doggylover314/monsoonready-drone/runs/detect/runs/spotcheck/water.v2i.yolov8_image117_jpg.rf.64779a35312663e71e96f10df5c92397.jpg

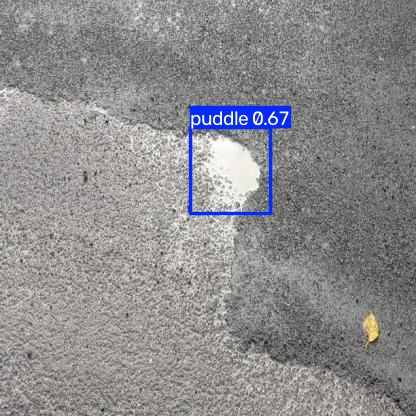
runs/detect/runs/spotcheck/water.v2i.yolov8_image117_jpg.rf.64779a35312663e71e96f10df5c92397.jpg
