doggylover314/monsoonready-drone/runs/detect/runs/spotcheck/puddle detection.v32-640pure.yolov8_image1419_jpeg.rf.d2c9cac2d5b5cb9a628b9e14989213a8.jpg

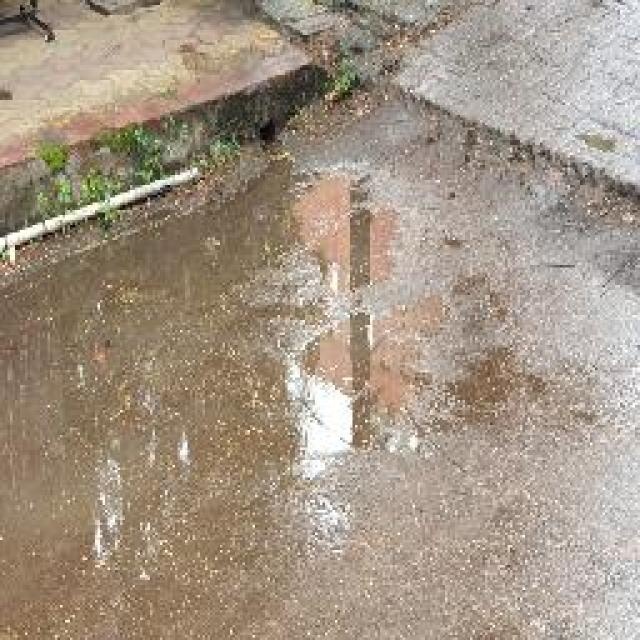
runs/detect/runs/spotcheck/puddle detection.v32-640pure.yolov8_image1419_jpeg.rf.d2c9cac2d5b5cb9a628b9e14989213a8.jpg
