doggylover314/monsoonready-drone/PROJECT_STATE.md

# DEADLINE CORRECTED 2026-08-14 (user): SATURDAY 2026-08-15 IS THE SHOOT DAY, NOT THE UPLOAD DAY. It is the ONLY day with farm access, so all footage must exist by Saturday night; the actual submission upload is ~ONE WEEK LATER (exact date UNVERIFIED - ask user; do not invent). Video constraints unchanged: 5-10 min ONE continuous unedited take, opens with a Google date search on screen, publicly viewable. GOAL for the shoot (user, 2026-08-11) IS THE FULL AUTONOMOUS FLIGHT: survey -> detect -> drop. ATTEMPTS: 2-3 across the day, ONE pack only (user, 2026-08-14), each failure costs a recharge at the farm's marketing-office mains. FALLBACK: piloted flight + ground AI demo, stated honestly on camera. VIDEO_SCRIPT.md (2026-08-14) holds the full shooting script with lines for both variants.

## CONCEPT + FRAMING
Hexacopter surveys; UNO Q onboard ML detects standing water in downward stills; descend over (or beside, see TF-Luna risk) puddle; drop granular Bti (demo=inert salt); on landing UNO Q=base station (heatmap/report). Judged loop detect->descend->treat runs onboard.
Framing: model detects "standing-water candidates", stagnation confirmed by persistence across passes/operator; document honestly. AI-authorship: disclose "AI-assisted; architecture/testing/debug mine"; keep dataset+bench evidence; be able to explain every design decision in Q&A.
REGULATORY: Digital Sky parked (portal blocks self-reg); >2kg AUW=Small category; compliance gap acknowledged deliberately; salt avoids pesticide law; narrative to write (user).

## AIRCRAFT (fixed facts)
F550 hexa X (FRAME_CLASS 2 TYPE 1; SENSOR_ANGLE_OFFSET_DEG 0, corrected 2026-08-06: ring sits BETWEEN the arms, sensor 0 out the nose, NOT arm-mounted). S550 predecessor was 1.85kg, hovered 30% throttle (user: settled, do not re-litigate); F550 lighter. Payload budget ~650g; AI payload ~230-340g.
Pixhawk 2.4.8 = Pixhawk1-bdshot 4.7.0 stable (flashed 2026-07-25). Motors 6x DJI A2212 920KV, DJI-style 1045 props, handed M6 nutcaps (black CW silver CCW). 6x 45A BLHeli_32 (RPM notch impossible on this board: AUX5-6 NODMA; motors stay MAIN PWM; ESCs = quality+passthrough only). 3S 8000mAh XT60. Charger HTRC B6 V2. NEO-M8N+compass mast. FS-i6X/FS-iA10B iBUS. 433MHz SiK. OLED SH1106 (NTF_DISPLAY_TYPE 2, compass I2C, 5V UBEC; splices need soldering; glanceable top-plate mount).
Switches: ch5 arm (RC5_OPTION 153), ch8 kill (RC8_OPTION 31), ch7 3pos Stab/AltHold/Loiter (FLTMODE_CH 7), spare 2pos=RTL (CHANNEL UNCONFIRMED: ask user, then uncomment RC6_OPTION,4 in setup file + push). Simple Mode per-mode checkbox (not restored post-reset; reconfigure if wanted).
Parts: ALL arrived. Frame assembly in progress.

## POWER MAP
RESOLVED 2026-08-02 (user checked the bench): TWO buck modules exist, identical fixed-5V units differing only in output port (one USB-C, one USB-A); NEITHER is adjustable, so every "XY-3606 set to 5.00V" instruction in this file is VOID (that adjustable module does not exist; the name lives on below only as why-history). Rail assignment now: USB-C module -> ETZIN splitter charging port -> UNO Q (this is the unit that metered 5.20V loaded, acceptance PASSED); USB-A module -> MG90 servo + ESP32 (tap via cut USB-A cable or solder pads). Two-rail rationale unchanged (servo stall must not brown out the companion). VERIFY before first connect: USB-A module's LOADED output voltage by meter, and its CURRENT RATING from listing/markings (servo stall + ESP32 + mux + 7x VL53L0X share it; rating currently UNKNOWN). PIXHAWK WIRE CHECKLIST given to user 2026-08-02 (per SERIAL MAP + standard Pixhawk-1-class ports, silkscreen-VERIFY flagged): POWER=power module; TELEM1=SiK; TELEM2=ESP32 (TX2->GPIO16, RX2<-GPIO17, GND; no 5V); GPS=puck; I2C=compass + OLED -> I2C SPLITTER NEEDED if both (new part, was not in any plan; VERIFY OLED bus compat); SERIAL4/5 split cable per SERIAL MAP (pins 4/5 provisional on TODO 7); RCIN=receiver; MAIN1-6=ESCs; AUX1=MG90 signal+GND w/ red from USB-A buck; BUZZER + SWITCH (VERIFY switch not integrated in puck); CAN/SPI/ADC/SB unused.
Power module (new) -> Pixhawk (calibrate V/I vs multimeter on install; UBEC bench V readings w/o sense pins = floating artifacts). UNO Q FLIGHT FEED SUPERSEDED 2026-07-29 (splitter gate pass, see AWAITING USER (b)): UBEC 5V -> ETZIN EPL-1207CC charging port -> UNO Q USB-C as sink (supported path, camera on splitter A-port); 5V-pin and VIN feeds BOTH DROPPED from flight design. Old plan kept below for the why-history only: UBEC 5V/5A -> UNO Q 5V pin (NOT VIN, verified 2026-07-27: VIN 7-24V exists BUT board disables USB VBUS out when VIN-powered (protective Schottky design, Arduino staff: unsupported scenario) = B525 on USB-C gets no power; 5V-pin feed keeps USB host power alive; also isolates from motor-bus sag/noise. GPIO 3.3V; USB-C free for camera) + OLED. XY-3606 (set 5.00V with meter BEFORE connecting) -> MG90 servo + ESP32 (ESP32 3V3 reg feeds mux + 7x VL53L0X). SERVO = MG90 metal-gear (user 2026-08-01, replaces SG90: metal gears + better repeatability on a gate that must not strip; VERIFY on arrival = exact variant (MG90S is the common metal-gear part, MG90D exists), MASS (metal-gear ~13g vs SG90 ~9g, both approximate, WEIGH it, payload budget ~650g) and STALL CURRENT vs the XY-3606 rating (metal-gear draws more than SG90; no verified datasheet figure, MEASURE on the bench flow test TODO 3)). SERVO SIGNAL = PIXHAWK AUX OUTPUT PIN (default ch9/AUX1, CHANNEL UNCONFIRMED), **NOT** UNO Q GPIO. RE-EXAMINED 2026-08-01 (user asked for the signal to come from the Arduino instead; ANSWER = the "valid reason" clause in his own instruction applies, four load-bearing reasons, all still true): (1) Linux userspace soft-PWM is jittery (not an RTOS) so the Linux side is out on its own; (2) that leaves the UNO Q STM32, but the stock Arduino Servo lib has NO Zephyr support (verified 2026-07-31) so it needs a board-specific PWM impl written from scratch; (3) reaching that impl needs the Linux->STM32 Bridge = TODO 12 = BLOCKED and not resolvable without bench time; (4) the Pixhawk already has hardware PWM idle on AUX, powered, wired, talking MAVLink to us, motors on MAIN1-6 so AUX free, and AUX5-6 NODMA blocks only bidir-DShot not plain PWM. Net: Arduino route = 2 unwritten firmwares + 1 open hw question, Pixhawk route = 0 new code, 14 days to deadline. ALSO signal level: **"Pixhawk servo rail is 5V logic" is RETRACTED as UNVERIFIED (2026-08-06, user asked directly whether MAIN/AUX signal pins are 3.3V or 5V and I could not confirm it; it was an assistant memory claim, exactly what truth rule 9 forbids as a wiring basis).** What is actually true: the PWM outputs originate at 3.3V MCU pins (MAIN from the IO co-processor, AUX from the FMU), and whether they reach the connector at 3.3V or 5V depends on whether this board buffers/level-shifts them and what supplies those buffers, which has NOT been checked against the schematic or a scope for THIS board. CONSEQUENCE WORTH TESTING EARLY: if the outputs are buffered from VDD_SERVO and this build never powers the Pixhawk's servo rail (servo power comes from the USB-A buck, by design), the AUX signal could be weak or absent entirely; the cheap empirical test is the existing `wiring_check.py --wiggle` with the servo connected and grounds common, watching whether the gate moves. If it does not move, escalate to a scope on the pin before adding a level shifter or powering the rail. NOTE ON THE DECISION THIS CLAIM SUPPORTED: even if AUX turns out to be 3.3V, the servo-source verdict does NOT flip, because the load-bearing reasons were the two missing firmwares (Zephyr PWM impl + the blocked Bridge), not the logic level. UNO Q GPIO is 3.3V and NO consulted datasheet states an MG90 input-high threshold (user's "3.3V should not be an issue" reasoning was about POWER, which was never the objection; the objection is LOGIC LEVEL + firmware). If ever revisited: VERIFY the threshold on a scope, do not assume. Servo POWER = XY-3606 always, on both routes (a stalled servo still cannot brown out the companion). Old UNO Q GPIO note (marginal 3.3V logic, salvage cap if it misbehaved) is DEAD, do not reinstate. Common grounds. XT60 ~60A continuous (full-punch bursts may touch it; known).
VERIFY-BEFORE-WIRING (2026-07-27 sweep under CLAUDE.md truth rules 8+9; each = memory-based claim, damage-if-wrong; check datasheet/meter BEFORE connecting): (1) UBEC output: many hobby UBECs are 5V/6V jumper-selectable; 6V into UNO Q 5V pin may kill the board. Confirm jumper position + meter the output UNDER LOAD before first connect. UPDATE 2026-07-27: user metered 5.3V (no trim pot; presumed UNLOADED = floating-artifact suspect). Spec VERIFIED same docs page: 5V-pin window 4.5-5.5V max-not-exceeded -> 5.3V in-spec for the BOARD but only 0.2V ripple headroom, and same 5V_SYS bus back-drives camera VBUS (USB nominal max 5.25V, camera margin flagged not cleared). RULING: re-meter AT THE 5V PIN under real load (UNO Q + camera); <=~5.2V loaded = wire as planned; if it holds 5.3V, optional margin fix = 2nd adjustable buck (XY-3606-class) set to 5.00V by meter replacing the fixed UBEC feed. WIRING RULE (2026-07-27): UNO Q 5V feed must NOT be a dupont jumper (~1A class, I2R drop at 3A peaks -> droop -> reset; docs warn droop=resets and docs' >=3A = peak budget incl camera VBUS, not continuous draw). UBEC has NO output leads (user 2026-07-27; earlier "keep its own lead gauge" advice was an assistant form-factor assumption, retracted): user supplies ~18-20 AWG stranded, short run, soldered both ends (NOT servo-lead offcuts, 22AWG or thinner), MULTIPLE GND returns (per docs), and bench-measure actual loaded current (continuous draw unverified, expected well under 3A). Acceptance test stays: loaded voltage AT the 5V pin. UBEC output = SCREW TERMINALS (user 2026-07-27). Header-end ruling: NO bare stranded wire into female headers (poor contact geometry, stray-strand shorts to adjacent pins, vibration walk-out on THE critical rail). Preferred = Uno-R3 screw-terminal shield (UNO Q is R3 form factor; Robu.in/Amazon.in std part; VERIFY listing breaks out 5V/GND) -> both ends screwed. Fallback = wire soldered/crimped to male pin strip (2-3 pins grip better), hot-glue + zip-tie strain relief, 2x GND pins. Underside header-tail soldering only if board actually exposes tails (LOOK first, not asserted). (2) XY-3606: 5.00V setting (already ruled) AND output polarity metered before servo/ESP32 connect. (3) OLED SH1106 module: confirm the specific module's VCC range accepts 5V and its I2C lines are compatible with the Pixhawk 3.3V bus (module-dependent; check markings/listing). (4) TF-Luna: pinout per batch (already ruled), confirm 5V supply + 3.3V UART logic from the Benewake manual of THIS unit; pin5 float=UART. (5) ESP32 dev board 3V3 regulator: confirm headroom for TCA9548A + 7x VL53L0X before trusting the ring (measure current or check reg rating). (6) Power module: meter its 5V-ish FC output before first Pixhawk connect. (7) UNO Q 5V-pin feed: VERIFIED 2026-07-27 (docs: cover 5V load with 3A margin, short leads; VIN rejected because VIN power disables USB VBUS out = dead camera).

## PLATE LAYOUT (PROPOSED 2026-07-27, not yet built; VERIFY items = measure on frame, do not trust memory specs)
BELOW bottom plate (needs downward view / drop path): B525 nadir (offset so drop stream never crosses lens FOV); TF-Luna beside it clear nadir; hopper+MG90 at CG (payload mass stays centered as salt empties), outlet clear of camera. VERIFY leg ground clearance vs tallest underslung item incl squashed-landing margin.
BOTTOM plate / between plates (protected bay, monsoon): ESCs soldered to PDB pads + zip-tied arms (settled); UNO Q central (wiring hub: USB camera via hub, D0/D1 split cable, UBEC 5V; servo signal NO LONGER from UNO Q, see POWER MAP); ESP32+TCA9548A; 6x VL53L0X ring at plate edge 60deg (VERIFY 25deg FOV clears legs/props powered-on; decides ring height); UBEC+XY-3606 away from baro/FC; RX+SiK antennas clear of carbon/power; power module inline at battery lead.
TOP plate: Pixhawk on foam at center/CG arrow fwd baro covered (settled); GPS+compass mast far end from power wiring/ESCs; OLED glanceable (settled); buzzer outward; 7th VL53L0X up-facing at a corner (or bay edge w/ sky view, VERIFY).
BATTERY = open CG decision, decide by TAPE MEASURE (heaviest item): (a) central cavity between plates if 8000mAh pack fits = best CG/protected (then UNO Q/ESP32 move outward), else (b) strapped centered on top plate, Pixhawk shifts slightly (stays foam, near center). Plate gap NOT known from memory; measure.

## SERIAL MAP (final; 4/5 SWAPPED at build 2026-07-27: user wired Luna to the #4 lines, params updated to match instead of re-soldering; upside = SERIAL5 boot noise now hits junk-tolerant pymavlink not the Luna)
REVISED 2026-08-02 (user wired TELEM1<->TELEM2 opposite to plan; params follow the wires, same rule as the 4/5 swap): SERIAL1(TELEM1)=ESP32 MAVLink2 115200. SERIAL2(TELEM2)=SiK 57600. SERIAL3=GPS. SERIAL4=TF-Luna serial rangefinder 115200. SERIAL5=UNO Q MAVLink2 115200 (pending TODO 7). pixhawk_full_setup.param updated 2026-08-02 (SERIAL1/2 swap + SERVO14_FUNCTION=0/MIN 800/MAX 2200 for the dropper on AUX6=ch14, user-assigned provisional, servo not yet arrived); esp32 config.h comments fixed to TELEM1 (pins unchanged GPIO16/17). NOTHING PUSHED YET: push_params.py when Pixhawk next on USB, then tools/wiring_check.py (NEW 2026-08-02: USB bench listen, PASS/FAIL per subsystem FC/GPS/compass/Luna/ESP32/RC + optional --wiggle 14 servo cycle; SiK/buzzer/switch/motors explicitly not USB-checkable, see its docstring). I2C: user spliced compass + OLED dupont leads manually, NO splitter part needed (his prior build note, reconfirmed 2026-08-02). PARAMS PUSHED + VERIFIED 2026-08-02 (user-run push_params.py): 60 ok / 0 refused / 0 no-echo, incl the SERIAL1/2 swap and SERVO14_FUNCTION/MIN/MAX. WIRING CHECK 2026-08-02 (user-run tools/wiring_check.py, Pixhawk USB + battery): FC PASS 25hb; GPS PASS 100 msgs (fix 1, 0 sats = indoors, wiring is what was proven); COMPASS PASS enabled+healthy (so the manual I2C splice CONDUCTS, SDA/SCL both good); TF-LUNA PASS 100 msgs reading 0.14m on the bench (consistent w/ RNGFND1_GNDCLR 0.13); ESP32 PASS 24-25 comp195 heartbeats + ~228 OBSTACLE_DISTANCE in REAL mode = ring sensors alive and transmitting; RC FAILED on run 1 then PASSED on run 2 (transmitter was off first time = the check working as intended, not a fault). NEW FINDING (open): upward DISTANCE_SENSOR count = 0 across both runs while the ring streams fine -> the 7th up-facing VL53L0X (mux ch6, orientation 24) is NOT transmitting; either not yet wired/mounted (assembly is mid-build) or its init failed while the ring's succeeded. Re-check after the ring is finished; if still 0 with the sensor physically present, debug ch6 on the mux (ESP32 serial monitor prints per-sensor init).
OLED DARK 2026-08-02, NARROWED (Pixhawk on USB + battery, ESP32 REAL mode): NTF_DISPLAY_TYPE read back from the board = 2.0 (confirmed present, cause 2 ELIMINATED) and COMPASS PASS on the same spliced bus (cause 5 ELIMINATED, the bus and splice work). Remaining, ranked: (1) OLED has no VCC/GND (splice was "compass wires + 2 dupont female wires" = SDA/SCL only; an SH1106 has no backlight so unpowered looks identical to misconfigured; METER its VCC pin); (2) NOT REBOOTED since the push (ArduPilot initialises the display driver at BOOT only, so a freshly-set NTF_DISPLAY_TYPE does nothing until a power cycle) - free to rule out, do it first; (3) controller mismatch SH1106(2) vs SSD1306(1), externally identical modules -> try 1, reboot, look; (4) module address 0x3C vs 0x3D (whether ArduPilot probes both is UNVERIFIED, do not assert; some modules have a solder-jumper to change it); (5) dead module. DEFINITIVE TEST if 1-4 fail: I2C scanner sketch on a spare MCU to see whether the module answers at all and at which address. UPDATE same day, causes 1-3 ALSO ELIMINATED: user metered the module VCC at 5.25V (powered), rebooted (driver init happens at boot, so that path is exercised), and tried NTF_DISPLAY_TYPE=1 with another reboot (both controller types now ruled out). User states the screen WORKED EARLIER with this exact hardware, so this is a REGRESSION, and the question becomes what changed since. Candidates, none verified: (a) FIRMWARE 4.6.3 -> 4.7.0 upgrade on 2026-07-25 plus the factory reset - if the 4.7 build for this board is feature-trimmed (1MB-class boards get --enable-minimize-features) the display driver may simply not be compiled in while NTF_DISPLAY_TYPE remains settable; I CANNOT VERIFY from memory whether 4.7's Pixhawk1 build includes it, check the boot banner/ArduPilot source before believing it; (b) the module's GND leg: a metered 5.25V on VCC proves supply presence, NOT a return path, and a broken GND on the OLED stub leaves the compass (its own GND intact) working - continuity-test OLED GND to Pixhawk GND; (c) the OLED stub's SDA/SCL solder joints specifically (compass PASS only proves the bus reaches the COMPASS, both hang off the same splice); (d) module died. **SOLVED 2026-08-02: cause (b), a LOOSE GND WIRE on the OLED stub.** User replaced the wire and set NTF_DISPLAY_TYPE back to 2 (SH1106 confirmed correct, so the temporary 1 was a red herring): screen works perfectly. Firmware feature-trim theory (a) was WRONG and is now dead, do not repeat it. LESSON worth keeping: a metered VCC proves supply only; on a shared-splice bus a device-specific GND break is invisible to every software check and to the other devices on the same bus (the compass stayed healthy throughout). Continuity-test BOTH legs per device next time a spliced I2C device is silent. NOTE: the board's NTF_DISPLAY_TYPE is back to 2 and matches pixhawk_full_setup.param, no re-push needed.
BATTERY MONITOR CALIBRATION GUIDANCE (2026-08-02, asked by user; NOTHING MEASURED YET): BATT_VOLT_MULT is trivial (meter the pack at rest, type the reading into QGC's Power setup, it computes the multiplier). BATT_AMP_PERVLT needs a KNOWN current, and the load choice is the whole question. Rules recorded: (a) METER TYPE - a handheld multimeter's 10A range is FUSED and flight currents are 20-60A, so inline is out; the safe instrument is a DC-capable CLAMP meter (Hall effect) around the battery positive lead. An AC-only clamp reads nothing on DC. (b) LOAD - do NOT use props for this; options are a resistive dummy load (car headlight bulbs, ~4.5A each at 12V 55W, parallel to reach a flight-like 15-20A) or motors WITHOUT props (only a few amps, and a calibration taken at 2A extrapolates badly to 20A, offset error dominates). Calibrate near HOVER current, not at idle. (c) Two points (low + high) beat one, because they separate slope from BATT_AMP_OFFSET. (d) GOLD STANDARD CROSS-CHECK, needs no ammeter at all: fly/hover a pack down, compare ArduPilot's logged consumed mAh against what the charger puts back in, scale BATT_AMP_PERVLT by that ratio. (e) F550 hover current is UNMEASURED in this project, so "15-20A" above is an expectation, not a fact. TODO for the user: RECORD THE POWER MODULE'S MODEL/RATING (nowhere in this file); its datasheet A/V figure is the correct starting value before any of the above refines it. (f) USER ASKED FOR "2 PINS" TO CLIP AN AMMETER TO: NO SUCH PIN PAIR EXISTS and none can be added - an ammeter must CARRY the current, i.e. sit in series in the main pack lead. The Pixhawk's 6-pin power connector carries only the FC's own ~0.5A, so measuring there answers a different question. Valid options: DC CLAMP around the pack positive (no disconnection, no extra parts, the only route that fits "use what I have"), or a two-lead meter inserted in pack positive between battery and power module - which with XT60s needs a temporary pigtail because unmating the connector breaks BOTH conductors. Hard safety notes: never put a meter in current mode across the pack (zero-ohm short on a LiPo), and check the meter's fuse rating first (a hexa passes tens of amps at modest throttle; F550 hover current still UNMEASURED here).
BENCH ACCEPTANCE TEST PLAN (2026-08-02, user-run; tools/wiring_check.py extended for it): the script now reports UP-SENSOR as its own PASS/FAIL line (was folded into the ESP32 line), --wiggle takes a bare flag defaulting to ch9, and NEW --motor-test spins each of the 6 motors in ArduPilot test order at 8% for 2s with a typed "spin" confirmation (PROPS OFF; proves ESC signal wiring + motor order + direction, all three verified BY EYE, software only commands the spin; motor 1 = front-right then clockwise, wrong order = swapped signal lead, wrong direction = swap two PHASE wires never the signal leads). Coverage note kept honest in the docstring: SiK, buzzer, safety switch, OLED and the UNO Q link are NOT provable over USB and each has its own separate check.
TWO REAL BUGS IN wiring_check.py FOUND + FIXED 2026-08-02 (both caused the "no ack" storm the user hit; source-verified in the venv's pymavlink, not guessed): (A) TARGETING. mavutil.wait_heartbeat() returns the FIRST heartbeat of any kind, and this bus has two senders (FC sys1 comp1, ESP32 sys1 comp195). pymavlink only locks its sysid onto a heartbeat that passes probably_vehicle_heartbeat(), which REJECTS the ESP32 twice over (MAV_TYPE_ONBOARD_CONTROLLER is in its excluded-type list AND MAV_AUTOPILOT_INVALID is in its excluded-autopilot list, mavutil.py:359-370). So when the ESP32's heartbeat arrived first, wait_heartbeat returned it while target_system stayed 0 = BROADCAST (target_component defaults to 0 too, mavutil.py:182/223) -> commands went to nobody in particular and acks did not come back. THE BANNER PRINTED THE EVIDENCE ALL ALONG: runs saying "heartbeat from system 0" are the broken ones, "system 1" the good ones. Fix = wait_autopilot(), which keeps reading until autopilot!=INVALID and component==AUTOPILOT1, then pins target explicitly (the filter mavlink_io.py already had). (B) ACK MATCHING: acks were matched by type only, with no drain of the 4Hz stream backlog, so an ack could be missed behind stale telemetry or confused with the ack of this script's own stream requests. Fix = send_and_ack() drains first, matches on ack.command, 5s timeout.
MOTOR TEST NEEDS LIVE RC (empirical, 2026-08-02): identical commands at the same 8% throttle did NOTHING with the transmitter off and SPUN THE MOTORS with it on, reproduced across three runs. The user's hypothesis that 8% was too low is DISPROVEN BY HIS OWN DATA (the run that spun used the same 8%). The exact firmware gate has not been read in ArduPilot source, so this is recorded as observed behaviour, not as a quoted rule. wiring_check.py now refuses to run the motor test without live RC, so a TX-off run can never masquerade as dead ESCs.
RUNNING THE TOOLS OVER THE SiK RADIO (user asked 2026-08-06; aircraft on battery, ground radio on the PC): SUPPORTED, use --conn /dev/ttyUSB0 --baud 57600 (that is the radio's PC-side rate and has NOTHING to do with the aircraft's SERIAL2_BAUD; ls /dev/ttyUSB* to confirm the device). Changes made for it: push_params.py gained an optional 2nd positional arg for baud (was hard-coded 115200, so it could never have worked over the radio); wiring_check.py halves its stream request to 2Hz on any link <=57600 (4Hz of MAV_DATA_STREAM_ALL does not fit through a SiK air link and the dropped msgs would print as spurious FAILs), and now counts RADIO_STATUS/RADIO for rssi figures. SiK DETECTION BUG FIXED SAME DAY (user: "why does SiK say untested? This was over the radio"): keying the verdict on RADIO_STATUS was WRONG, because a SiK only injects those when its MAVLink framing mode is on, so absence proves nothing. Now the verdict keys on the LINK: autopilot telemetry cannot arrive on a non-ttyACM serial port unless it crossed the radio (the Pixhawk's own USB is a ttyACM; the ESP32's USB port carries no autopilot traffic), so a non-ACM --conn that produced heartbeats IS the proof, with rssi added only when RADIO_STATUS happens to be present. Radio link CONFIRMED WORKING 2026-08-06 by that run. Bandwidth note from the same run: the ESP32's 1Hz heartbeat came through only once in 12s while the FC's came 12/12, so the air link is dropping the low-rate traffic under the ring's 10Hz load; not a fault, but a reason to keep the stream request low over radio. So the radio route is the ONLY way to test the SiK link, and USB remains the right route for param pushes (many small round trips, retries cost air time). SPEED (user 2026-08-06, the 25s wait was too slow): --seconds is now a MAXIMUM (default 12) and the listen loop BREAKS as soon as every check is satisfied, so a healthy aircraft finishes in ~2-3s and the full window is only ever spent waiting for something that never arrives. Satisfaction requires >=2 heartbeats from BOTH the FC and the ESP32 (one proves the sender exists, two prove it is still sending) plus GPS msgs, downward+upward rangefinder, ring, SYS_STATUS and live RC. Deliberately does NOT wait for a GPS FIX, which indoors never comes. Consequence today: with UP-SENSOR still silent, runs will use the whole 12s until ch6 is fixed.
UP-SENSOR (ch6) STATUS = UNTESTED SINCE IT WAS CONNECTED (corrected 2026-08-06 after the user challenged me, twice, correctly). What is actually known: every wiring_check run that reported 0 upward DISTANCE_SENSOR msgs was on 2026-08-02, and the user connected the 7th sensor "sometime between the last few tests", so those zeros may simply predate the sensor existing. NO run has been done since. TWO ASSISTANT ERRORS IN A ROW HERE, both from filling a gap instead of asking: (1) claimed the sensor must have been hot-plugged after boot, wrong because the aircraft is unplugged many times a day across a multi-day build; (2) then claimed ch6 "has failed init on every cold boot", which no measurement supports at all. The theory that begin() only probes at boot is still TRUE as code (source-read below) but it explains nothing until there is a fresh measurement. Code facts, source-read not guessed (proximity_sensors.cpp): begin() probes each mux channel ONCE at boot, prints "[sensors] chN: VL53L0X OK" or "chN: VL53L0X init FAILED (check wiring/mux)" per channel, sets _ok[ch]=false on failure, and readAll() then returns SENSOR_MM_ERROR for that channel forever; there is NO retry path. config.h UP_SENSOR_CHANNEL=6, NUM_SENSORS=7. Since ArduPilot demonstrably forwards the ESP32's broadcast OBSTACLE_DISTANCE through to USB/radio, a working ch6 would show up the same way, so 0 upward msgs = no data at the source. FRESH RUN DONE 2026-08-06 over the SiK radio, WITH the sensor connected: UP-SENSOR still 0 (everything else PASS). So the fault is now MEASURED, not inferred. User asked whether "nothing above it" explains 0: NO, and this is source-verified, not reasoned: sendDistanceSensorUp() only returns without transmitting when classifyCm() gives SECTOR_NO_DATA, which happens for exactly two inputs, SENSOR_MM_ERROR (0xFFFF = init failed or read timeout) and a literal 0 mm (VL53L0X signal-fail). An empty ceiling gives mm >= VL53L0X_MAX_VALID_MM -> SECTOR_NO_OBSTACLE -> the message IS sent as max+1 cm. Therefore 0 messages = the READ is failing at the sensor, and the ESP32 boot print ("[sensors] ch6: VL53L0X OK" vs "init FAILED") splits init-failure from persistent-0mm.
ROOT CAUSE MEASURED 2026-08-06 (ESP32 boot log, user-run): **TWO channels fail, not one** -- "[sensors] ch1: VL53L0X init FAILED" and "ch6: VL53L0X init FAILED", each preceded by `Wire.cpp requestFrom(): i2cRead returned Error 263`. 263 = 0x107 = ESP_ERR_TIMEOUT in arduino-esp32, i.e. nothing answered on that mux channel. Every live cycle then prints `s1[90]:ERR` and `UP:ERR` while ch0/2/3/4/5 report sane distances, so the ring has been flying on FIVE sensors with a hole at 90deg (starboard). ASSISTANT BLIND SPOT THIS EXPOSED, now fixed: wiring_check.py called ESP32 PASS purely because OBSTACLE_DISTANCE was arriving, but a dead ring sensor still occupies its slot filled with SECTOR_NO_DATA (65535), so the message streams happily with a hole in it. The check now scores each of the 6 sectors and prints a separate RING line naming any dead sector by bearing; had it done so on 2026-08-02 the dead ch1 would have been caught then. NEXT (user, bench): the two failures are independent channels sharing only the mux, so the top suspect is a loose leg per sensor (exactly the OLED's fault mode), then a dead sensor, then damaged mux pairs, then the POWER MAP's open VERIFY (5) 3V3 headroom for mux + 7 sensors (least likely, since five work). CLEANEST ISOLATION = swap test: move the ch6 sensor's 4-wire bundle onto a known-good channel's pads (e.g. ch2 with its sensor unplugged) and reboot; init OK there = sensor+wires fine, mux channel at fault; still FAILED = that sensor or its wires. Repeat for ch1.
ch6 CAUSE FOUND 2026-08-06 (user): the upward sensor's VIN was never connected to 3V3 (friend's wiring). Same fault family as the OLED's loose GND: a missing power leg, invisible to every software check, on a device whose neighbours all work. THIRD one this week, so the standing bench rule is now: when one device on a shared bus is silent, meter ITS OWN VIN and GND to the source before anything else. ch1 STATUS AFTER THAT FIX = UNKNOWN, not fixed and not broken: the user reports checking VIN/GND on the other sensors, which is not the same as a fresh boot log showing "ch1: VL53L0X OK". Do not record ch1 as healthy until a boot log or a RING 6/6 line says so.
"CAN I POWER THE UP SENSOR FROM THE PIXHAWK INSTEAD OF OPENING THE DRONE?" (user 2026-08-06). ANSWER = NOT VERIFIED SAFE, do not do it without checking two things first, and the default remains the ESP32 3V3/GND hub. (a) NO 3.3V SUPPLY PORT IS CONFIRMED on this Pixhawk: its external connectors (I2C, TELEM1/2, GPS, SERIAL4/5) carry 5V, and the "ADC 3.3" connector is an ANALOG INPUT, not a rail; its exact pinout is NOT verified here, so it must not be used as a supply on my say-so (truth rule 9). Check the board's official pinout before believing any 3.3V exists. (b) 5V FROM THE I2C PORT IS ONLY AN OPTION IF THE MODULE REGULATES: common VL53L0X carriers (Pololu, Adafruit, GY-530-style) accept ~2.6-5.5V VIN because they carry an onboard regulator, but bare 3.3V-only modules exist and 5V destroys them; identify THIS module before connecting. (c) EVEN IF IT REGULATES, there is a second hazard: a module fed 5V typically references its I2C pull-ups/level-shifters to its own VIN, which would put 5V on that TCA9548A channel while the other six sit at 3.3V. Whether that is safe depends on the mux's own VCC and its per-channel translation limits, which are NOT verified here. (d) GND, CORRECTED 2026-08-06 after the user pushed back and was RIGHT: I wrote that the sensor "cannot talk until its ground is bonded to the mux's", implying a floating-reference problem. There is none. Every buck here is non-isolated, so all GND traces back to battery negative and it is ONE NET; ground for this sensor may be taken wherever is convenient. What actually survives is a RETURN-PATH argument, which is weaker but real: with GND landing at the Pixhawk and SDA/SCL returning to the mux, the 400kHz I2C return current detours sensor -> Pixhawk -> power module -> battery negative -> buck -> mux, sharing conductors with ESC currents, so ground bounce under motor load is the risk (this is why the plan puts a GND rail next to the mux). The sensor does still need SOME ground wire; it currently has none, which alone explains its I2C timeout. RECOMMENDATION: run the two wires to the same 3V3/GND distribution hub the other six use (TODO 13 already specifies that perfboard hub). If the drone must be opened anyway to reach any of this, opening it once and doing it properly beats a mixed-rail workaround that risks the mux.
RING ORIENTATION CORRECTED 2026-08-06 (user, measured on the airframe): the ring is mounted BETWEEN the arms, sensor 0 pointing straight out the NOSE, so bearings are 0/60/120/180/240/300. config.h SENSOR_ANGLE_OFFSET_DEG 30.0f -> 0.0f, plus the ASCII wiring map, the module README (3 places) and this file. NOT COSMETIC: angle_offset is what tells ArduPilot where an obstacle lies, so the old 30 would have reported every obstacle 30deg clockwise of its true bearing and avoidance would have slid the aircraft along the wrong vector. The 30 was written when the mounting was still assumed to be arm-mounted (hexa X arms sit at 30/90/...), which is the mistake to notice: a plausible default outlived the assumption that produced it. REQUIRES A RE-FLASH of the ESP32 to take effect (nothing on the Pixhawk side changes; PRX1_YAW_CORR stays 0 because the message carries the offset). tools/wiring_check.py's SECTOR_BEARING table updated to match, so its "DEAD s1(60deg)" naming stays truthful.
ch6 STILL FAILS AFTER POWERING IT (2026-08-06, two consecutive boot logs): ch1 AND ch6 both "init FAILED" with `Wire.cpp requestFrom(): i2cRead returned Error 263` (0x107 = ESP_ERR_TIMEOUT), ch0/2/3/4/5 OK. So connecting 3V3 was necessary but not sufficient, and the two failures are still unexplained. NEW SUSPECT RAISED BY THE CODE ITSELF: config.h ships I2C_CLOCK_HZ 400000 with the comment "drop to 100000 if bus is flaky" and TCA_SETTLE_US 0 with "raise to ~50 only if you see bus errors" -- we ARE seeing bus errors, and long hand-made 4-wire ring bundles are exactly what makes 400kHz marginal. That is now a first-class hypothesis alongside broken wiring, and it is cheap to test.
DEBUG TOOL WRITTEN 2026-08-06 (user asked for ESP-side debug code): esp32_obstacle_avoidance/i2c_diag.{h,cpp} + `#define RUN_I2C_DIAG` in config.h (0 = fly, 1 = bench report). When 1, setup() runs the report and returns BEFORE the Pixhawk link is opened, so a diagnostic build physically cannot transmit; loop() idles so the output stays readable. What it prints per bus config: mux ACK + control-register READBACK (proves the mux actually switches, else every "sensor fault" is one mux fault), a full 0x08-0x77 device scan per channel (a VL53L0X answers at 0x29), an idle SDA/SCL level check on any channel that scans empty (LOW = short or a device clamping the bus, which the mux confines to that channel and which no retry can fix), then a real driver init plus one range reading. It sweeps four configs, 400kHz/0us (today's settings), 400kHz/50us, 100kHz/50us, 50kHz/200us, and ends in a channel-by-config matrix. Reading rule recorded in the tool's own output: fail everywhere with nothing at 0x29 = power/wire/dead sensor; fail everywhere with a LOW line = short; OK only at slower speeds = signal integrity, so change I2C_CLOCK_HZ/TCA_SETTLE_US and shorten leads; 0x29 present but init fails = marginal comms or XSHUT held low; ALL channels fail = the mux or its supply. DIAG RUN 2026-08-06 (user, two boots) SPLITS THE FAULT IN TWO, and neither is what the sweep was designed to catch: (1) **ch6 = absent from the bus**, "nothing answers" at 0x29 in all four configs of both boots, with idle SDA/SCL HIGH (so no short) and the mux select+readback correct. That is not timing and not the mux: the sensor is not electrically present. Causes left: 3V3/GND not actually reaching THAT sensor's pins (the wire was connected at the hub end, which is not the same test), a broken SDA/SCL leg, XSHUT held low (a VL53L0X in hardware standby does not ACK at all, and would look exactly like this while metering fine for power), or a dead module. (2) **ch1 and ch3 = INTERMITTENT, not speed-dependent**: across the two boots ch1 read OK/OK/OK/fail then OK/fail/OK/OK, and ch3 OK/fail/fail/fail then fail/fail/fail/fail, i.e. the same channel passes and fails at the SAME bus speed on different runs, and slowing the bus does not help. That kills the signal-integrity hypothesis (which would fail fast and pass slow, monotonically) and points at a loose contact or a sagging supply. Supporting evidence: the user reports ch3 "randomly started failing" and confirmed it in normal (RUN_I2C_DIAG 0) operation too, and the count of bad channels has grown over the build (ch1 -> ch1+ch6 -> ch1+ch3+ch6) as more sensors were added to the same 3V3 rail. THE POWER MAP'S OPEN VERIFY (5) IS NOW THE PRIME SUSPECT: nobody has ever measured whether the ESP32 dev board's 3V3 regulator carries the mux + 7 VL53L0X, nor what the hand-made hub wiring drops under load. MEASURE 3V3 AT A FAILING SENSOR'S OWN PINS WHILE IT RUNS, not at the hub. Sensor readings themselves are healthy where they work (8190/8191 = "no target", ch5 gave 457mm), so the working channels are genuinely fine. DIAG EXTENDED same day: a REPEAT TEST now runs 20 tries per channel at the configured settings and prints answers/init/read counts, because a single sample per config cannot describe an intermittent fault; 0/20 answers = not on the bus, 20/20 answers with init below 20/20 = intermittent contact or supply. DIAGNOSIS CHANGED 2026-08-06 (third diag run + repeat test): the fault is SYSTEMIC BUS INSTABILITY, not per-sensor wiring. Evidence: (a) WHICH channels fail now MOVES between runs and even between passes of the SAME boot -- ch6 (the one we spent a day on) initialised fine and returned 8191mm this run, while ch1/ch2/ch3 failed in varying combinations; earlier boots had ch1+ch6 failing consistently; (b) the repeat test's signatures are diagnostic in themselves: ch3 answered 20/20 but initialised 0/20, i.e. the ONE-BYTE address probe succeeds every single time while the LONG multi-register init sequence fails every single time, which is what marginal signal integrity looks like and NOT what a loose wire looks like (a loose wire would drop the probe too); ch1 answered only 8/20; ch2 failed 1/20; (c) slowing to 50kHz with a 200us settle does not reliably fix any of it, so it is not simple clock speed. USER'S METER READING DOES NOT CLEAR THE SUPPLY: "every sensor's VIN and GND read a stable 3.3V" was taken with a DMM, which averages and cannot see a 1ms sag or a noise burst; only a scope can, so the rail is still a live suspect (POWER MAP VERIFY (5) remains open). LIKELY CAUSES, in order: aggregate bus loading and crosstalk on seven long hand-made dupont runs (rise-time degradation, SDA/SCL coupling with no adjacent ground return), missing decoupling (the POWER MAP's "optional 10-100uF across rails" is no longer optional, and each sensor wants a 100nF close to its own VIN/GND), then transient supply sag, then a genuinely marginal individual module. DECISIVE NEXT TEST (cheap, do this before buying or resoldering anything): BISECT BY LOAD. Disconnect all but two sensors, run the diag, and add one back at a time. If two are rock solid and reliability degrades as sensors are added, it is aggregate loading/supply and the fix is decoupling plus shorter/paired wiring; if a specific channel misbehaves regardless of how few are connected, that one module or its leads are at fault. RING REDUCED TO 3 SENSORS 2026-08-06 (user removed the three REAR-facing ones, ch2/ch3/ch4 = bearings 120/180/240; fitted now = ch0 at 0deg, ch1 at 60deg, ch5 at 300deg, plus ch6 up). This doubles as the bisect-by-load test. Firmware updated: config.h gains RING_SENSOR_FITTED[] + UP_SENSOR_FITTED, proximity_sensors.begin() skips unfitted channels entirely (each absent channel otherwise burns ~1.2s of boot on an I2C timeout AND logs a "FAILED" that camouflages the real failures), the banner lists the fitted bearings and says the rest are unknown, and the live line prints "----" for unfitted vs "ERR" for broken. WIRE BEHAVIOUR DELIBERATELY UNCHANGED and this is the safety-critical part: an unfitted channel yields SENSOR_MM_ERROR -> classifyCm -> SECTOR_NO_DATA -> transmitted as 65535 = UNKNOWN. ArduPilot treats unknown as NO INFORMATION, never as clear, so avoidance simply has no opinion about the rear. NEVER "fix" the gap by sending max range: that would assert the rear is proven clear and is exactly how an avoidance system flies backwards into something. Consequence to remember at flight time: with the rear unmonitored, rearward motion has no sensor protection at all and the pilot is the only backstop. **RING PARKED 2026-08-06 (user's call, correct one).** Final state of the evidence: with only 3 ring sensors + up fitted, ch1 and ch6 still failed init, and the two that DID init report CLEAR even with a finger directly in front of them, with occasional random values. A finger at <5cm must clamp to RANGE_MIN_CM and print 5cm; printing CLEAR means the sensor is returning >=VL53L0X_MAX_VALID_MM, i.e. it is not really ranging even though init succeeded. So reducing the load did NOT stabilise anything, which kills the aggregate-loading hypothesis too, and the failure has now progressed from "some channels" to "the surviving channels do not measure". Something systemic degraded across this build (candidates never separated: the mux itself, the shared 3V3 rail under transient load, cumulative handling damage to modules, or a marginal ESP32 supply). NOT SOLVED, and deliberately abandoned rather than solved: the ring is DESCOPE-LADDER rung (c), the drop mission does not depend on it, and it has consumed several days against the 2026-08-15 deadline. ESP32 to be unplugged; the Pixhawk keeps PRX1_TYPE=2 which makes the ESP32 an ARMING DEPENDENCY, so **PRX1_TYPE must be set to 0 (+reboot) before arming without the ESP32** (this gotcha is already recorded under PIXHAWK CONFIG and is now live).
CHANNEL MAP NEVER VERIFIED (assistant admission, user asked directly 2026-08-06): the assumed map is ch0=0deg nose, ch1=60, ch2=120, ch3=180, ch4=240, ch5=300, ch6=up, which comes from config.h's SECTOR_FOR_CHANNEL identity map and NOT from any measurement. Nobody has ever waved a hand in front of one physical sensor and checked which sX moved. If the ring is ever revived, that 2-minute test comes FIRST, because every bearing in the OBSTACLE_DISTANCE message depends on it and a scrambled map would make avoidance push the aircraft the wrong way.
PROJECT-LEVEL NOTE: the obstacle ring is a PoC and sits at rung (c) of the DESCOPE LADDER. It has now consumed several days. If the bisect does not resolve it quickly, descoping the ring is the correct call against the 2026-08-15 deadline; the drop mission does not depend on it. **THE CODE IS UNCOMPILED** (no Arduino toolchain on the laptop's PATH; PlatformIO lives in the user's VSCode extension), so the first PlatformIO build is also its first syntax check.
OLD CANDIDATE LIST (kept, still the search space): sensor physically on a mux channel other than 6; a bad leg in its 4-wire bundle (VIN/GND/SDA/SCL); XSHUT held low; dead sensor; damaged ch6 pair on the TCA9548A; or the POWER MAP's open VERIFY (5), the ESP32 3V3 regulator not having headroom for mux + 7 sensors (ring works, so this is the least likely).
BATTERY MONITOR CALIBRATION (started 2026-08-02, user in QGC Power setup): the REPLACEMENT power module's MODEL IS UNRECORDED anywhere in the repo (Build Log only says the original failed in the crash and was replaced), so no preset can be recommended on evidence -> guidance given = choose "Other" unless the module's own label matches a listed preset ("Power Module 90A" is the standard Pixhawk-kit part and a reasonable STARTING point if it is that module), then calibrate voltage from a multimeter reading typed into QGC (it computes BATT_VOLT_MULT). WHY THIS MATTERS: BATT_LOW_VOLT 10.8 / BATT_CRT_VOLT 10.2 are already on the board and drive RTL/Land, so a wrong multiplier makes the failsafe fire early or never. Current (BATT_AMP_PERVLT) needs a known load or clamp meter and is deferred: our failsafes are voltage-based, so uncalibrated current costs mAh-consumed accuracy only. ANALOG PIN PRESET (2026-08-02): QGC's second dropdown sets BATT_VOLT_PIN/BATT_CURR_PIN from a board list; correct entry for this 2.4.8 (Pixhawk1-class, module on the main POWER port) = "Pixhawk/Pixracer/Navio2/Pixhawk2_PM1", which QGC already had selected. NOT Pixhawk2_PM2/CubeOrange/Durandal (different boards) and NOT PX4-v1 (older PX4FMU v1). Acceptance: a charged 3S should read ~11-12.6V; 0V or nonsense means the preset did not take. TODO-small: record the module's model + calibrated VOLT_MULT here once known.
SERIAL4/5 split cable (one 6pin DF13): pin1 5V->TF-Luna only (UNO Q powered by UBEC, never this pin); pin2 TX4->TFLuna RXD; pin3 RX4<-TFLuna TXD; pin4 TX5->UNOQ D0(RX); pin5 RX5<-UNOQ D1(TX); pin6 GND->both. TF-Luna pin5 float=UART (verify pinout per batch); its UART is 3.3V logic.
UNO Q D0/D1 = STM32 USART1 (PB7/PB6, 3.3V). Linux<->STM32 via Bridge RPC; plan = STM32 byte-shovel sketch, pymavlink unchanged on Linux; measure latency in SITL.

## PIXHAWK CONFIG (done state)
All 55 chosen params PUSHED+VERIFIED on board (tools/push_params.py, pymavlink per-write ack). Board exposes 1054 params; full backup pixhawk_every_param.param (regen: tools/pull_params.py, QGC closed). ALL param files live in param_dumps/ (user-created 2026-07-25); tools updated to that path; gitignore: param_dumps/* except pixhawk_full_setup.param (tracked = hand-maintained config; dumps regenerable).
TOOLING RULES: NEVER trust QGC bulk load (silently drops writes; also only reads its own tab format). Writes = push_params.py. Dumps = pull_params.py or QGC save. make_complete_params.py builds QGC-format complete file from a QGC dump (float32-aware).
4.7 renames encountered: ARMING_CHECK->ARMING_SKIPCHK (0=all checks); RTL_ALT->RTL_ALT_M (m); RTL_ALT_FINAL->RTL_ALT_FINAL_M; RNGFND1_GNDCLEAR->RNGFND1_GNDCLR (m, set 0.13 placeholder, MEASURE on airframe).
Notch: first hovers throttle mode (loaded: INS_HNTCH_REF from learned MOT_THST_HOVER, FREQ/BW from log FFT, INS_LOG_BAT_MASK=1 active); then adopt FFT mode (FFT_ENABLE 1, FFT_MINHZ/MAXHZ ~50/200, INS_HNTCH_MODE 4, REF 1; commented block in setup file; HAL_GYROFFT_ENABLED confirmed in build). "Chan 13 to 14 PWM failed no DMA" boot msg = expected, harmless.
Failsafes on board: FS_THR_ENABLE 1 (RTL), BATT low RTL / crit Land, ARMING_SKIPCHK 0. FENCE: deferred by user (commented block ready).
PRX gotcha: PRX1_TYPE=2 makes ESP32 an ARMING DEPENDENCY. Field recovery: PRX1_TYPE=0 + reboot.

## ESP32 OBSTACLE MODULE (esp32_obstacle_avoidance/)
7x VL53L0X via TCA9548A 0x70: ch0-5 ring 60deg (OBSTACLE_DISTANCE angle_offset 0 as of 2026-08-06, was 30), ch6 up (DISTANCE_SENSOR orient 24). 10Hz + heartbeat, sysid1 compid195. GPIO21/22 I2C; GPIO17->PixRX, GPIO16<-PixTX. Compiles clean both modes (MAVLink@2.0.31 okalachev, VL53L0X@1.3.1 pololu; pin versions). NEVER FLASHED yet.
Fake-mode flight guard: USE_FAKE_SENSORS=1 transmits only with GPIO4 jumpered to GND; else TX 0 B + warning. Preflight: banner must say REAL.
Array = reinstated PoC (never call rejected; don't dwell sunlight). Mount check: 25deg FOV must not see legs/props.

## DROPPER: VARIABLE DOSE + REVERSED TRAVEL (2026-08-10, user-directed)
GATE TRAVEL REVERSED AND SHORTENED. Bench observation 2026-08-10: 1000us -> 1900us (900us) swung the horn 90 deg CLOCKWISE, implying ~10us per degree ON THIS SERVO (a calibration ratio, NOT a datasheet figure; MG90 travel per us varies by unit). User wants 60 deg COUNTER-CLOCKWISE instead, so open must sit BELOW closed in pulse width: defaults are now closed_us=1600, open_us=1000 (600us = ~60 deg CCW), both inside the 800-2200 guard. US_PER_DEG=10.0 is exposed as a class constant so the throw is re-derived rather than re-guessed. VERIFY BY EYE on the bench: if the throw is not 60 deg adjust US_PER_DEG; if it turns the wrong way swap the two values. The old 1000/1900 defaults are gone, so anything that relied on them must be re-pushed/re-read.
VARIABLE DOSE IMPLEMENTED. The gate is a FIXED APERTURE, so the only quantity available to vary is TIME OPEN. dropper.trigger(dwell_s=None) now takes a per-drop override on all three dropper classes; mission.dose_for(area) maps estimated puddle area to seconds via MissionConfig dose_s_per_m2=0.4 clamped to [0.3, 3.0], with dose_s_default=1.0 when the area is UNKNOWN (deliberately the default and not the maximum: over-dosing an unmeasurable puddle empties the hopper on one site and strands later ones). Verified at the edges: None->1.00s, 0.1m2->0.30s clamped, 2.5m2->1.00s, 12m2->3.00s clamped.
AREA ESTIMATE ADDED (camera_geom.ground_area_m2), which closes one of the six area-dosing conflicts and leaves the rest open. It projects the box's two CORNERS to the ground and multiplies the sides, rather than scaling pixel area by one factor, because ground_offset is linear in TANGENT space and a box off-centre covers more ground per pixel. THREE ERRORS IT CARRIES, all documented in the docstring and repeated wherever it is shown: a bounding box overestimates non-rectangular water without bound (honest area needs segmentation, a different training run); FOV error enters SQUARED (10% FOV = ~20% area); and height must be true AGL, which above the Luna's range is the EKF above-home figure. **DOSE IS PROPORTIONAL, NOT CALIBRATED IN GRAMS: the granule flow rate (TODO 3 bench test) has still never been measured, so seconds cannot yet be converted to a dose.** Detection gained area_m2 (None when geometry or height is missing), missionlog.drop gained dwell_s and area_m2 (absent in pre-2026-08-10 logs, which the dashboard treats as "not recorded" rather than zero).
DASHBOARD shows it: drop marker RADIUS encodes dose (8px at the 0.3s minimum to 14px at the 3s maximum, old dwell-less drops keep the fixed 8px so they are not rendered as minimum-dose), the table detail line carries dose and area, and the tooltip states the dose plus the bounding-box caveat so nobody reads the area as measured.
**.venv-tools IS COMMITTED TO GIT (1215 files, 74 MB) and needs a decision, NOT a unilateral fix.** It arrived in Raghav's 069634e alongside his four corrections, so it is on both machines via git. A virtualenv must never be tracked: it bloats the repo (.git is already 28 MB), it is machine-specific, and a sed over the repo edits 30 of its files by accident, which is exactly what happened here and was reverted. REMOVED FROM GIT 2026-08-10 on the user's instruction: untracked with `git rm -r --cached` and added to .gitignore. **RAGHAV MUST BE TOLD**: his next pull DELETES .venv-tools from his Mac, so he recreates it as .venv (`python3 -m venv .venv && ./pip install pymavlink pyserial`). When it goes: untrack, add to .gitignore, and he recreates a local .venv (the same one-liner the Mac setup already needs). History will still carry the 74 MB, and that is acceptable because rewriting pushed history is forbidden by this project's own rules.
SINGLE VENV AT .venv (2026-08-10, user: "all python venv stuff in .venv only"). training/.venv was MOVED to .venv (5.5G, same filesystem so instant); the Mac renames .venv-tools to .venv. Every repo path reference updated to ./python and ./pip.
  TWO THINGS THE MOVE BROKE, both fixed, both worth knowing before anyone moves a venv again: (1) **a repo-root SYMLINK cannot activate a venv.** CPython looks for pyvenv.cfg beside the executable AS INVOKED, and there is none beside <repo>/python, so it silently fell back to sys.prefix=/usr and imported nothing from the venv (`import torch` simply said "no module"). ./python and ./pip are therefore one-line WRAPPER scripts that exec the real interpreter, not symlinks. My first "verification" only printed sys.executable and never imported a venv-only package, which is why the breakage shipped. (2) moving a venv leaves EVERY console script's shebang pointing at the OLD absolute path: 52 scripts in .venv/bin (pip, yolo, ultralytics, torchrun, all the mav* tools) were dead until rewritten. `python3 -m venv .venv` over the existing directory refreshes pyvenv.cfg and the activate scripts but does NOT rewrite those shebangs.
  VERIFIED AFTER THE MOVE: torch 2.13.0+cu130 with cuda:True on the RTX 3050, ultralytics 8.4.107, pymavlink 2.4.49, pyserial 3.5, cv2 5.0.0, `pip check` clean, the yolo entry point runs, and all training/tools/uno_q modules compile.

## FIRST FLIGHTS ANALYSED 2026-08-08 (logs 34-38 from the SD card; assistant-run analysis, pymavlink)
**THE LOITER CLIMB WAS NOT AN EKF PHANTOM CLIMB. It was RTL, triggered by BATTERY FAILSAFE.** Log 37 at t=1508.5s: MSG "Battery Failsafe", MODE -> RTL with Rsn=4, then a climb 4.3m -> 12m in 6s. Evidence it was commanded, not corrupted: CTUN.CRt tracked CTUN.DCRt within 0.1 m/s the whole way (+2.2 vs +2.2), DAlt rose with Alt, and EKF Alt vs baro BAlt agreed within 0.5m throughout. A vibration-driven phantom climb looks the opposite: EKF alt diverging from baro with climb rate NOT matching demand. Pilot took Stabilize at 1514.5s and landed. RTL_ALT_M is 15, which is where it was heading. So "it goes up like it usually does" = the aircraft doing exactly what it was configured to do on a low battery.
**VIBRATION PASSES ON THIS FLIGHT**: log 37 IMU0 VibeZ median 7.5, max 37.2, clip delta +16 over the flight. Gate is <15, so THE historic blocker is clear on this airframe/flight. Only IMU0 logs VIBE on this board (no IMU1/2 instances present), so the audit's IMU-pooling bug does not bite here, though the Clip0/1/2 bug did hide the +16 clipping.
**THE REAL PROBLEM IS POWER.** Hover current ~105 A sustained, pack sagging 11.66V -> 10.72V under load, RemPct 35% -> 12% in about 70 seconds. BATT_LOW_VOLT is 10.8, so the failsafe fired on sag. UNRESOLVED AND LOAD-BEARING: is that 105 A real? Learned hover throttle is only ThH 0.383, which does NOT look like an aircraft straining, so a mis-scaled BATT_AMP_PERVLT is a strong suspect (user calibrated the battery monitor on 2026-08-08 but it is not recorded whether the CURRENT half was done against a meter). If the current IS real the aircraft is drawing ~1.1 kW in hover and endurance is a couple of minutes; if it is not, the failsafe threshold is being hit on genuine voltage sag anyway. Either way mission flights are blocked until this is understood. Cross-check: 0.9V sag over ~70A implies ~13 milliohm pack resistance, which is plausible for 3S 8000, so the sag itself looks real.
**2026-08-10 THEORETICAL CURRENT, AND WHY 105 A CANNOT BE TRUE.** User supplied the missing models: power module = APM/3DR-style "Power Module 90A, 3A BEC, XT60, 28V" (robu.in); ESCs = 6x EMAX Formula 45A BLHeli_32; props 1045; motors DJI A2212 per Build Log (KV NOT stated anywhere, still unknown); AUW estimated 2.5 kg (all-up weight = total flying weight, unmeasured, TODO weigh it). Momentum theory, 6x10in props = 0.304 m2 disc, T=24.5 N, ideal induced power 141 W; divided by figure of merit 0.5-0.7 and motor+ESC efficiency 0.75-0.85 gives **22-34 A at 10.9 V, i.e. 4-6 A per motor**. Those two efficiency constants are TYPICAL VALUES, NOT MEASURED for this build, so treat the range as an order-of-magnitude check, not a precise prediction. Inverting the logged figure: 105 A = 1144 W electrical, which on this disc area would hover ~6.2 kg. **THE DECISIVE ARGUMENT NEEDS NO WEIGHT AT ALL**: ArduPilot computes amps as (pin_volts - BATT_AMP_OFFSET) * BATT_AMP_PERVLT, the Pixhawk analog input saturates at 3.3 V, and the board has BATT_AMP_PERVLT=17 / BATT_AMP_OFFSET=0, so the LARGEST current it can report is 3.3*17 = 56 A. The log holds 105 A sustained and a 167 A peak. Both are ARITHMETICALLY UNREACHABLE at that setting, so either PERVLT differed during log 37 or the sensing path is not what is assumed; either way the amps in log 37 are not physical and consumed mAh / burn rate / the 1990 mAh-min endurance figure are ALL UNUSABLE. check_log.py now captures BATT_AMP_PERVLT/OFFSET/VOLT_MULT/CURR_PIN/CAPACITY/MONITOR from the log's own PARM records (board state is not evidence about an old flight) and prints this saturation ceiling, flagging any peak above it as IMPOSSIBLE. RESOLVED SAME DAY by that very check: **log 37 flew with BATT_AMP_PERVLT=90.6866** (not the 17 now on the board), which allows up to 299 A before saturation, so 105/167 A were readable after all and the "arithmetically impossible" claim above was wrong - it was computed from the BOARD's present setting instead of the log's, exactly the mistake the new PARM capture exists to prevent. 90.6866 is almost certainly the module's "90 A" RATING typed into QGC's amps-per-volt field, a classic and easy slip. IF the true constant is the documented 17.0 for this APM/3DR-style module (NOT VERIFIED for a Robu clone), everything rescales by 5.33x: hover 20 A, peak 31 A, consumed 1317 mAh, burn 373 mAh/min, **~21 min hover on a full 8000 mAh pack, ~17 min to a 20% reserve**. That 20 A sits inside the 22-34 A the momentum-theory estimate predicted independently, which is real corroboration, not circular. SAFE TO FLY WITHOUT FIXING IT: BATT_LOW_MAH and BATT_CRT_MAH are both 0 and BATT_FS_VOLTSRC=0, so both failsafes are VOLTAGE-driven and PERVLT cannot affect them; it only scales reported mAh. Deliberately NOT changing PERVLT before the 2026-08-10 evening flight - the charger cross-check recovers the true constant by ratio whatever it is set to, and a param push 10 minutes before takeoff is pure added risk. BATT_VOLT_MULT=10.8025 as flown; voltage is the half that drives the failsafes, so it is the half worth metering.
**2026-08-10 EVENING FLIGHT GOES WITH NO COMPUTER AT ALL** (user: neither the gaming laptop nor Raghav's macbook is coming). Consequences, all load-bearing: (a) wiring_check.py and bench.py CANNOT RUN, so RC/GPS/compass/TF-Luna go unverified at the field - acceptable only because all of them PASSED on the bench earlier today; (b) no ground station means NO audible/visible low-battery callout; (c) **THE OLED WILL NOT COVER FOR THIS.** Build Log lists it under Parts Chosen as a Pixhawk status display, but NOTHING IN THIS REPO DRIVES IT - grep for OLED/SSD1306/SH1106 across all firmware and python hits only a comment in wiring_check.py saying "look at it", and the ESP32 that would have driven it is unplugged and parked. Treat the OLED as an unbuilt feature, not a fallback. So the ONLY field readiness indicators are the Pixhawk's own LED and buzzer: do not arm until the LED is flashing GREEN (flashing blue = no GPS lock). LED meanings are ArduPilot standard but UNVERIFIED against the docs this session - confirm before relying on them. (d) **NEW ENDURANCE MEASUREMENT DEFINITION**: BATT_FS_LOW_ACT=2, so at BATT_LOW_VOLT 10.8 the aircraft SWITCHES ITSELF TO RTL and climbs to RTL_ALT_M 15. With no telemetry that autonomous mode change is the only low-battery signal there is, which makes it the clean stopwatch endpoint: time from takeoff to the aircraft going to RTL on its own. Pilot then takes STABILIZE and lands. This is a better-defined measurement than "when the warning sounds" and needs no instrument.
**2026-08-10 PROP DECISION (user asked carbon-nylon vs ABS):** recommended CARBON/GLASS-REINFORCED NYLON 1045 over ABS, primary reason CONSISTENCY not performance - ABS warps in heat and sun (August, India) and loses balance with age, and an endurance figure plus a vibration baseline are only comparable between flights if the props do not change shape. Secondary: stiffer blades flex less under load and hold balance longer, on an airframe whose historic blocker was vibration (VibeZ 46 -> 20.6 -> 7.5, clipping still +16). HONEST COUNTERPOINT recorded so it is not lost: cheap ABS props sacrifice themselves in a crash and protect the motor shaft/bell, which matters on an airframe with 3 crashes; reinforced props transmit that shock instead and are far more dangerous to people. Buy a MATCHED set of 6 plus spares so any field replacement is identical in weight. **DO NOT FIT THEM BEFORE THE ENDURANCE FLIGHT** - new props change the number being measured and need balancing first. No measured data for this airframe backs the efficiency claim; it is general propeller reasoning, not a test result. RETRACTED same day, said one message earlier and wrong: "105 A would destroy any normal 30 A ESC" - these are 45 A ESCs, 6x45=270 A, so 17.5 A per motor is comfortably inside rating and proves nothing. ALSO SOFTENED: the ~13 milliohm figure above divides a sag that includes genuine DEPLETION over 212 s by a current that is itself suspect, so it is not independent evidence. The charger cross-check (fly one pack from full, compare mAh returned) remains the only decisive test and needs no instrument.
USER CORRECTION 2026-08-08: only log 37 is a PROPER FLIGHT. Everything before it ran with a DAMAGED PROP that went unnoticed for a while, and logs 35/36/38 never left the ground (0 throttled samples). That diagnoses log 34 rather than leaving it a mystery: a bad prop is exactly what produces VibeZ 46 with 5927 clip events, and ArduPilot's own "Potential Thrust Loss (3)" NAMES MOTOR 3, which is worth cross-checking against whichever prop was actually replaced. It also explains the crash-check disarms. Judge log 37 only; treat pre-37 numbers as the bad-prop era, not as airframe characteristics.
**LOG 34 IS THE BAD ONE, KEEP IT** (it is also the docs/07 "failing vibration_log" deliverable): IMU0 VibeZ median 46.0, max 74.4, clip delta +5927, plus MSG "Potential Thrust Loss (3)", "PreArm: AHRS: DCM Roll/Pitch inconsistent 38 deg", "Compasses inconsistent", "EKF3 IMU0 forced reset". Something was badly wrong on that flight; it predates the current build state and has NOT been diagnosed.
**CRASH-CHECK DISARMS in log 37** at t=635, 1282.9, 1522.6s: "Crash: Disarming: AngErr=35..62>30, Accel=0.0<3.0". Near-zero acceleration with large attitude error is the signature of the airframe being handled/tipped while armed on the ground rather than an in-air crash, but it is UNCONFIRMED and worth asking the pilot what was happening at those moments.
ALSO SEEN: repeated "Arm: Throttle too high", "PreArm: Motors Emergency Stopped" (the ch8 kill switch was latched), and "Arm/PreArm: Battery failsafe" blocking re-arm after the pack drained.

## CRASH LESSONS (permanent)
C1 prop nut backed off -> vibration -> alt corrupt -> prop departed (fix: handedness+Loctite). C2 AltHold wind drift into tree. C3 armed seconds post-power-on HDOP 65-99, vibration broke EKF, phantom-fall climb to 47m, pilot disarmed DELIBERATELY (drift to unrecoverable area); procedural, GPS healthy.
Rules: abort=flip Stabilize NOT disarm (disarm only imminent person-strike/unreachable flyaway). GPS modes: 10+ sats, HDOP<1.5, no EKF complaints, wait 2-5min. VibeZ median<15 hover gate before AltHold/Loiter. Insulate bare connectors; smoke stopper on repaired wiring first power-up.
VIBRATION = THE unsolved blocker (was median 20.6, peaks 60+; gate <15). Rebuild countermeasures: good props only, rigid motors, service loops, FC foam near CG, baro covered, GPS cable tied, notch, compass recal.

## ML / TRAINING
Pipeline (training/): merge_datasets.py (single class "puddle"; single-class sets kept whole; multi-class filtered to puddle/water-named; dropped boxes -> negatives; run with .venv python) -> train.py (yolo26n 640 batch8, ckpt/epoch, Ctrl+C pause, auto-resume last.pt; run1 v8n weights kept at runs/puddle_v1/weights/best.pt as fallback) -> export.py (ONNX for UNO Q onnxruntime).
Dataset v1 = 11725 train / 3069 val from: mosquito v1 (5069, puddle class only, CC BY 4.0, CITE BibTeX from its Universe page), puddle_Detect 4.93k, hanyang puddle-detection 1.5k + puddle 1.5k, water 1k, yinjia-part2. mosquito v4 EXCLUDED (no puddle class = poison; in training/excluded/). DATASET V2 QUEUE (researched 2026-07-25, all CC BY 4.0): PRIMARY = user nadir phone photos + drone stills + close-range frame-filling water (targets known failures); PLUS (user downloading 2026-07-25 night) thesis mosquito-breeding-grounds-2 ONLY (universe.roboflow.com/thesis-kjmym/mosquito-breeding-grounds-2, 3.47k, 7 classes incl Temporary Water Sites; CORRECTION: v3/v4/v5 spin-offs are container-only, NO water class = poison, do NOT use; never multiple versions of one pool = train/val leakage) + fumigation habitats (1.06k) + habitats2 (1.29k) (puddle + probable-stagnant-water-waist classes, ground-robot view). SKIP (researched): 82myj (112 tiny), Eds breeding-detection (556 container-heavy), Fumigation vol3/4/5 (no puddle class), all insect close-up sets, aedes/MBG unresearched-but-superseded. Verdict: NO retrain until v2 assembled (retrain ~7h GPU; these sets do not fix sheet-water/glare failures). merge KEEP_NAMES already extended for v2 class names; "pond" deliberately NOT kept (permanent water, not a drop target).
RUN1 (2026-07-25, ~e160/200): P 0.79 R 0.72 mAP50 0.789 mAP50-95 0.474, plateaued (v1 val set, NOT comparable to run2 numbers).
RUN2 COMPLETE 2026-07-28 20:00 (yolo26n, dataset v2 21717/4452, batch16, epochs cap 600): EarlyStopping @e322 (50-epoch plateau), BEST @e272: P 0.801 R 0.705 mAP50 0.766 mAP50-95 0.467 (v2 val). best.pt/last.pt in training/runs/puddle/weights/. VAL_COMPARE 2026-07-28 (user-run, both on v2 val): run1_v8n P .744 R .687 mAP50 .725 mAP50-95 .431 vs run2_26n P .795 R .708 mAP50 .766 mAP50-95 .467 -> RUN2 WINS ALL METRICS w/ fewer params (2.4M vs 3.0M) + 5.2 vs 8.1 GFLOPs; run1's higher v1-era numbers confirmed easier-benchmark artifact (v8n dropped .789->.725 mAP50 on v2 val). run2 best.pt = flight model. NOTE for docs/03: v2 has detect-segment mixed labels (3001 segments vs 3881 boxes on val; ultralytics uses boxes, drops polygons; harmless, disclose in dataset docs). NEXT (user-run): export.py -> scp ONNX to UNO Q -> fps benchmark + spot-check (TODO 1). V2-RETRAIN PLAN: yolo26n (adopted 2026-07-25, supersedes yolo11n pick; v12+ attention models too slow on A53 CPU), batch 16-24 (run1 used only ~1GB of 4GB VRAM), consider 416px export for ~2x UNO Q speedup; n-vs-s decided by ONNX benchmark on board (s runs but est <1fps; mission is stills-while-hovering so ~1s/frame acceptable).
Camera: B525 720p UVC; strip housing, weigh; lock focus v4l2-ctl; route USB away from GPS mast; test sat count cam-on vs off.
TF-Luna-over-water risk: 850nm IR vs still water = dropout/specular; dropout policy = abort UPWARD, never continue. Fallback (user-approved): hover+descend NEXT TO puddle.

## TODO (live; ordered by dependency; REWRITTEN 2026-08-02 at user request: finished items moved to DONE ARCHIVE below with whys intact. Old->new numbers where referenced elsewhere: old 12 -> 7, old 15-19 -> 13-17.)
BENCH (no flight):
1. FOV MEASUREMENT (calibration saga history in archive 9b): coin method at FLIGHT CONFIG (720p MJPG, focus locked 0 = sharpest per 2026-08-02 sweep), coins slid until half-cut by each frame edge, tape read on the floor, bright light. AWAITING user's D + W -> calibrate_fov(D, W) -> record HFOV here + docs/01, pass --hfov-deg on every run_mission invocation. Camera index MOVES between boots (video1 then video2); check v4l2-ctl --list-devices each session; TODO-small: switch detector/worker to the stable /dev/v4l/by-id path.
2. WORKER-SPLIT VERIFICATION (detect_worker.py + FileDetector written 2026-08-01, UNRUN): laptop py_compile uno_q/*.py; re-scp uno_q/ to board (also unblocks archive 10-VERIFY v and dashboard v2/v3 deploy); board smoke test = detect_worker.py --camera <current index> and watch /tmp/monsoonready_det.json seq advance. NO board dry-run possible yet (no Pixhawk tty, see 7; the earlier tcp:127.0.0.1:5760 board suggestion was wrong, nothing listens there).
3. Hopper build + salt flow test; watch bridging/clumping (Bti granules differ; monsoon humidity). Same bench: WEIGH the MG90 (metal gear heavier than SG90, ~650g payload budget), MEASURE its stall current vs the XY-3606/UBEC rating, and granule flow rate g/s (feeds area-dosing option c, variable dwell).
4. ESP32 flash ORDER REVISED 2026-08-02 (user challenged fake-first since the full ring is already wired; fake-first was variable isolation, not a hard requirement): flash REAL mode directly (USE_FAKE_SENSORS 0, no GPIO4 jumper) -> QGC inspector OBSTACLE_DISTANCE + upward DISTANCE_SENSOR + hand-wave each direction. FALLBACK if anything is wrong: fake mode + GPIO4 jumper bisects link-vs-ring (FAKE_VARY_CHANNEL sweep maps ring positions to angles without walking the frame). STATUS 2026-08-02: user flashed FAKE (the fallback) before seeing this revision; offered both paths (reflash REAL preferred, or GPIO4 jumper to bring the link up on fake first, then reflash REAL). Either way: params push (item 5) precedes any QGC visibility. CORRECTION 2026-08-03 (user, primary source): "I never flashed this ESP before" -> the earlier "user flashed FAKE" status line was WRONG (origin unknown, possibly a misrecorded session); NO flash has happened yet, the real-mode-first plan applies cleanly. FLASH ATTEMPT 1 (2026-08-03): PlatformIO detects nothing BUT laptop diagnostics all PASS (/dev/ttyUSB0 present root:dialout, cp210x bound, no brltty, user in dialout) -> suspect = VSCode workspace root: PlatformIO only activates when the folder containing platformio.ini IS the workspace root; user told to open esp32_obstacle_avoidance/ itself, not the repo. platformio.ini now pins upload_port/monitor_port /dev/ttyUSB0 (drop if the node moves). BOOT-button hold if "Connecting..." stalls. Flash with Pixhawk TELEM wires disconnected. FIRST FLASH SUCCEEDED 2026-08-03 (workspace-root fix worked; opening the repo root instead of esp32_obstacle_avoidance/ was the whole problem): ESP32-D0WD-V3 rev3.1, MAC 28:05:a5:27:0a:b0, 4MB flash, RAM 6.9% / flash 20.9%, hash verified, ~27s. PlatformIO mirror errors (sin1.contabostorage.com connection refused) at package-install = TRANSIENT CDN, auto-fell-back to another mirror, ignore. BUT that build was FAKE mode (config.h still had USE_FAKE_SENSORS 1) = will not transmit without the GPIO4 jumper; config.h set to 0 on 2026-08-03, RE-UPLOAD NEEDED for the real-mode-first plan. Next after that: params push (item 5) before QGC can show anything.
5. Boot-noise test on SERIAL4 (Luna's port after the 2026-07-27 swap): ESP32 EN->GND as USB-serial; Pixhawk TX4->ESP32 TX0; watch 57600+115200 across power cycles. If noisy -> TF-Luna to I2C fallback (addr 0x10, pin5 low, Benewake I2C type, verify wiki). ALSO push swapped SERIAL4/5_PROTOCOL params (setup file already edited) when Pixhawk next on USB.
6. TF-Luna bench over water basin, indoor+outdoor, nadir+angle -> decides descend-over vs descend-beside -> if beside, set the lateral_offset_n/e_m knobs (exist in MissionConfig, default 0).
7. PIXHAWK-UNO Q LINK (was 12; BLOCKED Raghav 2026-07-31, plan may need rework): UNO Q docs CONFLICT on whether D0/D1 (=STM32 USART1 = `Serial1`) is usable for the Pixhawk link. User manual says D0/D1 = Serial1 on the JDIGITAL header AND ALSO says the router claims Serial1, do not open it in your own code; Arduino_RouterBridge README says the Bridge uses a core-routed UART "falling back to Serial1 if the core does not provide it". NOT RESOLVABLE FROM DOCS -> must be tested on the board. If Serial1 is claimed, the SERIAL5-to-D0/D1 wiring plan is DEAD and the fallback is a USB-serial adapter on the splitter/hub (already present for the camera). Byte-shovel sketch NOT written pending this. Until resolved there is NO Linux tty for the Pixhawk (run_mission --conn has no default for exactly this reason). Downstream once resolved: byte-shovel sketch OR dongle, serial soak vs SITL tcp, board dry-run.
8. ESP32->TELEM2 wire-up: OBSTACLE_DISTANCE+DISTANCE_SENSOR ~10Hz from comp195 in QGC MAVLink Inspector; then real sensors (USE_FAKE_SENSORS 0), hand-wave each direction.
9. USER INPUTS OWED: (a) D + W for item 1; (b) DONE 2026-08-02 FINAL: servo is wired to AUX OUT 1 = output channel 9 (supersedes the provisional AUX6/ch14; setup file now has SERVO9_FUNCTION/MIN/MAX, run_mission --servo-channel default back to 9, wiring_check --wiggle defaults to 9). NEEDS A RE-PUSH of push_params.py to land SERVO9_*. The already-pushed SERVO14_* stay on the board, harmless (FUNCTION 0 = output driven by nothing); (c) spare RTL switch channel -> RC6_OPTION,4 push; (d) VectoBac G sourcing (photo suffices for docs); (e) Simple Mode reconfig or not; (f) AREA-DOSING RESOLUTION (3 options in decision log 2026-08-01) - blocks the model/input-size adoption AND any dosing claim in docs or to a judge.
10. Dataset v2 capture: phone nadir photos from height + negatives (shadows/tarps/wet ground/rooftops/plastic) -> retrain -> export -> spotcheck -> THEN model/input-size decision by the recorded rule (misses on small/far puddles -> resolution n@736/960; sloppy boxes on well-seen puddles -> capacity s@640). Measured TOTAL menu (board): n@640 511ms / n@736 716 / n@960 1208 / n@1088 1529 (= s@640 1518) / n@1280 2126; m OUT. n@640 stays flight model until decided.
11. SITL DROPOUT DRILL (the one unfinished 10-VERIFY gate): expect ABORT_CLIMB, 0 drops, survey completes. Also SITL-check the worker-split runner path once a fake det file feeder exists or via --inline-detector.
12. Base station board deploy: cloudflared reinstall (/etc/cloudflared token wiped by reflash) -> verify drone.reysen.net; bg-run cmd = setsid nohup ~/venv/bin/python ~/uno_q/basestation/app.py > ~/basestation.log 2>&1 &
12b. BENCH TEST RUNNING ORDER (written 2026-08-06 at user request, after parking the ring; conditions are part of each test, not optional):
  PRE-1 PRX1_TYPE=0 + reboot before ANY arming attempt without the ESP32, else pre-arm blocks (PRX gotcha). Conditions: Pixhawk on USB, QGC closed.
  A. USB-ONLY, no battery, props off, TX ON: (1) push_params.py, expect 60+ ok/0 refused; (2) wiring_check.py, expect FC/GPS/COMPASS/TF-LUNA/RC PASS (GPS sats 0 indoors is fine, msgs>0 is the test); (3) accel+level calibration in QGC on a genuinely level surface; (4) radio calibration, all sticks+switches full travel; (5) flight-mode switch check, ch7 through all 3 positions reading Stabilize/AltHold/Loiter.
  B. BATTERY ON, PROPS OFF, TX ON, safety switch pressed, aircraft restrained: (6) battery monitor calibration in QGC Power vs multimeter at the battery (BATT_VOLT_MULT then BATT_AMP_PERVLT); (7) ESC calibration per ArduPilot all-at-once procedure; (8) motor test wiring_check.py --motor-test, verify BY EYE motor 1 = front-right then clockwise, directions alternating; (9) RC failsafe: armed on the bench is NOT required, switch the TX off and confirm the FC reports failsafe/RTL intent in QGC messages; (10) servo/dropper wiggle --wiggle once the MG90 arrives, watch the gate physically move; (11) OLED shows status; buzzer audible at arm/disarm.
  C. RADIO LINK, battery, USB unplugged: (12) wiring_check.py --conn /dev/ttyUSB0 --baud 57600, confirms SiK end to end and gives rssi.
  D. OUTDOORS, battery, props off: (13) GPS lock test, wait for 10+ sats and HDOP<1.5 per CRASH LESSONS, note time-to-lock; (14) compass calibration, away from metal/rebar, all axes.
  E. SENSOR/PAYLOAD BENCHES (any time): (15) TF-Luna over a water basin, indoor+outdoor, nadir and angled, decides descend-over vs descend-beside (TODO 6); (16) hopper + salt flow test, plus WEIGH the MG90 and measure its stall current and the granule flow rate g/s (TODO 3); (17) RNGFND1_GNDCLR measured on the real airframe, replacing the 0.13 placeholder.
  F. UNO Q (independent of the Pixhawk): (18) camera FOV coin measurement -> --hfov-deg (TODO 1); (19) re-scp uno_q/ then detect_worker.py smoke test watching /tmp/monsoonready_det.json (TODO 2).
  THEN and only then the FLIGHT GATES below, whose first gate is the unloaded hover VibeZ<15.
ASSEMBLY (in progress) then CALIBRATIONS:
13. Finish frame: ESCs soldered to PCB plate + zip-tied, motors rigid, FC foam, GPS mast, service loops, power module install + V/I calibration vs multimeter, XY-3606 to 5.00V, SERIAL4/5 split cable build, OLED splices soldered, buzzer, TF-Luna + camera mounts (weigh stripped B525), ESP32+mux+7 sensors (FOV check) incl 3V3/GND perfboard distribution hub next to mux (1 feed pair from ESP32 3V3 pin -> two bus rails -> 8 tap pairs; NEVER 8 wires on one pin; per-sensor 4-wire bundles VIN/GND/SDn/SCn, soldered+heatshrink, service loops; optional 10-100uF across rails; feed wire = bench current measure point), hopper mount.
14. Calibrations: accel+level, compass, radio, ESC cal, motor order/direction test, RC failsafe bench test (TX off, props off), battery calibration. Re-dump params after (pull_params.py).
15. Conformal coat LAST (mask baro/USB/connectors).
BATTERY PERCENTAGE IS NOT A STATE-OF-CHARGE READING (user 2026-08-08: "says 100% even though it is measuring 11.89V"). NOT A FAULT, this is how ArduPilot works: remaining % = (BATT_CAPACITY - consumed mAh)/BATT_CAPACITY, and consumed mAh RESETS TO ZERO EVERY BOOT, so it reads 100% at power-on regardless of the pack's actual charge. It is a fuel gauge that assumes a full tank at startup, and it is only meaningful if you genuinely take off on a fully charged pack. THE PACK IS NOT FULL: 11.89V on the 3S (Build Log: 3S 8000mAh) is ~3.96 V/cell, roughly 60-70% resting state of charge (APPROXIMATE, the LiPo voltage/SoC curve is non-linear and load- and rest-dependent), versus 12.6V full. Charge before flying. What actually protects the pack is voltage-based and unaffected by the percentage: BATT_LOW_VOLT 10.8 -> RTL, BATT_CRT_VOLT 10.2 -> Land. CAVEAT ON BOTH NUMBERS: BATT_VOLT_MULT has NOT been calibrated yet (bench test B6), so the FC's 11.89V is itself unverified; check it against the multimeter before trusting either the voltage or the failsafe thresholds derived from it. PARAM GAP FIXED SAME DAY: BATT_CAPACITY was never in pixhawk_full_setup.param, only typed into QGC by hand, so a push_params run would have silently left it unset and nothing tracked it; now added as 8000. OPTIONAL, NOT SET: BATT_LOW_MAH / BATT_CRT_MAH give an mAh-based failsafe, but they are only as good as the current-sensor calibration, so do not enable them until B6 is done.
**BLOCKER FOUND 2026-08-08 IN QGC MOTOR TEST: ALL SIX MOTORS SPIN ANTI-CLOCKWISE.** Adjacent motors must alternate CW/CCW; all-same is the signature of all six ESCs soldered with the same phase order. NOT FLYABLE (uncontrolled yaw, no authority to correct). FIX IS HARDWARE: swap any TWO of the three motor PHASE wires on each motor that is wrong, never reorder the ESC signal leads (that scrambles the motor map instead). NOT fixable in params on this build: direction reversal needs DShot/BLHeli and this board runs plain PWM on MAIN (Pixhawk1-bdshot was already a recorded dead end); the only software exception would be BLHeli-programmable ESCs via their own config tool, unverified here. Which three to reverse must come from ArduPilot's Motor Order Diagram for Hexa X, NOT from assistant memory. AND match the props afterwards: a reversed motor with its old prop produces DOWNWARD thrust.
SESSION PLAN 2026-08-08 (user has ONE pack and a short window; answers to a question round): FITTED NOW = TF-Luna, UNO Q + B525, MG90 dropper, ballast, hopper (salt available, NEVER bench tested). Dropper has NEVER been actuated -> first movement on the bench, props off, hopper empty. UNO Q hotspot/SSH NOT set up, so in-flight detection recording depends on setting that up before leaving. PRIORITY IF ONLY TWO HOPS: the ENDURANCE NUMBER, so fly ONE continuous hover rather than several hops (interrupted flights make mAh/min meaningless). Full checklist in FIELD_CHECKLIST.md.
ENDURANCE MEASURED FROM LOG 37: burn rate 1990 mAh/min -> ~4.0 min on a full 8000 mAh pack, ~3.2 min to a 20% reserve. CAVEAT the user is right about: CurrTot accumulates over the WHOLE log (log 37 = 27 min, many arm/disarm cycles, 212s of actual motor time), and that pack was already part-drained, so this figure needs one clean full-pack flight plus a charger cross-check to confirm. check_log.py now prints motor-running time and the burn rate so that number falls out of the next flight automatically.
TWO MORE TOOL BUGS FIXED 2026-08-08: wiring_check FAILed the TF-Luna for reading BELOW RNGFND1_MIN, which is exactly what a HEALTHY rangefinder does with the aircraft sitting on its legs (0.12m vs 0.20m min) -- a false FAIL that would have wasted field time; now only 0.00/above-max fails, and below-min is reported as expected. check_log gained motor-running time and mAh/min.
WEEKEND VIDEO (requirements from the user): 5-10 min, ONE CONTINUOUS UNEDITED TAKE, publicly viewable (Drive must be "anyone with the link"), must open with a Google search for the date shown on camera, must cover functionality + assembly + components. Two people one camera; AI demo on a laptop screen on the ground. GOAL is the full autonomous detect-and-drop, FALLBACK is piloted flight + ground AI demo. The goal depends on TODO 7 (UNO Q<->Pixhawk link) which is still blocked; user chose to test D0/D1 on the board first. HARD CUTOFF RECORDED: if the link is not proven by Friday night, shoot the piloted version, because a failed autonomous attempt mid-take is an unusable recording and there are no cuts allowed. Running order drafted in FIELD_CHECKLIST.md.
FIELD TEST PLAN (written 2026-08-08 at user request; this is a MAIDEN FLIGHT for this rebuild, treat it as one).
  TOOL ADDED: tools/check_log.py (NEW 2026-08-08, UNRUN) parses a .bin and prints the numbers that decide whether to continue: VibeX/Y/Z median+95th+max, accel CLIPPING counters, worst sats/HDOP, learned MOT_THST_HOVER, ERR events and EKF/failsafe messages, with an explicit PASS/FAIL against the VibeZ<15 gate. It counts vibration ONLY while throttle-out exceeds --min-throttle (default 0.2), because ground samples are near zero and including them drags the median down and can turn a failing airframe into a passing number; it prints the included-sample count so an empty set is obvious.
  **PROCEDURE BUG FOUND THE HARD WAY 2026-08-08 (assistant's error): push_params.py PUT PRX1_TYPE BACK TO 2.** The sequence I gave was "set PRX1_TYPE=0, then push params", and the param file still contained PRX1_TYPE,2, so the push silently re-armed the dependency the first step existed to remove. A param FILE that contradicts the aircraft's actual fit always wins over a one-off command, so the fix belongs in the file: PRX1_TYPE is now COMMENTED OUT in pixhawk_full_setup.param with the reason and an "uncomment when the ESP32 is refitted" note. FIRST FIX WAS HALF-RIGHT AND FAILED TOO (same day): commenting the line out stopped the file re-writing 2, but could not CLEAR the 2 already on the board, so the next push+readback still showed PRX1_TYPE=2.0. **A param file only asserts what it CONTAINS**; anything that must be OFF has to state its off value explicitly or the file cannot bring a board to a known state. Now fixed properly: the file carries `PRX1_TYPE,0` with both mistakes recorded inline, and push_params enforces it. Set it back to 2 only when the ESP32 is refitted and transmitting. GENERAL LESSON for this param workflow: deleting a line from pixhawk_full_setup.param does NOT revert that setting on the aircraft, it only stops managing it.
  wiring_check ESP32/RING/UP-SENSOR checks are now OPT-IN via --expect-esp32, defaulting OFF because the ring is parked: with the ESP32 unplugged those three lines were FAILing every run and would have trained the operator to ignore red text on the one tool whose whole job is to be believed. Absence is now reported as informational; refit the ring and pass the flag to make silence fail again.
  PORT RESOLUTION (2026-08-08, after both tools threw ENOENT tracebacks): ports move constantly here (Pixhawk USB = ttyACM, SiK radio and ESP32 both land on ttyUSB, lowest free number wins), so wiring_check.resolve_link() now auto-picks when exactly one serial device is present and derives baud from the port type (ttyACM 115200, ttyUSB 57600), refuses to guess when several are present, and prints an actionable message listing what IS present instead of a traceback. bench.py shares it. MEASURED THIS SESSION: the SiK ground radio came up as **/dev/ttyUSB1**, not ttyUSB0, and the auto-pick connected and got the autopilot heartbeat over the radio first try.
  **tools/ AUDIT 2026-08-08: STOPPED EARLY, SALVAGED, NOTHING FIXED YET -> see tools/AUDIT_2026-08-08.md.** A multi-agent audit was launched after the RC false-pass and killed partway to save usage. 4 of 7 reviewers finished (66 raw findings, deduped to ~35 distinct defects) and only 8 of ~66 adversarial verdicts completed, so EVERY item in that file is UNVERIFIED BY A SECOND OPINION AND UNFIXED. Highest-consequence claims, all with source citations from the finders but none confirmed against hardware: check_log.py's clipping detection is DEAD CODE (AP 4.7 logs `Clip` per IMU, not Clip0/1/2, so it always reports zero); check_log.py pools all IMU instances into one VibeZ median so one bad IMU is diluted into a PASS; check_log.py reads hover throttle from PARM which never carries the LEARNED value (that is CTUN.ThH); check_log.py always exits 0 even on GATE FAIL; wiring_check --wiggle can leave the DROPPER GATE OPEN (no confirmation, no try/finally, close ack unchecked); wiring_check's motor-test and wiggle results never reach `ok` so "ALL WIRED CHECKS PASS" prints after motor failures; bench.py get/setparam accept ANY PARAM_VALUE as the answer; push_params.py still uses the naive wait_heartbeat this repo documented as broken. Two systemic patterns name the whole set: testing that a MESSAGE EXISTS rather than that the thing is TRUE, and a printed verdict that never reaches the EXIT CODE. RE-RUN IS CHEAP NOW: the workflow script was rewritten to Sonnet finders + Haiku verifiers, 2 verifiers not 3, 5 lenses not 7, capped findings, and no giant context repeated into every verifier prompt.
  **FALSE-PASS BUGS IN wiring_check.py, FOUND BY THE USER 2026-08-08 ("RC passes with the transmitter off"), ALL FIXED.** The class of bug is the same each time: testing that a MESSAGE EXISTS instead of testing the thing the message is supposed to prove. (1) RC was the dangerous one: it passed if any channel value sat between 800 and 2200, but a receiver in failsafe keeps emitting perfectly in-range values (held last-known or programmed failsafe positions), so a dead TX link read as PASS. Now keyed on the autopilot's own MAV_SYS_STATUS_SENSOR_RC_RECEIVER HEALTH bit, which ArduPilot clears on link loss or failsafe; channel movement is reported as extra colour, never as the verdict. (2) GPS passed on GPS_RAW_INT message count, but ArduPilot publishes that message with fix 0 / 0 sats whether or not a receiver is attached, so an unplugged GPS read as PASS; now requires the GPS-driver-present bit as well, with sats still reported and NOT required (0 indoors is normal). (3) TF-LUNA passed on message count for the same reason; now requires a reading INSIDE the sensor's own advertised min/max, since a disconnected serial rangefinder still gets a dutifully-published 0/out-of-range value. Early-exit and the motor-test RC guard were updated to the new signals too. LESSON WORTH KEEPING: for every check in this tool, ask what it would report if the thing under test were UNPLUGGED; if the answer is PASS, the check is decorative.
  ALL FIELD TESTING RUNS OVER THE SiK RADIO (user 2026-08-08): tools/bench.py NEW (mode/battery/failsafe/gps/rng/getparam/setparam subcommands, defaults --conn /dev/ttyUSB0 --baud 57600, imports wait_autopilot from wiring_check so the ESP32-steals-the-heartbeat fix lives in ONE place); wiring_check.py ack timeout now 12s on a <=57600 link because radio latency/loss made a working command print a false "NO ACK", and the fix is patience not teaching the operator to ignore the ack line. **LOG DOWNLOAD OVER THE RADIO IS NOT VIABLE**: a flight .bin is megabytes and a SiK link is a few kB/s, so the vibration-gate step would take hours and eat the battery. Pull logs by USB cable or by taking the SD card out. That is a change to the field sequence, not an optimisation.
  TAKE: aircraft, 2+ charged packs, charger, TX (charged), laptop + USB cable + SiK ground radio, multimeter, hex drivers + spare prop nuts + LOCTITE (C1 was a prop nut backing off), spare props, zip ties, tape, the phone/camera for footage, sunshade for the laptop, and a printed or offline copy of this gate list.
  SITE: open, no trees downwind (C2 was AltHold wind drift into a tree), no people within the fall radius, no metal fence for the compass, low wind. FENCE is still DISABLED in params (commented out), so the only flyaway backstops are the pilot's mode switch and the battery failsafe.
  SEQUENCE, each step gated on the previous one: (1) power on, DO NOT ARM for 2-5 min, wait for 10+ sats and HDOP<1.5 (C3 was armed seconds after power-on at HDOP 65-99); (2) Stabilize, props on, spin up to just under lift-off and check for unusual noise/wobble, disarm, re-check every prop nut by hand; (3) FIRST HOVER in Stabilize only, ~1-2m, 60-90s, unloaded, land, disarm; (4) PULL THE LOG AND RUN check_log.py BEFORE FLYING AGAIN, this is the vibration gate and the whole point of the trip; (5) only on PASS: notch tuning from the log FFT (INS_LOG_BAT_MASK is already 1), then AltHold hover, then Loiter; (6) only after Loiter is stable: loaded hover with ballast to payload weight, relearn MOT_THST_HOVER (MOT_HOVER_LEARN=2 already set), recheck VibeZ WITH the payload, since payload changes the resonance; (7) only then payload integration and mission flights.
  ABORT RULE (CRASH LESSONS, do not improvise): abort = flip to STABILIZE, never disarm. Disarm in the air ONLY for an imminent person-strike or an unrecoverable flyaway.
  STOP CONDITIONS: any clipping, VibeZ median >=15, any EKF variance message, any unexpected yaw/toilet-bowl in Loiter, or a learned hover throttle above ~0.5 at payload -> land, log, fix, do not proceed down the sequence.
  UNO Q IN THE FIELD (2026-08-08): the board is NOT connected to the Pixhawk (TODO 7 blocked), so it cannot fly a mission; what it CAN do, and what the docs/07 "unoq_detection" evidence needs, is run detect_worker.py while the aircraft flies over water and record what it saw. detect_worker.py gained --save-dir: it writes an annotated JPEG per frame that has a detection, un-letterboxing the boxes through camera_geom.letterbox_to_frame (the SAME conversion the flight code uses to locate a puddle, reused deliberately so the picture cannot disagree with the mission's maths). OnnxDetector.infer_rows() now also returns the BGR frame so the annotation uses the exact image that was inferred, not a second grab. Off by default because it writes to disk on every hit.
  NETWORKING THE BOARD IN THE FIELD: there is no wifi at a test site, so the UNO Q must join an Android hotspot, and **the credentials have to be stored and TESTED at home first** because nothing on the board will join an unknown SSID by itself. Whether NetworkManager/nmcli is present on this image is UNVERIFIED, check before relying on it. Find the board's hotspot IP from the phone's connected-devices list. Tailscale over the hotspot also works but adds a dependency on phone internet at the moment you need it.
  MACBOOK AS THE FIELD MACHINE (user 2026-08-08, taking Raghav's Mac): CODE BUG FOUND AND FIXED BY THE QUESTION ITSELF -- the port auto-detection globbed only /dev/ttyACM* and /dev/ttyUSB*, which are LINUX names, so on macOS every tool would have reported "nothing plugged in" while the hardware sat there working. serial_candidates() now also globs /dev/cu.usbmodem* (Pixhawk CDC), /dev/cu.usbserial* (FTDI SiK) and /dev/cu.SLAB_USBtoUART* (CP210x SiK), and is_usb_cdc() picks the baud. NOTE for macOS: use /dev/cu.* and never /dev/tty.*, because opening a tty.* device blocks waiting for carrier detect that a USB serial adapter never asserts, so the tool would HANG rather than fail.
  MAC SETUP STILL REQUIRED (all UNVERIFIED on that machine, and the Mac's recorded state is 2026-07-26, i.e. two weeks stale and predating the board reflash): git pull the repo; create a python venv with pymavlink AND **pyserial** for tools/ (2026-08-08: `pip install pymavlink` alone is NOT enough, pymavlink does not pull pyserial in, and if the unrelated PyPI package `serial` is present instead you get `module 'serial' has no attribute 'Serial'` from mavutil; fix = `pip uninstall -y serial; pip install -U pyserial`) (this repo's training/.venv is Linux-only and gitignored, the Mac has only the separate SITL venv); write PRIVATE.md from PRIVATE.sample.md with the board's CURRENT tailnet IP; re-run ssh-copy-id because the 2026-07-28 reflash wiped authorized_keys AND changed hostname to arduino-drone and the tailnet IP; install QGC for macOS; VERIFY whether the SiK radio needs a CP210x/FTDI driver on that macOS version (chip type not recorded here, check the radio). STANDING RULE CONFLICT TO SETTLE BEFORE THE TRIP: "Friend's machine: no training, no param pushes" (multi-machine coordination rules). If the Mac is the ONLY field machine it may need to push params, so either the user grants an explicit exception or ALL params are pushed from the Linux laptop beforehand and the Mac stays read-only. Do not let a tool decide this silently.
  PHONE-ONLY OPERATION (user asked 2026-08-08, has QGC + Termius on Android): PARTLY. QGC on Android can do the FC side (calibrations, params, motor test, flight display) IF the SiK ground radio is on a USB-OTG adapter, and Termius can SSH the UNO Q over the hotspot. What the phone CANNOT do: run this repo's python tools (push_params, wiring_check, bench, check_log) or analyse a .bin. The vibration gate therefore REQUIRES the laptop, so the laptop is not optional for the first field trip.
  FOOTAGE: capture docs/07 evidence on this same trip while the aircraft is flying (top-5 list: unoq_detection, full_loop, vibration_log INCLUDING a failing one, sitl_dropout_drill, spotcheck_grid). A failing vibration log is itself a deliverable, so keep it.
FLIGHT GATES (strict order):
16. Bench GPS check -> unloaded hover VibeZ<15 (THE gate) -> notch FFT switch + log verify -> Loiter -> loaded hover w/ ballast (relearn MOT_THST_HOVER, VibeZ recheck) -> payload integration -> mission flights -> demo footage (shot 2026-08-15).
DOCUMENTATION (judged category; DRAFTED 2026-07-26 in docs/ 01-08 + index, see decision log):
17. REMAINING = the TBD values only (docs are reference prose in the esp32_obstacle_avoidance/README.md house style: numbered sections, tables, no task-list voice; work items live HERE not in docs): (a) dataset URLs + mosquito BibTeX, CC BY 4.0 licence obligation, REYANSH has the Universe pages [docs/03]; (b) v2/yolo26n metrics + UNO Q ONNX fps once trained/benchmarked [docs/01,06]; (c) Raghav: compliance verification pass vs CURRENT DGCA text (assistant cutoff Jan 2026, rules change; low confidence on aerial-larvicide route flagged in-doc) + true test-site description + Bti registration check [docs/05]; (d) "hardest part" personal answers [docs/06]; (e) ALL evidence capture, prioritised list in docs/07 (top 5: unoq_detection, full_loop, vibration_log incl FAILING one, sitl_dropout_drill, spotcheck_grid); (f) shoot video vs docs/04 storyboard (has Plan A auto / Plan B descope columns), shot 2026-08-15.
NOTE (do not edit Build Log.txt, user-maintained): it still lists FC as "ArduCopter 4.6.3"; board is 4.7.0 since 2026-07-25. Docs use 4.7.0. ALSO (2026-08-01) two SG90 mentions remain in it (lines ~37 dispenser, ~40 parts ordered); every other SG90 in the repo is now MG90. Both are the user's to correct, flagged not edited. SUGGESTED BUILD-LOG ADDITIONS given to the user 2026-08-01 (his call, do not write them): FC firmware line 4.6.3 -> 4.7.0; SG90 -> MG90 swap + why; ETZIN EPL-1207CC OTG splitter as a REQUIRED part (the bare USB-C port cannot host a camera on any image, Type-C sink-only, case closed 2026-07-28); board reflash to the May-2026 image (wiped venv/data/cloudflared/keys); the SERIAL4/5 wiring swap. GIT NOTE 2026-08-01: user's uncommitted "Build Log.txt" edits blocked `git pull --rebase` ("cannot pull with rebase: You have unstaged changes"); it is a tracked user-maintained file so the fix is for HIM to commit it, never for the assistant to stash/discard it.
DESCOPE LADDER if time runs out: (a) Loiter + onboard detect + drop = minimum judgeable; (b) +base station report; (c) +obstacle array PoC; (d) +guided auto descent.

## DONE ARCHIVE (moved out of TODO 2026-08-02 at user request; relocation only, nothing deleted, whys intact; DECISION LOG holds more. Numbers below are the ORIGINAL TODO numbers.)
1. CLOSED 2026-07-29: run2 ONNX on board, benchmark 2.05fps A53 (489ms median), 24-img spot-check parity laptop-vs-board EXACT (0 count mismatches, conf delta .000, box delta 0.0px at recorded precision); grids both sides = docs/07 spotcheck_grid evidence (training/dataset/spotcheck_laptop/ + spotcheck_board/); onnxruntime /sys/class/drm probe warning on board = harmless, prints every run, ignore. Board also reachable on LAN 192.168.1.118 (DHCP, may change; tailnet IP in PRIVATE.md = stable address).
2. Camera on UNO Q: DONE 2026-07-29 (enumeration via ETZIN splitter on UBEC dumb 5V; 720p MJPG capture verified real JPEG; focus lock works as split transactions: focus_automatic_continuous=0 then focus_absolute=0). BOARD BENCHMARK DONE 2026-07-29 (user-run): median 489ms -> 2.05 fps on A53 CPU (2x headroom vs ~1s/frame mission bar; THE docs/01+06 number; onnxruntime /sys/class/drm GPU-probe warning = harmless, CPU EP intended). REMAINING: board/laptop parity spot-check (uno_q/spotcheck_onnx.py NEW 2026-07-29: 24-img set 14 pos/10 neg seed-42 from val -> training/dataset/spotcheck/, laptop baseline results in dataset/spotcheck_laptop/ incl grid.jpg = docs/07 spotcheck_grid material, 21 dets, frame-filling sheet-water miss visible as expected; user runs same script on board, scp results back, assistant diffs) -> full image->ONNX loop. UNO Q storage CORRECTION (user 2026-07-29): 32GB total (old "2.2G free" fact = pre-reflash image, stale). ONNX EXPORTED 2026-07-29 laptop: training/runs/puddle/weights/best.onnx 9.4MB, output (1,300,6) NMS-free end-to-end; IDENTITY VERIFIED yolo26n (metadata description + end2end shape + runs/puddle dir; user asked, confirmed NOT v8n).
9b. MODEL-SIZE MEASUREMENT (2026-08-01, user-run, replaces the assistant's guess): laptop `./python training/export_variants.py yolo26s yolo26m` -> training/variants/*.onnx -> scp to board -> `~/venv/bin/python ~/uno_q/bench_models.py --images '~/spotcheck/*' ~/uno_q/best.onnx ~/uno_q/yolo26s.onnx ~/uno_q/yolo26m.onnx`. DECIDE ON `TOTAL`, NOT FPS (single-threaded loop; TOTAL = how long poll() blocks the MAVLink pump). Reference point: yolo26n = 489ms median on this board. If a variant wins on TOTAL, it still costs ~12h GPU to train on v2 + re-export + re-spotcheck before it can fly, against the 2026-08-15 deadline. UNKNOWN: whether ultralytics publishes yolo26s/yolo26m under exactly those names (NOT asserted; the script passes the name straight through and ultralytics errors if it does not exist). Blocks the area/dosing decision above. 2026-08-01 session 2: bench_models.py letterbox re-verified byte-identical to detector.py; .gitignore now covers root *.pt (ultralytics downloads to CWD) + training/variants/ (30-100MB ONNX, repo goes public); board-side gotchas = bench_models.py must be scp'd (uno_q/ re-scp to board still pending per 10-VERIFY v) and the spotcheck image dir's exact path on the board is UNRECORDED, adjust --images if ~/spotcheck is wrong. MEASURED 2026-08-01 (user-run, board, 24 spotcheck imgs 640x640, ort 1.28 default threads): yolo26s 38.3MB TOTAL median 1921ms (min 1502 max 1999, 0.52fps, pre 19ms) = ~3.9x the n 489ms baseline; yolo26m 82.0MB TOTAL 4378ms (0.23fps) = OUT, no argument reaches 4.4s pump blocks. n baseline NOT re-run same-session: "MISSING ~/uno_q/best.onnx" = my path guess wrong (uno_q/ re-scp pending; where the 2026-07-29 benchmark's ONNX lives on the board is unrecorded, user to locate + rerun 3-way). VERDICT so far: s exceeds interval_s=1.0 (throttle no longer meaningful; pilot-override latency ~2s during SURVEY polls; coverage still fine, ~2s/frame supports ~3 m/s survey at 15m/60deg) -> s is MARGINAL, adoptable ONLY IF area-based dosing is adopted (its box-quality argument) AND ~12h v2 retrain fits before 2026-08-15 AND interval_s raised to ~2s+; else n stays. m rejected on measurement. FINAL 3-WAY (user-run 2026-08-01, same session, same 24 imgs): n=511ms TOTAL, s=1518ms (2.97x), m=4374ms (8.56x). NOTE s measured 1921ms in its first run and 1518ms in the second, ~20% run-to-run variance (thermal/load), so decide with margin, not on the best run. VERDICT REVISED after the worker split (see decision log): s's latency no longer blocks the MAVLink pump, so its remaining costs are detection cadence ~1.5-2s/frame (caps survey speed for gap-free coverage) and ~12h GPU retrain + re-export + re-spotcheck before 2026-08-15. m still out (nothing buys back 4.4s/frame cadence + 82MB). Adopt s ONLY with the area-dosing decision; n needs no change either way. BOARD ONNX PATH RECORDED: flight model = /home/arduino/best.onnx (NOT ~/uno_q/; found by user 2026-08-01). FOV CAPTURE ATTEMPT 1 FAILED (2026-08-01): /dev/video1 would not open and its focus controls are "unknown control" -> the B525 is NOT at video1 right now (unplugged or re-enumerated); camera index is UNVERIFIED until v4l2-ctl --list-devices is run. Board ~/uno_q is STALE (no run_mission.py), re-scp still pending. B525 IS AT /dev/video2 TODAY (2026-08-01, v4l2-ctl --list-devices; video3 = its metadata node, not capturable). The index MOVES between sessions (was video1 on 2026-07-29), so check --list-devices each session and pass --camera accordingly; detector.py's camera=1 default is unreliable. TODO-small: switch to the stable /dev/v4l/by-id/ path (cv2.VideoCapture accepts a device path string) so enumeration order stops mattering. FOV attempt 2 (2026-08-01): captured but UNREADABLE (handheld motion blur + dim warm light; tape ticks are only ~px-scale at 1.7m). Method switched to MARKER ALIGNMENT: camera resting stable, two bold objects nudged until they just touch the left/right image edges, then floor-measure between them = W; tape legibility in-photo no longer required. User suspects 640-fallback; capture command now prints f.shape to verify (must be (720,1280,3); if not, the geom preflight mismatch check exists for exactly this). USER ASKED 1080p + autofocus for the calibration shot: REJECTED, calibration must match the FLIGHT config (720p MJPG, focus locked infinity) because per-mode sensor crops and focus breathing can change the effective FOV (magnitudes unverified, which is exactly why the config must not differ); flying at 1080p itself rejected separately = zero model benefit (640 letterbox input) for more USB/CPU; speed cost ESTIMATED (not measured) at tens of ms/frame (decode+resize scale ~2.25x w/ pixels; inference unchanged, ~490ms n), so the argument against it is pointlessness, not speed; revisit only if tiling/cropping ever replaces downsampling. HIGH-RES MODEL QUESTION (user 2026-08-01: train n at 720/1080 input for long-range accuracy): assessment = at 15m/60deg a 1m puddle is ~37px in the 640 input, NOT tiny-object regime, and past recall failures were data-limited, so gains are likely modest, but MEASURE FIRST as usual: export_variants.py gained --imgsz (non-640 exports suffixed _<size>), bench_models.py now letterboxes to each model's OWN input size read from the ONNX. Bench n@1280 pretrained before any training decision; expected ~4x n@640 compute (ESTIMATE). Adoption consequences if it wins: detector.py hard-codes SIZE=640 (would need to read the model's input size), retrain at imgsz 1280 on 4GB VRAM = tiny batches/long run vs Aug 10, and it competes with s@640 for the same latency budget. Bench caveat: spotcheck imgs are 640x640 so the 1280 bench UPSCALES them; inference timing valid, pre timing approximate. MEASURED n@1280 (user, board, 2026-08-01): TOTAL 2111ms median (pre 80ms, 0.47fps, 10.4MB) = 4.32x n@640's same-session 488ms; the ~pixels-proportional scaling model holds, so interpolations are credible: 736=~650ms, 960=~1.1s, 1088=~1.4s (720/1080 are not valid YOLO input sizes, stride is 32, hence 736/960/1088). FULL LADDER MEASURED (user, board, 2026-08-01, warning-free after the fd fix): n@640 511ms / n@736 716ms (1.40x) / n@960 1208ms (2.36x) / n@1088 1529ms (2.99x) / n@1280 2126ms (4.16x); pixel-proportional scaling CONFIRMED (est. were 650/1100/1400/2100). KEY EQUIVALENCE: n@1088 costs the same as s@640 (1529 vs 1518ms) -> at the 1.5s budget the trade is resolution-on-n vs capacity-at-640, decidable only by training both (~12h GPU each). Cadence context: with the worker split nothing blocks; at 3 m/s survey, 2.1s/frame = ~6m spacing vs ~10m footprint depth (60deg placeholder), thin margin; 736 comfortable. DECISION RULE RECORDED: pick by v2 spotcheck failure mode (misses on small/far puddles -> resolution n@736/960; sloppy boxes on well-seen puddles -> capacity s@640); n@640 remains flight model until area-dosing is settled + v2 evidence exists. **DECIDED 2026-08-06 (user asked for a verdict): DO NOT TRAIN yolo26s NOW.** Reasons by weight: (a) days to the deadline and the aircraft had NEVER FLOWN at the time, with every calibration, the VibeZ<15 vibration gate (the historic blocker) and all flight gates outstanding, so the binding constraint is bench/flight time, not model quality; (b) the ONLY argument for s was box quality feeding area-based dosing, which still has six unresolved design conflicts, so it would be GPU spent on an unadopted feature; (c) run2 (n, 21717 imgs) ran ~4.8min/epoch to e322, so s at roughly 2x compute is ~2 days of GPU, and the expensive part is the HUMAN loop after it (re-export, re-spotcheck, board parity, re-benchmark) which competes directly with flight testing; (d) n@640 is the only model proven END TO END (laptop/board spotcheck parity EXACT, 489-511ms on the A53, flown through SITL), and swapping in a late less-verified model is how a working demo becomes a broken one. REVISIT ONLY IF all of: bench+flight gates done, dataset v2 nadir photos actually captured (retraining on the SAME data buys capacity only), and area-dosing resolved in favour of needing box quality. Cheap form then = a background run framed as a POST-FREEZE experiment, never promoted to flight model without full re-verification. ORT WARNING ROOT CAUSE FOUND (why fix #1 failed, user asked repeatedly): ort 1.28 emits the /sys/class/drm warning AT IMPORT TIME, before set_default_logger_severity can exist; fixed properly 2026-08-01 with an fd-level stderr park around the import (detector.quiet_import_onnxruntime, same inline in bench_models.py). Board copies of bench_models.py/uno_q must be re-scp'd to pick it up. FOV attempt 3 (2026-08-01): D=0.66m, 1080p, STILL unreadable -> at that range the locked-infinity flight focus is genuinely defocused; resolution cannot fix defocus. Options recorded: marker method at D~1.5-2m where infinity focus sharpens (REJECTED by user: no way to fix the camera at 2m, handheld caused the attempt-2 blur), so the route is table-edge mount at 0.6-1m + AF, valid because FOV is distance-independent and sub-cm D/W errors at 0.66m are <1%; FOV attempt 4 (2026-08-01): paired inf/AF frames came back IDENTICAL per user (no sharpness change at all) -> either the blur is gain/denoise smear from dim light (AF cannot help) or the AF control never engaged and the lens never moved; the breathing check is INCONCLUSIVE until lens movement is proven. v4l2-ctl -l readout (2026-08-01): focus_absolute range 0-255 step 5 default 60, flags=INACTIVE while focus_automatic_continuous=1 (AF owns the lens, parked position unreadable); AF WAS on during the identical-frames pair, so it engaged and settled somewhere infinity-like. Next: manual focus SWEEP 0/60/120/180/255 at 1080p with per-frame Laplacian-variance sharpness printed (fs_*.jpg); SWEEP DONE (2026-08-02): lens MOVES (255 = mush) and focus 0 = SHARPEST for the floor at rig height (Laplacian 7.8 vs 6.9-7.2; low absolute values = noise-dominated). So AF had parked ~infinity (explains identical AF pair), flight focus is already optimal, limiter = dim-light noise/denoise. Breathing check moot (measurement happens at flight focus 0). FOV endgame: coin method AT FLIGHT CONFIG (720p, focus 0), coins slid until half-cut by each frame edge, tape read on the floor, more light. AWAITING D + W. Coin-on-tape fallback given (coins as edge markers, read tape on the floor, no image readability needed). AF allowed for the reading only IF focus breathing proven negligible by a paired capture (same unmoved scene, locked vs AF; identical edge extent = AF-read W valid for flight config). CALIBRATION AT 1080p ALLOWED with crop-equivalence check: capture same scene 720p AND 1080p camera unmoved; if scene extent matches, read W off the 1080p shot and it applies to the 720p flight config (verifies the per-mode-crop concern empirically instead of trusting memory). CORRECTION: the earlier "board dry-run --conn tcp:127.0.0.1:5760" suggestion was WRONG, nothing listens there on the board and no Pixhawk tty exists (TODO 12); until a link exists the board smoke test for the detector split is detect_worker.py alone + watching /tmp/monsoonready_det.json update. USER Q&A saved (why does inference "stop everything"): it is the single-thread ARCHITECTURE (deliberate: no locks, SITL/board identical), not hardware; during poll() the same thread that pumps MAVLink also does pilot-override/arrival/freshness checks, so those go blind for TOTAL ms; the AIRCRAFT keeps flying (position targets persist in ArduPilot) and DESCEND/DROP never poll the detector, so the cost is companion reaction latency (mainly STANDDOWN response), not a mid-air stall. Frame<->fix pairing stays consistent during the block (tel freezes with the frame since no step() runs). MITIGATION IF S ADOPTED: move inference to a worker process/thread with poll() collecting results = new concurrency code + re-test of the SITL-proven loop, cost it against Aug 10 before committing.
SOFTWARE (parallel; Mac=Raghav unless noted):
10. DONE 2026-08-01 (Reyansh/laptop, commit below): ALL review fixes (a)-(h) implemented + the MG90 rename + doc corrections; CODE IS UNRUN, see TODO 10-VERIFY. What changed, by file: mavlink_io.py = Telemetry gains vn/ve/vd_mps from GLOBAL_POSITION_INT (cm/s -> m/s, vd positive DOWN), velocity_ned(force=) bypasses SETPOINT_RESEND_S for setpoint CHANGES, PWM_MIN_US/PWM_MAX_US (800/2200) exported so construction-time and send-time checks agree, set_servo docstring marks the "does ArduPilot NACK when SERVOn_FUNCTION!=0" question UNVERIFIED. mission.py = new terminal state STOPPED (runner asked to wind up; unlike STANDDOWN it still commands end_mode, and unlike DONE it never shows an interrupted flight as a completed survey), should_stop= callback checked after the pilot-override test and before the state handler, DROP SPLIT IN TWO (DESCEND forces the zero setpoint then enters DROP; DROP holds, waits for |vd|<=settle_vd_mps 0.15 or settle_max_s 3.0, THEN opens the gate, then holds drop_dwell_s AFTER the gate closes; EKF floor still guarded during settle, ~1m of margin so it cannot false-trip at normal decel), _abort() now forces the climb setpoint on the abort tick, mission_end reports dropper.succeeded not .fired, basestation launch skipped if the port already answers + Popen OSError caught. missionlog.py = drop event gains ok (absent means true, for pre-2026-08-01 logs). dropper.py = MG90 everywhere, full servo-source rationale in the module docstring, pulse widths validated at CONSTRUCTION incl closed==open, construction close now RAISES (pre-arm proof; refuse to fly a dropper that has not answered) while trigger() still never raises and returns False instead, succeeded counter, gate-stuck-open warning; ServoDropper docstring no longer claims uno_q/sketch_bridge/ exists. detector.py = conf must be in (0,1] (conf<=0 used to accept the 300-row export's empty padding rows), preflight() grabs a frame before arming and fails on a dead camera or a frame-size/geom mismatch, mid-flight size mismatch falls back to nadir once + warns, ALL rows above conf are considered best-first (not argmax only) so a treated puddle no longer suppresses its untreated neighbour, _height_agl() prefers a fresh rangefinder return over rel_alt (above HOME) since ground_offset's contract is AGL. run_mission.py = SIGINT/SIGTERM/SIGHUP set a flag -> normal wind-up -> RTL; try/except BaseException -> _emergency_rtl (3 attempts, then tells the pilot to take the mode switch) + CRASHED:<state> mission_end; finally closes the log; --conn now REQUIRED (the /dev/ttyHS0 default was invented, no confirmed Pixhawk tty exists); MissionLog built AFTER the --dry-run return (no more phantom dashboard flights); dry-run says so when no GPS fix arrived; waypoint-file OSError = clean message; docstring documents setsid nohup as the PRIMARY ssh-drop defence. predict.py = unused defaultdict gone, missing/null t no longer becomes a 20000-day span (Site.stamp ignores None), _num() rejects bool-as-number, half_life<=0 and radius<=0 rejected, failed drops counted separately so a failed gate does NOT halve a site's revisit score, RECURRING/PERSISTENT thresholds named as constants. index.html = dashboard vocabulary now matches predict.py (its >=2-flight ring says "recurring", "persistent" is predict.py's stricter >=3 flights AND >=7 days), drops with ok:false draw as a red X ring and are excluded from the Treated count. camera_geom.py = mount_yaw sign now states its viewpoint. .gitignore = .DS_Store/Thumbs.db + the 3 committed blobs untracked.
10-VERIFY (user-run 2026-08-01, 4 of 5 PASS): (i) py_compile all of uno_q/ = COMPILE OK; (ii) test_camera_geom.py = 24/24 PASS; (iii-a) SITL HAPPY PATH = PASS with the new settle code, real transcript: "DESCEND -> DROP (rng=2.98m, stopping before release)" then TRIGGER #1 then "DROP -> CLIMB (treated)", drops=1, abort=None, final DONE, disarmed, identical rng to the pre-change run (2.98m) so the settle did not move the release height; (iii-b) DROPOUT DRILL = **STILL NOT RUN**, the one remaining regression gate (expect ABORT_CLIMB, 0 drops, survey completes); (iv) predict.py = PASS, 18 sites/12 flights, verdicts unchanged. NOTE scores drifted 1.68->1.67 and 0.60->0.59 between two runs of the same data: that is CORRECT, recency is computed against time.time() and the fake flights age in real time. Not a bug, do not "fix" it. (v) re-scp uno_q/ to the board STILL PENDING.
10-OLD (superseded, kept for the why): the original review findings were (a) run_mission.py wrap Mission.run() in try/except/finally + SIGINT/SIGTERM handler -> always mission_end + set_mode(RTL) (CRITICAL: bare run(), any exception/ssh-drop kills the loop mid-descent w/ no RTL, no end record); (b) drop-while-descending: mission.py zero-velocity setpoint before dropper.trigger() is silently eaten by mavlink_io SETPOINT_RESEND_S=0.2 rate limiter, so gate opens while still descending ~0.65-1m (worst ~1.5m on ACK loss) -> force-send the zero setpoint (bypass limiter) and/or verify vz~0 before trigger; (c) PixhawkServoDropper: validate closed_us/open_us at CONSTRUCTION vs the 800-2200 guard (bad open_us today = silent mission-long no-drop, in-range closed_us masks it), and do NOT swallow the construction-time initial-close failure -> a failed pre-arm close must refuse to fly, else phantom "treated" events land in JSONL/dashboard/predict; (d) SERVO<n>_FUNCTION=0 + MIN/MAX are docstring prose only, absent from param_dumps/pixhawk_full_setup.param -> stage them once channel confirmed (TODO 8), else push_params workflow never sends them and DO_SET_SERVO is rejected silently; (e) detector geom frame-size mismatch: OnnxDetector projects ACTUAL frame pixels through a CameraGeometry built from --frame-w/h, no equality check -> if MJPG 1280x720 negotiation fails and frames arrive 640x480, every offset is metres wrong, silently; add a check/rebuild; (f) rel_alt_m (above HOME) is fed to ground_offset(height_m) whose contract is AGL -> offsets scale wrong over non-level terrain (25% at 3m datum error); document + consider rangefinder AGL when valid; (g) detector considers only the argmax row, so an untreated puddle co-visible with an already-fired site is suppressed until the fired one leaves frame -> iterate rows above conf, dedup per row; (h) minor/nit: predict.py `t` default 0.0 (missing t = 20000-day span, `t: null` crashes) + half-life<=0 ZeroDivisionError + unused defaultdict import; run_mission MissionLog built BEFORE the --dry-run return (every bench dry-run leaves a phantom "in progress" flight on the judged dashboard); --dry-run silently no-ops indoors (poll returns None w/o GPS fix); no camera preflight (dead camera = whole survey flown, 0 detections); missing waypoint file = raw traceback; basestation auto-launch collides w/ an already-running instance; camera_geom mount_yaw "clockwise" lacks a viewpoint (belly-mounted = ambiguous sign).
11. UNO Q mission code REMAINING (core DONE 2026-07-26; OnnxDetector DONE 2026-07-29 laptop-tested 6/6: fire conf .77/throttle/same-site dedup/negative/new-site/no-fix; design: interval_s=1.0 throttle b/c single-threaded pump + ~0.5s board inference, skip_radius_m=8 fired-site memory prevents re-latch after CLIMB, conf=0.5 flight default, nadir assumption, frame_source injectable for tests, focus lock = 2 separate v4l2-ctl calls at init): pixel->ground offset DONE 2026-07-31 Raghav (camera_geom.py, 24 unit checks; HFOV STILL UNMEASURED = placeholder 60deg, runner omits geom unless --hfov-deg given, offset error is PROPORTIONAL to FOV error -> run calibrate_fov with a tape measure in final housing), dropper DONE as PixhawkServoDropper (see POWER MAP + TODO 10c/d), run_mission.py onboard runner DONE incl containment (TODO 10 fixes all applied 2026-08-01, UNVERIFIED until 10-VERIFY). REMAINING: descend-beside offsets once TF-Luna bench (TODO 6) decides, serial soak on real SERIAL5 vs SITL tcp (blocked by 12), board-side OnnxDetector live-camera test (user-run), 10-VERIFY.
13. Base-station: CODE DONE 2026-07-26; LAPTOP TEST PASS 2026-07-26 evening (assistant-run, see decision log: fake missions, API 404s/traversal, per-flight filter, layer toggles, tooltips, site-image, crash-truncation tolerance, 15s poll, dark/light CSS; 0 console errors). SITL END-TO-END PASS 2026-07-26 evening (laptop, both scenarios --record; dashboard renders the recorded JSONL; see decision log incl stats-before-render bug fixed + laptop xterm-launch gotcha). BOARD DEPLOY DONE 2026-07-29 (user: dashboard works from board over LAN). DASHBOARD v2 2026-07-29 (user requests, laptop-tested on 12 random flights, 0 console errors): wheel zoom (cursor-anchored, k 1..64, snap-home at 1) + drag pan (only when zoomed) + dblclick reset, implemented as affine view folded into proj.s/ox/oy post-fit so ALL layers scale free; abort tile red (--critical) mirroring treated green; gen_fake_mission.py --flights N --seed S random mode (serpentine surveys, shared site pool -> persistence, 75/25 treat/abort, one flight/day; no-flag default = original 2 curated flights). Flask dev-server warning = informational, acceptable for read-only single-viewer dashboard behind cloudflared (waitress = optional hardening, not needed for demo). KNOWN-COSMETIC: first paint differs from later paints by <0.1% px (font rasterization settling), self-corrects on any redraw. DASHBOARD v3 2026-07-30 (user bug reports): detections-toggle "did nothing" = REAL BUG, dots fully occluded (every det co-located w/ bigger drop/abort marker drawn later); fix = det layer drawn LAST w/ surface outline, verified px-exact (det blue vs drop green at same coord). Light theme REMOVED (dark-only, user request; matchMedia listener gone). Scale bar user-reported inaccurate but MEASURED CORRECT (ground-truth pair 30.64m: 5.292 px/m measured vs 5.286 proj.s, 0.1%, zoom-consistent); awaiting user's comparison method before touching it. REMAINING: user re-scp uno_q/ to board for v2 dashboard, cloudflared reinstall (token wiped by reflash) -> verify drone.reysen.net, onboard runner sets basestation_cmd (DONE Raghav 2026-07-31 in run_mission.py); bg-run cmd for board = setsid nohup ~/venv/bin/python ~/uno_q/basestation/app.py > ~/basestation.log 2>&1 &
14. DONE 2026-07-31 (Raghav): uno_q/predict.py recurrence scoring. Threshold reconciliation + nits DONE 2026-08-01 (predict.py holds the vocabulary: RECURRING >=2 flights, PERSISTENT >=3 flights AND >=7d span; the dashboard's >=2-flight ring now says "recurring" to match, so the map and the table can no longer label the same site differently). REMAINING: nothing, pending 10-VERIFY.
END OF DONE ARCHIVE.

## SESSION CONTINUITY (update every session end; laptop side current: 2026-07-25 evening; Mac side current: 2026-07-26)
MAC (Raghav): SITL env live (launch: ../ardupilot/Tools/autotest/sim_vehicle.py -v ArduCopter -f hexa --no-mavproxy --speedup 5 --add-param-file=uno_q/sitl_rangefinder.parm; PATH-prefix repo .venv/bin; it is a SERVER, runs until killed, never "completes"; do not pipe it to tail, that swallows output). uno_q/sitl_test.py PASS both scenarios 2026-07-26. Nothing LIVE on Mac as of 2026-07-26 (docs work finished+pushed).
MAC SSH TO BOARD: user=arduino confirmed (Raghav 2026-07-26), password auth today; tailnet IP not recorded (Tailscale installed on Mac but STOPPED; start it then `tailscale status | grep -i drone`). ed25519 keypair generated on Mac 2026-07-26 (~/.ssh/id_ed25519, NOT the laptop's key); pub key NOT yet in board authorized_keys -> Raghav runs ssh-copy-id (he types the password; password deliberately not stored in PRIVATE.md).
LIVE 2026-08-06 (Raghav, PHYSICALLY AT REYANSH'S HOUSE, on Reyansh's laptop): flashing the RUN_I2C_DIAG=1 build to the ESP32 and reporting the matrix, at Reyansh's direction. Scope limits restated to him and standing: no param pushes from his own machine, coordinate before touching the UNO Q. GOTCHA FLAGGED: the SiK ground radio and the ESP32 BOTH enumerate as /dev/ttyUSB*, so unplug the radio or pin upload_port before uploading, else PlatformIO can push firmware at the radio. REMEMBER TO SET RUN_I2C_DIAG BACK TO 0 AND RE-UPLOAD: that reflash is also what puts the 30->0 ring angle_offset correction live. Separately still unclaimed: the uno_q/ re-scp to the board.
LIVE: (laptop/Reyansh, 2026-07-26) TODO 13 base-station code COMPLETE + pushed (untested; user will run tests himself, see TODO 13 REMAINING); Raghav do NOT touch basestation. User out of station: only laptop + UNO Q ssh reachable (no Pixhawk/camera/bench hardware). User runs commands/scripts himself this stint EXCEPT explicitly-delegated SITL setup (assistant-run, done). Laptop SITL BUILT 2026-07-26: /media/sleuther/Stuff/ardupilot-SITL @ tag Copter-4.7.0 (4.7 uses unified branch ArduPilot-4.7; per-vehicle 4.7.0 = tags on same commit), .venv inside (empy 3.3.4, pexpect, pymavlink), binary build/sitl/bin/arducopter; launch = Tools/autotest/sim_vehicle.py -v ArduCopter -f hexa --no-mavproxy --speedup 5 --add-param-file=<repo>/uno_q/sitl_rangefinder.parm (server, runs until killed). Cloudflared: user-installed ON BOARD (systemd-ish token /etc/cloudflared), drone.reysen.net -> localhost:8080, verified 502 (tunnel up, no server yet). run2 (yolo26n 21.7k) still NOT started.
LAPTOP SITL LAUNCH GOTCHA (2026-07-26): sim_vehicle.py on the laptop spawns arducopter inside an xterm (RiTW) which accepts TCP 5760 but never sends heartbeats (cause not diagnosed; single-threaded spin). SECOND GOTCHA (2026-08-01, assistant's error, cost the user 5 minutes): arducopter is a SERVER. "Waiting for connection ...." is its NORMAL idle state and it blocks there until a MAVLink client connects on 5760; it is NOT a hang and must NOT be Ctrl-C'd. It therefore needs its OWN TERMINAL, with sitl_test.py run from a SECOND one. Chaining them with && in a single shell can never work: the test only starts after arducopter exits, by which time port 5760 is gone (exactly the ConnectionRefused loop the user hit). Never hand out a one-terminal SITL command block again. WORKING laptop recipe: run the binary directly: cd /media/sleuther/Stuff/ardupilot-SITL && build/sitl/bin/arducopter --model hexa --speedup 5 --defaults "Tools/autotest/default_params/copter.parm,Tools/autotest/default_params/copter-hexa.parm,/media/sleuther/Stuff/Robu AI Challenge/uno_q/sitl_rangefinder.parm" -I0 (server, waits for first TCP connect, runs until killed; consecutive sitl_test.py runs work WITHOUT restart). If sim_vehicle route wanted, PATH-prefix .venv/bin or waf rebuild fails on missing empy. "Warning model expected 4 motors and got 6" at startup = harmless.
LIVE: laptop-side review of Raghav mission package PASSED 2026-07-26 (mission.py+mavlink_io.py verified vs PROJECT_STATE safety rules: latch, dual dropout-abort, EKF floor, STANDDOWN, compid 191, NED signs, orientation filter); run2 (yolo26n, 21.7k imgs) to be started by user tonight. RUN2 PREFLIGHT DONE 2026-07-26 night: dataset v2 verified merged (21717 train/4452 val, labels match), runs/puddle clear (no accidental resume; puddle_v1 = v8n fallback intact), yolo26n.pt local, GPU idle; train.py EPOCHS 200->600 (cap only; patience=50 plateau stop unchanged per user), BATCH 8->16 (per V2-RETRAIN PLAN, run1 used ~1GB/4GB; OOM fallback = back to 8). User launches detached (setsid nohup, log training/train.log). Pause/resume + pkill footgun: see run1 notes below. OOM INCIDENT 2026-07-27/28: kernel oom-killer killed run2 at e212 (22:24) and again on morning restart (09:19; journal-verified, laptop 27GB RAM but 13GB desktop use + 2GB swap 90% full; batch16 workers8 shm buffers = the overage; morning CUDA-OOM spam = dying instance still held VRAM). FIX pushed: train.py batch 8 + workers 8 (user keeps 8, will close other apps; workers ALSO passed on the resume path (ultralytics check_resume override list includes batch/workers, source-verified). Checkpoints intact, resume from e212 (metrics still climbing: e212 mAP50 .757 P .793 R .692). Overnight-run hygiene: close browsers/heavy apps (esp. the ~10GB of java seen in the OOM dump), ONE instance only (pgrep first), optional swap bump recommended. LAUNCH CMD now APPEND (user 2026-07-28): setsid nohup .venv/bin/python train.py >> train.log 2>&1 & (was >, which erased log history on every restart; train.py now prints a timestamped run header per start). 2026-07-27 morning check: e154/600, best P .763 R .686 mAP50 .741 mAP50-95 .450, fitness still improving (best=last, patience counter 0), ~4.8min/epoch, 12.4h cumulative; NOT comparable to run1 numbers (different val set: v2 4452 imgs, harder). NEW training/val_compare.py (user request): val-only pass scoring BOTH run1 v8n fallback + run2 26n on the v2 val split (same-benchmark comparison; needs GPU free). USER runs it manually after run2 finishes: ./python training/val_compare.py (GPU must be free). RULE (user 2026-07-27, standing): NEVER create background services/watchers/scripts without asking first (an auto-run watcher was armed for this and removed on user request). STALE-BELOW: YOLO run1 notes kept for history: run1 training detached on laptop (setsid nohup .venv/bin/python train.py, log training/train.log, ckpts training/runs/puddle/weights/). Pause: kill the train.py process; FOOTGUN: pkill -f train.py inside a compound shell command matches the shell itself (exit 144, rest of command dies); use plain pgrep -f then kill PID, or run pkill alone. Resume: rerun train.py (auto-resumes last.pt). When done: nothing auto-fires; next = export.py -> scp ONNX to UNO Q -> benchmark.
AWAITING USER: (a) spare RTL 2-pos switch channel number -> then uncomment RC6_OPTION,4 + push_params; (b) **TODO-2 IS CLOSED, 2026-08-11 (user): THE CAMERA WORKS AND HAS BEEN TESTED.** `v4l2-ctl --list-devices` on the board shows `B525 HD Webcam (usb-xhci-hcd.2.auto-1)` at /dev/video0 and /dev/video1. Everything below this point in this item is the HISTORY of a problem that is SOLVED; do not re-debug it, and do not quote it as a live blocker. Kept only because the schematic findings about the 5V/VBUS rail are still true and still constrain the power design. STALE-INFO WARNING: this item sat in the file as a live blocker for two weeks after it stopped being one. ORIGINAL TEXT FOLLOWS: B525 CONNECTED 2026-07-28, TODO-2 was BLOCKED because UNO Q USB-C never enumerated it. DIAGNOSED so far: typec port0 = sink-only, port_type/data_role sysfs read-only on this build; camera invisible even after community workaround (sudo echo host > /sys/kernel/debug/usb/4e00000.usb/mode, same fix as forum.arduino.cc/t/1412062; one user ran a dongle this way on VIN) + adbd stopped (it auto-restarts each boot; its dmesg spam = functionfs retry loop). SCHEMATIC-VERIFIED (ABX00162 pg20/22, PDFs in session scratchpad, redownloadable from docs.arduino.cc): JANALOG 5V pin IS net 5V_USB_VBUS = USB-C connector VBUS pins direct -> 5V-pin powering already puts bench 5V on camera VBUS (METER-CONFIRMED 2026-07-28: 5.20V at adapter A-socket VBUS, ~0.1V on GND side; ALSO = the UBEC loaded-voltage acceptance test from POWER MAP item (1): 5.20V loaded PASSES, 5.3V bench reading was the unloaded artifact, UBEC feed cleared); camera therefore POWERED, blocker narrowed to DATA path: host mode forced + xhci hubs up + powered camera = zero connect events (dwc3 debugfs toggle device->host verified working mechanically in dmesg: xhci teardown/re-register clean, gadget g1 -19 expected). Suspect = SoC USB2 PHY/typec mux not engaging host role on image BUILD_ID=20251210-442 (buildinfo checked; postdates the Nov-2025 "newer images fixed it" claim yet boots device-mode; workaround resets EVERY boot, adbd too). ISOLATION DONE 2026-07-28: keyboard+mouse also invisible (device-agnostic), /sys/kernel/debug/usb/devices = root hubs only, apt upgradable = nothing USB-relevant (alsa/atheros/qcom-soc fw only; apt-repo.arduino.cc present). WORKING THEORY (explains all evidence): powering via 5V pin = driving VBUS net = board permanently sees "charger attached" -> PMIC/typec holds PHY in device role regardless of dwc3 debugfs mode; matches staff "5V pin is output-only/unsupported input" + the one community success being VIN-powered (Sonoff+echo host). VIN TEST DONE 2026-07-28 (12V on VIN): VBUS at A-socket = 5.2V SELF-SOURCED (back-drive auto-on; "usb_vbus: disabling" @+33s does NOT kill it) -> OLD RULE "VIN disables USB VBUS out" METER-FALSIFIED. BUT keyboard+camera STILL zero enumeration on VIN + forced host -> blocker is NOT power and NOT dwc3 role: revised root cause = PMIC(PM4125)-typec HS data-path/mux never hands D+/D- to the SoC PHY while its port is sink-only (Qualcomm routes D+/D- through PMIC charger-detect); unreachable from userspace. "Newer image has the fix" claim DISCREDITED (fix repo's test = /etc/buildinfo merely EXISTS; ours exists, 20251210-442, still broken). WHY THE DOCK WORKS: PD hub speaks real PD to ANX7625 which resolves roles in hw (board = power sink + data host) = the Arduino-documented camera path. ADOPTED PLAN (2026-07-28): (1) USER buys USB-C hub w/ PD pass-through (Amazon.in; forum-proven iCAM 6-in-1 TC606 or equiv "PD pass-through" compact hub) = FLIGHT-VIABLE: UBEC 5V -> hub PD-in -> hub powers board via USB-C (supported path) + camera on hub A-port, ~20-40g stripped; bench VERIFYs on arrival: hub runs from dumb 5V on PD-in (some demand real PD negotiation; if so add PD-trigger board), forum plug order (board up first, then hub); (2) forum post w/ full diagnosis asking supported direct-host config (assistant drafts, user posts); (3) image update DEMOTED to release-notes-check-first (no blind flash). POWER MAP rewrite deferred until hub verified. sysrq HELP spam in dmesg = serial console noise, non-issue. SUPERSEDED SAME DAY: USER REFLASHED the board 2026-07-28 (his call, full wipe) to the May-2026 image: kernel 7.0.0-g122c2c22d838 (was 6.16.7), model string "Arduino UnoQ", HOSTNAME now arduino-drone, NEW TAILNET IP (PRIVATE.md updated; old IP dead). CONFIRMED on new image: dwc3 boots in HOST mode natively on VIN power (no debugfs echo, no adbd gadget spam) = the community "newer image" claim was real; usb_vbus still kernel-swept @+33s (cosmetic: unclaimed regulator auto-disable, hw gate self-enables on rails-good, meter-proven 5.2V post-disable on old image). FINAL DIAGNOSIS 2026-07-28 (case closed, new image): camera still silent; VBUS 4.7V self-sourced (buck+schottky+switch drops vs 5.2V bench-fed; above enumeration threshold); typec on new image = data_role [host], usb_role host, PD 3.0 stack, BUT power_role FIXED [sink] (no port_type knob) and NO port0-partner with camera plugged -> Rd(board-sink) vs Rd(passive adapter) = per Type-C spec NO ATTACH EVER, and without attach the PMIC never hands D+/D- to the PHY. Direct A-adapter camera on the bare port = IMPOSSIBLE on this board by design, on any image, any power source. Sonoff-on-VIN forum anecdote unexplained, abandoned. HUB = REQUIRED + CRITICAL PATH (gates all camera milestones, 2026-08-15 deadline): flight config = UBEC 5V -> hub PD-in (VERIFY dumb-5V accepted) -> hub upstream-C powers board as sink (SUPPORTED path; VIN wire and 5V-pin feed BOTH dropped from flight design) + B525 on hub USB-A. Buy: compact USB-C hub, explicit PD pass-through, >=1 USB-A, Amazon.in. INSIGHT: laptop "PD passthrough" hubs are electrically our exact case (hub sources on CC toward host when its PD-in is powered = the attach trigger; board sinks power + DR-swaps to data host) -> any well-reviewed laptop PD hub qualifies. CART DECIDED by user 2026-07-28: ONLY the ETZIN EPL-1207CC OTG splitter Rs660 (10-day returnable; that returnability is the load-bearing reason: Mport 52 REJECTED non-returnable, multi-item cart REJECTED; ~coin-flip risk accepted: 3.2/35 device-dependent reviews = passive-CC suspect, and board needs active source-advertisement on CC to attach; if it fails, next candidate must be RETURNABLE, filter hard on that). Delivery ~Jul 31. BENCH SEQUENCE on arrival (one variable at a time): (1) real PD phone charger -> splitter charging port, splitter C-plug -> board, ls /sys/class/typec: port0-partner = 2-minute pass/fail gate; (2) PASS -> camera on A socket, lsusb, full TODO-2 sequence, THEN flight-power experiments (UBEC dumb 5V on charging port; 12V-car-PD-adapter-on-3S idea parked as fallback); (3) FAIL -> same-day return + pick next candidate (returnable-only filter). SPLITTER ARRIVED EARLY + CAMERA GATE PASS 2026-07-29: lsusb on board (hostname arduino-drone) shows 046d:0836 Logitech B525 enumerated on Bus 001 -> ETZIN EPL-1207CC WORKS as attach trigger + data path, keep (returnability clause no longer needed); power source during pass = UBEC DUMB 5V (user 2026-07-29) -> FLIGHT-POWER GATE ALSO PASSED in the same test: UBEC 5V -> splitter charging port -> board powered as sink + camera enumerated = the full flight chain works, no PD-trigger board needed. CAMERA FACTS (new image, 2026-07-29): B525 = /dev/video1+video2 (video0 = Qualcomm Venus ENCODER, video3 = decoder; old video0 cmds stale); default negotiated fmt = raw YUYV 640x480 (stream-to dump = 614400B raw frame, NOT jpeg; must set MJPG 1280x720 explicitly); focus set-ctrl returns EACCES even under sudo (both ctrls in one transaction; split-and-retry + --list-ctrls diagnosis pending); scp = user runs it FROM the laptop pulling (laptop has no sshd; board-side push fails). PARALLEL while shipping: board re-setup per checklist above so ONNX benchmark runs day-of-arrival. BOARD RE-SETUP NEEDED (all wiped): ~/venv (python3 -m venv ~/venv; pip install onnxruntime opencv-python flask pymavlink), ~/monsoonready_data, cloudflared + /etc/cloudflared token (drone.reysen.net dead until then), laptop+Mac ssh keys re-authorized, v4l-utils, docker state, sudo password set by user. Raghav: board was flashed today, old IP/hostname invalid, re-run ssh-copy-id. phone-charge test INVALID for VBUS presence (C-C needs CC advertisement, sink-only port never advertises); back-drive Q2801 5V_SYS->USB_VBUS_IN gated by Q2802/LDO1_PG + SoC line VBUS_POWER_SWITCH_DISABLE_N (likely the sw usb_vbus regulator, 0 users, kernel disables @boot+33s). LEADS: (i) newer Arduino OS images enable host mode natively (forum + github Psalmustrack/arduino-uno-q-usb-fix README both say check /etc/buildinfo; that repo itself = just a systemd echo-host unit, NOT needed, and do not curl|bash it) -> USER to run: cat /etc/buildinfo; if old image, arduino-flasher-cli update = candidate clean fix BUT flash wipes board (~/venv, ~/monsoonready_data, /etc/cloudflared token, authorized_keys) AND needs Raghav coordination per multi-machine rule; (ii) mode-toggle device->host with camera attached (PHY may re-init only on transition), dmesg --follow while doing it; (iii) bench-only fallback = powered PD hub w/ plug order board-first (forum t/1430972), NOT flight-viable. NUANCE FLAG: recorded "VIN disables USB VBUS out" rule may be OS-image-dependent (newer images + Sonoff-on-VIN report contradict it for updated fw); re-verify after any image update; (c) VectoBac G sourcing; (d) Simple Mode wanted or not (was per-mode checkbox pre-reset, not restored).
PIXHAWK: on USB /dev/ttyACM0, config COMPLETE+verified, safe to disconnect. QGC may be open or closed; only matters for pymavlink tools (port exclusive).

## MICRO-FACTS (small but load-bearing)
UNO Q status LEDs (docs-verified 2026-07-28, user-manual): 4 RGB LEDs, 2 MPU-driven; status LED segments in /sys/class/leds = red:panic (the actual trouble light), green:wlan, blue:bt; solid blue=BT up, cyan-ish flashing=wlan activity on top of blue = NORMAL. Inspect: for f in /sys/class/leds/*/brightness; do echo "$f = $(cat $f)"; done. LEDs say nothing about supply quality; power acceptance = loaded meter at 5V pin.
Camera test cmds (UNO Q): lsusb | grep -i logitech; v4l2-ctl --list-devices; v4l2-ctl -d /dev/video0 --set-ctrl=focus_automatic_continuous=0 --set-ctrl=focus_absolute=0; capture: v4l2-ctl -d /dev/video0 --stream-mmap --stream-count=1 --stream-to=test.jpg.
UNO Q: Debian 13 (PEP668: pip only in ~/venv), sudo NEEDS password (never ask for it; give user the command), docker installed, /usr/lib/chromium 361M (do not remove, App Lab may need), ~ has ArduinoApps/, board hostname "drone".
Laptop training/.venv also carries: pymavlink 2.4.49, pyserial, yaml (via ultralytics), ultralytics 8.4.105, torch 2.13.0+cu130.
ESP32 build env: PlatformIO NOT globally installed on laptop; user has PlatformIO VSCode extension (their build path); Claude's route = python venv with platformio pip pkg (toolchains cached in ~/.platformio, survive). Build outside the repo or .pio is gitignored anyway.
Loaded-hover rule: if learned MOT_THST_HOVER > ~0.5 at full payload, trim payload (thrust margin thin; topic is user-settled, raise only via measured data).
Thrust math never measured on F550: treat loaded hover log as the authority.
gh CLI authed (account in PRIVATE.md). Git commits: NO Co-Authored-By trailer (user rule 2026-07-25). Commit authorship (2026-07-29): repo-local user.email = the GitHub noreply address (exact string + user's real email in PRIVATE.md ONLY; noreply chosen because repo will go PUBLIC for judges = harvest-proof, identical attribution; pre-2026-07-29 commits author sleuther@localhost, left as-is, history never rewritten). RULE: no real personal emails in any committed file.
QGC path + SSH key path: PRIVATE.md.
mosquito dataset page has BibTeX for citation; license CC BY 4.0 requires attribution in docs.
ESP32-as-USB-serial trick (for SERIAL5 sniff): ESP32 EN pin to GND holds chip in reset, its USB-UART bridge becomes passthrough; external TX -> board's TX0 pin -> PC.
3V3 sensor-rail budget VERIFIED 2026-07-27 from datasheets: TCA9548A Icc 20uA typ/35uA max (TI DS, 3.6V 400kHz); VL53L0X ~19mA typ ranging/~40mA peak/uA standby (ST DS); mux sequences so ~1 sensor ranges at a time; even impossible all-7-peak = 280mA. ESP32 dev-board 3V3 pin = onboard 5V->3.3V reg shared w/ ESP32 (WiFi unused): design fine on paper; VERIFY remaining = which regulator the actual board carries -> meter in series on 3V3 feed during 7-sensor bench test.
Old OneDrive project copy may still exist at /home/sleuther/OneDrive/Documents/Coding/ (folder was moved 2026-07-25; treat /media/sleuther/Stuff as only truth).

## DECISION LOG (append here)
2026-08-01 (Reyansh/laptop) RAGHAV'S SUMMARY TRIAGED (user forwarded it asking what still matters): every item is already recorded in state (camera_geom + site-dedup fix = TODO 11; predict.py = TODO 14; run_mission = TODO 13/10; decision 1 = TODO 12 blocked, needs the board test; decision 2 = servo on Pixhawk AUX, kept after 2026-08-01 re-litigation, waiting on the user's AUX-channel confirm + SERVO9_FUNCTION=0 staging per TODO 8/10d; decision 3 = FOV, measurement procedure handed to the user this session). One discrepancy: he wrote "SERIAL4-to-D0/D1", state says the plan was SERIAL5 then swapped, per the Build-Log-suggestions note; harmless either way since TODO 12 decides if ANY UART plan survives. His flagged easy fix (basestation summarize drops over-count) is now DONE, see next entry.
2026-08-01 (Reyansh/laptop) **DETECTOR MOVED OFF-THREAD (user-directed): detect_worker.py + FileDetector, in-loop inference kept as --inline-detector fallback.** The user's file-handoff design, implemented as specced because it is sound: uno_q/detect_worker.py owns camera+ONNX in its OWN process and atomically rewrites one JSON (tmp + os.replace; default /tmp/monsoonready_det.json, tmpfs so no SD wear) every cycle even with zero rows, so mtime doubles as the liveness heartbeat; detector.FileDetector reads it from the mission loop (stat per tick, JSON parse only on new seq). THE LOAD-BEARING SUBTLETY: a result read now is for a frame captured one inference ago (~5m of travel at 3 m/s with s), so FileDetector keeps a ~20s deque of telemetry snapshots and resolves the puddle against the snapshot nearest t_frame (wall clock, same machine), incl rangefinder freshness judged at frame time (at_t param). Refactor: shared row->Detection logic (geom-size fallback, best-first rows, site dedup, _locate/_height_agl) extracted to detector._RowResolver, used by both; OnnxDetector gains infer_rows() (grab+preprocess+run, no telemetry) which IS the worker's engine, so preprocessing cannot diverge. run_mission.py: spawns the worker (start_new_session, log ~/detect_worker.log, atexit terminate) or REUSES one whose file is fresh (<5s) = no double-spawn camera fight after a SIGKILLed runner; FileDetector.preflight waits <=30s for fresh output + frame-size check, camera_ok:false in the payload = camera dead vs file stale = worker dead. mission.py UNTOUCHED (poll interface preserved; SITL regression unaffected). Also fixed: ort.set_default_logger_severity(3) kills the /sys/class/drm warning (bench_models.py + OnnxDetector); basestation summarize() 'drops' now excludes ok:false (the flagged over-count). UNVERIFIED (no-commands rule), user must run: py_compile all of uno_q/; board dry-run of the split (worker spawn, preflight, staleness warn on kill -9 of worker, detection latch); set_default_logger_severity exists in ort 1.28 (API from model memory, VERIFY on first board run, symptom = AttributeError at startup); the 2026-07-29 laptop 6/6 OnnxDetector test predates this refactor and is STALE, re-run it plus a FileDetector variant (fake worker file) before flight. Consequence for model choice: with the pump no longer blocked, yolo26s's 1518ms stops being a safety argument and becomes only a cadence/coverage cost; interval_s stays as the worker --interval (default 1.0).
2026-08-01 (Reyansh/laptop) MODEL-SIZE VERDICT **REVERSED** by the user, and he is right. My "no" assumed the detection is only ever used as a CENTROID to fly to. User's actual plan: estimate puddle AREA from the detection box plus a height measurement, and size the Bti dose from it. Under that plan box QUALITY is load-bearing, not incidental, so mAP50/mAP50-95 buy something real and a bigger backbone can be worth its latency. New position: MEASURE FIRST, do not decide from either of our arguments. New files for that: training/export_variants.py (laptop; exports stock PRETRAINED yolo26s/m to ONNX at imgsz 640 purely for timing, COCO weights so their detections are meaningless, only the architecture/op-mix/shape transfer) + uno_q/bench_models.py (board; same byte-identical letterbox as detector.py, warmup then median/min/max, reports preprocess vs inference vs TOTAL and an x-slower ratio). The number that decides it is TOTAL, not fps, because mission.py is single-threaded and TOTAL is how long poll() blocks the MAVLink pump; compare it to detector.interval_s=1.0.
2026-08-01 (Reyansh/laptop) **AREA-BASED DOSING: DESIGN CONFLICT, NOT YET RESOLVED** (surfaced by the user's dosing plan; nothing implemented). Six problems, all load-bearing: (a) TF-Luna range is 0.2-8m but detection happens at SURVEY altitude (default 15m), where the Luna cannot read, so "area from the box + TF-Luna height" cannot work as stated at detection time; (b) mission.py DELIBERATELY does not re-detect during descent ("close-range frames unreliable, RUN1 spotcheck"), so there is no detection at any altitude the Luna can measure; (c) that leaves rel_alt (above HOME) as the only height available at detection, which is the AGL-datum error already flagged in TODO 10f; (d) a bounding BOX overestimates the water area of any non-rectangular puddle, and the error is unbounded (an L-shaped or diagonal puddle can be a fraction of its box); dataset v2 HAS polygons for ~3001 of 3881 val labels but ultralytics dropped them because we train a DETECT model, so segmentation is the honest route to area and is a different training run; (e) camera_geom.py has no area helper, only point offsets (ground_offset) and full-frame footprint; the correct area is not w_px*h_px*scale^2 because tangent-space scaling is nonlinear away from the image centre; (f) the dropper is a FIXED-dwell gate, so a variable dose means a variable dwell, which needs the granule flow rate from the TODO 3 bench test. RESOLUTION OPTIONS (pick before building anything): re-detect once at low altitude with a Luna-valid height (contradicts (b), needs a new decision + SITL work), or accept rel_alt-based area at survey altitude with the datum error documented, or descope to a fixed dose and report area as an ESTIMATE in the log/dashboard only. This must be settled before it is claimed in docs/01 or to a judge.
2026-08-01 (Reyansh/laptop) SERVO SILICON CORRECTION (user challenged with a datasheet, correctly): the STM32U585 DOES have hardware PWM timers, and nothing in this project's record ever claimed otherwise. The blocker was never the chip. It is (1) the Arduino UNO Q ships a ZEPHYR core and the stock Arduino Servo library does not build for it, so the pulse train needs an implementation written against Zephyr's PWM API + devicetree rather than Servo.h, and (2) the Linux side has to reach that sketch across the Bridge, which is TODO 12 and BLOCKED on the Serial1 contradiction. Plus the unverified 3.3V-into-MG90 logic threshold. Recorded because "the UNO Q cannot do servo PWM" would be a FALSE compressed version of this decision and would fail truth rule 8 on re-reading.
2026-08-01 (Reyansh/laptop) FULL-REPO READ (fresh session bootstrap, read-only, nothing executed beyond git per standing rule). One new MINOR finding: basestation/app.py summarize() reports drops = len(all 'drop' events) INCLUDING ok:false failed gates, inconsistent with the post-TODO-10 vocabulary where only actuated gates count as treatments (dashboard tile filters d.ok !== false; mission_end carries dropper.succeeded). Impact low: index.html never reads the summary's drops field (it counts from events), so only a direct /api/missions consumer over-counts. Fix when convenient = count ev['e']=='drop' and ev.get('ok', True) in summarize(). Everything else re-checked on this pass held up: DROP settle split ordering, _stopped() fallbacks, detector _fired-before-treatment dedup (intended: abort never retries a site, README 4.2), _at_wp alt access safe (GLOBAL_POSITION_INT sets lat+rel_alt together).
2026-08-01 (Reyansh/laptop) SERVO CHANGED SG90 -> MG90 (user: metal gears, better precision). Every SG90 mention in the repo renamed (README.md, docs/01, uno_q/dropper.py x3, PROJECT_STATE x2); Build Log.txt has 2 more but is user-maintained so it was FLAGGED not edited. Open VERIFYs recorded in POWER MAP: exact variant (MG90S vs MG90D), mass (metal gear is heavier, weigh it against the ~650g payload budget), stall current vs the XY-3606 (higher than SG90; no verified datasheet number, measure on the TODO 3 flow test).
2026-08-01 (Reyansh/laptop) SERVO SIGNAL SOURCE RE-EXAMINED at user request ("power it through the arduino directly, not the pixhawk unless there is a valid reason") and KEPT ON THE PIXHAWK, because there is one. Full four-step why is in POWER MAP and in uno_q/dropper.py's module docstring; the short version is that the Arduino route needs a Zephyr PWM implementation that does not exist plus the Bridge that TODO 12 is blocked on, while the Pixhawk route needs no new code at all, 14 days from the deadline. Separately, the user's stated premise ("the servo is powered by the external 5V module so the 3.3V GPIO should not be an issue") addresses POWER, which was never the objection: servo power has always come from the XY-3606 on BOTH routes. The objection is (a) the missing firmware and (b) LOGIC LEVEL, 3.3V GPIO into a servo whose input-high threshold no consulted datasheet states. Recorded so this is not re-litigated from a bare verdict (truth rule 8). Reversible: if the user still wants the Arduino route, the cost is the Zephyr PWM sketch + resolving TODO 12 + a scope check on the pulse.
2026-08-01 (Reyansh/laptop) ALL PEER-REVIEW FIXES IMPLEMENTED (TODO 10 (a)-(h), 1 critical + 4 major + the minors), file-by-file record in TODO 10 above. Three of them changed behaviour that SITL previously proved, so SITL is a BLOCKING regression gate before any of this flies: (1) DROP now settles before the gate opens, (2) the runner catches signals and exceptions and commands RTL, (3) a failed gate is recorded as ok:false and is no longer counted as a treatment anywhere (log, dashboard, predict score). NOTHING WAS RUN: per the standing 2026-08-01 rule the assistant executed no commands on the laptop or the board this session beyond git, so every one of these fixes is UNVERIFIED CODE. Do not treat TODO 10 as closed until 10-VERIFY passes.
2026-08-01 (Reyansh/laptop) MODEL SIZE QUESTION (user: is yolo26s/m worth it at 2 fps?): NO, and the reason is that fps is not the binding constraint, coverage is. At 15m survey alt with the 60deg placeholder FOV the along-track footprint is ~6.5m, so 2.05 fps supports up to ~13 m/s of survey speed, far above anything this aircraft will fly; the detector already throttles itself to 1 fps deliberately (interval_s=1.0) because the mission loop is single-threaded. The real limit on detection quality is recall 0.70 on frame-filling sheet water, which is a DATA failure mode (documented in the run2 spotcheck) that a bigger backbone does not fix. Cheaper wins in order: dataset v2 nadir/frame-filling images (TODO 9), then measuring HFOV, then int8 quantisation if speed ever does bind. IF the question is revisited, do NOT guess the fps cost: export a pretrained yolo26s to ONNX and benchmark it on the board first (no training needed for a speed number), then decide.
2026-08-01 (Reyansh/laptop) PEER REVIEW of da64b13 (Raghav's TODO 11/13/14 + servo decision), multi-agent: 6 subsystem readers + 6 review lenses -> 46 candidate findings -> 3-lens adversarial refutation (spend limit truncated the verify pass at 38 of ~138 votes; the rest re-derived by hand from the code). Verdict: the ARCHITECTURE is sound and mission.py/missionlog.py contracts are upheld; SITL-proven state machine untouched; predict.py + camera_geom.py maths check out (24 geometry checks are real identity tests, not tautologies; the vfov-tautology and letterbox-clamp findings were REFUTED 3/3). Confirmed defects -> TODO 10 (a-h) above: 1 CRITICAL (no exception/signal containment around Mission.run: an ssh drop or any raise kills the loop mid-descent, no mission_end, no RTL command; ArduPilot's guided setpoint timeout is the only backstop), 4 MAJOR (drop fires while still descending because the zero-velocity setpoint is eaten by the 0.2s setpoint rate limiter; servo pulse widths unvalidated at construction; construction-time initial-close failure swallowed so a dead dropper still flies and logs phantom "treated" events that also halve predict.py's revisit score; detector geometry uses configured frame size against actual frame pixels), plus doc/state contradictions (dropper.py module docstring still states the SUPERSEDED "STM32 side, settled" verdict and cites uno_q/sketch_bridge/ which does not exist; uno_q/README.md Files table still calls OnnxDetector/ServoDropper stubs, omits the 4 new files, and section 8 lists all 3 completed items as open while recommending the dead STM32 route; POWER MAP still said "Servo signal = UNO Q GPIO" -> FIXED in this commit per truth rule 8/9 since it is a wiring instruction). Also: 3 .DS_Store binaries committed and .gitignore has no rule. NOT reviewed by execution: nothing was run on the user's machine or the board this session (user restriction 2026-08-01); SITL/predict/test_camera_geom re-runs remain user-run.
2026-08-01 (Reyansh/laptop) RULE EXTENDED (user): assistant runs NO commands on the user's laptop or the UNO Q without explicit per-instance permission; git pull/push are pre-authorised. Supersedes the narrower 2026-07-29 board-only rule. Deliverable format: batch every command the user must run into one block at the end of the reply.
2026-07-27 (Reyansh/laptop) SERIAL4/5 roles swapped: user physically wired Luna to #4 lines / UNO Q to #5 lines during rebuild; decided to keep the wiring and swap SERIAL4_PROTOCOL(9)/SERIAL5_PROTOCOL(2) instead of re-soldering. Rationale: electrically identical (both 3.3V 115200), fewer joints, and SERIAL5's suspected boot noise now faces pymavlink (junk-tolerant parser) instead of the Luna. Setup file edited; push pending next USB session; TODO 5 boot-noise sniff rescoped to SERIAL4 TX.
2026-07-27 (Reyansh/laptop) VIN near-miss postmortem -> two standing rules added to CLAUDE.md truth rules: (8) decisions keep their load-bearing WHY in PROJECT_STATE, bare verdict = unverified, re-verify before acting, why is never dropped in compression; (9) hardware actions verify the governing spec from datasheet/docs/meter first, never model memory. Trigger: "5V pin NOT VIN" was recorded without rationale; VIN powering (7-24V, real spec) almost adopted; actual blocker (VIN power disables USB VBUS out -> camera dead; Arduino staff: unsupported) only caught because user challenged. POWER MAP gained a VERIFY-BEFORE-WIRING checklist (UBEC 5V/6V jumper, XY-3606 polarity, OLED VCC/I2C levels, TF-Luna batch pinout, ESP32 3V3 budget, power module output).
2026-07-26 (Reyansh/laptop) TODO 13 SITL end-to-end PASS: laptop SITL + sitl_test.py --record, happy path (1 drop rng 2.98m) + dropout drill (abort up, 0 drops) both PASS recording real-mission JSONL (32+28 lines, 0 bad); dashboard renders both flights, cross-flight persistent site = 1 (same puddle latched twice). BUG FOUND+FIXED in static/index.html: reload()/flight-change ran stats() before render(), but the persistent-sites tile needs the projection render() fits -> tile showed '-' for the first 15s after page load (masked in earlier fake-data test by the poll's second reload). Fix = reorder render() before stats(); verified <=1s now. Laptop sim_vehicle/xterm launch gotcha recorded in SESSION CONTINUITY (direct-binary recipe works).
2026-07-26 (Reyansh/laptop) TODO 13 laptop test PASS (assistant-run in in-app browser, scratch data dir, Flask from training/.venv 3.1.3): gen_fake_mission via real MissionLog incl injected-clock mission ids; /api/missions summaries exact; bad-id + %2f traversal + no-site-meta all 404; per-flight filter scopes stats/table (persistent tile '-' single-flight = by design); layer toggles verified by canvas pixel sampling; tooltips incl persistent-site ring text; site-image background (georef json + png) draws dimmed under data, checkbox auto-appears, escape attempt 404; truncated-last-line JSONL skipped, endless mission -> "in progress / interrupted"; page auto-picked-up 3rd flight via 15s poll; 0 console errors. KNOWN-NON-BUG: canvas doesn't repaint on EMULATED color-scheme flip (CDP emulation doesn't fire matchMedia change listener; listener code correct, real OS theme change fires it; CSS itself flips instantly). .gitignore += .claude/ (per-machine tool config).
2026-07-19 servo cap skipped; salvage only if servo misbehaves.
2026-07-20 handoff v3; ESP32 fw updated 6@60deg+up; sensors 7x plan.
2026-07-24 serial option B (split SERIAL4/5 cable) chosen over TF-Luna I2C; hexa X confirmed.
2026-07-25 project moved to /media/sleuther/Stuff/Robu AI Challenge; all parts arrived; frame assembly started; ESP32 powered from servo BEC (XY-3606); charger=HTRC B6 V2; fw compiles clean both modes; fake-mode GPIO4 TX guard added; pixhawk_full_setup.param created; local YOLO training adopted over Edge Impulse cloud; standing-water framing adopted; AVOID_MARGIN 1 / AVOID_DIST_MAX 1.5 sized to sensor range; failsafes confirmed; FENCE deferred.
2026-07-25 firmware upgraded to Pixhawk1-bdshot 4.7.0 stable; bdshot RPM notch found impossible for hexa (AUX5-6 NODMA); adopted in-flight FFT notch; motors stay MAIN.
2026-07-25 board factory-reset by user (no prereset backup; switches/modes reconstructed from screenshot+handoff). QGC bulk-load found to silently drop writes -> pymavlink push_params.py with per-write ack became the standard; all 55 params verified; RNGFND1_GNDCLR rename found. Full-param backup workflow live (pull_params.py).
2026-07-25 datasets: mosquito v4 excluded (no puddle class), v1 adopted (2.9k-image set, 5069 imgs incl splits, CC BY 4.0); merged 11725/3069; run1 started, restarted once to include mosquito (8min lost). Private git repo created (URL in PRIVATE.md), commit+push-every-change rule adopted; generated param files + datasets gitignored, pixhawk_full_setup.param tracked.
2026-07-25 PROJECT_STATE restructured: done-work pruned into this log, TODO section now reflects only remaining work.
2026-07-26 Mac bootstrap (Raghav): second machine online (darwin; NO training here, all training = Reyansh's RTX3050 laptop per Raghav); PRIVATE.md stub created from sample on Mac (values unfilled); stale yolo11n ref in V2-RETRAIN PLAN corrected to yolo26n.
2026-07-26 (Raghav/Mac) TODO 19 DRAFTED: docs/ set written from PROJECT_STATE + Build Log + code, 9 files: README index, 01 project writeup (problem/system/hardware/model/mission-safety/what-is-NOT-done incl vibration blocker stated openly), 02 crash postmortems (C1/C2/C3 root cause + bench PASS/FAIL table + the "2 of 3 = vibration corrupts alt estimate" through-line), 03 dataset citations (v1+v2 tables, rejected-sets table w/ reasons, leakage + no-pool-class methodology defences; URLs/BibTeX = FILL, CC BY 4.0 obligation), 04 video storyboard (12 shots w/ "what it proves" column, Plan A auto vs Plan B descope, capture checklist), 05 compliance (honest gap statement, confidence-tiered rule claims, cutoff warning, deployment roadmap; needs Raghav verification), 06 judge Q&A (~25 Qs incl the hostile ones: 3 crashes, 0.72 recall, do-you-meet-the-vibration-gate=NO, blind-descent subtlety), 07 evidence checklist (what to shoot + what each artefact proves + priority-5 if time short; says capture the FAILING vibration plot), 08 AI-authorship disclosure (incl where the assistant was WRONG: param renames, bdshot notch impossibility, the abort rule that would have aborted every descent). Rule applied throughout: FILL markers instead of invented URLs/metrics/reg claims.
2026-07-26 (Reyansh/laptop) TODO 13 base-station design settled: live web server on UNO Q (uno_q/basestation/); heatmap on blank schematic canvas (scale bar + north arrow) with OPTIONAL user-supplied georeferenced site image as background when present; data feed = mission.py appends per-mission JSONL event log (state changes, detections, drops, aborts, periodic fixes), base station reads files only; mission.py AUTO-LAUNCHES base station on DONE/STANDDOWN; ALL map layers (detections/treated/track/aborts/stats) checkbox-toggleable; accumulates site history ACROSS missions with per-flight filter (persistence framing). Open: stdlib-vs-Flask, cloudflared tunnel (explaining to user). Benchmarking run1 v8n ONNX on board REJECTED by user (pointless, yolo26n is the target).
2026-07-26 (Reyansh/laptop) TODO 13 BUILT: Flask adopted (user choice; one-time ~/venv pip install on board, offline after). Cloudflared installed by USER on the board -> https://drone.reysen.net (token /etc/cloudflared). New: uno_q/missionlog.py (JSONL schema single source; injectable clock), mission.py wired (recorder= optional param via _NoLog null-object, SITL tests untouched; events: start/fix@1Hz/state/detection/latch/drop/abort/end; cfg.basestation_cmd argv auto-launches server on DONE/STANDDOWN), uno_q/basestation/{app.py (read-only Flask: /api/missions,/api/events/<id|all>,/api/site_meta,/api/site_image), static/index.html (self-contained vanilla-JS dashboard: canvas heatmap w/ sequential blue ramp, layer checkboxes, persistent-site rings = detections <=5m across >=2 flights, per-flight filter + accumulation, stat tiles, tooltips, event table, scale bar/north arrow, light+dark, 15s poll), gen_fake_mission.py (2 fake flights via MissionLog w/ fake clock), README.md}. Site-image background = optional user-supplied north-up screenshot + corner-bounds site_image.json in data dir. Data dir ~/monsoonready_data (outside repo, nothing gitignored). Root README.md created (repo map); CLAUDE.md got basestation + laptop-SITL standing facts.
2026-07-26 (Raghav/Mac) Mac SSH: ed25519 keypair generated; UNO Q password NOT stored on disk (plaintext creds risk; project convention = user types passwords); PRIVATE.md filled except tailnet IP. ArduPilot Copter-4.7.0 SITL built on Mac (sibling shallow clone, matches board fw; RNGFND SIM type 100 verified in source). uno_q/ package created: mavlink_io.py (single-threaded pump, per-command ACK w/ retry incl FAILED-during-EKF-settle, compid 191, SET_MESSAGE_INTERVAL GLOBAL_POSITION_INT@5Hz + DISTANCE_SENSOR@10Hz), mission.py (state machine: TAKEOFF/SURVEY/APPROACH/DESCEND/DROP/CLIMB/ABORT_CLIMB/DONE/STANDDOWN; TARGET LATCHING at survey alt; dropout=abort-UP with acquired/expect-by-6m logic b/c TF-Luna blind above ~8m; EKF floor guard; pilot mode-flip => STANDDOWN never fight pilot), detector.py (FakeDetector; OnnxDetector stub), dropper.py (LogDropper; ServoDropper stub pending PWM source), sitl_test.py (scripted scenarios + param guard). SITL results: happy path PASS (1 drop @ rng 2.98m, survey resumes, RTL, disarm); dropout drill PASS (abort up, 0 drops, survey completes). sitl_rangefinder.parm mirrors TF-Luna 0.2-8m.
2026-07-26 (Raghav/Mac) docs/ REWRITTEN to house style after user rejected v1 as "instructions to me and Reyansh" not documentation. STYLE RULE now binding on all repo docs: match esp32_obstacle_avoidance/README.md = numbered sections + --- separators, tables for anything tabular, ASCII diagrams, real commands with real expected output, design-notes + troubleshooting sections, reference-prose voice. NO task-list voice, NO per-person assignments, NO status/progress columns inside docs; unknown values = bare "TBD" (was "FILL: <person> to do X"); remaining work lives in PROJECT_STATE TODO only. Same rewrite applied to uno_q/README.md (added state-machine ASCII diagram, MissionConfig table, abort-condition table, SITL transcripts, troubleshooting table). Content/facts unchanged, voice+format changed.
2026-07-26 (Raghav/Mac) NOTED laptop TODO-13 design dependency on MY file: base station wants mission.py to append per-mission JSONL events (state changes/detections/drops/aborts/periodic fixes) + auto-launch base station on DONE/STANDDOWN. NOT implemented by Mac (TODO 13 claimed by laptop, "Raghav do NOT start it"); whoever owns the hook must decide - flagging so it does not fall between machines.
2026-07-26 (Reyansh/laptop) Raghav's JSONL-hook flag RESOLVED: mission.py recorder hook + basestation_cmd auto-launch implemented laptop-side the same day (see TODO 13 BUILT entry above; rebase crossed his flag). uno_q/README.md conflict resolved keeping Raghav's house-style rewrite, missionlog/basestation rows added to its Files table; basestation README + new root README restyled to house style.
2026-07-31 (Raghav/Mac) TODO 11 pixel->ground DONE: uno_q/camera_geom.py (nadir pinhole; ground_offset scales in TANGENT space not pixels; camera_to_ned rotates by heading+mount_yaw; letterbox_to_frame undoes the detector's 640 letterbox; footprint_m for survey-leg spacing; calibrate_fov = tape-measure procedure). 24 unit checks PASS (uno_q/test_camera_geom.py). OnnxDetector now takes geom= + mount_yaw_deg=, extracts BEST ROW (was max-conf-only), locates box centre, and DEDUPS ON SITE not on drone position (same puddle from 2 positions = 1 target). Degrades to nadir if geom None or heading/rel_alt missing (never raises mid-mission). HFOV IS UNMEASURED: camera_geom.DEFAULT_HFOV_DEG=60 is a placeholder marked VERIFY; offset error is PROPORTIONAL to FOV error; runner omits geom unless --hfov-deg given.
2026-07-31 (Raghav/Mac) SERVO PWM SOURCE DECIDED = PIXHAWK, not UNO Q. Chain: Linux soft-PWM jittery -> planned STM32-via-Bridge -> RESEARCH FINDING: stock Arduino Servo lib does NOT support Zephyr cores (UNO Q is Zephyr), so STM32 route needs a board-specific PWM impl. Pixhawk already has hardware PWM outputs, already powered/wired/talking MAVLink to us; motors occupy MAIN1-6 so an AUX output is free; AUX5-6 NODMA blocks bidir-DShot ONLY, not ordinary PWM servo. => dropper.PixhawkServoDropper (MAV_CMD_DO_SET_SERVO via new MavIO.set_servo, 800-2200us guard, closes gate on construction in case a crashed run left it open, bridge/link failure logged NEVER raised into the state machine). Bridge-based ServoDropper kept as blocked alternative. WIRING CHANGE: servo SIGNAL now from a Pixhawk output pin, NOT UNO Q GPIO; servo POWER unchanged (XY-3606). PARAMS NEEDED: SERVO<n>_FUNCTION=0 (Disabled) or DO_SET_SERVO is ignored, + SERVO<n>_MIN/MAX bracketing the two pulse widths. CHANNEL NOT CHOSEN (default 9 = AUX1, user to confirm free).
2026-07-31 (Raghav/Mac) TODO 12 BLOCKED, plan may need rework: UNO Q docs CONFLICT on Serial1. User manual says D0/D1 = PB6/PB7 = USART1 = `Serial1` for the JDIGITAL header, AND ALSO says "The router claims the hardware serial port Serial1 ... Do not attempt to open Serial1 in your own code". Arduino_RouterBridge README: "Bridge object is defined over an UART port routed by the zephyr core, FALLING BACK TO Serial1 if the core does not provide it". => whether D0/D1 is usable for the Pixhawk depends on whether this core build gives the Bridge a dedicated UART (LPUART1/Serial2) or falls back to Serial1. NOT RESOLVABLE FROM DOCS, must be tested on the board. If Serial1 is claimed, the SERIAL4/5-to-D0/D1 wiring plan is dead and the fallback is a USB-serial adapter on the powered hub (hub already needed for the camera). Byte-shovel sketch NOT written pending this.
2026-07-31 (Raghav/Mac) TODO 14 DONE: uno_q/predict.py, recurrence scoring over the same JSONL the base station reads (read-only, does not touch basestation/). Deliberately NOT a rainfall model: scores score = flights_seen x recency(half-life 14d) x 0.5-if-treated, clusters detections/drops/aborts within 5m (running-mean centre), verdicts single/recurring/persistent (>=3 flights AND >=7d span). Every term defensible, nothing fitted, no train/test leak possible. Verified: 2 curated fake flights (finds the 1 persistent site, agrees with dashboard), 12 random flights seed 7 (top site 4 flights/7.8d), and a REAL SITL --record flight.
2026-07-31 (Raghav/Mac) TODO 13 Mac-side part DONE: uno_q/run_mission.py onboard runner (OnnxDetector+PixhawkServoDropper+MissionLog+basestation_cmd wired; --dry-run refuses to arm, --no-drop swaps LogDropper, waypoint file lat,lon; MavIO now takes baud= for the serial link). Did NOT touch basestation/ per laptop claim. REGRESSION: both SITL scenarios still PASS after the mavlink_io/detector/dropper edits.
2026-08-09 (Raghav, primary source) FOUR CORRECTIONS + submission context:
(1) TF-LUNA OVER WATER: **DOES NOT WORK, AND NEVER WILL** (user, settled, do not re-litigate or re-test). TODO 6 (basin bench) is therefore CLOSED-BY-VERDICT, not pending. CONSEQUENCE: descend-OVER-puddle is DEAD as a design; descend-BESIDE is the only route, using lateral_offset_n_m/_e_m in MissionConfig (already implemented, default 0, now must be set non-zero). NEW OPEN DESIGN QUESTION RAISED TO USER, NOT YET ANSWERED: descending beside the pool also puts the GATE beside the pool, so how the granules actually reach the water is undecided (candidates: short low-altitude translate over the water after arresting the descent on ground-referenced height, or a ballistic/offset release, or an outrigger on the hopper). Do NOT claim "drops into the water" in docs until this is settled.
(2) OBSTACLE RING WAS DISCONNECTED FOR THE TEST FLIGHT (user): the VL53L0X ring/ESP32 was unplugged before flying because it was not working during the previous night's bench tests. So log 37 characterises the airframe WITHOUT the ring; the ring has still never been verified in the air or against the FC, and its bench fault is undiagnosed.
(3) MOTOR DIRECTION correction to the 2026-08-08 blocker: NOT all six spinning the same way; the direction of THREE was reversed. AMBIGUITY FLAGGED TO USER (asked, unanswered at time of writing): whether that means the fix has been APPLIED (three phase-swapped, directions now alternate correctly = flyable) or three were FOUND wrong. Treat flyability as UNCONFIRMED until he answers.
(4) SUBMISSION GATE (user): a live demonstration video must be recorded BEFORE the submission is uploaded, and judges are met ONLINE and only IF stage 1 is passed, which requires a working, flying aircraft. So the open items are not documentation caveats, they are stage-1 blockers; prioritise anything that stands between the current state and a filmable flight.

PROP MATERIAL, ASKED 2026-08-10 (carbon-nylon vs ABS 1045): RECOMMENDATION = carbon-nylon, but NOT before the competition submission. Reasoning: this project's documented failure mode is VIBRATION (crash #1 a nut backing off, crash #3 vibration corrupting the altitude estimate into a 47 m climb), and a glass/carbon-filled nylon blade is stiffer, so it holds its designed pitch under load instead of flexing and flapping, which is a genuine vibration source. It is also more durable and marginally more efficient. THREE HONEST CAVEATS, none of which I can quantify from a verified source: (a) BALANCE DOMINATES MATERIAL - an unbalanced carbon-nylon prop is worse than a balanced ABS one, so buy a prop balancer with them or the upgrade can backfire; (b) stiffer blades transmit more shock to motor bearings and the frame in a strike, and cut people rather than slapping them, which matters on a machine flown near judges; (c) carbon-nylon is typically slightly heavier. THE TIMING ARGUMENT IS THE DECIDING ONE: log 37 PASSED the vibration gate on the current ABS props (VibeZ median 7.5 vs <15), so the aircraft has a flight-proven prop configuration RIGHT NOW. Swapping material changes the airframe's dynamics and invalidates that evidence, requiring a fresh hover-and-check-log cycle nobody has time for. So: fly ABS through the submission, buy carbon-nylon as the post-submission upgrade, and bring it forward ONLY if clipping or VibeZ gets worse. Availability in 1045 from the approved Indian suppliers is NOT verified - check Robu/FlyRobo before assuming.

**2026-08-10 EVENING FLIGHT: THE 4.5 MINUTE "ENDURANCE" IS AN ARTEFACT OF THE CURRENT SENSOR, NOT THE BATTERY.** Flight ended on a LOW BATTERY CAPACITY (mAh) trigger while the pack read ~11.8 V on BOTH the FC and a multimeter, i.e. ~3.93 V/cell, roughly 65-70% charged. The arithmetic is conclusive: log 37's counted burn rate is 1990 mAh/min, and 4.0 min x 1990 = 7960 mAh against BATT_CAPACITY 8000. The FC's phantom mAh counter reached the pack's rated capacity at almost exactly four minutes and terminated a flight that had most of its energy left. THIS ALSO INVALIDATES TODAY'S ENDURANCE MEASUREMENT - the stopwatch number is real but it timed an artificial cutoff, not the pack. NOTE FOR THE RECORD: earlier param dumps showed BATT_LOW_MAH=0 and BATT_CRT_MAH=0, which would mean no mAh failsafe exists; the flight proves something capacity-based DID fire, so those dumps are stale or another mechanism is in play. VERIFY the mAh-failsafe params from the new log's own PARM records before changing anything. NEW HYPOTHESIS FOR THE TRUE CONSTANT, stronger than the earlier 17.0 guess and cleanly explaining the wrong value: 90.6866 is the module's "90 A" RATING typed into QGC's AMPS-PER-VOLT field. For a 90 A full-scale sensor on the Pixhawk's 3.3 V input the correct figure is 90/3.3 = 27.3 A/V. Correction ratio would be 3.32x (true consumed today ~2700 mAh); the rival 17.0 gives 5.33x (~1680 mAh). DECIDED BY MEASUREMENT, NOT ARGUMENT: charger mAh returned divided by the FC's reported consumed for this flight gives the ratio directly. Measurements ordered before charging (per-cell balance-lead voltages expire on charge): all three cell voltages, rested pack voltage, and the log's consumed figure for this flight alone.

**2026-08-10 LOG 39 (the evening flight; log 38 is NOT it, it is a 405 KB stub. LASTLOG.TXT said 40; 39 is the 11.7 MB file timestamped 18:53).**
GOOD NEWS FIRST, AND IT IS REAL: **VERDICT PASS.** VibeZ median 7.4, max 13.1, and **clipping +0** against log 37's max 37.2 and +16. Hover ThH 0.370-0.397, GPS 10-11 sats. The airframe is healthy and the historic vibration blocker is not biting. Nothing about the airframe stopped this flight.
**MY 3.3 V SATURATION CHECK WAS WRONG AND HAS BEEN REMOVED.** It declared log 39's 143 A "IMPOSSIBLE" for PERVLT=17 while the aircraft was demonstrably flying. The 3.3 V analog-input ceiling was my assumption, never read from a datasheet, and it produced a false alarm in the one tool whose job is to be trusted about airworthiness. Replaced with a check that assumes no hardware at all: counted consumption exceeding BATT_CAPACITY (log 39: 8376 mAh counted from an 8000 mAh pack) proves the scaling is wrong and proves any battery failsafe fired on arithmetic rather than on the cells. LESSON, same class as the PRX1_TYPE and hardcoded-1900/1000 bugs: do not encode a guessed hardware constant as a hard verdict.
**THE FINDING THAT MATTERS, AND IT IS NOT A CALIBRATION PROBLEM.** Log 37 flew PERVLT=90.6866 -> 1990 mAh/min, 167 A peak. Log 39 flew PERVLT=17 -> 1764 mAh/min, 143 A peak. PERVLT changed by 5.33x; the reported current changed by 1.13x. Had the reading tracked the constant, log 39 would have shown 373 mAh/min and 31 A. **The reported current is essentially INDEPENDENT of BATT_AMP_PERVLT**, so no value of that parameter will fix it and the whole "which constant is correct, 17 or 27.3" line of reasoning is moot. Two candidate explanations, UNRESOLVED and not decidable from logs: (a) the current sense path is faulty (open, shorted or the module's current output dead) so the pin reads something fixed and large regardless; (b) one of the two PARM values was not actually in force during its flight, since check_log takes the LAST PARM record in a log and a mid-log change would mislead it. DECISIVE BENCH TEST, 30 seconds, props off, disarmed, motors stopped: read the reported current at zero load. True idle draw is under ~1 A; tens of amps at zero throttle proves the sense path, not the constant. `./python tools/bench.py battery`
USER'S CELL MEASUREMENTS, POST-FLIGHT: 3.95 / 3.94 / 3.97 V, resting pack 11.9 V. Max spread 0.03 V = a WELL-BALANCED, healthy pack, which independently clears the battery of blame. ~3.95 V/cell resting is roughly 65-75% state of charge (LiPo resting-voltage-to-SOC is nonlinear, so treat as approximate), i.e. about 2000-2800 mAh actually used against 8376 counted, an error around 3-4x. FLIGHT TIME 4.5 min was NOT endurance: it was the phantom counter reaching 8000.

**2026-08-10 CURRENT SENSOR SOLVED, AND ENDURANCE IS NOW A MEASURED NUMBER. Charger returned 2279 mAh against 8376 counted.**
RETRACTION FIRST, because a wrong claim sat in this file for one message: the entry above saying "the reported current is essentially INDEPENDENT of BATT_AMP_PERVLT" and "no value of that parameter will fix it" is **WRONG and withdrawn**. It came from a bug I introduced in check_log.py the same afternoon: the tool took the LAST PARM record in a log, and log 39's PERVLT=17 was written at t=758s, 131 s AFTER the motors stopped at t=627s. **Both flights actually flew at PERVLT=90.6866.** Verified by timestamping every PERVLT record against the throttle window in both logs. check_log.py now resolves every battery parameter to its value AT MOTOR START and separately prints anything changed afterwards, so this class of error cannot recur silently. Same lesson a third time today: state the evidence's TIME, not just its value.
THE ARITHMETIC, ALL CONSISTENT: over-count ratio 8376/2279 = **3.68x**. Correct **BATT_AMP_PERVLT is about 24** (raw ratio gives 24.7; allowing 3-5% charger inefficiency gives 23.7, so 23-25 is the honest band, and 24 is a sound value to fly). This also confirms the earlier reading of the fault: 90.6866 was the module's **90 A rating typed into QGC's amps-per-volt field**, and the theoretical figure for a 90 A full-scale sensor on a 3.3 V input is 90/3.3 = 27.3, close to the measured 24.
**REAL PERFORMANCE, measured not modelled**: 2279 mAh over 285 s of motor time = **480 mAh/min**, i.e. **28.8 A hover current** and **16.7 min endurance on a full 8000 mAh pack, 13.3 min to a 20% reserve**. The independent momentum-theory estimate made before any of this was 22-34 A for a 2.5 kg AUW. It predicted the answer. The airframe was never the problem and never drew a kilowatt.
**SAFETY, ACT BEFORE THE NEXT FLIGHT: BATT_MONITOR was set to 0 after landing** (log 39, same moment as PERVLT->17). 0 disables the battery monitor entirely, so there is currently NO voltage sensing and NO battery failsafe of any kind on the board. It must go back to 4 and the board must be REBOOTED for a BATT_MONITOR change to take effect. Unclear whether this was deliberate (silencing the phantom failsafe) - ask the user before assuming.
STILL WORTH DOING, lower priority now: the zero-load current reading (`./python tools/bench.py battery`, props off). One flight total cannot separate a scale error from an offset error, and a residual BATT_AMP_OFFSET would still distort low-current readings even with PERVLT correct.

**2026-08-10 TOOLS REFACTOR: ONE TOOL PER AREA OF EXPERTISE (user's instruction, and it is now a standing rule in CLAUDE.md).**
NEW `tools/mavlink_link.py` - a LIBRARY, no CLI, refuses to run as a script. Holds the four things every tool must get right: port/baud resolution across Linux AND macOS, autopilot targeting (the ESP32 at compid 195 is the reason), stream rates a SiK link can carry, and ack matching. WHY THIS MATTERED MOST: these lived inside wiring_check.py, so bench.py, flow_test.py and push_params.py all imported a 623-line PASS/FAIL test just to open a serial port. Importing a test to get a library is backwards and coupled the wiring check to the param push. wiring_check.py is now 490 lines and is a wiring VERDICT only.
NEW `tools/parameters.py` - get / set / push / pull / merge. REPLACES AND DELETES push_params.py, pull_params.py, make_complete_params.py, and bench.py's getparam/setparam. There were THREE separate copies of "write a value and check the echo" and only one checked for a silently CLAMPED value; now there is one, `write_param()`, and everything uses it.
`tools/bench.py` is probes only: mode / battery / failsafe / gps / rng.
TWO OPEN AUDIT ITEMS CLOSED IN PASSING, both from tools/AUDIT_2026-08-08.md:
- pull backup overwrite: raw dumps are now `board_dump_<timestamp>.param`, so a bad pull (board half awake, link dropping) can no longer overwrite the last good snapshot with a short one. param_dumps/* is gitignored so keeping every pull is free. Also warns explicitly when fewer params arrived than the board reported, instead of writing a silently incomplete "backup".
- merge truncation: `make_complete_params.py` wrote `str(int(float(new)))` for every non-float param type, so a fractional override such as 0.14 on a param QGC typed as an int was written to the loadable file as **0**. Silent, and exactly the kind of thing that gets loaded and flown. Fixed: integer-ify only values that really are integers, and print a NOTE when an override is fractional but the dump types it otherwise.
NEW in parameters.py: a NEEDS_REBOOT table. `set BATT_MONITOR 4` now says out loud that nothing changes until the board is rebooted. Explicitly documented as NOT exhaustive - ArduPilot marks many parameters this way and there is no way to ask the board which.

2026-08-10 BATT_MONITOR=4 and BATT_AMP_PERVLT=24 are WRITTEN AND ECHOED on the board; PERVLT re-read as 24 after a retry. BATT_MONITOR still needs the REBOOT to take effect. For the record because the tool's own wording confused the user and could confuse anyone: **BATT_MONITOR 4 = "Analog Voltage and Current", which is the WORKING setting and the value both flights actually ran on. 0 is the one that means no sensing**, and 0 is what the board was left at after landing on 2026-08-10. Two tool fixes from this exchange: (a) the NEEDS_REBOOT note for BATT_MONITOR read "no sensing at all until rebooted", which parses as "you just set it to no sensing" rather than "the change is inert until restart"; reworded. (b) `parameters.py get` asked ONCE, so a dropped request printed "does the parameter exist on this firmware?" and accused the user of a typo - which is exactly what happened on the first PERVLT read-back, with the second identical command succeeding. It now retries 3 times and distinguishes a lost packet from a wrong name.

**2026-08-10 BATTERY MONITOR FULLY VERIFIED ON THE BENCH, THREAD CLOSED.** After reboot with BATT_AMP_PERVLT=24 and BATT_MONITOR=4: **12.62 V and 0.14 A at idle**, pack connected, props off, disarmed, sustained over ~2 minutes. Reads: (a) 12.62 V is 4.207 V/cell on a full 3S, so BATT_VOLT_MULT=10.8025 is CORRECT and the failsafe thresholds (LOW 10.8 / CRT 10.2) mean what they say; (b) 0.14 A is the FC + GPS + SiK + receiver at rest, so **BATT_AMP_OFFSET=0 is correct and there is no offset error hiding under the scale error**; (c) it is NOT 0.00 A, which is the reading that would have meant a dead sense line, so the current path is genuinely sensing. The monitor is now trustworthy for the first time in this project. Remaining uncertainty is only in the 3.68x ratio's own precision (charger inefficiency puts the true PERVLT somewhere in 23-25); the next full-pack flight refines it for free by the same charger cross-check.
Small tool fix from this run: bench.py let Ctrl-C raise, printing a pymavlink traceback that looks exactly like a crash at the end of a run that worked perfectly. It now exits cleanly. Ctrl-C is the normal way to end these probes, since they all run until --seconds expires.

**2026-08-11 (user) SATURDAY 2026-08-15 IS THE GOAL, AND THE GOAL IS FULL AUTONOMY.** Today is Tuesday 2026-08-11, four days out. The target for Saturday is the COMPLETE AUTONOMOUS LOOP flown by the aircraft - survey, detect, drop - recorded in one continuous take and submitted the same day. This SUPERSEDES the earlier 'plan B' call (piloted flight plus a ground AI demo), which had been reached by applying a pre-committed cutoff to the unproven UNO Q link; the user has since set the goal explicitly and an explicit user instruction wins. WHY THIS IS TIGHT, recorded so nobody has to rediscover it: the video is a SUBMISSION GATE (2026-08-09 item 4 - the demo must be recorded BEFORE the submission is uploaded, and judges are only met if stage 1 passes), and the shoot day IS the deadline day. ATTEMPTS: 2-3 (user, 2026-08-11) - a failure costs a pack recharge, a few hours, and the day has room for that, so a mid-take failure is RECOVERABLE. THE ONE HARD BLOCKER IS TODO 7, the UNO Q <-> Pixhawk D0/D1 link, which has never worked. Autonomy cannot exist without it, so it is the critical path and must be proven AT HOME BEFORE SATURDAY, not debugged in the field. FALLBACK: if the link is still unproven when the camera is set up, shoot the piloted flight plus the ground AI demo and state plainly on camera which parts are autonomous. A failed take is recoverable within the 2-3 attempts; ARRIVING WITH THE LINK UNPROVEN IS NOT, because debugging it in a field burns the attempts you came to use. Judges reward a clear-eyed limitation and punish an overclaim they catch.
**THE PLAN-A/PLAN-B CUTOFF ALREADY FIRED, by this project's own pre-committed rule.** WEEKEND VIDEO recorded a HARD CUTOFF: "if the link is not proven by Friday night, shoot the piloted version, because a failed autonomous attempt mid-take is an unusable recording and there are no cuts allowed." That Friday was 2026-08-07; TODO 7 (UNO Q<->Pixhawk D0/D1) is still UNSTARTED and BLOCKED on a docs contradiction that needs board bench time. Therefore **PLAN B IS THE VERSION TO SHOOT: piloted flight + ground AI demo on a laptop screen**, per docs/04's Plan B descope column and DESCOPE LADDER rung (a). This is reversible only by an explicit user override, not by optimism about the link.
**HANDOVER.md WAS STALE AND SAID SO ITSELF WHILE BEING IT** (fixed 2026-08-11): its LIVE THREAD asked the next session to request a `tools/bench.py battery` result that had ALREADY been taken and recorded, in this very file and in commit ea16e3d (12.62 V, 0.14 A at idle, BATT_AMP_OFFSET cleared, thread closed). LESSON, and it is the same class as the PRX1_TYPE param-file bug: **a handover's LIVE THREAD must be rewritten in the SAME commit that closes the thread**, because a stale handover reads as current and the next session acts on it. Its own header says exactly this; the discipline failed at the moment of closing the thread, which is precisely when it is hardest to remember.

## VIDEO SHOOT DATE FIXED + TODAY'S PRIORITY CALL (2026-08-11 ~16:30)
**SHOOT = SATURDAY 2026-08-15, AT THE FARMLAND** (user). That is the same day as the competition deadline, so there is NO second attempt and no post-shoot work window. Four days, of which Tue evening is a field window and Wed/Thu/Fri are bench days.
**ANOTHER ENDURANCE FLIGHT IS REJECTED as today's use of the pack**, and the reason is that the question it would answer is already answered: with BATT_AMP_PERVLT corrected to 24 and verified (12.62 V / 0.14 A idle, offset clear), endurance is MEASURED at 16.7 min full pack / 13.3 min to a 20% reserve, hover 28.8 A. The video take is 5-10 min, so the margin is roughly 2x and a repeat buys one confirmation of a number that is not close to binding. Cost of the repeat is the whole evening plus a pack cycle.
**THE ARDUINO/UNO Q LINK (TODO 7) IS ALSO NOT TODAY'S WORK**, and this is not a fresh judgement: Plan B was pre-committed when the link missed its recorded Friday deadline, so the video does not depend on it. Reopening it now trades a certain deliverable for an uncertain one four days out.
**THE ACTUAL CRITICAL PATH IS THE DROPPER**, because it is the only subsystem the video must show that HAS NEVER WORKED ONCE: the gate opens the wrong way (needs the mechanical horn reseat 60 deg on the spline THEN the pulse swap in uno_q/dropper.py, in that order) and the granule flow rate has never been measured (tools/flow_test.py), so the variable-dose seconds are proportional to nothing. In a single unedited take, a gate that fails is the failure the camera is pointed at. This work needs the laptop + Pixhawk on USB + a --wiggle, i.e. roughly 30-60 min of BENCH time, and therefore CANNOT be started in a 15-minute window before leaving; a half-reseated horn is worse than an untouched one because the gate can end up resting OPEN over a loaded hopper.
**IF THE AIRCRAFT FLIES TODAY IT SHOULD FLY THE VIDEO, NOT A TEST**: a timed dress rehearsal of the docs/04 running order (takeoff, survey pattern, hover at drop height, land) proves the take fits inside the measured endurance and rehearses the two-person one-camera choreography, which is the part with no software backstop. Endurance data falls out of it for free via check_log.py.

## PLAN A RESTORED BY USER OVERRIDE (2026-08-11 ~16:45)
**THE PLAN B PROMOTION IS REVOKED.** User, explicitly: full autonomous detect-and-drop is the GOAL for the Saturday 2026-08-15 farmland shoot, and piloted flight + Arduino/ground detection is the BACKUP. This restores TODO 134's original framing, which the 2026-08-11 morning session had overwritten by treating the recorded Friday cutoff as already fired. Per CLAUDE.md an explicit user contradiction wins over any recorded decision; nothing else does. TODO 7 (UNO Q<->Pixhawk link) is therefore back ON the critical path, not out of scope.
**PORT BUDGET KILLS THE NAIVE DONGLE FALLBACK (user, correcting the assistant 2026-08-11).** The assistant proposed buying a USB-serial adapter as same-day insurance against D0/D1 being claimed by the router, WITHOUT checking where it would plug in. There is nowhere: the UNO Q has ONE USB-C port, it goes to the ETZIN EPL-1207CC splitter, the splitter's single USB-A socket is occupied by the B525 camera, and the camera cannot be given up because onboard detection IS the demo. So the dongle fallback is not one part, it is TWO (a hub downstream of the splitter's A port, plus the adapter), each unverified on this board, plus weight. That changes its cost enough that it is no longer obvious insurance.
**CONSEQUENCE: D0/D1 MUST BE TESTED ON ITS OWN MERITS, TONIGHT, AND IT NEEDS NO PARTS.** D0/D1 is the STM32 USART1 on the JDIGITAL pin header, not a USB port, so the primary plan never touched the USB budget in the first place. The correct sequence is test first, and only shop if it fails.
LESSON (assistant error, same family as the earlier ones in this file): a part recommendation is a WIRING claim and falls under truth rule 9. "Buy X" is not safe advice until it is checked against where X physically connects on THIS build. The port budget was recorded in this very file and was not consulted.
**TODO 7 PROBE SKETCH WRITTEN 2026-08-11: uno_q/sketch_serial1_probe/.** Physical loopback test, jumper D1->D0, writes 0x5A on Serial1 and checks whether it returns. Verdict is on LED_BUILTIN and NOT on a serial monitor, deliberately, because the monitor may itself be routed through the peripheral under test: SOLID = Serial1 is ours and the D0/D1 plan lives; FAST BLINK = opened but nothing returned, which is either the router holding the pins or a jumper not seated (re-seat before believing it); SLOW BLINK = setup() never completed. Probe byte is 0x5A for alternating bits, so a stuck-low or shorted line cannot fake a pass the way 0x00/0xFF could; the RX buffer is drained before the write so boot noise cannot be read as an echo. SCOPE OF A PASS, stated so it is not overclaimed: it proves the UART is reachable from sketch code and unclaimed, NOT that the Pixhawk link works, which needs the byte-shovel plus real SERIAL5 wiring. UNVERIFIED AND THE LIKELY SNAG: the exact toolchain for getting a sketch onto the UNO Q's STM32 (App Lab vs arduino-cli on the board) is NOT recorded anywhere in this repo and the assistant has not confirmed it; if upload is the thing that blocks, that is a separate problem from the Serial1 question and must not be read as a FAIL of this test.
**D0/D1 ARE ALREADY WIRED TO THE PIXHAWK (user, 2026-08-11).** The SERIAL MAP's split-cable plan (pin4 TX5 -> UNOQ D0, pin5 RX5 <- UNOQ D1) is BUILT, not pending. TODO 7's "must be tested on the board" is therefore a SOFTWARE question only; no wiring work remains before it can be answered.
**ASSISTANT ERROR, HARDWARE-DAMAGING, CAUGHT BY THE USER: the first probe sketch told him to jumper D1 to D0 for a loopback.** With the Pixhawk connected that ties the Pixhawk's TX5 output and the UNO Q's TX output onto one net, i.e. two push-pull drivers in contention whenever they disagree. This is truth rule 9 missed AGAIN in the same session as the USB-port miss: a test procedure that touches pins is a wiring instruction, and the wiring state was recorded in this file and was not consulted. The rule that would have caught both: before recommending any physical action, read what is already connected.
**PROBE REWRITTEN AS LISTEN-ONLY, WHICH IS ALSO A BETTER TEST.** ArduPilot streams heartbeats on any MAVLink-configured serial port unprompted, so the Pixhawk is already sending into D0 and the sketch needs no jumper, no parts, and never transmits (so it cannot contend with TX5). It listens 3s and reports on LED_BUILTIN: SOLID = MAVLink framing byte (0xFD v2 / 0xFE v1) seen, so Serial1 is unclaimed AND the wire is good AND the baud is right, D0/D1 plan LIVES; FAST BLINK = bytes arriving but no framing byte, so the UART and wire work and the suspect is SERIAL5_PROTOCOL/SERIAL5_BAUD (wrong baud looks exactly like this); SLOW BLINK = zero bytes, which is router-holds-Serial1 OR SERIAL5 unconfigured OR TX5 not landing on D0, three causes this test cannot separate, so check the params first because that is free. A pass proves the pins are USABLE, not that the link is flight-worthy; that still needs the byte-shovel plus a soak.

**2026-08-11 TODO 7 PROBE REDESIGNED, because the old one could not be READ.** User confirmed the UNO Q is SEALED INSIDE THE AIRFRAME and is reachable over SSH. The existing probe reported its verdict only on LED_BUILTIN, which nobody can see with the aircraft shut: a verdict you cannot read is not a verdict. It also only LISTENED, so it could never prove the direction that actually matters for autonomy (UNO Q -> Pixhawk commands).
NEW DESIGN, and it answers from the far end of the wire: the sketch TRANSMITS a real MAVLink HEARTBEAT on Serial1 as MAV_COMP_ID_ONBOARD_COMPUTER (191). If the link works the PIXHAWK sees a new MAVLink node, which is readable from the LAPTOP over USB with the airframe shut, via the new `./python tools/bench.py nodes`. A row for sys 1 comp 191 IS the pass. The ESP32 already proves the channel: it shows up the same way at compid 195.
TRANSMITTING IS SAFE AND IS **NOT** THE RETRACTED LOOPBACK IDEA. D1 is the UNO Q's TX feeding the Pixhawk's RX5, which is what the wiring is for. The retracted hazard was a JUMPER tying D1 to D0, shorting the UNO Q's TX to the Pixhawk's TX5 output (two push-pull drivers fighting). Nothing in the new sketch does that; do not fit that jumper.
THE LED IS KEPT as a second, independent channel reporting the RECEIVE direction only, because the two channels fail independently and that is what localises a fault: nodes PASS + LED solid = both directions work, TODO 7 SOLVED; nodes PASS + LED blinking = our TX arrives but TX5->D0 does not, so ONE BROKEN CONDUCTOR, not software; nodes FAIL + LED solid = we hear the Pixhawk but D1->RX5 is the suspect conductor; nodes FAIL + LED slow-blink = Serial1 is not ours or SERIAL5 is unconfigured, check params first because it costs nothing.
IF OPENING Serial1 KILLS THE LINUX BRIDGE, THAT IS THE ANSWER, NOT A CRASH: it would mean the Bridge really does fall back to Serial1, the two cannot coexist, and the byte-shovel architecture (Linux -> Bridge -> STM32 -> Serial1 -> Pixhawk) is impossible as drawn. SSH is unaffected either way; it runs over the network on the Linux side and never touches this UART.
NO INVENTED WIRE FORMAT: the heartbeat's 21 bytes were generated by pymavlink on the laptop and pasted in, and the sketch's CRC-16/MCRF4XX was verified against pymavlink's own output (reproduces 0xC6AE) with seq-bumped frames parsed back by a real MAVLink parser, 4/4, before being written into C. crc_extra=50 was READ from pymavlink's message map, not recalled. Bumping the sequence byte requires recomputing the CRC; a stale CRC is dropped silently by the receiver and would look exactly like a dead wire.
STILL UNKNOWN AND IT IS THE NEXT QUESTION: how a sketch is BUILT AND UPLOADED to the STM32 from the UNO Q's Linux side over SSH. Nothing in this repo records the toolchain. Discover it before writing any more sketch code.

**2026-08-11 BOARD FACTS, MEASURED NOT ASSUMED (user ran the discovery over SSH).** `arduino-cli` IS installed at /usr/bin/arduino-cli, and /opt holds `arduino` and `openocd`, so an STM32 build+flash path exists on the board itself; no laptop toolchain is needed. Linux-side serial ports are **/dev/ttyS0..S3 ONLY** - no ttyACM, no ttyUSB. Camera CONFIRMED WORKING: B525 HD Webcam at /dev/video0 and /dev/video1 (plus the Venus codec nodes at video2/video3, which are not cameras). Home directory holds loose copies of some project scripts and models (uno_q/, bench_models.py, spotcheck_onnx.py, best.onnx, the yolo26n_*.onnx size variants, yolo26s/m); USER SAYS THE REPO IS NOT CLONED THERE, so treat anything on the board as a possibly-stale copy and never as the source of truth.
**NEW AND POTENTIALLY ARCHITECTURE-CHANGING: the /dev/ttyS0..S3 shortcut has never been tested.** The recorded plan routes Linux -> Bridge RPC -> STM32 sketch -> Serial1 (D0/D1) -> Pixhawk, which stacks THREE unknowns (Bridge works, Serial1 unclaimed, byte-shovel correct). But if the Pixhawk's SERIAL5 TX lands on any Linux-side ttyS, all three vanish and pymavlink just opens the device. The recorded claim "UNO Q D0/D1 = STM32 USART1 (PB7/PB6)" implies it cannot, but THAT CLAIM HAS NEVER BEEN VERIFIED AGAINST THE BOARD and is exactly the kind of unchecked inherited fact this session is auditing. `uno_q/find_pixhawk_uart.py` written to settle it: strictly READ-ONLY, listens on every ttyS/ttyUSB/ttyACM at 115200 and 57600, counts MAVLink framing bytes, and names the port if one carries MAVLink. Costs one command and either deletes the entire sketch route or confirms it.

**2026-08-11 BOARD AUTO-SYNC SERVICE (user asked for it): uno_q/deploy/board_sync.sh + monsoonready-sync.service.** Polls `git fetch` every 10s and fast-forwards when main moves. WHY IT WAS NEEDED: the board carried loose scp'd copies of a few scripts, so "what is on the board" and "what is in git" were different things and nobody could say how different; every debugging session began by wondering whether the board had the current file. The board is now a mirror of main.
THREE DESIGN RULES, each tested locally against a real bare repo before shipping, not just reasoned about: (1) **FAST-FORWARD ONLY.** If the checkout has commits the remote lacks it STOPS and logs loudly rather than merging or resetting, because a `git reset --hard` puller silently destroys work that exists nowhere else. Verified: a board-local commit survived and the loop refused to pull. (2) **SELF-UPDATE.** If a pull changes board_sync.sh itself, the running copy is stale, so it exits 0 and systemd's Restart=always launches the new version; without this the board would keep running whatever shipped first forever. Verified: exit 0 with the right log line. (3) **IT NEVER RUNS WHAT IT PULLS.** Syncing code and executing code are different jobs, and a puller that restarts services turns a bad commit into a flying aircraft's problem.
OPERATIONAL NOTES: logs to journald (`journalctl -u monsoonready-sync -f`). On a PHONE HOTSPOT IN THE FIELD it polls every 10s and costs mobile data for nothing, so stop it before leaving (`sudo systemctl stop monsoonready-sync`). Repo path /home/arduino/monsoonready. The loose copies already in ~ are NOT deleted and the .onnx models are gitignored so they stay put; run scripts from ~/monsoonready/uno_q/ from now on and treat anything loose in ~ as stale. AUTH: a private repo needs credentials that survive non-interactive fetch (credential.helper store after one manual clone, or a deploy key); a public repo needs nothing.

**2026-08-12 FULL-REPO READ (fresh session bootstrap, read-only, nothing executed beyond git). FOUR CONTRADICTIONS FOUND, one of them flight-affecting.**
(1) **RUN_MISSION.PY STILL CARRIES THE OLD, NOW-INVERTED GATE PULSES, AND THIS IS THE SERIOUS ONE.** `run_mission.py` hard-codes `--servo-closed-us` default **1000** and `--servo-open-us` default **1900**, the pre-2026-08-10 values. dropper.py's reversal made 1600 = CLOSED and **1000 = OPEN**. So the flight runner, launched as documented with no servo flags, would (a) drive the gate the OLD clockwise direction the user rejected, and (b) command **1000us as its resting CLOSED position, which under the new calibration is the OPEN position** - the pre-arm "initial close" would open the gate over a loaded hopper and leave it there. This is the identical bug class already recorded for wiring_check.py ("wiring_check used to hard-code 1900/1000 of its own, so changing the dropper's travel silently did nothing"); wiring_check.py and flow_test.py were both fixed to read `_Gate.DEFAULT_CLOSED_US/_OPEN_US`, run_mission.py was missed. FIX = make its two defaults read the same class constants. UNFIXED as of this entry (nothing was changed this session beyond this record).
(2) dropper.py's module docstring still states "Pixhawk servo rails are 5 V logic" as a settled fact. That claim was **RETRACTED AS UNVERIFIED on 2026-08-06** (see POWER MAP): the outputs originate at 3.3V MCU pins and whether they are buffered to 5V on THIS board has never been checked. A live file asserting a retracted claim is exactly what truth rule 8 forbids; the docstring must be corrected to match, and the surrounding decision does NOT change (the load-bearing reasons were the two missing firmwares, not the logic level).
(3) SERIAL4/5 ARE SWAPPED IN THREE DOC LOCATIONS relative to the SERIAL MAP. Root README.md line 34-35 says the UNO Q is on SERIAL4 and the TF-Luna on SERIAL5; mavlink_io.py's docstring says "SERIAL4 via the STM32 byte-shovel"; uno_q/README.md line 4 says the loop runs over SERIAL4. The map (final, after the 2026-07-27 swap) is **SERIAL4 = TF-Luna, SERIAL5 = UNO Q**. Harmless to code (nothing reads these strings) but it is wiring prose, and TODO 7 debugging is about to be done against exactly these port numbers.
(4) CHECKED AND CLEAN, recorded so nobody re-audits them: basestation `summarize()` now filters `ok:false` out of its drop count (the 2026-08-01 flagged over-count is fixed, app.py:72); wiring_check.py and flow_test.py both source the gate pulses from dropper.py; check_log.py resolves battery params at motor-start and no longer carries the retracted 3.3V ceiling check; parameters.py `write_param` is the single write-and-echo path.

**2026-08-12 SERVO ORIENTATION CHANGED AGAIN (user), SO EVERY RECORDED GATE PULSE IS VOID. NEW TOOL: tools/servo_jog.py.**
The horn/servo mounting on the gate has been changed, so the 2026-08-10 pair (closed 1600 / open 1000) no longer describes the hardware and must not be used or quoted. Written to replace them by measurement: `./python tools/servo_jog.py`, an interactive jogger on ch9 that moves the gate by a typed amount and direction (`+15`, `-7.5`, `+30us`, `=1600`, bare `+`/`-` for one --step), marks the two positions with `c` and `o`, and prints them at exit.
WHAT IT CAN AND CANNOT KNOW, recorded because a future session will otherwise read "shows the current angle" as a measurement: an MG90 has NO position feedback and the Pixhawk cannot read a servo's angle, so NOTHING in this system can measure where the horn is. The PULSE WIDTH is the only real number. The displayed angle is arithmetic, (us - reference)/US_PER_DEG, with US_PER_DEG=10.0 from the 2026-08-10 bench observation (900us swung the horn 90 deg on this servo). That ratio survives a remount because it is a property of the SERVO; what a remount changes is where zero is, which is why the tool's reference is simply wherever it started and is re-zeroable with `z`. If a commanded 90 deg does not look like 90 deg, the ratio is wrong for this unit: pass --us-per-deg, do not invent compensating pulse numbers.
DIRECTION CONVENTION KEPT FROM THE BENCH: increasing pulse width swings the horn CLOCKWISE AT THE SPLINE. Whether clockwise now opens or closes the gate is exactly what the new mounting decides and exactly what the by-eye run establishes.
DESIGN CHOICES WORTH KEEPING: starts at 1500us (mid travel) because with an unknown mounting no position is known safe and mid travel is least likely to be hard against a stop, with --start to begin somewhere known instead; keeps the 800-2200us guard from mavlink_io.py; warns on any single move over 45 deg, since driving a metal-gear servo into a mechanical stop at full speed is how the gears this servo was chosen for get stripped; and DELIBERATELY DOES NOT CLOSE THE GATE ON EXIT, because after a remount the tool has no idea which end "closed" is - it prints the final position loudly instead and says to check by eye before loading the hopper. Requires HOPPER EMPTY (it drives to positions nobody has verified, half of which may be open) and SERVO9_FUNCTION=0, since ArduPilot acks ACCEPTED and moves nothing otherwise.
ONE-TOOL-PER-AREA JUSTIFICATION (the standing rule): this is not a second home for anything. bench.py is read-only probes and adding a servo mover would break its stated contract; wiring_check.py is a wiring VERDICT and its --wiggle is a pass/fail cycle between two KNOWN pulses, not a search for unknown ones; flow_test.py measures grams per second and needs the pulses as an input. servo_jog.py is the tool that PRODUCES those pulses, and it is the only interactive positioner.
CONSEQUENCE STILL PENDING: when the user reports the new c/o values they must land in BOTH uno_q/dropper.py (DEFAULT_CLOSED_US/DEFAULT_OPEN_US) AND uno_q/run_mission.py, whose --servo-closed-us/--servo-open-us still hard-code the pre-reversal 1000/1900 instead of reading dropper.py (the live bug recorded in the entry above). wiring_check.py and flow_test.py already read dropper.py and follow automatically.

**2026-08-12 servo_jog.py GUARD REMOVED ON USER INSTRUCTION, AND A CLAMP HAZARD FOUND WHILE DOING IT.** Raghav's first jog run (MacBook, /dev/cu.usbmodem1101, Pixhawk on USB) walked 1500 -> 2070us fine and was then REFUSED at 2370 and 2570 by the tool's own 800-2200us check. User: remove it, new limits to follow. Done: servo_jog.py now refuses NOTHING and only warns. Two things deliberately NOT changed with it: (a) mavlink_io.PWM_MIN_US/PWM_MAX_US is still 800-2200 and still enforced at dropper.py construction and in MavIO.set_servo, because servo_jog sends MAV_CMD_DO_SET_SERVO directly and does not go through either path, so widening the FLIGHT guard stays a separate deliberate decision; (b) the tool now prints, at exit, whether the marked values fall outside that guard, since dropper.py would otherwise refuse to construct with them.
**THE HAZARD, which is the reason this entry exists: DO_SET_SERVO IS SUBJECT TO SERVO<n>_MIN/_MAX, so an out-of-window command can be ACCEPTED AND THEN CLAMPED**, leaving the servo somewhere other than the pulse width printed on screen. That would silently corrupt the very calibration the tool exists to produce, and it is invisible from the ack. servo_jog now READS SERVO9_MIN/_MAX at startup (read-only, no push, so it is inside Raghav's machine scope) and warns on every command outside them. OPERATOR RULE RECORDED IN THE TOOL: when that warning appears, believe the GATE, not the number; a gate that stops moving while the printed pulse keeps climbing has hit the CLAMP, not a mechanical stop. NOT INDEPENDENTLY VERIFIED from ArduPilot source that DO_SET_SERVO clamps to SERVOn_MIN/MAX; it is treated as a live possibility and warned about rather than asserted, which costs nothing either way. Also warns outside a 500-2500us band, explicitly labelled a typo catcher and NOT an MG90 spec (no datasheet consulted), plus a stall warning: buzzing and not moving = driven into a stop, back off, and that is now the only way this tool can damage hardware.
NOTE FOR WHOEVER FIXES THE PULSES: SERVO9_FUNCTION=0 is evidently already correct on the board, since the jog commands were ACCEPTED and moved the gate. No param push is needed for this work, which keeps it inside the standing "no param pushes from Raghav's machine" rule.

**2026-08-11 BOARD SUDO PASSWORD IS LOST (user), AND IT TURNED OUT NOT TO MATTER.** PRIVATE.md's UNO_Q_SUDO line is still the template's "password required (user types it; never ask for it)", so it was deliberately never recorded and cannot be recovered from this repo. NOT WORTH REFLASHING FOR: the only thing that wanted root was installing a systemd unit, and **a user-scope service needs no privilege at all**. Added uno_q/deploy/monsoonready-sync.user.service (`systemctl --user`, installs under ~/.config/systemd/user/) plus uno_q/deploy/README.md documenting three install routes in order of privilege: user service, user crontab with @reboot + flock, and only last the system service. USER-UNIT CONSTRAINTS ARE FORCED, NOT PREFERENCES: a user unit must NOT set User= (systemd refuses to load it), has no multi-user.target so it uses default.target, and drops the sandboxing directives because those only mean something when the alternative is running as root. REBOOT PERSISTENCE is the one real gap: a user service stops when the user's last session ends unless `loginctl enable-linger arduino` is set, and that may itself demand authentication; the crontab route is the fallback that needs no privilege of any kind. GENUINE PASSWORD-RECOVERY OPTIONS IF ROOT IS EVER ACTUALLY NEEDED, none of them cheap: another account already in the sudo group; a physical console (HDMI or serial) into recovery/single-user to run passwd, which means opening the airframe; or a reflash, which on 2026-07-28 wiped authorized_keys and changed both hostname and tailnet IP. Four days from the deadline, all three are worse than simply not needing root.

**2026-08-13 (Reyansh) BOARD REFLASHED, DRONE OPEN FOR THE LAST TIME, 1 HOUR.** Two days to the deadline, not four; the 2026-08-11 entries saying "four days out" are stale by two days.
**CRITICAL BUG FOUND AND FIXED IN THAT HOUR: run_mission.py would have EMPTIED THE HOPPER ON THE GROUND.** Its `--servo-closed-us` default was 1000 and `--servo-open-us` 1900, hard-coded, while dropper.py had been reversed to 1600 closed / 1000 open. So run_mission's "closed" WAS THE OPEN POSITION: the gate would swing open the instant the servo was initialised, before takeoff, and dump the entire Bti load. Fixed by importing PixhawkServoDropper.DEFAULT_CLOSED_US/DEFAULT_OPEN_US instead of repeating the numbers. THIS IS THE THIRD TIME the same class of bug has appeared (wiring_check's hard-coded 1900/1000, then this): any file that restates a hardware constant instead of importing it WILL drift, and the drift is silent until it is expensive. Grep for repeated pulse numbers before trusting any new gate code.
**uno_q/deploy/board_setup.sh written** for the post-reflash rebuild: idempotent, root-free, creates ~/venv and installs pymavlink pyserial numpy opencv-python-headless onnxruntime, then VERIFIES each import, the camera via v4l2-ctl, the serial ports, the repo and the model. It deliberately does NOT clone the repo (operator syncs separately) and does NOT copy the ONNX models, because they are gitignored and CANNOT ARRIVE BY GIT PULL - they must be scp'd from the laptop, and a fresh flash has none. opencv-python-HEADLESS specifically: the board has no display and the GUI build pulls X libraries that are not present.

**2026-08-13 models/best.onnx IS NOW TRACKED IN GIT (Reyansh asked why it was not, and the ignore rule was simply wrong for this file).** It was swept up by the blanket "training artifacts are regenerable" rule, which is true of the VARIANTS and false of the DEPLOYED model: reproducing best.onnx needs the exact dataset plus ~12h of GPU. THE RISK THIS CLOSED WAS REAL AND ACUTE: the file existed only on the owner's laptop and the board, the board had just been REFLASHED, so it was down to a SINGLE COPY two days before the deadline, and a dead SSD would have ended the project. It was also the one file the board could never obtain by git pull, which defeated the entire point of the auto-sync service and forced a manual scp into every recovery. 9.4 MB against a 31 MB repo is not a cost worth the exposure. Variants stay ignored and correctly so: yolo26s (37 MB) and yolo26m (79 MB) were rejected on measurement and are genuinely regenerable. board_setup.sh now looks for $REPO/models/best.onnx FIRST and treats a loose ~/best.onnx as a possibly-stale leftover.

**GROUND IS COMMON. NEVER ASK ABOUT IT AGAIN (user, 2026-08-13, after the assistant raised it more than once).** EVERYTHING on this aircraft is powered from the ONE battery through the PDB, so every ground is bonded by construction and a separate signal-ground wire is neither missing nor needed, on SERIAL5 or anywhere else. Any future "check the grounds are bonded" suggestion is WRONG BY CONSTRUCTION on this airframe: do not raise it, do not add it to a checklist, do not list it as a suspect when a serial link misbehaves. Suspect instead: SERIALn_PROTOCOL, SERIALn_BAUD, TX/RX swapped, or the peripheral itself.

**2026-08-13 ALL FIVE CRITICAL PARAMS VERIFIED ON THE BOARD, over the SiK radio (ttyUSB0/57600, so the aircraft was on battery and the UNO Q was powered): SERIAL5_PROTOCOL=2, SERIAL5_BAUD=115, SERIAL4_PROTOCOL=9, PRX1_TYPE=0, SERVO9_FUNCTION=0.** All correct, nothing to push. CONSEQUENCE: the Pixhawk side of the D0/D1 link is FULLY CONFIGURED, so if the UNO Q still cannot see MAVLink the fault is the wire or the UNO Q side, never the parameters. PRX1_TYPE=0 also confirms the parked ESP32 CANNOT block arming, which was the only way the abandoned obstacle ring could still hurt the demo flight.
**BOARD REBUILD AFTER THE REFLASH IS COMPLETE**: ~/venv has pymavlink, pyserial, numpy, cv2 and onnxruntime all importing, /dev/ttyS0..S3 present, and models/best.onnx (9.4 MB) arrived BY GIT PULL rather than scp, which is the tracked-model change paying off immediately on its first real use. Repo lives at ~/monsoonready-drone (NOT ~/monsoonready); board_setup.sh now derives the repo path from its own location so the name no longer matters.
**DISCONNECTED AT TEARDOWN AND MUST GO BACK BEFORE FLIGHT (user, 2026-08-13): GPS and RC RECEIVER.** Only telem radio, power, Arduino, TF-Luna, safety switch and buzzer were attached during this session, so any wiring_check run from this session will FAIL GPS and RC and that is expected, not a fault. Neither can be omitted: no GPS means no Loiter/AUTO and therefore no autonomous mission, and no RC means no manual abort.

**2026-08-13 ttyS SHORTCUT IS DEAD, BUT NOT FOR THE REASON THE TOOL CLAIMED.** All four /dev/ttyS0..S3 failed with `Could not configure port: (5, 'Input/output error')` - they could not be OPENED at all. find_pixhawk_uart.py counted zero MAVLink bytes and printed "NO MAVLINK ... that CONFIRMS the recorded claim that D0/D1 belong to the STM32", which was **a conclusion drawn from a failure mode the script never distinguished**. An unopenable port is the ABSENCE of evidence; only a port that opens and stays silent is evidence. Tool fixed to count unopenable attempts and report INCONCLUSIVE instead. WHAT IS ACTUALLY ESTABLISHED: those ttyS nodes exist in /dev but are not usable UARTs from userspace (no hardware behind them, or not pin-muxed), so **Linux cannot reach the Pixhawk directly and the STM32 sketch route is the only one left**. The D0/D1-is-USART1 claim remains UNVERIFIED either way; it just no longer matters, because the alternative is gone.
**TF-LUNA IS HEALTHY.** Constant 0.13 m on the bench with the aircraft on its legs, flagged OUT OF RANGE only because RNGFND1_MIN is 0.20. It is reading a real surface at a plausible distance; below-min on the legs is expected and is not a fault. One 1.0s dropout at stream start, not repeated.

**2026-08-13 UNO Q SKETCH TOOLCHAIN, MEASURED: FQBN `arduino:zephyr:unoq`, core `arduino:zephyr` 0.90.0 already installed, and arduino-cli sees the board on a NETWORK port (192.168.68.109), not a local serial one** - so uploads take `-p <ip>` rather than a /dev node. Build and flash both run ON THE BOARD over SSH; no laptop toolchain and no physical access are needed, which is why the sketch work did NOT have to happen while the airframe was open.
**IT IS A ZEPHYR CORE, NOT THE CLASSIC ARDUINO STM32 CORE, and that is load-bearing for TODO 7.** The whole Serial1 contradiction (user manual says the router claims Serial1; RouterBridge README says the Bridge uses a core-routed UART "falling back to Serial1 if the core does not provide it") is a statement about THIS core. USEFUL CONSEQUENCE: `arduino-cli compile` is itself a free test. If Serial1 is not exposed by the Zephyr core the build FAILS, and that answers the two-week-old question without flashing anything or touching the aircraft. A successful compile does not prove the pins work, only that the API exists; the flash plus `tools/bench.py nodes` is what proves the wire.

**2026-08-13 THE PROBE SKETCH COMPILES, SO `Serial1` EXISTS ON THE ZEPHYR CORE.** `arduino-cli compile --fqbn arduino:zephyr:unoq` succeeded: 63860 bytes (8% flash), 22848 bytes (8% RAM). This settles HALF the two-week contradiction - the core does expose Serial1 and the API is real, so the user-manual line "do not attempt to open Serial1 in your own code" is not enforced at compile time. IT DOES NOT SETTLE THE RUNTIME HALF, and one detail in the build log sharpens the risk: **Arduino_RouterBridge's singletons.cpp is linked in AUTOMATICALLY** (the sketch never includes it; the core/variant pulls it), so the Bridge object is constructed whether or not the sketch asks for it. That is exactly the collision the RouterBridge README implied with "falling back to Serial1 if the core does not provide it". Only flashing and observing decides it.
BUILD TIMING NOTE so nobody diagnoses a non-problem again: the FIRST compile takes minutes because Zephyr builds the whole RTOS core; the SECOND takes ~10s from `~/.cache/arduino`. A fast second run is the cache working, not a skipped build. User reasonably read the speed-up as "something went wrong the first time".

**2026-08-13 *** TODO 7 IS SOLVED. THE UNO Q TALKS TO THE PIXHAWK OVER D0/D1 -> SERIAL5. *** ** `tools/bench.py nodes` heard **sys 1 comp 191 MAV_TYPE_ONBOARD_CONTROLLER, 21 heartbeats in 20 s** alongside the autopilot's own 20. That is the programmed 1 Hz with no drops, so the link is not marginal. This was the two-week blocker on autonomous flight and it is gone.
**IT ALSO SETTLES THE DOCUMENTATION CONTRADICTION EMPIRICALLY: the router does NOT claim Serial1 at runtime.** The sketch opened Serial1 and transmitted while Arduino_RouterBridge's singletons were linked into the same binary, and the transmission arrived. The user manual's "the router claims Serial1 ... do not attempt to open Serial1 in your own code" is NOT enforced on core arduino:zephyr 0.90.0, and the RouterBridge README's "falling back to Serial1" did not happen here. Recorded as MEASURED BEHAVIOUR OF THIS CORE VERSION, not as a general truth: a core update could reintroduce it, so re-run the probe after any core upgrade.
UPLOAD RECIPE THAT WORKED, for the record: `arduino-cli upload -p 192.168.68.109 --fqbn arduino:zephyr:unoq <sketchdir>`, which prompts for the board's LOGIN PASSWORD and flashes over SWD via openocd + libgpiod bitbang (no USB cable, no physical access, aircraft closed). STM32U585, TrustZone disabled, RDP level 0, 2048 KiB dual-bank.
**WHAT IS PROVEN AND WHAT IS NOT, because the difference is the remaining work:** PROVEN = STM32 -> Serial1 -> Pixhawk (the TX direction). NOT PROVEN = (a) the RX direction, Pixhawk TX5 -> D0, which the sketch reports only on LED_BUILTIN and the airframe is now shut; (b) **Linux -> STM32 via the Bridge**, which is the half the mission actually needs, because the ONNX detector runs on LINUX and its drop commands must reach the Pixhawk. The current sketch never touches the Bridge. NEXT: a byte-shovel sketch that pumps Bridge <-> Serial1 in both directions, after which pymavlink on Linux opens the Bridge and the full loop closes.

## 2026-08-14 21:34 IST (FRIDAY NIGHT, T-MINUS ONE DAY)

**ESP32 OBSTACLE RING IS ON THE BUS. comp 195 CONFIRMED.** `tools/bench.py nodes --seconds 20` heard all three talkers: sys1 comp1 (autopilot, 5 hb), sys1 comp191 (UNO Q, 7 hb), **sys1 comp195 (ESP32, 5 hb)**. ROOT CAUSE of the earlier no-show was **ESP32 TX/RX SWAPPED at TELEM1**; user reversed them and it came up immediately. The drone has since been CLOSED, so this is proven-then-sealed: do not re-open to re-check it. Params were NOT the fault and were verified correct along the way: SERIAL1_PROTOCOL = 2, SERIAL1_BAUD = 115. PRX1_TYPE = 2 was set earlier this session and needed a reboot; the reboot has happened (the nodes run above is post-reboot).
CORRECT ESP32<->TELEM1 ORIENTATION, now measured rather than inferred, superseding any earlier prose: ESP32 GPIO17 (PIXHAWK_TX_PIN, Serial2 TX) -> TELEM1 **RX**; ESP32 GPIO16 (PIXHAWK_RX_PIN, Serial2 RX) <- TELEM1 **TX**. config.h already encoded this; the physical wire did not.

**THE ONLY THING LEFT ON THE AUTONOMY CRITICAL PATH IS LINUX -> PIXHAWK.** Restating precisely so it is not re-litigated: the ONNX detector runs on the UNO Q's LINUX side; its drop/guided commands must reach the Pixhawk; Linux cannot reach the Pixhawk directly (all four /dev/ttyS* fail to configure, `find_pixhawk_uart.py` INCONCLUSIVE 2026-08-13); only the STM32 has D0/D1 -> SERIAL5, and that path is proven in the TX direction only.

**TWO ROUTES, AND THE CHEAP ONE WAS NOT CONSIDERED UNTIL NOW.**
(A) **USB CABLE, UNO Q USB HOST -> PIXHAWK USB.** Gives Linux `/dev/ttyACM0` speaking MAVLink2 on the Pixhawk's SERIAL0 with NO firmware work, NO Bridge, NO byte-shovel. `MavIO.__init__` already takes a plain pymavlink connection string, so `MavIO('/dev/ttyACM0')` is a DROP-IN and every existing tool works unchanged. EVIDENCE IT IS FEASIBLE, not assumption: the USB camera already enumerates through a hub on that port, so the UNO Q's USB host mode is a measured fact. UNVERIFIED AND MUST BE CHECKED BEFORE RELYING ON IT: (i) a free port on the hub, (ii) the Pixhawk's micro-USB physically reachable with the airframe closed, (iii) a USB-A -> micro-B cable on hand, (iv) SERIAL0_PROTOCOL = 2 (ArduPilot default, but verify). RISK: nothing in ArduPilot objects to USB and battery power at once; this is how every bench session has been run all project.
(B) **BYTE-SHOVEL over Arduino_RouterBridge.** Still the fallback if (A) is physically impossible. BLOCKED ON A FACT NOBODY HAS YET: what the LINUX side uses to call the MCU's RPC methods. If there is no Python binding for the Bridge on the Qualcomm side, route (B) IS DEAD and only (A) remains, so that discovery must happen before any firmware is written.
BRIDGE API, from `bridge.h` on the board (partial, grep only): `class BridgeClass` with `bool begin(unsigned long baud = DEFAULT_SERIAL_BAUD)` (it calls `serial_ptr->begin(baud)` and writes a banner, so THE BRIDGE OWNS A SERIAL PORT and which one is not yet known), `bool is_started()`, `bool getRouterVersion(MsgPack::str_t&)`, `bool provide(...)` (signature truncated at line 224). `class RpcCall` carries `result()`, `isError()`, `getErrorCode()` and a read/write mutex pair. So it is **MsgPack-RPC, not a raw byte pipe**: a shovel would be MCU-side `provide("mav_write", ...)` writing to Serial1 and `provide("mav_read", ...)` draining it, with Linux polling. NOTE THE HAZARD: if `serial_ptr` turns out to BE Serial1, calling `Bridge.begin()` collides with the proven comp-191 path and would break TODO 7's result.

**NO TEST FLIGHT TONIGHT.** It is 21:34 and the user's own dark cutoff is ~20:00. Tonight is desk work; the ring, the link and the drop go unflown until Saturday morning, which must therefore start with a rehearsal, not with the recorded take.

**ROUTE A IS DEAD (user, 2026-08-14 evening): the UNO Q's hub has exactly one USB-A (camera) and one USB-C (power), no free port for a Pixhawk cable. ROUTE B (Bridge byte-shovel) IS THE ONLY PATH.** Supporting facts from the board: `lsusb` shows only root hubs + the B525 webcam, no ttyACM. SERIAL0_PROTOCOL = 2 verified (moot now, recorded so nobody re-checks). Bridge library facts: `bridge.h:151` `HardwareSerial* serial_ptr = nullptr;` and `:167` `serial_ptr = &serial;` inside a method taking a serial by reference, so WHICH UART THE BRIDGE OWNS IS DECIDED AT THE CALL SITE / SINGLETON, not hardcoded; `singletons.cpp` names the instance and is the Serial1-collision check. Examples on board: client, server, monitor, hci, udp_ntp_client. STILL UNKNOWN, blocks the shovel design: (a) which serial the Bridge singleton binds, (b) whether the reflashed Linux image has the router daemon running and any Python binding for calling MCU RPC. FIELD_CHECKLIST.md REWRITTEN for Saturday (was endurance-day content): tray+water back in (detection IS the demo), ring no longer "parked", stale PERVLT=17/105A prose removed, day opens with an UNRECORDED REHEARSAL FLIGHT since nothing has flown with the live ring, PRX1_TYPE=2, or the 560/1760 gate.

**2026-08-14 ~22:00 ROUTE B ARCHITECTURE UNCOVERED.** Board facts: (1) LINUX SIDE HAS A ROUTER DAEMON: `/usr/bin/arduino-router --unix-port /var/run/arduino-router.sock --serial-port /dev/ttyHS1 --serial-baudrate 115200` running as root since boot. So Linux client <-> unix socket <-> router <-> /dev/ttyHS1 <-> STM32 Bridge, msgpack-rpc end to end. (2) MCU SINGLETON: `BridgeClass Bridge(ARDUINO_ROUTER_SERIAL)` where `#ifndef ARDUINO_ROUTER_SERIAL / #define ARDUINO_ROUTER_SERIAL Serial1` — a FALLBACK. Whether the arduino:zephyr core overrides the define decides the Serial1 collision question; the core is NOT on the laptop (~/.arduino15 has only adb tools), so the grep must run on the board (which is also where the 2026-08-13 compile must therefore have happened). If the core does NOT override it, Bridge.begin() would grab Serial1 = D0/D1 = the Pixhawk wire and Route B collides with the proven comp-191 path; the empirical 21/21 clean heartbeats on 2026-08-13 (probe sketch never called Bridge.begin()) lean toward the core routing the Bridge elsewhere, but LEANING IS NOT KNOWING. (3) MCU API confirmed from bridge.h: `provide(name, func)` binds a callable (registers with router via BIND_METHOD first), `call(method, args...)` returns RpcCall with .result(out), `notify(method, args...)` fire-and-forget, `update()` pumps one request. Monitor is `BridgeMonitor<> Monitor(Bridge)` = RPC-tunneled, not a UART, so Monitor cannot collide with Serial1. (4) `examples/server/python/` DIRECTORY EXISTS on the board = the Linux-side client example; contents not yet read; pip greps found NO arduino/bridge/msgpack packages in system python or ~/venv, so whatever the example imports may need installing.
**VENUE CORRECTION (user): SATURDAY IS AT A FARM, NOT THE FIELD — dirt surface, much bigger. BOTH laptops are going (Linux primary, MacBook backup), reversing the MacBook-only rule from endurance day.** FIELD_CHECKLIST.md updated: farm section added (landing mat vs dust into motors/lens/lidars, laptop surface, shade for on-camera screens, lens cloth, mud footwear, farm water source question).

**2026-08-14 ~22:15 DROPPER GATE: THREE REAL BUGS FOUND AND FIXED after user reported the servo resting OPEN.**
(1) **COMMITTED SYNTAX ERROR: dropper.py held literal `<closed>`/`<open>` placeholders** (commit 347d89c "gate pulses from bench measurement" wrote the template text, not the numbers). Every import of dropper died at parse time: run_mission.py, wiring_check.py AND servo_jog.py were all dead. Fixed: DEFAULT_CLOSED_US=560, DEFAULT_OPEN_US=1760 (user's by-eye servo_jog marks, 2026-08-14). Fourth instance of the restated-hardware-constant bug class, and the first that was also a syntax error; py_compile now passes on dropper/mavlink_io/run_mission/wiring_check/servo_jog.
(2) **PWM GUARD EXCLUDED THE REAL CLOSED VALUE: mavlink_io PWM_MIN_US was 800, measured closed is 560** — PixhawkServoDropper would have raised at construction and every mission would abort pre-arm. Guard now 500-1800 (brackets measured travel 560-1760 with margin).
(3) **BOARD-SIDE CLAMP RISK: SERVO9_MIN was 800.** servo_jog's own docstring records that ArduPilot MAY clamp a commanded output to SERVOn_MIN/_MAX; if it does, "closed" stopped at 800us, 240us short. Param file now SERVO9_MIN=500, SERVO9_MAX=1800 (was 2200; nothing valid above open+40us), NEW SERVO9_TRIM=560 so any trim-emitting state parks the gate SHUT (old effective trim 1500 = 80% toward open). WHY THE GATE WAS OPEN: servo_jog deliberately does not close on exit (documented behaviour) and the user's session ended at the open mark; nothing has commanded the servo since. NOT claimed as trim emission; cause recorded as observed.
ALSO: **pixhawk_full_setup.param PRX1_TYPE 0 -> 2**: the file's own stated condition ("set back to 2 when the ESP32 is refitted AND transmitting") is met as of tonight's comp-195 confirmation; without this edit the next push would have DISABLED the ring (mistake #1 in the file's own history note). Channel truth: dropper is SERVO9 (AUX1, user-wired 2026-08-02); ch14 params on the board are dead leftovers. ON/OFF AUDIT of the full file done tonight: ARMING_SKIPCHK 0, FS_THR 1, BATT failsafes set, serials 1/2/4/5 correct, RNGFND1 Luna + RNGFND2 up-MAVLink, PRX1 2, AVOID_ENABLE 7, MOT_HOVER_LEARN 2, NTF display, fence deliberately off. GAP: BATT_VOLT_MULT/BATT_AMP_PERVLT are calibrated on the board but NOT asserted in the file; user is fetching both so the file can capture them (until then a factory reset silently loses the current-sensor fix).

**2026-08-14 ~22:45 PUSH DONE, WIGGLE RUN, ROUTE B CLEARED, FARM FACTS LOGGED.**
PARAMS: push 62/62 OK over SiK, incl SERVO9 MIN 500 / MAX 1800 / TRIM 560 and PRX1_TYPE 2. Calibration CAPTURED INTO THE FILE from the board: **BATT_AMP_PERVLT = 24, BATT_VOLT_MULT = 10.802477** (was QGC-only; a factory reset would have erased the current fix silently). NEW mAh failsafes added + to push: **BATT_LOW_MAH 1600 (20% left), BATT_CRT_MAH 800 (10%)** - meaningful only from a full-pack takeoff (counter resets at boot); voltage failsafes remain the real protection on partial recharges.
WIGGLE RESULT: 1760 ACCEPTED, first 560 NO ACK (SiK packet loss, not a fault), FINAL CLOSE 560 ACCEPTED -> gate commanded closed; visual + power-cycle boot-closed confirmation pending with user. NEW FAILS in the same run, all pre-existing hardware states now visible to the checker: (a) RING 4/6 sectors, DEAD s1=60deg s2=120deg (= the known dead ch2 chip + the intermittent ch5; ACCEPTED state, AVOID reads missing sectors as no-data, not clear); (b) UP-SENSOR 0 msgs despite 20/20 at bench diag - suspect its flaky power connector again; plan = power-cycle + re-run wiring_check, if still 0 FLY WITHOUT IT (it is optional, do NOT reopen the drone); (c) RC receiver ABSENT/UNHEALTHY with a dropout - TX state during the run UNKNOWN, asked user; if TX was ON this is a real intermittent link and must be debugged TONIGHT.
ROUTE B FULLY CLEARED, both unknowns resolved: (1) core arduino:zephyr 0.90.0 DEFINES ARDUINO_ROUTER_SERIAL via devicetree (zephyrSerial.h:152, ZARD_SERIAL_NAME(ZARD_SERIAL_INDEXOF(ARDUINO_ROUTER_PHANDLE))), so the Bridge singleton does NOT take Serial1 -> no collision with the proven comp-191 Pixhawk link; consistent with 2026-08-13's clean 21/21 heartbeats. (2) LINUX BINDING EXISTS: `arduino.app_utils` provides `Bridge.call(method, args...)` (examples/server/python/main.py uses it; dropper.py's _default_bridge_call guessed this import correctly). `import msgpack` fails in BOTH system python and ~/venv, so app_utils either vendors its serialization or ships elsewhere - locating the module + venv visibility is the LAST unknown before the shovel is written (mission venv must import BOTH pymavlink AND arduino.app_utils in one process; if the venv cannot see system site-packages that needs --system-site-packages or a path shim).
FARM/PACK FACTS (user answers, 2026-08-14 night): ONE flight pack total, charged overnight; charger runs on marketing-office mains; payload = SALT (plentiful, farm kitchen); NO funnel needed (hopper is a box with a hole, servo blocks the hole); battery is strap-buried in the airframe (not removable casually, no LiPo-bag transport); filming on Vivo X300 FE handheld (tripod optional); farm has water pump + verandah tables + first aid; dry dirt (no mud gear); cloth sheets = landing pad (weight the corners); torches instead of headlamp; all spare props go but stock is LOW - fly conservative; date-proof device has internet at the farm. FIELD_CHECKLIST.md rewritten as a flat tickable PACK LIST; VIDEO_SCRIPT.md WRITTEN (full narration, variant A autonomous / variant B piloted, staging list, salvage rules, post-take backup step).

**2026-08-14 ~23:15 BYTE-SHOVEL WRITTEN, all four pieces, protocol from primary sources (github.com/arduino/arduino-router + docs).** `arduino.app_utils` DOES NOT EXIST on the reflashed image (ModuleNotFoundError, system python AND venv) - the App Lab python runtime went with the reflash. The router daemon is still up, so the Linux side speaks msgpack-rpc STRAIGHT TO THE UNIX SOCKET: REQUEST [0,id,method,[params]] / RESPONSE [1,id,err,result] / NOTIFY [2,method,[params]]; providers register via `$/register` (that is what MCU Bridge.provide's BIND_METHOD does); router remaps msgids and routes by registered name; `$/setMaxMsgSize` exists. NEW FILES: uno_q/sketch_mav_shovel/ (MCU: provide mav_read/mav_write/mav_stats; loop() drains Serial1 into a 4KiB k_mutex-guarded ring so poll gaps lose nothing; payloads cross the RPC as BASE64 STRINGS deliberately - msgpack-python bytes=`bin` vs MCU MsgPack str-typed callbacks is a cross-stack mismatch not worth risking the night on; drops oldest + counts on overflow); uno_q/router_client.py (stdlib+msgpack RouterClient.call, needs `~/venv/bin/pip install msgpack`); uno_q/test_shovel.py (20s proof: prints comp-1 HEARTBEATs = RX direction proven, transmits comp-191 heartbeats = TX direction proven via laptop bench.py nodes; MAVLINK20 forced, verified 0xFD/21B locally; failure text points at SERIAL5 params + the never-tested TX5->D0 conductor); uno_q/mav_shovel_pump.py (full-time RPC<->UDP: binds 127.0.0.1:14556, mission connects MavIO 'udpin:127.0.0.1:14555' with ZERO MavIO changes; 50Hz poll = 3x serial-rate headroom; prints sketch stats every 10s). FLASHING THE SHOVEL REPLACES THE PROBE: comp 191 disappears from the bus until test_shovel/pump runs - expected, not a regression. Heartbeat encode/parse round-trip verified on the laptop venv. STILL OPEN TONIGHT: RC ABSENT/UNHEALTHY twice (TX on/off state unknown - USER ASKED), up-sensor 0 msgs (power-cycle retry pending), gate visual + boot-closed confirmation pending, push of BATT mAh/calibration params DONE 66/66.

**2026-08-14 ~23:30 RING IS DEGRADING IN REAL TIME SEALED: 2 dead sectors -> 3 (s4) -> 4 (s3) across three checks tonight, up sensor 0 throughout.** Real no-data in the stream (every OBSTACLE_DISTANCE carries all slots; SiK loss cannot fake it). Drone has been sealed + powered for hours; ring was 20/20 open and cool at bench diag -> heat degrading marginal connections/rail is the leading theory, unfixable without reopening. DECISION (user's pre-stated rule "if it doesn't work, disable"): **AVOID_ENABLE 7 -> 0 in the file** (flight ignores the ring), **PRX1_TYPE STAYS 2** (stream + dashboard + honest video; prearm satisfied because data still flows). Revert = one param at the farm.
**SiK DOWNLINK SATURATION EXPLAINS THE WEIRD HEARTBEAT COUNTS, do not chase them:** comp 191 heard 1/20s (probe still transmits 1 Hz - the SHOVEL WAS NEVER FLASHED, board commands failed on paths), comp 195 varied 16 vs 4. The 57600 SiK carries full telemetry + 104 OBSTACLE_DISTANCE/12s + everything else = frames drop randomly on the RADIO leg only. D0/D1 runs at 115200 direct and is unaffected.
**BOARD REPO PATH IS ~/monsoonready-drone (ls confirmed; ~/monsoonready DOES NOT EXIST), board IP now 192.168.68.110.** My board block failed: git pull ran in ~, sketch paths resolved against ~. All board commands must cd ~/monsoonready-drone first. msgpack 1.2.1 installed in venv OK.
**GATE: BOOT-CLOSED CONFIRMED by user after power cycle ("servo stayed shut"). SERVO9_TRIM=560 does its job; the dropper story is CLOSED.**
**RC: user dismissed the three ABSENT/UNHEALTHY+dropout results ("TX works we already know that"). Recorded as USER'S CALL, not resolved: whether the TX was ON during those runs was never answered. The farm checklist keeps the hard gate: RC must PASS with TX on before arming, because an RC failsafe mid-mission = RTL through the take.**
**ONE PACK REMINDER: it has ALSO been the bench supply all evening. Order tonight: shovel flash+test (needs the aircraft powered) -> UNPLUG -> charge overnight.**

**2026-08-14 ~23:50 *** THE LINUX -> PIXHAWK LINK IS PROVEN. THE AUTONOMY BLOCKER IS GONE. *** ** test_shovel on the board: 36,665 bytes RX in 20 s, sketch ring 0 dropped, HEARTBEATs parsed from sys1 comp1 AND comp195 (ArduPilot forwards the whole bus onto SERIAL5, so MavIO will see everything - a feature, and bandwidth is fine: ~1.8 KB/s of an 11.5 KB/s leg). TX: 399/399 bytes (19 heartbeats) written to Serial1 on the wire the probe proved into the Pixhawk on 08-13; final MAVLink-level TX proof = COMMAND_ACK round trip in uno_q/test_mission_link.py (NEW, read-only: pump + MavIO('udpin:127.0.0.1:14555') -> wait_ready -> setup_streams ACK = both directions at mission level; wait_ready RAISES on timeout, command_ack raises on no-ack - the test handles both). Unidentified (0,0)x35 msgs in the parse = likely boot-noise/parser artifacts, harmless, not chased. Flash recipe that worked AGAIN: compile+upload ON THE BOARD from ~/monsoonready-drone, upload -p 192.168.68.110 (self-IP network upload, openocd SWD).
**LOGISTICS SPLIT TONIGHT: the DRONE IS AT RAGHAV'S, user is at his own house with laptop+SiK. Consequence: the Friday-night LAPTOP blocks never ran, so AVOID_ENABLE=0 IS IN THE FILE BUT NOT ON THE BOARD (board still 7) and no bench-nodes TX check happened. BOTH are now FIRST-ACTIONS in the farm checklist (3b: parameters.py push; 4b: bench nodes while the pump runs). The aircraft was POWERED at Raghav's for the test = the single pack was draining; user told to power down + charge overnight there. Mission-start runbook written into the checklist (pump terminal + run_mission --conn udpin:127.0.0.1:14555 --model models/best.onnx --camera <verify with v4l2-ctl>; --model default is a stale pre-reflash path).**

**2026-08-15 ~00:10 *** MISSION STACK LIVE, TWICE. BOTH DIRECTIONS PROVEN AT MAVLINK LEVEL. *** ** test_mission_link through the pump: heartbeat, stream-request COMMAND_ACK (= TX proven end to end), mode STABILIZE, armed False, rangefinder 0.14 m, live NED velocity. The exact objects that fly (MavIO on 'udpin:127.0.0.1:14555') did it. PUMP STATS DECODED so nobody panics at the farm: `dropped=606448` was FROZEN across every print - it is history from the idle window between test_shovel and the pump start (nobody drained the ring, it dropped-oldest as designed); rx grew ~2.5 KB/s with ZERO new drops while pumped. Throughput ~2.7 KB/s down of an 11.5 KB/s leg with streams up. up=86->172 B = the two SET_MESSAGE_INTERVAL commands per test run, exact byte match.
**LAST HIDDEN BLOCKER FOUND AND KILLED AT MIDNIGHT: NO WAYPOINTS FILE EXISTED IN THE REPO and run_mission REQUIRES one (format: lat,lon per line, # comments).** The plot's coordinates are unknowable until the aircraft stands on it, so NEW uno_q/make_waypoints.py generates the survey ON SITE from the aircraft's own GPS + heading through the pump: stand it at the start corner, point the nose along the rows, one command -> serpentine (default 3 rows x 20 m, 5 m apart; row spacing chosen against the camera footprint, WHICH IS NOT YET KNOWN because HFOV IS UNMEASURED (see the 2026-08-15 review entry; the 58.2deg that appears in run_mission's docstring example is NOT a measurement and must not be quoted as one); read-only toward the aircraft; requires real fix, 0.0-lat guard). Geometry unit-verified at headings 0/90/137: row lengths 20.00 m, hops 5.00 m. Farm runbook now 6b pump+sanity / 6c make_waypoints / 6d run_mission (--model models/best.onnx explicit, stale default; --camera verify via v4l2-ctl). Checklist steps renumbered accordingly.
FRIDAY NIGHT CLOSES WITH: link done, gate done (boot-closed), params staged (AVOID_ENABLE=0 push = farm step 3b, board still 7), waypoints tooling done, video script done, pack list done. Aircraft to be POWERED DOWN at Raghav's + pack on charge. Remaining farm-only: push, nodes tick, camera index, GPS fix, rehearsal flight, the take.

## 2026-08-15 06:40 FULL CODE REVIEW OF EVERYTHING OUTSIDE tools/ (user-requested, 6431 lines)

**BUG 1, THE WORST ONE IN THE PROJECT, FIXED: a coin-flip at connect time made the mission command AUTOTUNE instead of GUIDED and DRIFT instead of RTL.** `MavIO.wait_ready` used `conn.wait_heartbeat()`, which returns the FIRST heartbeat of ANY component. The ESP32 ring is comp 195 on the same vehicle, beats at ~1 Hz like the autopilot, and ArduPilot forwards it to us over SERIAL5, so it wins that race about half the time (the 2026-08-14 e2e run showed comp-1 and comp-195 heartbeats alternating almost 1:1). pymavlink refuses to lock `target_system` onto a heartbeat it does not judge to be a VEHICLE, and `mavutil.probably_vehicle_heartbeat` explicitly excludes MAV_TYPE_ONBOARD_CONTROLLER, so an ESP32-first connect leaves target_system 0, whose default `mav_type` is **1 = FIXED WING**. `mode_mapping()` then returns the PLANE map and every mode name silently means something else: **GUIDED -> 15 = AUTOTUNE on Copter, RTL -> 11 = DRIFT on Copter, and custom_mode 4 reads back as "ACRO"** so the pilot-override test stands the mission down instantly. REPRODUCED both orderings through real pymavlink (plane map 26 entries, copter map 27). COULD NOT HAVE APPEARED BEFORE 2026-08-14 (the ring was silent) AND CANNOT APPEAR IN SITL (no second component), which is exactly why every prior test passed. FIX: wait_ready now requires a heartbeat from **component 1**, forces the target_system lock, and REFUSES TO RUN if the resulting map has no GUIDED. Callers updated to catch RuntimeError alongside TimeoutError.
**BUG 2, FIXED: the mission stood down before it began, on a race.** `tel.mode` only advances on a HEARTBEAT (1 Hz) but `set_mode`'s COMMAND_ACK returns in tens of ms, so on the first loop pass `tel.mode` still held the pre-takeoff mode and the pilot-override test fired => STANDDOWN, which is NOT in the `('DONE','STOPPED')` branch, so the aircraft was left armed and climbing with the mission process gone. FIX (two layers): `set_mode` now pumps until the heartbeat confirms and returns bool; the override test is gated on `_seen_guided`, so it can only fire after GUIDED has actually been observed. REGRESSION-TESTED both ways (lagged start -> DONE; genuine pilot takeover -> STANDDOWN).
**BUG 3, FIXED (found by review agent): the board's git auto-sync has been DEAD since the 2026-08-13 reflash.** board_sync.sh defaulted to `$HOME/monsoonready` and both .service files hardcoded it, but the clone is `~/monsoonready-drone`. board_setup.sh had been patched for this rename; these three never were. board_sync.sh now self-resolves from its own location like board_setup.sh; both unit files corrected.
**BUG 4, FIXED: board_setup.sh never installed flask or msgpack.** flask = the base station dashboard, which the mission auto-launches and which is FILMED TWICE in the demo video; msgpack = the Linux half of the byte-shovel. Both had been hand-installed after the reflash, so a rebuild would have silently produced a board that cannot serve the dashboard or reach the Pixhawk.
**BUG 5, FIXED: board_setup.sh printed "no serial devices at all" directly under a list of serial devices.** `ls a* b* c* | sed || bad` with `set -o pipefail`: ls exits nonzero when ANY glob misses even though it printed the matches, which is the board's normal state (ttyS0-3, no ttyUSB/ttyACM). Reproduced, rewritten without the pipeline.
**BUG 6, FIXED: predict.py scored an undated site at exactly 0.00, below a site never seen at all.** `last_t` initialised to 0.0 = epoch, so `recency = 0.5**(20000/14)` underflowed to zero and zeroed the product. `stamp()`'s own docstring already said missing times must be ignored; the initial value disagreed with it. Now None, with recency dropping out of the product (weight 1.0) when nothing is dated. Verified: 5 undated flights now score 5.00, span still 0.
**ALSO FIXED:** spotcheck_onnx crashed on a directory with no matching images (`cv2.imwrite` on a zero-height grid) - now reports why, and names the .bmp/.webp filter gap; benchmark_onnx crashed on `--runs 0` and drew confidence labels off-canvas near the frame top; gen_fake_mission never wrote dwell_s/area_m2 so the dashboard's dose rendering had no test data; **sketch_serial1_probe.ino now opens with a DO-NOT-FLASH banner** (it lacks mav_read/mav_write, so flying it kills the whole autonomy chain with no obvious cause, and it is the folder muscle memory reaches for); run_mission's `--model` default was the vanished `~/uno_q/best.onnx` and now resolves `<repo>/models/best.onnx` from its own location; run_mission's docstring still described the link as unresolved TODO 12.
**THE BIGGEST NON-BUG RISK, AND IT IS NOT CODE: HFOV HAS NEVER BEEN MEASURED, SO EVERY DETECTION RESOLVES TO NADIR.** run_mission only builds a CameraGeometry when `--hfov-deg` is passed; without it `detector._locate` returns the AIRCRAFT'S OWN lat/lon and the aircraft descends and drops where it was standing when it first saw the water, which can be half a camera footprint away. NEW `uno_q/calibrate_camera.py` turns this into a 10-minute tape-measure job (wall method or known-object method), self-checked (90deg in -> 90.00deg out) and it also prints how many model-input pixels a given target spans. SECOND HALF OF THE SAME PROBLEM: a 0.6 m tray at 15 m is only ~13-25 px in the model's 640 input depending on the true FOV, and YOLO is unreliable below ~40 px. The farm has a water pump and dirt: a **2-3 m wet patch** gives 80-150 px AND looks far more like the training data than a plastic tray. Both are now checklist items. CORRECTION TO MY OWN 2026-08-14 ENTRY: I quoted "58.2deg HFOV" as if measured; it is only an example number in a docstring. Corrected in place.
**ESP32 FIRMWARE REVIEWED AGAINST THE VENDORED MAVLINK SOURCE AND ARDUPILOT'S AP_Proximity_MAV.cpp: NO FALSELY-CLEAR PATH EXISTS.** Dead ch2 -> init fail latches _ok=false -> SENSOR_MM_ERROR -> SECTOR_NO_DATA 65535, and runtime timeouts (ch5) land on the same sentinel. Indices consistent (7/6/72), PITCH_90 for the up sensor is right (checked against ArduPilot's own constant), diag and fake paths compile out, MAVLink packing is library-generated not hand-rolled. **AND IT ANSWERS THE USER'S QUESTION "why do more ring sensors keep failing by one per test?": the ESP32 probes each channel ONCE AT BOOT and latches a failure for the whole session, with no retry anywhere in readAll(). The board stayed powered for hours, so those were RUNTIME read timeouts on a hot sealed frame, and nothing re-initialises them while power is on. A COLD BOOT re-runs init and may recover channels; added to the checklist as a 30-second pre-take action.** Open gap, low severity, NOT fixed (no bench access, and AVOID_ENABLE=0 makes it cosmetic): tcaselect() discards Wire.endTransmission()'s result, so a NACKed mux switch would read the previously-selected channel believing it read the new one.
**REVIEWED AND CLEAN, recorded so it is not re-litigated:** mission.py state machine (full detect->approach->descend->drop->climb->done cycle exercised with the real dropper and real PWM guards: gate 560 -> 1760 -> 560, ends CLOSED, one success counted), camera_geom.py (all 20 numeric assertions re-checked, letterbox undo is the exact inverse of infer_rows), detector.py (dedup is on the SITE not the aircraft; an aborted target stays in _fired, which is the documented "skip target" behaviour, so no abort/retry loop), missionlog.py schema matches app.py AND index.html exactly incl. the absent-means-true conventions, detect_worker.py, dropper.py, training/*, val_compare, merge_datasets (polygon labels are converted by ultralytics at load, not dropped). models/best.onnx independently confirmed as input (1,3,640,640) / output (1,300,6) with conf in [0,1] in letterbox pixel space, matching every consumer.

**2026-08-15 ~11:45 DASHBOARD REBUILT AS A TILING PANEL LAYOUT (user request, for the on-camera segment), VERIFIED LIVE against the real Flask app + fake missions in a browser: zero console errors.** basestation/static/index.html only; app.py untouched (same endpoints), so the board needs nothing but git pull. PANELS (each movable by dragging its header onto another panel, resizable by the corner handle, closable via its x, restorable + reset via the header "Panels" menu; layout persists in localStorage under mr-layout-v1, saved layouts merge with defaults so future new panels cannot be hidden by a stale save): Site map (main, all previous map features intact: heatmap/track/markers/tooltips/zoom/pan/site image, PLUS a live aircraft dot at the newest fix while the mission is in progress), Mission status (BIG current-state readout with color + pulsing live indicator, elapsed, per-mission det/treated counts, last 4 transitions; follows the NEWEST mission when "All flights" is selected = the live one during the take), Season totals (the old 5 tiles), Altitude profile (NEW canvas chart: EKF alt line + rangefinder dots + green/red verticals at drops/aborts - the descend-drop-climb V is visible on camera), Latest detections (newest first, conf + coords + time), Event log (old table, newest first now, sticky header). LIVE TICK: 3 s refetch of the selected scope, re-render ONLY when the payload changed, elapsed keeps counting between, paused while document.hidden; mission-list check stays at 15 s. VERIFIED IN BROWSER: map painted (154k px), profile painted, hide-via-x + restore-via-menu + persistence + reorder-persists + tick-refetch + single-flight selection with status following - all exercised. Phones: <900px stacks panels full-width, resize handles hidden. NOTE .claude/launch.json (basestation-fake, scratchpad data dir) now exists for local preview; harmless if committed.

**2026-08-15 ~12:15 NETWORK PLAN CORRECTED (user): CLOUDFLARED IS NOT ON THE REFLASHED BOARD - drone.reysen.net is DEAD, I had kept referencing it. Field networking is hotspot-LAN only.** Decision: ONE network all day = the iPhone 12 mini hotspot (laptop + board on it). NOT the Vivo X300 FE (it is the filming phone: it moves with the camera operator, and hotspot+recording competes for battery/heat). NOT the TP-Link MR3020 as primary (no internet on it = no arrival git pull and no on-camera Google-date search), but it IS the packed BACKUP LAN (the dashboard needs zero internet; git pull happens before any switch). NO VERIFIED RANGE FIGURES EXIST for any of the three - the real lever is PLACEMENT: hotspot high and still at the ground station facing the ~20x10 m survey plot. WIFI DROP CONSEQUENCES, reasoned and recorded: mission unaffected (fully onboard, MAVLink is wired), dashboard pauses and self-recovers via the 3 s tick when the drone is near/landed (JSONL is cumulative). Dashboard URL = http://<board-ip>:8080, IP from hotspot client list or hostname -I.
**CRITICAL CATCH FROM THE SAME QUESTION, FIXED IN THE RUNBOOK: a wifi dropout would have RTL'd the take.** Runbook 6b/6d had the pump and run_mission in FOREGROUND SSH sessions; the drone leaving hotspot range kills the SSH session, the shell delivers SIGHUP, and run_mission's handler treats SIGHUP as "wind up -> RTL" (the pump would just die, stranding GUIDED until GUID_TIMEOUT hover). Both now launch with setsid nohup + log files (pump.log / mission.log), watched via tail -f (a dying tail is harmless). Deliberate stop = pkill -f run_mission.py (SIGTERM -> graceful RTL). run_mission's own docstring always demanded setsid; the checklist had dropped it.

**2026-08-15 ~12:40 NETWORK PLAN v2 (user override + actual research): THE TP-LINK TL-MR3020 CARRIES THE FIELD LAN; the iPhone is only the internet source.** Researched facts, not vibes: MR3020 transmits 20 dBm @ 2.4 GHz (router-class, regulatory ceiling), USB-powered (power bank OK; v1 mini-USB vs later micro-USB - check label for the cable), and its modes (3G/4G router / WISP / AP) run a DHCP LAN with no internet. iPhone hotspot: defaults to 5 GHz (shorter range); 2.4 GHz requires "Maximize Compatibility"; single band at a time; phone APs are pocket-distance devices. NO honest open-field metre figure is claimable for either; the board's own antenna is the other half of every link, so plan for dashboard pauses at the survey's far edge with automatic catch-up. PREFERRED TOPOLOGY = MR3020 in WISP MODE with the iPhone hotspot (Maximize Compatibility ON) as upstream: board + laptop stay on the TP-Link ALL DAY, internet (git pull, on-camera Google-date) flows through it, iPhone dying costs internet but never the LAN, ZERO network switches. FALLBACK = MR3020 standalone: internet phase on iPhone first, then board (`sudo nmcli dev wifi connect ...`, SSH drop mid-command is normal, NM auto-rejoins) + laptop move to TP-Link; the take's date-proof happens with the laptop briefly on iPhone, laptop switches during the 0:30-3:00 components walk (off-camera) so the dashboard is up by the 3:00 AI segment. Dashboard: http://arduino-drone.local:8080 (mDNS is how arduino-cli discovered the board - VERIFY once) or IP from the MR3020 client list.

**2026-08-15 AT THE FARM. HFOV MEASURED: 56.18 deg (0.950 m of wall at 0.890 m, uno_q/calibrate_camera.py wall method, at 1280x720).** BAKED IN so no flight can forget it: camera_geom.DEFAULT_HFOV_DEG = 56.2 (no longer a placeholder, VERIFY marker removed) and run_mission's --hfov-deg now DEFAULTS to it, so geometry is always on (--hfov-deg 0 disables deliberately). CONSEQUENCES, computed: footprint at 15 m = 16.0 x 9.0 m; 0.6 m tray = 24 px in the 640 model input (too small, confirms the big-target call); a 2.5 m wet patch = 100 px (ample). Survey rows 5 m apart against a 16 m footprint = heavy overlap, correct.
**FALSE ALARM RESOLVED, AND IT WAS MY DOCUMENTATION BUG: "NO component 191" from bench.py nodes DOES NOT MEAN THE LINK IS BROKEN.** The link was working the whole time - the same session's test_mission_link got its SET_MESSAGE_INTERVAL **ACKed**, which is direct proof of the UNO Q -> Pixhawk TX path, plus live telemetry (GPS fix 3, 13 sats, lat 12.8288867 lon 77.9544641). ROOT CAUSE: the old probe sketch heartbeat FROM FIRMWARE, so comp 191 was always on the bus; sketch_mav_shovel replaced it and only forwards bytes, and MavIO sent commands but never a heartbeat. An idle board is therefore silent BY DESIGN. I had left checklist step 4b telling the user to confirm comp 191 with nothing running, which cost time at the farm on shoot day. FIXED THREE WAYS: (1) MavIO.step() now emits a 1 Hz comp-191 heartbeat (also just correct MAVLink citizenship for a companion; verified on the wire: HEARTBEAT sys1 comp191), so the nodes check is meaningful again WHILE a MavIO process runs; (2) bench.py's verdict text no longer claims a broken link, and explains that nothing heartbeats unless a MavIO process is up; (3) checklist step 4b rewritten. VERIFY IF EVER RELEVANT: FS_GCS_ENABLE is not in pixhawk_full_setup.param and was assumed 0/default; with heartbeats now flowing on SERIAL5, a non-zero FS_GCS_ENABLE would make losing the pump a GCS-failsafe event. Not checked at the farm, not believed to be set.
**PUMP EXIT 1 EXPLAINED: `udp.bind` on 127.0.0.1:14556 raised OSError because A PUMP WAS ALREADY RUNNING** (which is why test_mission_link worked at all: the earlier pump was doing the job; the `[2]` job number showed a job [1] existed). Behind setsid nohup the traceback went to a log nobody had opened, so it read as a failure. The pump now exits with a plain explanation naming `pgrep -af mav_shovel_pump.py` and `pkill -f mav_shovel_pump.py`. ONE PUMP IS ALL THAT IS EVER NEEDED.
FARM STATUS AT THIS POINT: params pushed 66/66 over USB incl AVOID_ENABLE=0; GPS fix 3 with 13 sats; TF-Luna, compass, ESP32 all PASS; gate wiggle all three commands ACCEPTED (560 -> 1760 -> 560); ring 4/6 (s1/s2 dead, expected, avoidance off); up-sensor still 0; RC still ABSENT/UNHEALTHY on a USB run with the TX state unknown - MUST read PASS with the TX on before arming.

**2026-08-15 ~15:05 DASHBOARD LAUNCH BUTTON BUILT (user request: fly from the dashboard instead of typing SSH commands on camera). Verified end to end on the laptop against the real Flask app; zero JS errors over sustained live ticks.**
app.py: `make_app(data_dir, control=None)` - control is None => the dashboard is READ-ONLY EXACTLY AS BEFORE. Enabled only by `app.py --enable-control` (plus --waypoints/--conn/--camera/--no-drop/--mission-python), because these endpoints arm and fly an aircraft and anyone on the LAN can reach the server; it prints a warning on startup. NEW: GET /api/control (always present so the UI can grey out rather than guess from a 404; reports mission/pump pids, waypoint existence, conn, camera, no_drop, and a tail of ~/mission.log + ~/pump.log), POST /api/control/pump, POST /api/control/start (409 if a mission runs, 400 if no waypoint file, 400 if the pump is down; spawns with start_new_session = the same SIGHUP protection setsid gives, logging to ~/mission.log), POST /api/control/stop (SIGTERM ONLY, never SIGKILL: run_mission's handler turns SIGTERM into a graceful wind-up + RTL; a kill would abandon the aircraft on its last setpoint).
`find_pids()` reads /proc so the answer survives a base-station restart and sees hand-started processes, AND REQUIRES 'python' IN THE CMDLINE - without that an editor open on run_mission.py or a `grep run_mission.py` counts as a running mission and the START button refuses with "already running" mid-take. Verified: a non-python process holding the filename does NOT register.
UI: new "Flight control" panel in the tiling layout (LS_KEY bumped to mr-layout-v2 so v1 saves cannot pin the old order and hide it). TWO-STEP LAUNCH by design: "Arm controls" unlocks START for 8 s and it flashes; STOP is NEVER gated because an abort must always be one click. Status pills for pump/waypoints/gate, live log tail, auto-disarm on start.
TWO BUGS FOUND AND FIXED IN THAT LAPTOP TEST, both mine: (1) setArmed() ignored the preconditions, so clicking Arm enabled START even with the pump DOWN - the server still refused it (400) but the operator got a red error mid-take instead of a button that was simply not offered; now setArmed consults ctl.canFly and ctlRefresh re-derives through setArmed so flag and button can never disagree, and it explains why it will not arm. (2) a stale "cannot arm" message survived a later successful arm; now cleared.
VERIFIED BY EXERCISE, not by reading: START with pump down -> 400; STOP with nothing running -> 409; START -> ok + pid; second START -> 409; STOP -> SIGTERM, state returns to idle, STOP re-disables; arm/disarm labels; log tail contains the launch line; map still paints 154k px; all 7 panels present.
ALSO: camera index is 0 (user, confirmed at the farm) - baked in as the default in run_mission, detect_worker AND OnnxDetector, so it is not a flag either. Combined with the HFOV default, a flight now needs only --conn and --waypoints.

**2026-08-15 ~16:20 GEOFENCE ENABLED (user question: "how do I create it, and how do I know the arduino will not tell the pixhawk to override it?"). Added to param_dumps/pixhawk_full_setup.param, so it goes on with the same `parameters.py push` as everything else: FENCE_ENABLE 1, FENCE_TYPE 3, FENCE_ACTION 1, FENCE_ALT_MAX 30, FENCE_RADIUS 100, FENCE_MARGIN 2. File now parses to 72 params (was 66); parse VERIFIED with the real load_param_file logic, inline `#` comments strip correctly.**
WHY TYPE 3 AND NOT THE 7 THAT WAS SITTING COMMENTED OUT IN THAT FILE: 3 = alt-max + circle; 7 adds the POLYGON bit, and a polygon is a mission-item upload that has to be present and valid or the prearm check fails. On a one-run day that is a new failure mode bought for nothing, because a cylinder already contains a flyaway. RADIUS 100 is measured FROM HOME (= wherever it arms), not from the plot; the survey reaches ~25 m from its start corner, so 100 m absorbs the walk from the ground station and still traps a runaway. ALT_MAX 30 = 2x the 15 m survey altitude and 2x RTL_ALT_M.
THE ANSWER TO "CAN THE ARDUINO OVERRIDE IT" IS STRUCTURAL, AND IT WAS AUDITED RATHER THAN ASSUMED. Two independent reasons:
(1) LOCATION. The fence is evaluated inside ArduPilot, downstream of every MAVLink message that arrives. The companion only ever REQUESTS a position or a velocity; the autopilot decides what to do with the request. There is no message that means "go there and ignore the fence".
(2) VOCABULARY. Grepped every `*_send(` in uno_q/ (flight path): heartbeat_send, command_long_send (only DO_SET_MODE, COMPONENT_ARM_DISARM, NAV_TAKEOFF, DO_SET_SERVO, SET_MESSAGE_INTERVAL), set_position_target_global_int_send, set_position_target_local_ned_send. NO PARAM_SET ANYWHERE and NO MAV_CMD_DO_FENCE_ENABLE ANYWHERE, so no board process can disable, resize or exempt the fence even in principle. The only `fence` match in the whole of uno_q/ is the word "defence" in a run_mission.py docstring. Parameter writing lives exclusively in tools/parameters.py, run by hand from the laptop. (`param_request_read_send` exists in sitl_test.py; it is a READ and it is SITL-only.)
ON BREACH, THE TWO SYSTEMS DO NOT FIGHT: ArduPilot changes mode to RTL, mission.py's next loop pass sees mode != GUIDED, calls that a pilot override and goes STANDDOWN, which stops commanding. STANDDOWN is deliberately excluded from the end_mode branch (the ('DONE','STOPPED') test), so the mission does NOT re-command a mode on the way out and the fence's RTL is left to run. Same mechanism that protects a manual RC takeover; the fence just triggers it from inside the autopilot.
CAVEAT RECORDED HONESTLY: AVOID_ENABLE stays 0 (set today to kill the failing proximity ring) and its bit 1 is FENCE avoidance, i.e. the soft "slide to a stop at the boundary" behaviour. So this fence is a FAILSAFE, not a wall: the aircraft can cross the line and then turns around. Turning avoidance back on is an untested change and was NOT made today.
NEW PREARM RISK, MUST BE CLEARED BEFORE THE TAKE: FENCE_ENABLE=1 adds a prearm check (needs a good 3D fix and home set; a bad fix now blocks arming where it did not before). Arm on the ground BEFORE recording. If it blocks and GPS is fine, the escape is FENCE_ENABLE=0 and fly with the RC pilot as the only backstop.

## 2026-08-15 THE FARM RUN FAILED. ROOT CAUSE: THE CAMERA, NOT ARMING, NOT THE DASHBOARD.

`~/mission.log` on the board shows the dashboard launched run_mission THREE times, correctly, with the right argv. All three died at the same place, before any MAVLink command was sent:
`[detector] PREFLIGHT FAIL: worker reports no frame from the camera` -> `[run] camera preflight failed, refusing to fly a blind survey`.
So: the link worked (heartbeat from system 1 each time), the dashboard worked, the fence was irrelevant, and NO ARM WAS EVER ATTEMPTED. `~/monsoonready_data/missions/` does not exist because no mission ever started logging. Board was on f9562b8, the tested commit. The pump message in pump.log is the benign already-running one.
STILL UNKNOWN AND NEEDED: `~/detect_worker.log`, which holds the actual cv2 error. Camera index 0 was confirmed by the user's calibrate_camera run, but WHICH MACHINE that ran on is not recorded, and index 0 on the laptop is the built-in webcam, not the board's USB camera. Do not assume the index is right on the board until that log is read.

### .BIN log analysis, logs 42-45 (2026-08-15, user-requested)
- **42 (15:49): the aircraft was DROPPED, deliberately.** Timeline: armed 123.8s, took off, LOITER, RTL at 156.1s, then at 175.3s **RC8 MotorEStop HIGH at about 2 m** cuts the motors; 3 s later at -2.59 m the crash check disarms (`AngErr=165>30, Accel=0.1<3.0`). The 165 deg angle error is the CONSEQUENCE of stopping the motors in the air, not a cause. IMU0 clipping +49 in the same log is the impact. Nothing mechanical failed.
- **43 (15:57): compass, and it is unresolved.** `PreArm: Check mag field: 1038, max 875, min 185`, `PreArm: EKF compass variance`, `EKF3 IMU0 MAG0 ground mag anomaly`, then GPS glitch + 4 EKFCHECK/FAILSAFE_EKFINAV pairs and `AHRS: EKF3[1] vel error 2.0`. Mag field magnitude 1038 against a 875 ceiling means the measured field is ~19% too strong: interference near the compass or a stale/absent compass calibration.
- **45 (16:49): same compass complaint, 1058 vs max 875.** So it is repeatable across power cycles, not a one-off.
- **44 (16:01): armed at 8 sats / HDOP 1.66**, below the project's own 10-sat / 1.5-HDOP arming rule. It recovered to 14 sats in flight, but that arm should not have happened.
- All four logs: `PreArm: Rangefinder 2: No Data` throughout, the known-dead second rangefinder.
- Vibration is fine everywhere (VibeZ median 8.4-9.0 vs the <15 gate). Hover throttle steady at 0.390. Burn rate ~500 mAh/min, so ~12.6 min to a 20% reserve on the 8000 mAh pack.

### Camera failure narrowed (2026-08-15 evening)
- CORRECTION of my earlier guess: calibrate_camera ran ON THE BOARD (user). So /dev/video0 at index 0 OPENED AND CAPTURED midday, then failed all three dashboard launches after ~15:45. Index 0 is CORRECT on the board.
- detect_worker.log: `cap_v4l ... VIDEOIO(V4L2:/dev/video0): can't open camera by index`, 0.07-0.14 s after process start, identical x3. Fails at open(), before any format negotiation. cv2 does not print errno, so cause unproven.
- Topology verified on the board: lsusb shows Logitech B525 (046d:0836); v4l2-ctl --list-devices: B525 = video0 (capture) + video1 (metadata) + media0; video2/3 = Qualcomm Venus encoder/decoder, NOT cameras. Nodes dated Aug 15 11:25 = no re-enumeration all day.
- Candidates: (a) a holder process left from midday (V4L2 capture is exclusive at stream time; a stuck consumer blocks later opens), (b) permission/group difference between the SSH session that ran the FOV test and the process tree that spawned the dashboard. Diagnostics issued: fuser on video0/1, id, v4l2-ctl one-frame grab (real errno), cv2 open one-liner.

### 2026-08-15 evening: the board REBOOTED since the farm failures, so the camera wedge is cleared but UNPROVEN
- uptime 39 min at 17:34 = booted ~16:55, after the three failed launches. Camera now healthy: arduino in video group, no holder (fuser empty), v4l2-ctl one-frame grab OK, cv2 open+read OK. Whatever wedged /dev/video0 at the farm (holder process vs UVC/USB state vs launch environment) is unproven and can recur at the field shoot.
- The Aug 15 11:25 /dev/video* timestamps are NOT proof of no-reboot: likely stamped by the pre-NTP boot clock (board sat on the internet-less MR3020 LAN, saved clock stale). Probable explanation, not verified.
- User ordered verbose logging (design questions first, per SCOPE RULES 2), plus detect_worker self-diagnosis on camera failure pending answers. Questions sent 2026-08-15 evening.

### 2026-08-15 night: USB-hub architecture decided; logging spec locked
- Farm camera wedge, leading theory per user answers: the camera USB plug loosened by flight vibration (not touched by hand, no leftover processes, no other camera programs ran, dashboard was started by manual nohup). Unproven; the reboot cleared it.
- DECISION (user): a USB-A hub now hangs off the UNO Q's single USB-A, carrying BOTH the camera and the Pixhawk's USB. The Pixhawk link moves to direct USB (pymavlink on /dev/serial/by-id path); the whole shovel chain (sketch_mav_shovel, router_client, mav_shovel_pump, SERIAL5 wire) is REMOVED once the USB test passes. Tests issued: by-id listing, solo heartbeat, camera 600-frame baseline, then both simultaneously.
- SERIAL5 (confirmed shovel port, param line 52) goes free: recommendation given = disable it, leave empty.
- Logging spec (user answers): every program in uno_q/ (esp32 folder meaning pending clarification, no filesystem there); logs live in ~/logs/; each program owns its file, append-only; IST wall clock + seconds-since-boot on every line; NO per-request HTTP logging on the dashboard; mission logs 1 Hz telemetry + every command/ack/state transition; >100 MB trimmed oldest-first at program start only.
- DECISION (user): dashboard goes LIGHT MODE (dark unreadable in sun glare), stays simple.
- Photo-on-demand camera mode under consideration; questions out (trigger source, survey coverage, reopen-risk warning given).

## 2026-08-16 (past midnight after the farm day)

### FARM CAMERA ROOT CAUSE, now the leading explanation with direct evidence
V4L2 INDEX SHUFFLING. Tonight the user replugged the camera and the Qualcomm Venus codec devices took /dev/video0+1 while the camera landed on video2+3; cv2.VideoCapture(0) then failed with EXACTLY the farm error ("can't open camera by index"), because index 0 was suddenly the video ENCODER. Which driver gets video0 is a boot/enumeration race. Farm mechanism: plug loosened by vibration (user's theory), camera re-enumerated mid-day, lost the race, all three launches opened the codec instead of the camera. Not provable retroactively (no farm dmesg), but reproduced end to end tonight. FIX (to be coded): open the camera BY NAME via /dev/v4l/by-id, never by bare index.
- dmesg tonight: clean. No over-current, no disconnect storm; hub + camera (1-1.1, at boot+15s) + Pixhawk ACM (1-1.2, boot+69s) all enumerate fine. One unexplained line "usb_vbus: disabling" at boot+33s, noted, not chased.
- PIXHAWK OVER USB THROUGH THE HUB: PROVEN. Hexarotor heartbeat solo and 8/8 heartbeats under attempted camera load. /dev/serial/by-id/usb-ArduPilot_Pixhawk1-bdshot_...-if00.
- Board clock runs ~6 h behind real time (no NTP sync, no RTC battery). Fix commands + NTP explanation given. Logging code will stamp Asia/Kolkata wall time explicitly PLUS seconds-since-boot on every line.
- STILL PENDING before shovel deletion: camera streaming (index 2 right now) SIMULTANEOUS with Pixhawk heartbeats through the hub. Then: delete shovel chain, user pulls D0/D1 and SERIAL5 wires (SERIAL4 TF-Luna untouched), SERIAL5_PROTOCOL to -1.

### Decisions locked tonight (user)
- Test-everything button on the dashboard: tests EVERY component EXCEPT motors and servo (camera grab+save, Pixhawk heartbeat, GPS fix, battery voltage, ring proximity freshness, TF-Luna range, disk space, log writability), 30 s TOTAL budget, logs successes and failures, errors shown on the dashboard.
- Mission preflight still HARD-REFUSES to fly if the camera gives no frame; now with detailed error lines (errno, holder process, "camera missing from USB, check the plug" when the node is gone).
- Photo pipeline (replaces continuous video processing): camera stays OPEN; capture is inference-paced with a 1-deep queue (frame N+2 is captured the moment N+1 enters processing). No photos while no mission is running. Every auto photo saved to ~/monsoonready_data/photos/, 10 GB cap, oldest deleted first. Capture at the camera's maximum resolution (B525: 1280x720, approximately, verify on board) and letterbox to the model's 640 input as always; full-res files are future training data.
- Dashboard photo button: capture saved to ~/monsoonready_data/manual_photos/ (separate folder), displayed on the dashboard, NOT processed by the detector.
- Dashboard: light mode DEFAULT with a dark toggle (glare). Panel layout stored SERVER-SIDE so both laptops see the same layout across reboots/refreshes.
- basestation app.py RENAMED dashboard.py, log ~/logs/dashboard.log (logs named after their script).
- AUTOMATION DELETED (rule now in CLAUDE.md SCOPE RULES 6): repo-side monsoonready-sync.service, monsoonready-sync.user.service, board_sync.sh removed and deploy/README.md rewritten manual-only; board-side removal commands issued (user units, system units, crontab entries, git-pull-script.sh, linger).

### 2026-08-16 ~00:15 IST: hub PROVEN, green light for the USB migration
- Camera through hub: 600/600 frames (40 s, index 2). Pixhawk simultaneously: 8/8 heartbeats, three consecutive runs. dmesg clean. THE HUB CARRIES BOTH.
- Board clock NTP-synced, TZ Asia/Kolkata (RTC chip reads 1970, i.e. no battery, as diagnosed).
- Board automation confirmed gone: user+system sync units removed, crontab has zero jobs, linger off, git-pull files deleted.
- DECISION (user): MR3020 will run WISP mode at the field, uplinked to a phone hotspot, so the board has internet and NTP there. (Reverses the 08-15 "no WISP, no time" call.)
- NOW EXECUTING (all user-ordered): delete shovel chain; conn switches to Pixhawk USB by-id with auto-resolve; boardlog logging everywhere; camera opened by name never index; photo queue pipeline + photos/manual_photos folders; dashboard renamed dashboard.py with light default + toggle, server-stored layout, test-everything button, manual photo button; test_everything.py; SERIAL5_PROTOCOL,-1 in the param file; checklist updated.

### 2026-08-16 ~00:45 IST: THE BATCH IS IN. USB link, logging, camera-by-name, new dashboard, self-test.
All user-ordered, all tested on the laptop (37/37 unit+endpoint checks, plus a live browser session against fake missions; server stopped and port verified free afterwards).
- DELETED: mav_shovel_pump.py, router_client.py, test_shovel.py, sketch_mav_shovel/ (the whole byte-shovel chain). bench.py/test_mission_link/make_waypoints/board_setup texts updated to match. msgpack dropped from board_setup.
- uno_q/boardlog.py (NEW): every board program owns ~/logs/<script>.log, append-only, line = `IST wall clock + seconds-since-boot + LEVEL`; >100 MB trimmed oldest-first at open only; when spawned non-interactively it captures fd1/fd2 so C-library warnings and tracebacks land in the file too.
- uno_q/camera.py (NEW): resolves the camera BY NAME from /sys/class/video4linux (excludes Venus codecs), tries candidates ascending, requires a real frame; diagnose() reports errno + holder process; "camera missing from USB" when nothing camera-like exists. Kills the farm failure class. Owns focus lock.
- mavlink_io: resolve_conn('auto') finds the Pixhawk in /dev/serial/by-id (ArduPilot/Pixhawk/PX4 patterns, -if00, exactly one or refuse); Telemetry grew batt_v/batt_pct/sats/hdop/fix_type (SYS_STATUS + GPS_RAW_INT at 1 Hz); every command send + ack result logged; goto and forced velocity setpoints logged.
- mission.py: 1 Hz [tel] line (state, mode, armed, pos, alt, rng, vd, batt, sats, hdop), None-safe.
- run_mission.py: --conn default auto, --camera default auto (string), boardlog throughout, logs its own argv at launch, spawns the worker to DEVNULL (worker logs itself), basestation path -> dashboard.py.
- detect_worker.py: photo pipeline per user spec (camera stays open, capture paced by inference via 1-deep flushed buffer, --interval default 0); EVERY frame saved full-res to ~/monsoonready_data/photos/ (10 GB cap, oldest deleted first, checked at start + every 100); manual-photo request/reply files for the dashboard; camera_ok false payloads now carry the plain-words error; no automatic reopen (user: diagnosis lives in the test button).
- uno_q/test_everything.py (NEW): 30 s TOTAL, no motors no servos: logs writable, disk free, camera by name + saved frame, Pixhawk heartbeat, GPS vs arming rules (10 sats / 1.5 HDOP / 3D), battery voltage vs 10.8 V, TF-Luna, ring orientation count. Writes ~/monsoonready_data/selftest.json + ~/logs/test_everything.log; refuses while a mission runs; exit code = fail count.
- basestation/app.py RENAMED dashboard.py: boardlog (control actions + launches + refusals; 3 s polls deliberately not logged); pump endpoints gone; /api/layout GET/POST (server-stored, data_dir/layout.json); /api/control/test; /api/control/photo (via-worker or direct); /api/manual_photos/<name>; control block simplified (no pump precondition).
- index.html: LIGHT default + dark toggle (persisted); layout loads server-first with localStorage fallback and debounced POST on change; Self-test panel (button, per-component PASS/FAIL with reasons in red); Manual photo panel (button + latest image, click to open); pump UI removed; arm gating re-verified in the browser (START enabled only while armed AND waypoints exist AND idle).
- param file: SERIAL5_PROTOCOL,-1 (with the why). Fence block from earlier tonight unchanged. PUSH PENDING: the pending delivery now carries SERIAL5 -1 + FENCE + AVOID_ENABLE 0.
- FIELD_CHECKLIST rewritten for the nearby-field shoot: WISP MR3020 + its power bank + correct USB cable packed (user request 2026-08-16); param push + bench arm re-check the night before; dashboard-driven site procedure (Test everything button, START from dashboard); hub plugs taped (vibration theory); compass caveat from farm logs 43/45 carried into KNOWN-GOOD.
- launch.json: dashboard.py + current scratchpad paths.
- STILL TO PROVE ON THE BOARD: test_everything full pass with camera+Pixhawk together, dashboard photo button both paths, one dry-run mission via the START button. Wires D0/D1 + SERIAL5 can physically come out now.

### 2026-08-16 midday: board proof round + three fixes (all user-ordered)
BOARD PROOF: test_everything ran on the real aircraft: camera by name PASS (video0 through the hub), Pixhawk USB PASS, battery 11.88 V, GPS correctly failing indoors. Dashboard served both laptops' era begins: manual photo button worked end to end (direct path, no worker running).
- LUNA "FAILURE" WAS MY BUG, now fixed: test_everything lacked the ON-GROUND rule that tools/wiring_check.py has carried all along ("an aircraft on its legs legitimately reads below RNGFND1_MIN"). Landed, the lens sits ~0.13 m over the floor (RNGFND1_GNDCLR) and the TF-Luna's rated minimum is 0.2 m, so 0.11-0.13 m readings are the sensor WORKING and ArduPilot flagging them out-of-range by design. test_everything now passes them as "ON-GROUND reading"; flight logic untouched (below-min stays untrusted in the air, correctly).
- RING: the 11:39 test showed bins [0,4,5,7] = 4 of ~5 achievable (6 sensors fitted; ch2 at 120 deg is a DEAD CHIP, proven 2026-08-14 at four bus speeds; software cannot revive silicon). So "most sectors failing" is really: ch2 permanently blind + ONE more sensor latched out + the up sensor silent again (RNGFND2, the known-flaky power plug). ROOT CAUSE OF THE DECAY FIXED IN FIRMWARE: proximity_sensors now has maintain() = one bounded re-init attempt per 5 s for channels that failed boot init or hit 20 consecutive read timeouts (a VL53L0X that browns out stops continuous mode and only init()+startContinuous() bring it back; nothing ever called them, hence sectors only ever DIED across a powered afternoon and revived on cold boot). initChannel() shared by begin() and maintain() so the two paths cannot diverge. Compiled clean with the repo's PlatformIO env (RAM 7%, flash 22.5%). NEEDS FLASHING over the ESP32's USB; question out on physical access with the frame closed. Failure semantics unchanged: a dead sector reports "unknown" (65535), never "clear".
- test_everything ring verdict rewritten to say all of this instead of a bare count; up sensor reported separately (orientation 24).
- PHOTO BROWSER added to the dashboard (user): /api/photos/<auto|manual> paginated list + file serving (read-only, available without --enable-control); Photos panel with Mission/Manual tabs, newest first, 12 per page lazy-loaded, Load more, click opens full size; manual shots appear in it immediately after the button. Endpoint tests 10/10, browser-verified live (12->15 paging, manual tab).
- Dashboard request-line spam (werkzeug INFO per GET, seen in the user's foreground run; would flood dashboard.log detached) silenced to ERROR; control actions still logged explicitly. Matches the no-request-logging spec.
- Checklist note: MR3020 router + its power bank were already in the pack list from the 08-16 night rewrite; user re-request confirmed covered, no edit needed.

### 2026-08-16 afternoon: ESP32 final-flash audit + start_dashboard.sh (user-ordered)
FIRMWARE AUDIT (all six source files read line by line). Wire format verified correct: OBSTACLE_DISTANCE sector mapping/increments/body-frame, classifyCm clamps (0 mm glitch -> unknown, >=8 m -> clear, <5 cm clamps up), up-sensor DISTANCE_SENSOR orientation 24, heartbeat identity. No wire-format bugs found. ADDED for the never-flash-again build:
- Self-heal (earlier today): maintain() re-inits failed/stopped channels, one bounded attempt/5 s.
- FULL-BUS RECOVERY: if EVERY fitted channel is down at once the fault is the shared bus (a slave holding SDA low); maintain() now clocks out <=9 SCL pulses, issues STOP, restarts Wire, re-inits all. Rate-limited to 1/30 s.
- RING-HEALTH STATUSTEXT every 30 s ("prx ring 5/6 up:ok"): forwarded by ArduPilot to QGC and logged in the .BIN (MSG), so ring health is visible in the field and post-flight without the debug USB.
- RX drain of the never-read Pixhawk->ESP32 direction (SERIAL1 streams MAVLink at us; buffer sat full forever).
- isFitted() moved outside the USE_FAKE_SENSORS guard (health counters need it in both modes). BOTH build modes compile (real: RAM 7.1%, flash 22.7%; fake: clean; restored to real). Flash from the laptop: ~/.platformio/penv/bin/pio run -d esp32_obstacle_avoidance -t upload
- What software can NEVER fix, so expectations stay honest: ch2 (120 deg) dead chip; the up sensor's flaky POWER plug (self-heal revives it only when contact returns).
- uno_q/start_dashboard.sh (NEW, user-ordered): the one post-reboot SSH command. Stops any old dashboard (SIGTERM, never touches run_mission), starts detached with --enable-control --waypoints ~/wp_field.txt (extra args pass through, e.g. --no-drop), prints per-IP URLs, verifies liveness, tails the log on failure. bash -n clean.
- Waypoints-system explanation delivered in chat (file format, on-site serpentine generation from GPS+heading, 5 m spacing vs 16 m footprint, wp_radius arrival, detection interrupt/resume, DONE->RTL).

### 2026-08-16 ~13:15 IST: the 8-part batch (all user-ordered, tested, flash STILL pending)
ESP32 RELIABILITY FINAL PASS (goes into the one final flash):
- Health STATUSTEXT period 30 s -> 15 s (config.h HEALTH_TEXT_PERIOD_MS).
- EVENT-DRIVEN announcements: any sensor lost/revived is broadcast the MOMENT it changes ("prx LOST ch4 | ring 4/6"), severity WARNING on a loss (pops in the GCS), INFO on recovery; rate-limited 1/2 s (HEALTH_EVENT_MIN_GAP_MS) so a threshold-flickering sensor cannot flood; a suppressed change still shows in the next 15 s summary. sendStatusText grew a severity arg (numeric consts pinned to the MAVLink enum by static_assert).
- SERIAL MONITOR: 15 s line now appends per-channel state with live error counters ("ch0:ok ... ch2:DOWN(e20) up:ok"); events print even when TX is jumper-blocked; the FIRST health summary goes out immediately at boot (timer backdated), not 15 s in. channelHealthy()/errCount() made public for the sketch.
- BOTH build modes compile (real restored). Flash: ~/.platformio/penv/bin/pio run -d esp32_obstacle_avoidance -t upload
BATTERY % FROM VOLTAGE (user: AP's counter resets to 100% each boot): mavlink_io.volt_to_pct() interpolates the standard LiPo rest-voltage table (3S default), Telemetry.batt_pct_est property. The bench 11.88 V -> ~63% (the "99%" AP showed was the boot reset). Shown in mission [tel] as ~% and in test_everything battery detail with the caveats (approximate +/-10, sags low under load). AP's batt_pct kept in Telemetry but no longer displayed anywhere.
DASHBOARD (endpoint tests + live browser session on fake data; server stopped, port verified free):
- /api/waypoints GET (route + per-line file errors) / POST (1..50 [lat,lon] validated, atomic write with dated header comment, 403 without control, 409 while a mission runs BECAUSE run_mission read the file at launch and a mid-flight save could not redirect it; letting it "succeed" would deceive the operator).
- SATELLITE UNDERLAY like QGC (user): Esri World Imagery slippy tiles fetched by the BROWSER (field internet = WISP; the board never fetches), drawn under everything by mapping tile corners through the equirect projection (sub-pixel error at survey zooms), auto zoom from proj scale (z<=19), 64-tile cap, 300-tile RAM cap, attribution drawn on canvas (Esri terms), offline -> tiles simply absent, map as before. Verified live: 4 tiles fetched and drawn.
- ROUTE ON THE MAP: numbered waypoints + dashed line, included in the auto-fit so the plan shows BEFORE any flight; hover tooltip with index+coords. EDIT MODE (Edit route -> drag markers -> Save/Revert): markers become handles, projection FREEZES while dragging (re-fitting around the moving point would shift the map under the cursor), Save POSTs and re-reads, Revert re-reads. Edit button hidden while a mission runs / control off / no file. Browser-verified: synthetic drag moved wp1 the right way (px SE -> lat down, lon up), Save persisted to the file.
- SELF-TEST UX (user): previous results are CLEARED the moment a run starts and a progress bar (30 s fill, CSS-smoothed between 3 s polls, capped 97% until results land) replaces the "wait 30 s" text; on the Start click itself, not one poll later. Verified by driving renderSelftest through both transitions.
- PHOTO PANEL DELETED, button merged into the gallery (user): body-photo/phImg/renderPhoto/manual_photo control field//api/manual_photos endpoint all gone; gallery header gained Take photo (hidden when control off; errors inline; on success jumps to the Manual tab where the shot is first). Old saved layouts with the photo panel merge cleanly (mergeLayout drops unknown ids; verified against the existing fixture layout.json).
- make_waypoints.py --out default wp_farm.txt -> wp_field.txt (start_dashboard.sh flies ~/wp_field.txt).
- launch.json repointed to THIS session's scratchpad (fixtures copied over; old session dir may be cleaned anytime).
ANSWERS DELIVERED IN CHAT: serpentine steps RIGHT of the nose heading (build_serpentine: row offset along heading+90 deg clockwise; even rows out, odd rows back); geofence setup procedure + the RC-override answer (fence lives IN the Pixhawk, monitors all modes including full manual; ACTION=1 forces RTL on breach; pilot can retake by mode switch but the fence re-arms; no RC fence-disable switch configured in our params). VERIFY flags kept on the backup-fence re-trigger distance (memory says ~20 m, not confirmed from docs) and on "prearm now needs GPS lock": with FENCE_ENABLE=1 the bench arm re-check indoors may refuse with "PreArm: Fence requires position" -- that is the fence working, not a regression; night-before arm check must be outdoors or done before the push.
STILL OPEN: user flashes the ESP32 (final firmware ready); D0/D1 + SERIAL5 wires still physically in; param push (SERIAL5 -1 + FENCE + AVOID_ENABLE 0) still pending; board pull + start_dashboard.sh run to serve all of this.

### 2026-08-16 ~14:30 IST: polygon fence, prearm visibility, Wi-Fi settings, live self-test (user batch)
VERIFIED-FIRST WORK. Six cheap agents read the aircraft's OWN firmware source (ardupilot-SITL @ Copter-4.7.0, which is exactly what the board runs) plus nmcli/PyPI primary docs; two adversarial verifiers re-checked the fence and prearm claims. Then the fence and prearm code was PROVEN AGAINST RUNNING SITL, not just compiled.
- FENCE IS NOW A HAND-DRAWN POLYGON (user: "the field is not a cylinder or a rectangle, it is a weird shape I have to draw myself"). uno_q/fence.py (NEW): load/save/validate + push/read_back/clear over the MISSION-ITEM protocol with mission_type=MAV_MISSION_TYPE_FENCE(1) and MAV_CMD_NAV_FENCE_POLYGON_VERTEX_INCLUSION(5001), param1=vertex count, x/y=lat/lon*1e7 (MissionItemProtocol_Fence.cpp:100-143). The LEGACY FENCE_POINT protocol is compiled OUT in 4.7 (AC_Fence_config.h:11-20), so anything written against it would silently do nothing - that is why this went through the mission protocol. Min 3 corners, no repeated closing corner. Stored in the FC's own fence storage, survives reboots. SITL PROOF: 5 corners uploaded, read back, exact match; 4-corner round trip through the dashboard endpoint too.
- **THE DANGEROUS FINDING** (my param-file comment was WRONG until SITL corrected it): with FENCE_TYPE bit 2 set and NO polygon stored, Copter 4.7 ARMS NORMALLY. AC_Fence::pre_arm_check_polygon asks _poly_loader.loaded(), and loaded() is `_load_time_ms != 0` (AC_PolyFence_loader.h:165) - an EMPTY fence "loads" fine. Proven live: FENCE_TYPE=7, ENABLE=1, fence cleared, "Arming motors", no complaint. So a fence you drew but never pushed protects NOTHING and the aircraft says NOTHING. Guard added on our side: test_everything's new 'fence' component reads the polygon back out of the aircraft and FAILS when it is missing or differs from the drawn one. Checklist now treats a red 'fence' row as a no-fly.
- param file: FENCE_TYPE 3 -> 7 (alt + circle + polygon) with that whole finding written next to it. Also documented WHY SERVO9_MIN=500/TRIM=560 sit below ArduPilot's documented 800-2200 range and must stay: with FUNCTION=0, DO_SET_SERVO writes the raw pulse (AP_ServoRelayEvents::do_set_servo -> SRV_Channel::set_output_pwm, no constrain), so the range is GCS slider metadata; raising MIN would misdescribe a gate whose measured closed position is 560us. A name/range audit had flagged these two as out-of-range; that is a false positive and is now recorded so it is not "fixed" into breaking the gate.
- PARAM AUDIT RESULT (2 agents, whole file vs 4.7 source): every one of the 65 parameter names exists in 4.7, every enum/bitmask value is valid, no deprecated names, no missing indices. ARMING_SKIPCHK (the 4.7 rename of ARMING_CHECK) already correct. Only findings were the two SERVO9 ones above.
- PREARM IS NOW VISIBLE (user: "make sure that the dashboard shows prearm issues and all that so it can be easily fixed"). mavlink_io: every STATUSTEXT from the autopilot is logged as `[ap] SEVERITY: text` and cached; prearm_messages() matches the real 4.7 prefixes ("PreArm: " idle, "Arm: " during an attempt, MAV_SEVERITY_CRITICAL, AP_Arming.cpp:336-387); SYS_STATUS sensor bits parsed (unhealthy_sensors(), prearm_ok() from MAV_SYS_STATUS_PREARM_CHECK bit 28); run_prearm_checks() sends MAV_CMD_RUN_PREARM_CHECKS(401), which forces an immediate re-report instead of the normal 30 s throttle (GCS_Common.cpp:4995-5004, AP_Arming.cpp:109-111). test_everything gained a 'prearm' component and a --only filter; the dashboard gained a **Check arming** button (~5 s, --only fence,prearm) beside Test everything. SITL PROOF: healthy case reports "prearm checks PASSING"; a forced failure (FENCE_MARGIN 200 > RADIUS 100) reported "WILL NOT ARM: PreArm: Circle FENCE_MARGIN is greater than FENCE_" verbatim (50 chars is the MAVLink STATUSTEXT field limit, not a bug).
- SELF-TEST UX rebuilt to the user's spec: test_everything publishes selftest.json AFTER EVERY COMPONENT with a 'plan' and a 'running' flag, so the panel lists every component name from the start, greys them, drops all ticks/crosses, and fills each verdict in as it lands; progress bar is the real done/total ratio and sits ON the button's row. Verified in the browser through all three states.
- WI-FI SETTINGS PANEL (user; and now load-bearing because THE WISP ROUTER PLAN IS DEAD - the MR3020 kept failing to associate, so the board joins the phone hotspot DIRECTLY). uno_q/wifi.py + dashboard /api/wifi, /api/wifi/scan, /api/wifi/connect. Verified nmcli syntax: TYPE is "802-11-wireless" from `connection show` but "wifi" from `device status`; `-t` escapes colons inside values so parsing splits on UNESCAPED colons only; scan = `rescan` then `list --rescan no` under a timeout. PASSWORD NEVER TOUCHES argv OR ANY LOG: profile is created without the secret, then `connection up ... passwd-file` with a 0600 temp file that is deleted immediately (nmcli has no stdin password path; `device wifi connect password X` would expose it in ps). Panel warns that switching kills the page and the board moves to a new IP. UNVERIFIED, flagged: whether polkit lets a non-root SSH/headless session bring connections up on this board - if not, nmcli's own "not authorized" text is surfaced verbatim so the fix is obvious.
- SATELLITE IMAGERY FIXED ("isn't working at all"): the browser now falls back to a BOARD-SIDE tile proxy (/api/tile/z/x/y, Esri World Imagery, cached to data_dir/tiles) when its own direct fetch fails, so it works whether the laptop or the board has internet - and once cached, with no internet at all. A 'sat: N tiles' / 'sat: no imagery' readout in the map header replaces silent failure; re-ticking the sat box retries from scratch. Verified: 15 tiles direct in the browser, proxy fetch+cache 200/14 KB, bad coords 404.
- WAYPOINTS FROM THE DASHBOARD, both ways the user asked for: click the map to add one at a time, drag to move, right-click to delete, Undo/Clear; or **Generate from aircraft** (rows / ROW LENGTH / spacing / heading fields) which calls make_waypoints' own build_serpentine through /api/waypoints/generate using the aircraft's live GPS. SITL PROOF: 4 rows x 30 m at heading 90 produced 8 waypoints stepping SOUTH (right of east) from the aircraft's real position. Same edit machinery drives the fence (edit.mode = 'route' | 'fence').
- Photo button moved onto the gallery's own button row (space, per user); its error text shares that row.
- FIELD_CHECKLIST rewritten for the hotspot-only network, the fence draw+push step, the fence self-test as a no-fly gate, and start_dashboard.sh as the one SSH command. MR3020 removed from the pack list; power bank now feeds the hotspot phone.
- STILL OPEN: ESP32 flash (instructions given for flashing FROM THE BOARD over the hub with esptool + scp'd binaries, nothing added to the repo per user); D0/D1 + SERIAL5 wires still physically in; param push (SERIAL5 -1 + FENCE_TYPE 7 + AVOID_ENABLE 0) still pending; board pull + start_dashboard.sh.

### 2026-08-16 ~15:00 IST: sat-imagery root cause, one-line rows, esptool facts, ESP32 flash blocked on enumeration
- SATELLITE ROOT CAUSE FOUND (user: "take some logs and find out why. This failure has gone on too long"): the 64-tile cap. When the fitted view is WIDE (the all-flights fit spans every mission plus the route and fence, farm coords + field coords = kilometers), the tile count at the screen-matched zoom exceeded 64 and drawSat returned silently - no tiles, no message, "isn't working at all". FIX: step the zoom down (each step quarters the count) until it fits; imagery gets blurrier, never absent. Proven in the browser: a 15 km fence corner previously drew NOTHING, now draws 33 tiles. LOGGING ADDED per the user's demand: every failed tile URL console.warn'ed, satNote states the live mode/count/failure ("sat: N tiles", "direct fetch failed, retrying via board...", "FAILED direct + via board..."), board-side proxy failures already in dashboard.log. The off-state message and console explicitly name the restart-after-pull case: an old dashboard PROCESS serves the new static HTML but has no /api/tile, so the proxy path 404s until start_dashboard.sh is re-run.
- ONE-LINE ROWS (user, after the gallery refresh button wrapped): .ctlRow.oneline (flex-wrap:nowrap; text spans get .shrink = min-width:0 + ellipsis) applied to the gallery row, the self-test row (Check arming demoted from .big to fit), and both wifi rows. Browser-verified single-line at panel width; wfPass reads 0x0 in tests when a saved network is selected because it is display:none BY DESIGN then.
- ESPTOOL IS NOT DEPRECATED - the user read "DEPRECATED: 'esptool.py'" as the tool dying. Fact (from the tool's own output + setup.py): the .py SUFFIX and the underscore spellings (write_flash, --flash_mode) are deprecated in favour of `esptool` and hyphens; same package, same maintainer (Espressif), v5.3.1 current. The corrected spelling produces zero warnings. It stays installed: it is Espressif's official flasher and the only no-toolchain option on aarch64 (espflash would need Rust or a fetched binary). Explained to the user rather than deleted; if he re-affirms deletion after the explanation, espflash is the fallback.
- THE REAL FLASH FAILURE was never the tool: /dev/ttyUSB0 DOES NOT EXIST. lsusb on the board shows hub + camera + Pixhawk and NO serial chip (no 10c4:ea60 CP2102, no 1a86:7523 CH340); dmesg has zero enumeration events for it. So the ESP32 is not on the hub as data: it is powered by its USB connector FROM A 12V->5V MODULE (user correction: the 5V pin is connected to NOTHING - my back-feed warning withdrawn, recorded), and either it is still plugged into that module, or the cable used is CHARGE-ONLY (power flows, no D+/D-, produces exactly this silence; the 2026-08-14 marginal-cable history fits). To flash: move the ESP32's USB to the hub with a KNOWN-DATA cable, watch dmesg for "new full-speed USB device" + the driver line. IF the device enumerates but no ttyUSB appears, the UNO Q's custom kernel (7.0.0-g122c...) may lack cp210x/ch341 modules - UNVERIFIED on the board, check /lib/modules/$(uname -r)/kernel/drivers/usb/serial/. cdc_acm is present (Pixhawk works).
- TAILNET ONLY (user): never offer the LAN IP again. Tailnet IP is now 100.113.28.52 (third IP; proven by successful scp; PRIVATE.md updated). The scp of the four flash binaries to ~/esp32fw/ SUCCEEDED via tailnet.
- launch.json still points the fake dashboard at tcp:127.0.0.1:5760 (SITL) for conn; harmless when SITL is down (control panel shows errors only on use).

### 2026-08-16 ~15:20 IST: USB HOST CONTROLLER ABSENT AFTER REBOOT - camera + Pixhawk + everything gone, not just the ESP32
- Sequence: ESP32 plugged into the hub produced ZERO dmesg events (three tails, nothing - consistent with the charge-only-cable theory). User warm-rebooted (`sudo reboot`). After the reboot `lsusb` prints NOTHING AT ALL, even under sudo: not even the two Linux Foundation root hubs that were always there. That means the SoC's xhci/dwc3 USB host controller did not register this boot; the camera and the Pixhawk are as gone as the ESP32.
- Supporting detail: the new boot's visible dmesg tail has "l5: disabling" at ~33 s but NOT the "usb_vbus: disabling" line that every earlier boot showed alongside it - consistent with the USB path never probing (a regulator that never registered cannot be disabled as unused). The kernel cmdline has deferred_probe_timeout=30, and this SoC's USB block sits in a documented dependency web (usb@4e00000 <-> phy@1615000 <-> i2c encoder), so a deferred-probe failure stays failed for the whole boot.
- CAUSE UNVERIFIED. Candidates, none confirmed: (a) transient probe race that a boot can win or lose; (b) something about what is NOW physically plugged (the ESP32 went into the hub right before the reboot) holding VBUS or data lines in a state the controller/PHY dislikes at probe time; (c) coincidence. The previous boot RAN FINE for 2.4 h with the ESP32 experiments happening, so simple breakage of the port by the ESP32 is not established.
- PLAN GIVEN (evidence first, then cold boot): capture `dmesg | grep -iE "xhci|dwc3|usb|phy"` from THIS broken boot before touching anything; unplug the ESP32 from the hub (isolate the one variable that changed); FULL POWER OFF with power physically removed 10 s (a warm reboot does not drop the PMIC rails or reset a latched VBUS protector; this one did not), power back on with only hub+camera+Pixhawk; then lsusb + the same grep. If root hubs return, replug and proceed; if not, next suspect is the boot-time probe with the evidence grep in hand.
- Aircraft is UNFLYABLE until USB returns (no camera, no Pixhawk link from the board). ESP32 flash obviously on hold.

### 2026-08-16 ~16:45 IST: USB restored by cold boot; ESP32-in-hub-at-boot is the suspect
- Cold boot (full power removal, ESP32 unplugged) brought everything back: both root hubs, Genesys hub, camera, Pixhawk, all enumerated normally (xhci at 5.6 s as always).
- The broken boot's captured grep is conclusive about WHAT failed, not why: "platform 4e00000.usb: Adding to iommu group 7" happened, then xhci-hcd NEVER registered that boot (healthy boots register it ~5.6 s). usbcore/hub-class drivers were all fine; the CONTROLLER probe is what went missing, with the ESP32 plugged into the hub during power-up as the only physical difference.
- WORKING RULE (one occurrence, cause UNVERIFIED - do not state as fact): the ESP32 must NOT be in the hub while the board boots; hot-plug it after boot. If lsusb ever comes back empty again: unplug ESP32, FULL power cycle (warm reboot proven insufficient), then investigate with dmesg | grep -iE "xhci|dwc3|usb".
- Flash sequence re-issued for the hot-plug path with the known-good DATA cable (buck-module cable suspected charge-only). Expected outcomes documented: enumeration+ttyUSB0 -> flash; enumeration without ttyUSB -> kernel driver missing (cp210x/ch341 availability on this custom kernel still UNVERIFIED); total silence -> other hub port, then suspect the ESP32's USB-serial chip itself.

### 2026-08-16 ~16:55 IST: third silence with the same cable, healthy bus
- Hot-plugged the ESP32 into the hub with the SAME (buck-module) cable on the freshly cold-booted, proven-healthy bus: dmesg shows NOTHING at plug time (last line is 49 s boot noise), no enumeration attempt, no ttyUSB. Third total silence with this cable.
- What this exonerates: kernel serial drivers (cp210x/ch341 missing would still show usbcore's "new full-speed USB device" line; there is no line at all) and, mostly, the board's USB path (camera + Pixhawk live on it right now).
- Remaining suspects, in order: (1) this cable is charge-only; (2) the ESP32's onboard USB-serial chip. Discriminators given to the user: swap to a PROVEN-DATA cable - the one that flashed this same ESP32 from the laptop on 2026-08-14 is proven, the Pixhawk data cable works if the connector matches; try another hub port while at it; if STILL silent, plug ESP32+cable into the LAPTOP (working USB, cp210x/ch341 confirmed present there) to split cable-vs-board definitively.

### 2026-08-16 ~17:00 IST: ESP32 FLASHED (final reliability firmware is ON the chip). "Crystal problem" = measurement artifact, not hardware
- Flash from the BOARD over the hub SUCCEEDED end to end: cp210x enumerated on the known-good data cable (confirming the buck-module cable was the earlier silence), all four images written at 57600 --no-stub, every hash verified, auto-reset fired. The hot-plug-after-boot rule held (no USB controller incident).
- The "Detected crystal freq 7.66 MHz ... Unsupported crystal?" warning is esptool ESTIMATING the crystal from serial timing, and that estimate is garbage on this deliberately-slowed marginal-cable setup. It cannot be a real 7.66 MHz crystal: a crystal 3x off would scale the ROM's UART baud by the same factor and NO byte would have transferred, yet 300+ KB moved with verified hashes. Additionally this same module ran the previous firmware (same build config, same clock assumptions) for weeks with a working 115200 MAVLink link, so the build's crystal assumption matches the physical part. NOTHING TO FIX; warning recorded so it is never chased again.
- Definitive proof is functional and comes free with the new firmware: it prints its banner + per-channel health on USB serial (115200), sends "prx ring N/6" STATUSTEXT every 15 s, and announces LOST/BACK transitions. Verification path given: optional miniterm on ttyUSB0 now, else reinstall on the buck module and press Test everything (ring row + "prx" lines in ~/logs/test_everything.log).
- Remaining on the day's list: reinstall ESP32 in the airframe, dashboard Test everything (camera+Pixhawk+ring+luna+fence+prearm), param push night-before (SERIAL5 -1, FENCE_TYPE 7, AVOID_ENABLE 0), draw+push the polygon fence, D0/D1+SERIAL5 wires out.

### 2026-08-16 ~18:45 IST: miniterm verdict (fw GOOD, ch1+ch2 hardware-dead); site map mystery SOLVED with evidence; stop script; Arm rename
- MINITERM PROVES THE NEW FIRMWARE RUNS: [health] lines every 15 s + "[sensors] chN: re-init failed, next try in 5000 ms" retries exist ONLY in the 2026-08-16 firmware. Ring truth: ch0/ch3/ch4/ch5 + up alive (4/6), ch1 and ch2 DOWN with Wire "Error 263" = I2C timeout at init, retried every 10 s, never answering. That is HARDWARE per channel, not firmware: ch2 = the known dead chip (2026-08-14, four bus speeds); ch1 is a NEW casualty (was counted alive in the "~5 achievable" era) - prime suspect is wiring at the TCA9548A ch1 / sensor plug disturbed during the flash-session handling. Reseat first; swap a known-good sensor onto the channel to split chip-vs-mux. HOT-PLUG ANSWER (user asked): yes - a working chip put on ch2 (or ch1) is picked up by the 10 s re-init automatically, announced "BACK", no reflash, no reboot.
- OCCASIONAL per-reading ERR on LIVE channels (s4 especially) = single VL53L0X ranging failures at very close range/bench clutter, normal; DOWN(eN) in [health] is the real status. Bench readings 5-8 cm on s3/s4/UP are objects near the bench, not faults.
- RING SELF-TEST WAS LYING ("self-heal firmware NOT yet flashed"): it guessed firmware age from bearing-bin count, but bins only show sectors that SEE an object during the window (a sensor staring at open air fills no bin), so a bench run undercounts forever. REWRITTEN (test_everything.py): the ESP32's own 15 s "prx ring N/6" STATUSTEXT (cached in tel.statustexts) is now the alive-count ground truth; pass = alive >= 5 (ch2-dead ceiling); bins reported separately as "see an object right now"; no-health-text fallback names the two honest possibilities (old fw, or TELEM2 STATUSTEXT not forwarded) instead of guessing. Whether the ESP32's STATUSTEXT is actually forwarded Pixhawk->USB is UNVERIFIED until the next assembled Test everything.
- SITE MAP "STILL BROKEN" - EVIDENCE COLLECTED LIVE FROM THE BOARD (user authorized: "time you check the logs"): curl of http://100.113.28.52:8080/ returned index.html BYTE-IDENTICAL to repo HEAD (satNote + z-clamp present) with Cache-Control: no-cache already on it; /api/tile/3/5/3 from the RUNNING process returned a real 15.7 KB Esri JPEG (proves post-pull process, working proxy, board internet). Server side is fully healthy. Therefore the grey map = A BROWSER TAB OPENED BEFORE THE 12:42 PULL AND NEVER RELOADED: an open tab keeps its old JS (with the silent 64-tile skip) forever; the self-test panel still works from such a tab because the API endpoints are unchanged, which is exactly why it looked "half fixed". ONE RELOAD of the page shows the fix.
- SO THIS CLASS DIES: (1) /api/control now carries ui_mtime (index.html mtime); the page records the first value and a later change shows a red RELOAD PAGE banner in the header within 3 s (kept SHORT after a long banner wrapped the header flex row at 1280 px in testing; tooltip carries the explanation). Browser-verified end to end: touch index.html -> banner appears. (2) Tab title now carries the build ("· ui 2026-08-16b") so "which page am I looking at" is answerable at a glance; bump UI_VER on UI changes. (3) index route sets Cache-Control: no-cache EXPLICITLY (was Werkzeug-default behavior, now pinned). Header baseline width verified unchanged (empty span = zero px).
- uno_q/stop_dashboard.sh NEW (user asked): SIGTERM the dashboard.py process (start_dashboard.sh's own pattern), 10 s grace, SIGKILL fallback, never touches run_mission, appends every action to ~/logs/dashboard.log (DASH_LOG override for off-board testing). Live-tested: stopped the real local dashboard on SIGTERM, idempotent "nothing to stop" second run, exit codes correct.
- "Arm controls" button renamed to "Arm" (user). Same two-step behavior (unlocks START for 8 s); armed-state label unchanged.
- Board steps queued for the user: board git pull, stop+start dashboard, RELOAD the dashboard tab, reseat ch1 wiring, re-run Test everything assembled.

### 2026-08-16 ~19:00 IST: ARM caps; board-probe ban recorded; diag script for the still-grey map
- "Arm" -> "ARM" / "ARMED – click START" (user: match START MISSION / STOP (RTL) caps; the lowercase label simply predated the big-button styling). UI_VER bumped to 2026-08-16c.
- NEW STANDING RULE recorded in CLAUDE.md (user, emphatic): assistant probes COUNT as commands; nothing that terminates at the board, ever, read-only included; assistant commands stay on this laptop inside the repo dir; board evidence = repo scripts run BY THE USER. Yesterday's curl probes of the board were over the line under this rule.
- SITE MAP still grey for the user. Server-side facts already proven (12:42-18:33): board serves the fixed page byte-identical to repo, proxy fetched a real Esri JPEG, Cache-Control: no-cache on /. What is still UNKNOWN is only the CLIENT side: which page build their browser runs and what the page's own sat status line says.
- uno_q/diag_dashboard.sh NEW: one user-run command prints repo HEAD, dashboard pid/age, the UI_VER of the page the RUNNING server serves, a tile through the proxy (first-bytes JPEG check), direct board->Esri HTTP code, tile-cache count, and the tile/satellite + tail lines of dashboard.log; appends to ~/logs/diag_dashboard.log. Tested off-board in degraded mode (no server: every section prints and labels its failure; Esri URL string proven with a live HTTP 200/15684 B).
- The two client-side answers requested from the user alongside the script output: (1) browser tab title (carries "ui 2026-08-16x" on current builds; absence = pre-noon page), (2) the "sat:" note next to the map layer checkboxes (new page always states tiles drawn / failure reason; absence of the note = stale page). If the header shows red RELOAD PAGE, reload is the whole fix.
- AWAITING USER: board git pull; diag_dashboard.sh output paste; the two answers above; then ch1 reseat + assembled Test everything.

### 2026-08-16 ~19:25 IST: diag output read; dashboard was simply STOPPED at diag time; one-tile cache pins the stale-tab diagnosis
- User ran diag_dashboard.sh at 19:17:11 with board HEAD = 6812ef2 (fully current). Sections "NOT RUNNING"/"FAILED to fetch /"/proxy HTTP 000 are all one fact: the user had run stop_dashboard.sh at 19:15:43 (their own log lines show it) and had not restarted; the diag measured a stopped server, not a broken one. Esri DIRECT from the board: HTTP 200 = board internet fine.
- SMOKING GUN: "1 cached tiles under ~/monsoonready_data/tiles" after ~5 h of current server code = the assistant's single 18:33 probe (z3/x5/y3). NO browser has EVER requested a tile through the proxy. A current page in their browser would either draw tiles direct (their laptop is online) or fall back through the proxy and fill that cache; zero user-driven tile traffic + grey map is only consistent with the viewing tab still running the pre-12:42 page. Reload of THAT tab (or a fresh tab) remains the entire fix; the old page cannot show the RELOAD banner (no uiStaleCheck in it), so this one reload is manual.
- Timeline reconstructed from their log tail: 18:12 dashboard up (post-pull code; served the 18:13 photo + 18:13 test), 18:47 stop via new script, 18:49 start, self-tests 18:51 + 18:59 (these ran the NEW health-based ring check; output not yet seen), 19:15 stop, 19:17 diag. Their "STILL no imagery" observation (~19:05) happened against a fully-current server = client-side page stale.
- ASKED OF USER (again, still unanswered): after start_dashboard.sh, open the dashboard in a fresh tab; tab title must read "MonsoonReady base station · ui 2026-08-16c"; if map still grey, report the exact tab title and the "sat:" note text next to the layer checkboxes.

### 2026-08-16 ~19:55 IST: THE REAL SITE-MAP ROOT CAUSE (empty board = no geo anchor); manual site anchor shipped; ARM caps
- User's screenshot ended the hunt: tab title showed ui 2026-08-16c (page CURRENT), yet map grey with "All flights (0)", "no waypoints" pill, no fence. ROOT CAUSE: this board has NO geodata of any kind, and proj.fit() with zero points sets proj.ok=false, which shows "No mission data yet" and EARLY-RETURNS before drawSat/fence/route (render() line ~1545). The imagery was never going to draw on a virgin board no matter how correct the tile code was. Every earlier server-side finding (byte-identical page, working proxy, no-cache) was true and beside the point; my earlier test data always had waypoints so the empty case was never exercised. The 12:42-18:xx "stale tab" story explained the intermediate window but NOT the final grey.
- WORSE, CONFIRMED BY 3-AGENT READ (sonnet, read-only): on an empty board "Draw fence" was a complete dead end: the #empty overlay (no pointer-events:none) swallowed every canvas click, and even without it unproject() would fabricate NaN corners because fit() bails before initializing lon0/s/ox/oy. So the user's entire planned workflow (draw fence at home BEFORE any flight) was impossible.
- FIX (index.html, UI_VER 2026-08-16d): MANUAL SITE ANCHOR. Empty map now shows, inside the placeholder, "paste its coordinates from Google Maps" + input + Show site. Parses "lat, lon", validates, stores mr-site-anchor-v1 in localStorage (try/catch pattern like mr-theme/mr-layout-v3), and feeds a 400 m box around it into the SAME proj.fit path. Anchor fills a vacuum only: any real geometry (events/route/fence/site image) excludes it, EXCEPT while edit.mode is active, where it keeps steadying the frame (without that, the first placed corner would refit to the 10 m minimum span and the view would leap mid-draw). A small bottom-left chip "site LAT, LON · change" shows while the anchor is the only source; clicking reopens the form prefilled (siteAskOpen flag; render's display toggle now honors it; cancel link when a map exists behind). Canvas mousedown now guards if(!proj.ok) so the NaN class is dead even if overlays change later.
- GOTCHA FIXED DURING VERIFY: showing the chip via style.display='' fell back to the stylesheet's display:none; must set 'block'.
- BROWSER-VERIFIED END TO END against a replica empty board (basestation-empty launch config, port 8081, empty data dir + missing waypoints file): first load shows prompt; typing coords -> 12-35 tiles drawn + chip; Draw fence -> 4 corners clicked at sane lat/lons, view stable, chip hidden while editing; Save -> fence.json written server-side (verified on disk); localStorage wiped + reload -> map fits the SAVED FENCE with tiles, no chip, no prompt (permanent handoff). Regression: data-rich fixtures render unchanged (323 events, 6 wps, 12 tiles, no chip).
- Also this turn: ARM / ARMED – click START caps (user: match sibling buttons; lowercase label predated the styling).
- Screenshot also confirmed working end-to-end: ESP32 "prx ring 4/6 up:ok" STATUSTEXT reaches the dashboard through the Pixhawk (health-based ring row live: bins [4,5,7] while 4/6 alive), prearm reasons on the control panel ("RC not found | Hardware safety switch"), wifi settings panel populated. ch1+ch2 hardware diagnosis unchanged.
- USER PATH TO IMAGERY NOW: board git pull + restart dashboard + reload page (title must say ui 2026-08-16d), then paste the field's coordinates once into the map prompt; draw + Save + Push fence as before. GPS-anchored/route data replaces the typed anchor automatically from the first save onward.

### 2026-08-16 ~20:10 IST: imagery CONFIRMED WORKING by the user; base-zoom panning enabled
- User confirms the site map now shows correct satellite imagery (typed-anchor path working on the real board). Remaining complaint: dragging did not pan at all.
- CAUSE: two deliberate old clamps from the fit-everything era: mousedown ignored drags at view.k===1, and the wheel handler zeroed tx/ty whenever zoom returned to 1. Both assumed base zoom always framed ALL data; with a typed 400 m anchor the world extends past the frame, so base zoom must pan.
- FIX (index.html, UI_VER 2026-08-16e): pan at any zoom; zoom-out no longer discards the pan; dbl-click remains the reset-to-fit gesture (legend already says so). Edit-mode semantics unchanged: at base zoom a plain click still ADDS a corner (that branch runs before pan starts), shift+click adds while zoomed.
- BROWSER-VERIFIED: base-zoom drag of 200 px moved the view center 113 m ground distance with tiles following (12 -> 21 loaded); pan survives a zoom-in/out cycle; dbl-click resets to {k:1,tx:0,ty:0}; fence-edit click at base zoom still adds exactly one corner.
- Note for the user path: HTML-only change, so board git pull + page reload suffices, no dashboard restart; their open 16d tab should show the red RELOAD PAGE banner within 3 s of the pull (first live use of the ui_mtime detector).

### 2026-08-16 ~20:35 IST: fence-drawing glitchiness fixed (click-vs-drag dead zone + frozen frame while editing)
- User: imagery works, but while building a geofence "the movement and adding points are very glitchy". BOTH causes were interactions of the new pan-at-any-zoom with the old editor:
  (1) at base zoom, mousedown ADDED A CORNER IMMEDIATELY (old view.k===1 branch), so every attempted pan during editing splattered corners and never panned;
  (2) every added corner changed the pts fed to proj.fit, so the frame refit and the map lurched under the cursor on each click (with a 400 m anchor the union-of-extents visibly jumps; with old flight-heavy data it never did).
- FIX (index.html, UI_VER 2026-08-16f):
  (1) CLICK-VS-DRAG: mousedown only records intent; a 5 px dead zone decides on mouseup. Stationary press in edit mode = corner added at the DOWN position; movement past 5 px = pan (at any zoom, edit or not). Plain click now also adds while ZOOMED (shift-click no longer needed; edHint text updated to "click map = add · drag corner = move · drag map = pan · right-click = delete").
  (2) FROZEN BASE: render() keeps a baseFit snapshot (pre-applyView fit fields); while edit.mode or a marker drag is active it restores baseFit instead of refitting, then applies pan/zoom on top, so the frame NEVER refits mid-edit; Save/Cancel unfreezes and refits to the result.
- BROWSER-VERIFIED (empty-board replica): stationary click adds with proj frame bit-identical before/after; 120 px drag pans, adds nothing; 3 px jitter still adds; zoomed (k=1.25) plain click adds; corner grab-drag moves the corner 20 m with the view untouched.
- TEST ARTIFACT worth remembering: entering edit mode reflows the map panel (canvas rect shifts ~27 px up when Save/Cancel appear), so synthetic clicks using a rect captured BEFORE fnEdit land 27 px off and "miss" corner handles. The app always reads a fresh rect per event and was never broken for a real mouse; two probe rounds chased this ghost.
- User path: board git pull + page reload only (HTML-only change); tab title must say ui 2026-08-16f.

### 2026-08-16 ~20:45 IST: map zoom-out floor 1 -> 1/64; param push moved to the BOARD CLI
- ZOOM (index.html, UI_VER 2026-08-16g): the wheel clamp was `Math.max(1, ...)`, i.e. you could never see WIDER than the auto-fit frame (with a fresh site anchor that is a 400 m box, so a neighbouring field was unreachable). Floor is now 1/64, symmetric with the existing 64x ceiling. BROWSER-VERIFIED on the empty-board replica: k 1 -> 0.01563, canvas span 440 m -> 29.5 km, back in to k 64 = 7 m across; 229 Esri tiles loaded across z12-z19 with 0 failures, so imagery follows all the way out (the zoom picker walks down to TILE_MIN_Z 3 and the 64-tile budget steps it down further). User reports fence drawing now works.
- PARAM PUSH IS NOW A BOARD COMMAND, not a laptop one, because the Pixhawk USB goes to the UNO Q since the shovel chain was deleted (2026-08-16 conn = Pixhawk USB by-id). Board interpreter is `~/venv/bin/python` (board_setup.sh installs pymavlink there); the repo `./python` wrapper is the LAPTOP venv and does not exist on the board.
      ~/venv/bin/python ~/monsoonready-drone/tools/parameters.py push
  Pushes param_dumps/pixhawk_full_setup.param (72 params, tracked in git) with per-write echo verification; exit 1 if anything is refused or unechoed.
- GOTCHAS recorded so the push is not misread: (a) mavlink_link auto-picks the port only when EXACTLY ONE candidate is present, so if the ESP32 is plugged into the board's USB hub it will refuse and needs `--conn /dev/ttyACM0`; (b) the dashboard opens the Pixhawk link only per-action, so an idle dashboard is safe, but Test everything / generate waypoints / fence push / start mission during the push would fight for the port; (c) SERIAL5_PROTOCOL -1 and PRX1_TYPE 2 are in the NEEDS_REBOOT table, so the Pixhawk must be power-cycled after the push before those two mean anything (the tool prints this); (d) FENCE_ENABLE 1 lands with the push, so a later indoor arm check may refuse with "PreArm: Fence requires position" - that is the fence working, not a regression.

## 2026-08-17 FUNDAMENTAL-PROBLEMS SCAN (user-requested; analysis only, nothing fixed; laptop repo only, no board contact)
Scope per the user: problems of the class "vibration -> blurry photos -> AI cannot analyse", i.e. physics/system-level gaps rather than code bugs. Sources: full PROJECT_STATE read + code read (mission.py, detector.py, camera.py, detect_worker.py, run_mission.py, dropper.py, mavlink_io.py, pixhawk_full_setup.param). FINDINGS ONLY, not TODOs (user owns the TODO list). Ranked by demo consequence.
1. AERIAL DOMAIN GAP: detection from altitude is unproven. Training data is ground-level/oblique Roboflow sets; dataset-v2 nadir capture (TODO 10) never happened; recall 0.70 on val with known sheet-water/glare misses; NO in-flight image from this aircraft has ever been through the model. At 15 m a 0.6 m object is ~24 px (below reliable size). The planned demo target is a 2-3 m wet DIRT patch = damp soil, not specular standing water, and may not read as "puddle" to a water-trained model. As scheduled, the first end-to-end detection happens during the take. **RETRACTED SAME DAY (user): the training photos ARE nadir. See USER TRIAGE below; do not repeat the viewpoint-gap claim.**
2. MOTION/VIBRATION BLUR CONFIRMED UNMITIGATED (the user's example is real). camera.py locks focus only; NOTHING in the repo touches exposure/gain, so the B525's auto-exposure picks the shutter and lengthens it in dull monsoon light. Ground sampling at 15 m / 56.2 deg / 1280 px = 12.5 mm/px, so 3 m/s ground speed at a 1/30 s shutter smears ~8 px (arithmetic from measured HFOV, not a measurement); angular vibration on the hard mount (no damping, no gimbal, rolling shutter jello) multiplies it. No sharpness check exists anywhere in the detection path, so blurred frames are silently inferred on.
3. SURVEY SPEED IS UNCOMMANDED ANYWHERE. mission.py goto() sends position targets without speed, mavlink_io has no speed command, and pixhawk_full_setup.param contains NO WPNAV*/ANGLE_MAX lines, so GUIDED legs run at firmware default (Copter default WPNAV_SPEED believed ~10 m/s, FROM MEMORY, UNVERIFIED - read it from the board or a log before relying on any number). Every coverage/blur figure in this file assumed ~3 m/s. At default speed the 9 m along-track footprint at ~0.5-1 s/frame can cross a 2.5 m patch with ~0-1 frames on it, and finding 2's blur scales with speed.
4. THE TREAT STEP OVER REAL WATER IS UNSOLVED END TO END. Settled verdict: TF-Luna never works over still water, descend-beside is the only route. But lateral_offset_n/e_m default 0.0 (mission.py:82) and run_mission.py EXPOSES NO FLAG for them, so the system as launchable descends directly OVER the water, where the dropout logic (mission.py:315-343) aborts; the aborted site latches into detector._fired (8 m radius) and is deliberately never retried, so one-target demo + one abort = zero drops for the whole flight. The wet-dirt demo target sidesteps the physics (damp dirt returns a normal Luna echo) rather than proving it. And even with offsets set, the 2026-08-09 open question stands unanswered: released BESIDE the water, how do the granules reach it?
5. "TREATED" HAS NO PHYSICAL EVIDENCE. Drop success = the autopilot ACCEPTING the gate command (dropper.py:155 "gate cycles the autopilot accepted"); nothing senses granules actually leaving. Flow rate never measured, hopper+salt flow never bench-tested (TODO 3), and Bti granules in monsoon humidity are the bridging/clumping case; a bridged or empty hopper still logs ok:true, paints "treated" on the judged dashboard, and halves predict.py's revisit score for a site that received nothing.
6. TARGETING ERROR STACK IS COMPARABLE TO THE TARGET SIZE. One-shot latch from 15 m: aircraft GPS error at latch time + again during approach (each ~1-2.5 m class, approximate), HFOV error proportional in the offset, AGL from rel_alt-above-HOME (terrain datum error class, old TODO 10f), wp_radius 1.5 m acceptance, and deliberately no re-detection during descent. Total plausible miss is metres against a 2-3 m puddle, and nothing verifies the gate is actually over water at release (the drop event records the AIRCRAFT's position).
7. DOWNWASH AT RELEASE, UNQUANTIFIED. drop_alt 3 m is inside the hexa's own outwash; light granules released there can be scattered off a small target, and the surface ripples. Never tested at any height: the first live granule drop of the entire project is currently scheduled to happen on camera. **RETRACTED SAME DAY (user-settled, do not re-raise): the dropper outlet is nowhere near the wash. See USER TRIAGE.**
8. COMPASS INTERFERENCE UNRESOLVED. Farm logs 43/45: mag field 1038 and 1058 vs max 875 (~19% strong), repeatable across power cycles, plus EKF variance/glitch events. Cause undiagnosed (interference vs stale calibration after the rebuilds). It blocks arming and threatens yaw/EKF mid-flight; currently carried only as a checklist caveat.
9. RC LINK INTERMITTENCY DISMISSED, NOT RESOLVED. Three ABSENT/UNHEALTHY-with-dropout results (2026-08-14/15) were closed with "TX works we already know that" while the TX's on/off state during those runs was never established. If the intermittency is real, an RC failsafe RTLs through the take, and the manual-abort channel - the only human backstop, with avoidance off and the rear unmonitored - is unreliable. **CLOSED SAME DAY (user): the TX WAS OFF during those runs. See USER TRIAGE.**
10. PACKAGING VS ENVIRONMENT (heat, vibration, water). Both measured field failures of this project were CONNECTIONS, not code: the farm camera loss (USB plug/enumeration under flight vibration) and ring channels dying one by one on the hot sealed frame. Hand-spliced dupont/USB connectors plus a single USB hub carrying BOTH the camera and the Pixhawk link are single points of failure under exactly the conditions of use. Separately, the product premise is monsoon while the aircraft has no conformal coat yet (deliberately last), an open hopper, and a bare lens: rain = no-fly, a wet lens blinds the model. And endurance 13 min usable = one small plot per pack. Demo-compatible, but each needs honest framing for judges.

USER TRIAGE OF THE SCAN, 2026-08-17 (user, primary source; whys kept per truth rule 8):
- Finding 1 RETRACTED: the training photos ARE nadir (user knows the merged set; my "ground-level/oblique" over-generalized the 2026-07-25 note that the FUMIGATION sets are ground-robot view). What survives: no image captured by THIS aircraft in flight has been through the model yet (retire cheaply with one pre-take test flight), and the small-target floor (0.6 m at 15 m = 24 px) stands, already handled by the 2-3 m patch.
- Finding 3 STANDS but reclassified EASILY SOLVED, and was misread: "legs" = survey path segments, not landing gear. Mission code sends position targets only, never a speed; transit speed is the autopilot's WPNAV_SPEED, absent from pixhawk_full_setup.param, so firmware default applies (believed ~10 m/s, UNVERIFIED, read from board/log). Fix = user sets WPNAV_SPEED (~300 cm/s class) in the file + push, then verify actual ground speed from the next .bin. NOT added to the file by the assistant (user owns the change).
- Finding 6 DOWNGRADED (user: calibration, easily fixed; correct for the dominant terms): HFOV is now measured, and latch + approach use the SAME receiver minutes apart, so absolute GPS error is largely common-mode and cancels. Residuals only: frame<->telemetry pairing error scales with speed (shrinks with the finding-3 fix), wind position-hold error, wp_radius 1.5 m acceptance.
- Finding 7 RETRACTED, user-settled, do not re-raise: the dropper outlet is nowhere near the rotor wash (hopper at CG, wash at the rotor ring; dense granules, ~0.8 s fall from 3 m).
- Finding 8 DOWNGRADED (user: calibration issue): plan = compass recal outdoors away from metal (already bench plan D.14), then confirm mag field < 875 in the next log. Escalate to interference-hunting ONLY if it recurs after a good recal.
- Finding 9 RESOLVED AND CLOSED (user): the TX WAS OFF during those three runs, answering the 2026-08-14 open question; the ABSENT/UNHEALTHY results were the check working as designed. RC link is reliable per user. The checklist arm gate (RC PASS with TX on) stays as-is.
- Findings 2, 4, 5, 10 UNDISPUTED = the FUNDAMENTAL list: camera blur physics (2), treat-over-real-water design gap incl. unset/unexposed lateral offsets + granules-into-water-from-beside + abort-latches-site-forever (4), no physical dispense confirmation (5; the flow-rate BENCH half is the easy part, TODO 3), packaging-vs-environment class (10).

### 2026-08-17 ~18:55 IST: SiK radio degraded (param download now 10 min and incomplete) - OPEN, no evidence yet
- USER REPORT: full param transfer used to complete in about 1 minute over the SiK; now it takes ~10 minutes and ends with "vehicle failed to send all the params". Which program produced that wording, and on which machine, is NOT yet known (it is not tools/parameters.py's wording; QGC/Mission Planner phrase it that way), so the report is recorded as-is and not interpreted further.
- WHAT THE SYMPTOM DOES SAY: this is throughput/packet-loss, not a dead radio. A dead or mispaired link delivers NOTHING (mismatched NETID/air rate = no connection at all), so 10 minutes of partial params means the link is up and losing or starving packets.
- TWO FAMILIES, both unproven: (a) RF/link quality dropped - antenna loose at either end, TELEM2 connector disturbed during the ESP32 refit, ground dongle moved onto a hub, more distance/obstruction, or a sagging TELEM 5V rail; (b) the link now carries more traffic than it did - the ESP32 ring is alive again with PRX1_TYPE=2, so proximity/rangefinder telemetry may be sharing the same 57600 bps as the param transfer. WHICH stream group carries DISTANCE_SENSOR/OBSTACLE_DISTANCE, and at what SR2_* rate, is NOT VERIFIED (the ArduPilot source tree is outside this repo and the standing rule keeps assistant commands inside it), so (b) is a hypothesis to measure, never a stated cause.
- WHAT THE PUSH FILE DOES NOT EXPLAIN: pixhawk_full_setup.param contains no SR* stream-rate lines at all, and SERIAL2_PROTOCOL=2 / SERIAL2_BAUD=57 are unchanged from every previous push, so the recent param push did not alter the radio's port config or stream rates.
- NOTE ALREADY IN THE TOOL: parameters.py's docstring says push over USB, not the radio ("many small round trips and every retry costs radio time"). If the slow attempt WAS a push over the SiK, slowness is expected behaviour, not a new fault.
- PROPOSED NEXT STEP (offered, not written): a `tools/bench.py link` probe that reads RADIO_STATUS (rssi, remrssi, noise, rxerrors, fixed) and counts messages/bytes per type for 20 s, which separates family (a) from family (b) with evidence. Awaiting the user's answers first.

### 2026-08-17 ~19:10 IST: SiK param failure is QGC-side, on BOTH machines, with the ESP32 alive
- NEW EVIDENCE: the message is QGroundControl's own dialog ("QGroundControl was unable to retrieve the full set of parameters from vehicle 1"), and it happens on the Linux laptop AND the MacBook. Connectors tight, nothing unplugged, ESP32 POWERED during the attempts. Two different ground stations failing identically moves the suspicion off the ground dongle/driver and onto the aircraft side or the link itself.
- HYPOTHESIS A, BANDWIDTH: the ESP32 is a MAVLink node on TELEM1 (SERIAL1_PROTOCOL=2) transmitting at TX_RATE_HZ=10 (config.h:237). OBSTACLE_DISTANCE carries all 72 sector slots and unused sectors are 65535, NOT zero, so MAVLink2 trailing-zero truncation does nothing: 167-byte payload + 12 = ~179 bytes on the wire, ~1.8 kB/s, plus the up-sensor DISTANCE_SENSOR at 10 Hz and a 1 Hz heartbeat, so roughly 2 kB/s. If ArduPilot forwards that broadcast traffic from TELEM1 out to TELEM2, it competes with the param download on a 57600 SiK whose real throughput is well under its serial rate. NOT VERIFIED: ArduPilot's MAVLink routing/forwarding rule has NOT been read from source, because the source tree (/media/sleuther/Stuff/ardupilot-SITL) is outside this repo and the standing rule keeps assistant commands inside it. Permission requested from the user; until then this stays a hypothesis.
- HYPOTHESIS B, QGC CHASING COMPONENT 195: the ESP32 heartbeats as comp 195 (HEARTBEAT_PERIOD_MS 1000). QGC downloads parameters per component, and a component that heartbeats but implements no param protocol can leave QGC retrying and eventually declaring the set incomplete. Also NOT VERIFIED (QGC's per-component param behaviour not read from source). It fits the facts as well as A does: it is new (the ring only came back alive after the reflash), machine-independent, and slow-then-fail rather than dead.
- THE TEST THAT SEPARATES THEM, no code needed: (1) QGC Analyze view -> MAVLink Inspector while connected over the SiK: OBSTACLE_DISTANCE arriving at ~10 Hz means A; comp 195 present but no ring traffic means B. (2) `tools/parameters.py pull` over the SiK from the laptop: mavlink_link targets the AUTOPILOT explicitly (comp 195 is the documented reason it exists), so our tool is immune to B. If our pull completes in about a minute while QGC fails, the RF link is fine and B is the answer. (3) Power the ESP32 down and retry QGC: a fast, complete download proves the ESP32 is involved either way.
- IF A IS CONFIRMED: the ring is display/logging only (AVOID_ENABLE 0), so TX_RATE_HZ 10 -> 2 in config.h costs nothing operationally and cuts the forwarded load by 5x. Requires an ESP32 reflash, so it is a decision for the user, not an automatic fix.

### 2026-08-17 ~19:25 IST: SiK loss is REAL PACKET LOSS, not QGC; ArduPilot 4.7.0 forwarding CONFIRMED FROM SOURCE
- HYPOTHESIS B (QGC chasing comp 195) IS DEAD. `tools/parameters.py pull` over the SiK, which targets the autopilot explicitly and never talks to comp 195, ALSO failed: 730/1035 then 796/1035 parameters, with a DIFFERENT missing set each run. Two runs, two different holes = ordinary packet loss on the link, not a protocol quirk.
- READ THE WARNING LIST CORRECTLY: the "these setup params do NOT exist on this firmware" block at the end of each pull is an ARTEFACT of the incomplete dump. It lists whatever went missing that run (FENCE_TYPE, SERVO9_*, BATT_* ...), it differed between the two runs, and those params demonstrably exist (they were pushed and echoed on 2026-08-15). Nothing is missing from the firmware.
- FORWARDING CONFIRMED (user granted a one-time read of /media/sleuther/Stuff/ardupilot-SITL, Copter 4.7.0): MAVLink_routing::forward() treats a message with no target_system field as broadcast (target_system == -1 -> broadcast_system) and resends it on EVERY channel with a learned route except the source and private channels. OBSTACLE_DISTANCE and DISTANCE_SENSOR have no target fields, so the ESP32's 10 Hz output on TELEM1 IS forwarded out TELEM2 to the SiK whenever a GCS route has been learned there. Traffic estimate: OBSTACLE_DISTANCE fills all 72 slots with 65535 (never 0), so MAVLink2 truncation saves nothing: 167-byte payload + 12 = 179 bytes, ~1.8 kB/s, ~2.2 kB/s with the up sensor and heartbeat.
- THE KNOB, ALSO FROM SOURCE: GCS_MAVLINK::Option::NO_FORWARD = bit 1 of MAVn_OPTIONS (GCS_MAVLink_Parameters.cpp:216 "@Bitmask: 0:Accept unsigned MAVLink2 messages, 1:Don't forward mavlink to/from, 2:Ignore Streamrate, 3:forward mavlink packets that don't pass CRC"). It calls set_channel_private() at INIT only, so it needs a reboot. Private means "sent heartbeats, but no broadcast or forwarded packets" (GCS.h:436) AND excluded from statustext_send_channel_mask (GCS.cpp:275), so a private channel loses STATUSTEXT too. Broadcast messages arriving ON a private channel are still processed locally, so proximity keeps working.
- CHANNEL MAP (setup_uarts + find_serial count MAVLink ports in SERIALn order): MAV1_ = chan0 = SERIAL0 = USB (UNO Q), MAV2_ = chan1 = SERIAL1 = TELEM1 = ESP32, MAV3_ = chan2 = SERIAL2 = TELEM2 = SiK.
- FIX MENU, with the cost of each: (1) do not manage parameters over the radio at all - the file plus a USB push is the supported path and the tool says so; (2) ESP32 TX_RATE_HZ 10 -> 2 in config.h (5x less forwarded traffic, everything keeps working, needs a reflash); (3) MAV3_OPTIONS=2 stops the flood reaching the radio but ALSO costs QGC every STATUSTEXT, including prearm reasons; (4) MAV2_OPTIONS=2 stops the ESP32 being forwarded anywhere, which keeps the dashboard ring (it reads the FC's OWN DISTANCE_SENSOR stream, mavlink_io.py:281/331) but kills the "prx ring N/6" health text that test_everything's ring check parses.
- STILL UNDECIDED, and one physical test settles it: power the ESP32 down and re-run the pull. Full 1035 in about a minute = congestion, fix with (2). Still hundreds missing = RF, and then antennas/placement/radio settings matter and a radio FIRMWARE update would still not be the fix.

### 2026-08-17 ~19:35 IST: user proposal - do calibration from the UNO Q (SSH/dashboard) instead of over the SiK
- THE IDEA IS SOUND AND THE REASONING IS THE SAME ONE THE TOOLS ALREADY ENCODE: the board reaches the Pixhawk over USB CDC at 115200 with no RF in the path, so a full 1035-parameter transfer is seconds. Every loss problem from today disappears the moment the radio is out of the path. parameters.py already runs on the board this way.
- THREE SHAPES, cheapest first, NOT YET CHOSEN (user asked, no code written; SCOPE RULE 2):
  (1) NO NEW CODE: move the Pixhawk USB cable from the UNO Q to the laptop and run QGC directly. Every calibration works today.
  (2) BRIDGE: a forwarder on the board exposing the Pixhawk link on UDP over the tailnet, so QGC on the laptop drives the aircraft with its full UI while the airframe stays untethered (the real win for compass and accel cal, which need the aircraft rotated). HARD CONSTRAINT: the serial port has exactly one owner, so the bridge must refuse to start while run_mission or test_everything holds the link, and those must refuse while the bridge runs - the dashboard already has a link-busy check to model this on. DEPENDENCY: tailnet reachability at the field (WISP MR3020), not yet proven for this use.
  (3) CLI OVER SSH: parameters.py already covers params. Accel cal needs the six-position prompt/response exchange (PREFLIGHT_CALIBRATION + ACCELCAL_VEHICLE_POS) and compass cal needs start/progress/accept (DO_START_MAG_CAL, MAG_CAL_PROGRESS/REPORT, DO_ACCEPT_MAG_CAL), so both are NEW code. MAVProxy would provide them off the shelf; NOT VERIFIED that it installs cleanly on the board's ARM image.
- ASKED THE USER: which calibrations are actually needed, and bridge-to-QGC or terminal only. Nothing built until answered.

### 2026-08-17 ~19:55 IST: tools/esp32_mute.py written (temporary ring mute so the SiK carries QGC alone)
- USER DECISION: full QGC over the SiK is the goal, not a board-side ground station. Wants the ring silenced temporarily now, and a permanent answer after.
- WHY THE RADIO "USED TO WORK": the ring has only recently been a continuous talker. comp 195 first appeared on the bus on 2026-08-14 (TX/RX were swapped at TELEM1 before that, so the ESP32 transmitted nothing), it then degraded to 2-4 live sectors, and the 2026-08-16 firmware added 10 s retries + a 15 s health STATUSTEXT so it now streams all the time. The radio never had to carry a continuous 10 Hz OBSTACLE_DISTANCE before this week. STILL A HYPOTHESIS: proven only when a muted run downloads the full 1035 parameters.
- NEW TOOL `tools/esp32_mute.py` (off | on | status), runs from either machine, auto-picks the port like every other tool:
  * off writes SERIAL1_PROTOCOL -1 and PRX1_TYPE 0; on restores both FROM param_dumps/pixhawk_full_setup.param (never from constants in the script, so restore cannot drift from the project config); status just reports.
  * BOTH PARAMS MOVE TOGETHER on purpose: disabling TELEM1 while PRX1_TYPE stayed 2 would leave a configured proximity sensor with no data, which this project's own record treats as an arming risk.
  * Refuses when ARMED and refuses when the armed state is unknown (it reboots the FC, which is the only way it could hurt anything). Refuses to reboot if either write was not echoed.
  * Reboots via MAV_CMD_PREFLIGHT_REBOOT_SHUTDOWN param1=1; "NO ACK" is expected and is printed as normal, since the board reboots instead of replying. Reconnect re-resolves the port from scratch (USB re-enumerates under a new name after a reboot) and retries 6 times.
  * VERIFIES TWO WAYS: reads both params back after the reboot, then listens 6 s and counts messages from component 195 and OBSTACLE_DISTANCE. Silent = muted. Distinct messages for "off but still talking" (ESP32 is not on TELEM1) and "on but nothing arrives" (ESP32 unpowered).
  * Imports write_param/await_param/load_param_file from parameters.py rather than reimplementing the write-and-echo path, keeping the single-owner rule for parameter writes.
- TESTED WITHOUT HARDWARE (no serial port was opened; the SiK dongle is on the laptop and the standing rule keeps assistant commands off the aircraft): compiles, --help, restore values read as SERIAL1_PROTOCOL 2 / PRX1_TYPE 2 from the file, and 8 stubbed control-flow scenarios all behave: armed refusal, unknown-armed refusal, unwritten-param refusal, lost-across-reboot refusal, both happy paths, and both anomaly messages. NOT yet run against a real flight controller.
- DO NOT FLY MUTED: with PRX1_TYPE 0 there is no proximity sensor at all. Run `on` before any flight.
- PERMANENT CANDIDATES, in preference order: (1) MAV2_OPTIONS = 2 (bit 1 "Don't forward mavlink to/from" on chan1 = SERIAL1 = the ESP32 port, from GCS_MAVLink_Parameters.cpp:216): one parameter, no reflash, the FC still ingests the ring locally (private channels still process broadcast messages) and the dashboard keeps its bins because it reads the FC's OWN DISTANCE_SENSOR stream; COST is the ESP32's "prx ring N/6" STATUSTEXT, which private channels are excluded from forwarding, so test_everything's ring check would need rewiring to the FC's proximity data. (2) ESP32 TX_RATE_HZ 10 -> 2 in config.h: keeps everything working, cuts the forwarded load 5x, needs a reflash. Neither is applied.

### 2026-08-17 ~20:20 IST: working the fundamental-problems list. Two shipped, three need a decision, three are hardware
- SHIPPED 1, AND THE NAME IN THE SCAN WAS WRONG: "set WPNAV_SPEED ~3 m/s" could not have worked. This firmware has NO WPNAV_* parameters; 4.7 renamed the set. The board's own dumps carry WP_SPD, WP_SPD_UP 2.5, WP_SPD_DN 1.5, WP_ACC 2.5, WP_RADIUS_M 2, i.e. metres and m/s, not the old centimetre units. **WP_SPD read 10 on the board**, which settles finding 3's "believed ~10 m/s, UNVERIFIED" from the aircraft's own dump: every coverage, footprint and blur figure in this file assumed 3 m/s and the aircraft has been flying its GUIDED legs at 10. param_dumps/pixhawk_full_setup.param now carries WP_SPD,3 with that history next to it. NOT YET PUSHED, and one thing stays VERIFY: GUIDED position targets are expected to be flown by the waypoint controller (so WP_SPD governs them), but that has not been confirmed on this aircraft - read the achieved ground speed out of the next log before believing it.
- SHIPPED 2: tools/check_log.py gained a COMPASS section, which is the "confirm field under 875 in the log" step. It reports |B| per MAG instance SPLIT BY THROTTLE, and that split is the diagnosis finding 8 never had: over the gate AT REST = stale calibration or something magnetic parked near the compass (recalibration helps), fine at rest but over the gate UNDER THROTTLE = current in nearby wiring (recalibration is wasted, reroute the battery leads). Either failure adds to the exit-1 verdict list. MAG_FIELD_GATE 875 is documented in the source as THIS SITE's number, taken from the aircraft's own "Check mag field (1038, max 875)" message, not as a universal constant.
- TESTED: no .bin log exists in this repo, so the section was exercised against four synthetic message streams (clean, 1038-at-rest, 430-at-rest-1010-flying, no MAG at all). All four print the intended text and exit 0/1/1/0. Not yet run on a real log.
- ALREADY EXISTS, no code needed for "run the model on real in-flight frames": uno_q/spotcheck_onnx.py takes --model and --dir and writes results.jsonl plus annotated images. The pre-take flight just has to produce frames for it.
- SALT FLOW (dose seconds -> grams): blocked on a MEASUREMENT the user has to make, not on code. With grams per second from the bench test, mission.py's dose_s_min/max/default and the area-to-dose mapping can be expressed in grams.
- THREE DECISIONS PUT TO THE USER, nothing written until answered (SCOPE RULE 2): (a) what an aborted descent should do, since detector._fired latches the site at FIRE time (detector.py:113-115) and an abort therefore burns it for the whole flight; (b) how a release over real water should work - beside with an exposed offset flag, or directly overhead at a fixed altitude without the Luna, or wet-dirt only; (c) whether the blur work is a logged sharpness metric, a gate that skips soft frames, or a fixed exposure lock in camera.py.
- NOT SOLVABLE IN CODE, and said plainly rather than left implied: connectors under vibration and heat, the single hub carrying both camera and Pixhawk, no weatherproofing against the monsoon premise, 13 min usable endurance, and the camera's own rolling shutter. Those are build and framing decisions.

### 2026-08-17 ~21:00 IST: water-drop sequence, abort retry, blur metric (user answers to the three decisions)
- USER'S ANSWERS: (a) an abort retries the site ONCE then gives up; (b) the aircraft descends BESIDE the puddle on the Luna, crosses over the centre at that height, drops, crosses back beside so the Luna re-acquires, then leaves; (c) blur handling is my call. ALSO: **wet dirt is trained as a NEGATIVE, the model is meant NOT to detect it**, which kills the "demo on damp soil" fallback: the shoot target is real standing water and the sequence below is the only path to a drop.
- MISSION SEQUENCE REWRITTEN (uno_q/mission.py). New states CROSS and RETURN: DESCEND (beside, on the rangefinder) -> CROSS (translate over the puddle centre) -> DROP -> RETURN (translate back beside) -> CLIMB. The altitude reference over the water is `_drop_rel_alt`, the rel_alt captured at the instant the Luna said drop height was reached BESIDE the water, because that is the last trustworthy AGL; goto() holds it across both translates. Nothing tests the rangefinder in CROSS/DROP/RETURN: a dropout over still water is the expected reading, and treating it as a fault is exactly the abort that ended flights with zero drops. Degenerate cases handled: offsets 0 (or a cross shorter than wp_radius) collapse to the old vertical behaviour, and a missing rel_alt releases beside the water rather than crossing blind.
- ABORT NOW RETRIES (cfg.site_retries = 1). ABORT_CLIMB re-approaches the SAME latched coordinates once before resuming the survey; no detector change was needed because the mission already holds the coordinates, and the detector's _fired latch is what made a retry impossible from the detector side.
- FLAGS: run_mission gained --offset-n (default 3.0) and --offset-e (default 0.0). Direction is a site decision, so it is a flag; finding 4's "run_mission EXPOSES NO FLAG" is closed. cfg.cross_timeout_s 20 s: a failed crossing OUT aborts, a failed crossing BACK just climbs from where it is (the granules are already gone).
- TESTED WITH A KINEMATIC HARNESS (no SITL, which lives outside this repo): fake MavIO with a motion model, a water disc the rangefinder cannot see, and mission.py's clock driven by the harness so wall-clock dwells and timeouts are exercised. Four scenarios pass: beside-3 m crosses and drops 1.40 m from centre at 3.00 m then returns and resumes; offsets 0 shows no CROSS/RETURN; a dropout on the first descent aborts then SUCCEEDS on the retry (2 APPROACHes, 1 drop); a permanently dead rangefinder aborts twice and gives up with 0 drops (which is also what sitl_test's dropout drill asserts).
- BLUR (my call, deliberately conservative): OnnxDetector.infer_rows now measures variance of the Laplacian on the letterboxed image the model actually receives, stores it as last_sharpness, and detect_worker puts it in every payload and logs it with each detection plus every tenth blank frame. IT IS NOT A GATE. A threshold chosen without in-flight numbers would silently blind the aircraft; the pre-take flight now produces the distribution to choose one from. Measured cost 0.6 ms/frame on the laptop against ~500 ms inference; sharp-vs-blurred separation on a synthetic frame was 4 orders of magnitude.
- DASHBOARD: STATE_COLORS gained CROSS and RETURN (amber, like DESCEND/CLIMB) so the new states do not render as unknowns.
- NOTED, NOT CHANGED: rec.latch() still records the DESCENT point, so with a 3 m offset the latch marker on the dashboard sits 3 m from the detection marker. That is honest (it is where the aircraft flies) but it will look like an error to anyone who does not know.
- STILL OPEN from the user's list: salt flow (blocked on a bench measurement, grams per second, before dose seconds can mean grams); the pre-take flight itself (uno_q/spotcheck_onnx.py already runs the model over a folder of frames, no new code); and the packaging/endurance/weatherproofing items, which are build decisions and not code.

### 2026-08-17 ~21:20 IST: FS-i6X transmitter brownout CONFIRMED under load (open 5.18 V, loaded 3.8 V)
- USER MEASURED IT BOTH WAYS: 5.18 V at rest, and under load the meter agrees with the transmitter's own 3.8 V reading. The display was honest; the pack cannot hold voltage. The radio refuses to operate at that level.
- WHAT THE NUMBERS MEAN: 5.18 V across four AA cells is ~1.29 V/cell, so the cells are already largely spent (fresh alkalines read about 1.6 V each, ~6.4 V for the pack). A 1.38 V drop at a transmitter's typical draw (order of 0.1-0.25 A, NOT measured here) implies something in the order of 6-10 ohms in series, where four healthy alkalines plus a clean holder should be well under 1 ohm. Both a depleted pack and a resistive contact produce exactly this, and they are told apart by measurement, not by argument.
- ORDER OF WORK GIVEN TO THE USER: (1) fresh cells first, since the pack is demonstrably depleted; (2) if the sag survives fresh cells, WALK THE VOLTAGE with the radio switched ON, probing from each cell's own terminals, then the holder wires, then the board input, because the fault is wherever the voltage disappears; (3) contacts or holder if the loss is there (clean, re-tension, or bypass the holder), cells if each cell sags on its own; (4) longer term, low-internal-resistance chemistry (NiMH eneloop-class or a 2S pack) INSIDE the input range printed on the radio, which was deliberately not quoted from memory.
- DO NOT lower the low-voltage alarm to get past it: that converts a brownout into an in-flight one.
- LIKELY CLOSES FINDING 9 (RC link intermittency, three ABSENT/UNHEALTHY results on 2026-08-14/15 dismissed with "the TX works"). A transmitter browning out under its own RF load is exactly an intermittent link whose TX state looked fine to the operator. NOT PROVEN: it needs one bench re-test with a good pack, receiver bound, watching test_everything's RC row.
- CORRECTION, SAME DAY: the cells are RECHARGEABLE (NiMH), not alkaline, so the "spent alkaline" reading of the numbers is withdrawn. Re-read for NiMH: 1.29 V/cell at rest is a PART-CHARGED cell (a full one rests around 1.35-1.4 V, nominal 1.2 V), and 0.95 V/cell under load is heavy sag. The dominant NiMH failure in a 4-cell series string is ONE weak cell, which drags the pack while the other three look fine, so the decisive measurement is each cell individually UNDER LOAD, not the pack. Other NiMH-specific suspects given: a charger terminating early (dumb chargers and old timer chargers), self-discharge if the cells are not low-self-discharge types, high cycle count or cheap high-mAh cells (internal resistance rises with both), and FLAT-TOP cells in a holder sprung for button tops, which is a classic high-resistance contact. Replacement rule: swap the whole set, never mix ages or brands in series.
- RESOLVED (user, 2026-08-17): ONE BAD CELL. The per-cell-under-load measurement found it, exactly the series-string failure described above. The transmitter's own 3.8 V reading was correct throughout and nothing is wrong with the radio.
- CONSEQUENCE FOR FINDING 9, still UNPROVEN but now cheap to settle: a transmitter browning out on one weak cell is a fully sufficient explanation for the three RC ABSENT/UNHEALTHY results of 2026-08-14/15, whose TX state nobody had established. The confirmation is one bench check with the good pack in: receiver bound, TX on, watch the RC row in test_everything. Until that runs, finding 9 stays open rather than being closed by a plausible story.

### 2026-08-18 ~13:30 IST: "is 3 m/s too fast for an 80 cm warning?" - the ring cannot protect ANY survey speed, and does not try
- USER CONCERN: at 3 m/s an 80 cm warning gives 0.25 s to react. The instinct is right but the framing is off in both directions:
- (1) NOTHING REACTS AT ALL, at any speed: AVOID_ENABLE=0 (decided 2026-08-14 when the ring degraded; "if it doesn't work, disable"). The ring is display/logging only. No 80 cm threshold exists in the system either; the ring's trusted band is 5-200 cm (config.h RANGE_MIN/MAX_CM) and AVOID_MARGIN=1 m is inert while avoidance is off.
- (2) EVEN IF AVOIDANCE WERE ON, the arithmetic kills 3 m/s independently: braking from 3 m/s at AVOID_ACCEL_MAX=3 m/s2 needs v2/2a = 1.5 m, plus ~0.1 s sensor latency (10 Hz ring) = 0.3 m travelled first, total ~1.8 m against a 2 m sensor ceiling. The ring could only ever serve ~1.5-2 m/s (0.67 m brake + latency from 2 m/s). APPROXIMATE: kinematics from our own params, not a bench measurement.
- (3) WHAT ACTUALLY PROTECTS THE FLIGHT AT 3 m/s: the survey runs at 15 m AGL, above the obstacle field; the hand-drawn fence bounds the plot; the pilot holds kill/RTL. The slow phases are already slow: descent 0.5 m/s, the cross legs are ~3 m gotos that never reach cruise.
- (4) 3 m/s is not an increase: the board has been flying GUIDED legs at WP_SPD=10 all along; 3 is the reduction (chosen for blur + frames-on-target, recorded 2026-08-17).
- IF THE RING EVER STEERS AGAIN (AVOID_ENABLE 7): drop WP_SPD to 2 or below at the same time, or the avoidance is cosmetic. Recorded so the two params never move independently.

### 2026-08-18 ~16:55 IST: CORRECTION (user): the ring IS to steer again - AVOID_ENABLE back to 7 in the file
- USER, primary source: "we already agreed that the ring would be enabled, since we reflashed and fixed the wiring." That agreement was never written into this file, which is why the 2026-08-17 entries and this morning's 13:30 entry kept stating AVOID_ENABLE=0 as current policy. The 08-14 disable was CONDITIONAL on the ring degrading, and its cause is fixed: the sector deaths were the old firmware latching failed channels at boot with no retry (diagnosed 2026-08-15), the 2026-08-16 reflash retries DOWN channels every 10 s, and the TELEM1 wiring has been redone. This entry supersedes those statements; per append-only rule the old entries stand as written.
- FILE: param_dumps/pixhawk_full_setup.param AVOID_ENABLE 0 -> 7 with the full history in the comment; the stale "AVOID_ENABLE stays 0" note in the FENCE block rewritten (bit 1 = fence avoidance, so the aircraft now also slows to a stop at the boundary instead of only breach-and-return; new behaviour, untested in the air). File parses to 73 params. Lands with the SAME pending night-before push (SERIAL5 -1, FENCE_TYPE 7, WP_SPD 3, now AVOID_ENABLE 7); no reboot needed for AVOID_ENABLE itself.
- SPEED COUPLING RESOLVED, not reopened: the 13:30 rule said AVOID_ENABLE 7 and WP_SPD move together. Resolution recorded in the file: cruise at WP_SPD 3 is at 15 m AGL above the obstacle field, so the ring's inability to stop 3 m/s (needs ~1.8 m of its ~2 m ceiling) protects nothing that needs protecting; the ring serves the slow low phases (descent 0.5 m/s, short cross legs). Ring-protected CRUISE would need WP_SPD <= 2; that trade is the user's if ever wanted.
- PRECONDITION, on the checklist not in code: Test everything ring row 5-6/6 with the drone assembled before the first avoidance flight. Dead sectors stream 65535 = no-data, which ArduPilot ignores, so a degraded ring steers less, never wrongly.
- INTERACTION with the SiK congestion thread: with avoidance live, the ESP32's 10 Hz rate is LOAD-BEARING (steering data), so the "TX_RATE_HZ 10 -> 2" permanent fix is DEAD. The remaining permanent candidate is MAV2_OPTIONS=2 (stop forwarding TELEM1's traffic to other links; the FC still ingests it locally, cost = the prx health STATUSTEXT that test_everything's ring check parses). tools/esp32_mute.py is unaffected (it moves SERIAL1_PROTOCOL/PRX1_TYPE, restores from this file) but DO NOT FLY MUTED now means avoidance is also gone while muted.

### 2026-08-18 ~17:05 IST: rain cancels today's test flight; home-prep plan for tomorrow; equipment facts pinned
- USER, ANNOYED AT REPETITION, facts now in CLAUDE.md so no session re-suggests them: ONE pack, NO spare, and the WISP MR3020 is OUT (field network = phone hotspot directly, already in FIELD_CHECKLIST 2026-08-16). My last two replies re-suggested both from stale state lines instead of the newer checklist; checklist line "spare pack (if one exists)" made definitive.
- TODAY (home, ordered): board pull; param push over USB (carries SERIAL5 -1, FENCE on, WP_SPD 3, AVOID_ENABLE 7) + Pixhawk power-cycle; bench Test everything assembled (ring 5-6/6 proves the rewiring, RC row with TX on good cells closes finding 9; indoor arm refusal "fence requires position" is the fence working); salt-flow measurement with the gate + kitchen scale for grams/second (user supplies the number, then dose code converts s -> g); DRAW + PUSH THE FENCE FROM HOME on the satellite map (site anchor + new zoom make the field reachable; fence lives in FC storage and survives reboots; fence self-test row must go green); join the board to the phone hotspot so the profile is saved; SILICONE CONFORMAL COAT LAST, after everything passes, curing overnight.
- COAT MASKING LIST GIVEN (generic conformal-coat practice, product label governs cure): never coat the Pixhawk barometer/case openings (blocked baro = wrong altitude), camera lens, TF-Luna lens, all 7 VL53L0X windows, in-use connectors, USB/SD, safety switch + buzzer, motor bells/shafts, servo shaft + gate sliding faces, antenna connectors. Coat exposed boards: ESCs, PDB, buck modules, ESP32 carrier, splices.
- TOMORROW (field): compass recalibration outdoors away from car/phone/metal, waypoints generated on GPS fix, pour a real puddle (wet dirt is a trained negative), outdoor arm check, test flight, then check_log on the .bin (speed achieved vs WP_SPD 3, compass section, vibration).

### 2026-08-18 ~17:15 IST: WP_SPD 3 -> 2 (user): with the ring live, cruise must sit inside its reaction ceiling
- USER: "didn't we decide that 3 m/s was too high? The drone will not have enough time to react." The morning entry (13:30) recorded the concern and the rule "AVOID_ENABLE 7 means WP_SPD <= 2 or the avoidance is cosmetic", but no number was ever decided and my 16:55 edit left 3 in the file with the trade "not made". The user has now made it: WP_SPD,2.
- THE ARITHMETIC THAT MAKES 2 THE CEILING (same as 13:30, now load-bearing): braking from 3 m/s at AVOID_ACCEL_MAX 3 needs ~1.5 m + ~0.3 m latency = ~1.8 m against the ring's ~2 m trusted range, no margin; from 2 m/s it is ~0.9 m, which leaves the AVOID_MARGIN 1 m standoff workable. APPROXIMATE, from our own params, not bench-measured.
- FILE: param_dumps/pixhawk_full_setup.param WP_SPD,2 with the full 10 -> 3 (blur) -> 2 (ring ceiling) history in the comment; the AVOID block's "trade not made" line now reads TRADE MADE. Parses to 73 params.
- COSTS, stated: each survey leg takes 1.5x as long as at 3 (still 5x faster than the 10 the board had been flying); blur only improves. Endurance is the pressure point on the single pack; the small test plot fits.
- IF THE PUSH ALREADY RAN today with WP_SPD 3: pull and push again; a re-push rewrites the one changed param in seconds.

### 2026-08-17 (Raghav, primary source): MOTOR/PROP BLOCKER CLOSED BY FLIGHT
- **THE AIRCRAFT HAS FLOWN SINCE THE PHASE-WIRE FIX AND IT FLEW.** Three motors reversed, props re-matched, flight successful. The 2026-08-08 "all six spin the same way" blocker is CLOSED. Do not re-raise props or motor direction: a reversed motor with its old prop makes DOWNWARD thrust, so a successful flight is itself the proof that both are correct. Asking him to re-verify by eye after that is asking him to re-prove a thing he has already demonstrated.
- **THE AIRFRAME HAS NOT BEEN APART SINCE THE FARM FLIGHT** (user, emphatic). An assistant claim that it had was INVENTED, unsupported by anything in this file, and used to cast doubt on the log-37 VibeZ 7.5 figure. Retracted. VibeZ 7.5 stands as the current airframe characterisation until a specific change or a newer log says otherwise. Absence of a record is NOT evidence of disassembly.
- REMAINING GAP IS SOFTWARE, NOT AIRFRAME: run_mission.py has still never commanded the real aircraft. Link proven (USB by-id, 8/8 heartbeats x3) and state machine proven in SITL, but the two have never met. That, not the airframe, is what the dry-run -> --no-drop -> live ladder is for.

### 2026-08-18: tools/ring_channels.py -- name the dead ring channels without the ESP32's USB
- PROBLEM: "prx ring 4/6" says HOW MANY are alive, never WHICH. test_everything's "bearing bins that see an object" cannot fill the gap either, because a healthy channel with nothing in front of it does not appear in that list. The only thing that names channels is the ESP32 debug log over USB, and the ESP32's USB is not reachable (2026-08-18: `ls /dev/serial/by-id/` on the board shows ONLY the Pixhawk; user could not find a way to connect the ESP32 to the UNO Q).
- THE ANSWER IS ALREADY ON THE WIRE, which is why no new cabling is needed: per config.h, a failed channel reports SENSOR_MM_ERROR -> SECTOR_NO_DATA -> **65535** ("unknown"), while a channel that is alive with nothing in range sends RANGE_MAX_CM+1 = 201 cm, a REAL number. So 65535 = DEAD and anything else = ALIVE, per sector, in the OBSTACLE_DISTANCE the Pixhawk is already forwarding. Identity map channel N -> sector N, bearing = N*60 deg clockwise from the nose (SENSOR_ANGLE_OFFSET_DEG 0 on this airframe).
- TOOL: read-only, sends nothing, arms nothing. Samples over --seconds (default 10) rather than reading one message BECAUSE THE FAULT IS INTERMITTENT: it reports DEAD (never reported), FLAKY (<95% of samples) and alive, so a channel that flickers is caught as well as one that is flat dead. Prints the closest object each live channel saw.
- DECODE VERIFIED on synthetic frames 2026-08-18 (dead / flaky / alive / closest-cm all correct). NOT yet run against the aircraft.
- DIRECTION IT POINTS, straight from config.h and not to be re-litigated: this fault is loose contact / sagging 3V3, NOT bus speed. Do not lower I2C_CLOCK_HZ or raise TCA_SETTLE_US. Meter 3V3 at the failing sensor's own VIN pin under load, wiggle its connector, and remember the 2026-08-14 precedent where an UNPOWERED ch6 was also breaking ch1. If power is clean, swap the suspect sensor onto a known-good mux channel: fault follows the sensor = bad chip; fault stays on the channel = mux or wiring.

### 2026-08-18: THE BOARD'S GIT REPO CORRUPTED ITSELF -- cause, fix, and the rule that follows
- SYMPTOM: `git pull` on the board failed with `object file .git/objects/.. is empty`, then `git status` failed with `fatal: bad object HEAD`, and `git fsck` listed MANY empty objects (017ed9db, 0c3f08b, 11119e91, 1651a780, 31178aca, 4e9a9121, 5487e8fb, ...). Zero-byte objects across the store with a broken HEAD is structural damage, NOT a merge problem and NOT repairable by deleting a few objects.
- CAUSE (high confidence, not proven): the aircraft was cold power-cycled repeatedly during the ring debugging, and an abrupt power cut loses buffered filesystem writes. Git had objects in flight. Same mechanism that would corrupt a half-written log or mission JSONL.
- FIX ADOPTED: move the damaged repo aside (do NOT delete it: it is the only copy of any uncommitted local edit, and with a bad HEAD git cannot tell us what those were), clone fresh, then diff against the saved copy at leisure. Nothing the board needs lives inside the repo -- ~/logs, ~/monsoonready_data and ~/venv are all outside it, and models/best.onnx is tracked so it returns with the clone.
- **RULE THAT FOLLOWS: STOP CUTTING POWER TO A RUNNING BOARD.** The Linux side is a full Debian system with a writeback cache, not a microcontroller. Every abrupt power-off risks whatever was being written: the git store this time, a flight log or a mission JSONL next time. Shut it down cleanly before pulling power. CAVEAT, unresolved: the board's sudo password is lost (recorded earlier), so `sudo poweroff` may not be available; whether an unprivileged `systemctl poweroff` works here is UNTESTED. Establish a working clean-shutdown command and put it in the field checklist.
- COST THIS TIME: only time. The remote had every commit, so nothing was lost.

### 2026-08-18 RING DIAGNOSED PROPERLY: it is 1/6 usable, not 4/6 (tools/ring_channels.py, first hardware run)
- **ch1 (60 deg) and ch2 (120 deg) are DEAD**, 0% of 150 messages, and they are ADJACENT. Two neighbouring channels failing together is not two independent chip failures; it points at something they SHARE (a common wiring run, a branch of the 3V3 distribution, adjacent mux pins). ch1 also has previous: config.h records that on 2026-08-14 reconnecting an unpowered ch6 also fixed ch1, so ch1 has already once fallen over because of a power fault elsewhere on the shared net.
- **ch3 (180), ch4 (240), ch5 (300) are ALIVE BUT BLIND.** They report 5 cm, 5 cm, 8 cm at 100% and DID NOT CHANGE when the aircraft was moved to open space, while ch0 changed 39 cm -> clear in the same pair of runs. ch0 changing is the control: it proves sensor, transport and tool all track the real world, so an unchanging reading on the other three means the object is travelling with the aircraft. RANGE_MIN_CM is 5, so those two are pegged at the sensor floor.
- CONSEQUENCE: the "prx ring 4/6 up:ok" health line is MISLEADING as a readiness signal. It counts channels that INITIALISED, not channels that can see anything useful. Only ch0 is proven to observe the world. Do not read 4/6 as "two thirds of a working ring".
- THIS IS ALSO THE ARMING BLOCKER: `PreArm: Proximity 180 deg, 0.07m (want > 0.6m)` is ch3 reporting the same 5 cm. Fixing ch1/ch2 would not clear it.
- NOT YET DISAMBIGUATED, and it decides the fix: are ch3/4/5 seeing THE AIRFRAME (legs/arms/payload -> mounting fault, ring unusable until moved) or THE GROUND (the aircraft was moved laterally but stayed on the floor, so ground distance never changed)? Decisive test = lift the aircraft clear of the floor with nothing within ~2 m in any direction, including below, and re-run. Ground-seeing would clear in flight anyway and ArduPilot has PRX_IGN_GND / PRX_ALT_MIN (default 1.0 m) designed for exactly it (named in esp32_obstacle_avoidance/README.md; VERIFY against the ArduPilot 4.7 docs before setting). Airframe-seeing needs the sensors physically moved and matches the standing mount rule that the 25 deg FOV must not see legs or props.
- SUSPICIOUS OVERLAP worth checking during the fix: config.h records that on 2026-08-06 the three rear sensors (then called channels 2/3/4 = bearings 120/180/240) were REMOVED while chasing the bus fault. Every channel except ch0 is now faulty in one way or the other, which is more consistent with ONE BAD REFIT of the ring than with five separate faults.
- TOOL STATUS: tools/ring_channels.py is now HARDWARE-VERIFIED (150 messages in 20 s, named the dead channels first run, and its alive/clear/closest-cm readout is what exposed the blind-sensor finding that the 4/6 health line hid).

### 2026-08-18 (Raghav, primary source): ch2's sensor is FRIED and disconnected -- which re-points the ch1 diagnosis
- **ch2 IS NOT A FAULT TO CHASE.** Its VL53L0X is dead and the channel is disconnected. Its DEAD line in ring_channels.py is expected, not evidence.
- **BUT IT IS THE PRIME SUSPECT FOR ch1.** config.h's 2026-08-14 entry: an unpowered ch6 was disturbing the shared 3V3 net and "reconnecting it also fixed ch1". Same victim channel, same mechanism, and ch2 is ch1's immediate neighbour. The earlier "ch1+ch2 adjacent so they share a cause" reading was right about the sharing and wrong about the direction: ch2 is likely CAUSING ch1, not co-failing with it.
- DECISIVE QUESTION, ASKED AND UNANSWERED: is ch2 FULLY UNWIRED, or is the fried chip still physically connected and merely dead? Still-connected means it can load or clamp the shared rail, which would explain ch1. Genuinely removed means ch1 is an independent fault. Do not proceed on ch1 until this is known.
- CONFIG FIX OWED (needs an ESP32 reflash, currently awkward: its USB is not reachable): RING_SENSOR_FITTED in config.h is still {true x6}; index 2 must become false so the firmware stops probing an empty channel and stops counting it as a failure. That array exists for exactly this case and its own comment says so.
- REVISED HONEST RING STATE: ch0 proven working; ch1 dead (cause suspected = ch2); ch2 deliberately empty, sensor fried, REPLACEMENT PART NEEDED; ch3/4/5 alive but reading 5-8 cm unchanged when the aircraft moved (airframe-vs-ground still undisambiguated, lift test outstanding); ch6 (up) WORKING, 2.01 m at the last self-test after the cold power cycle.
- TOOL UPDATED: ring_channels.py now reports ch6. The upward sensor is not in OBSTACLE_DISTANCE at all -- it travels as DISTANCE_SENSOR orientation 24 (RNGFND2 to the Pixhawk), while orientation 25 on the same message is the downward TF-Luna and is filtered out. Filter verified on synthetic streams 2026-08-18. Its absence from the first version was a tool gap, not a hardware finding.

### 2026-08-18 CORRECTION (Raghav, primary source): the "ch2 is killing ch1" theory is WRONG, and so is the reasoning behind it
- **WIRING TOPOLOGY, from the user:** ch2 is DISCONNECTED (fried sensor), so it is not on any rail and can load nothing. All REMAINING lidars share ONE common 3V3 and GND. The 2026-08-14 precedent in config.h was about ch6 and ch1 specifically, not about ring neighbours in general.
- **THE ERROR, named so it is not repeated: I treated adjacency in BEARING (60 deg next to 120 deg) as adjacency in WIRING.** Ring position says nothing about electrical topology. Delete the "ch1+ch2 share a cause" reading from the 2026-08-18 entries above; it was built on that confusion.
- **WHAT THE CORRECTED TOPOLOGY PROVES, and it is stronger than the theory it replaces: THE SHARED RAIL IS EXONERATED.** ch0, ch3, ch4, ch5 and ch6 all report on that same common 3V3/GND. A sagging or disturbed shared supply cannot kill only ch1 while five others on it work. So ch1 is a LOCAL fault, confined to exactly three candidates: its own VL53L0X, its own 4-wire bundle, or mux channel SD1/SC1.
- **DECISIVE TEST (uses the free slot ch2 leaves behind): move ch1's sensor onto ch2's now-unused mux channel.** Works there => the sensor is good and the fault is mux channel 1 or its wiring. Stays dead => the sensor is bad and needs replacing, same as ch2's. One move, one re-run of ring_channels.py, and the three candidates collapse to one.
- CONSEQUENCE FOR PARTS: at least one replacement VL53L0X is already needed for ch2. If the swap shows ch1's sensor is also bad, that is two.
- STILL OUTSTANDING, unchanged: ch3/4/5 read 6/5/8 cm across THREE runs in different positions while ch0 tracked the world each time (39 -> clear -> 125 cm). The lift test (aircraft clear of the floor, nothing within ~2 m in any direction INCLUDING BELOW) has not been done and is what separates "seeing the airframe" from "seeing the ground".

### 2026-08-18: ring_channels.py advice now FOLLOWS FROM ITS OWN EVIDENCE instead of reciting history
- The tool used to print the config.h shared-3V3 story after every run. On this aircraft that advice is WRONG (topology corrected above: ch2 is off the rail; the common rail is exonerated by the five channels that work on it), and a tool that hands the operator a disproven theory is worse than one that says nothing.
- NEW LOGIC: the live channels are the control experiment. They sit on the SAME common 3V3/GND and the SAME mux as the dead ones, so if any of them report, the rail and the bus cannot be the explanation, and the tool says so and sends the user straight to the swap test. Only if NOTHING reports does it point at the ESP32 / shared rail / mux. Both branches verified 2026-08-18.
- WHY THIS IS WORTH THE CHANGE: this project has now twice chased a shared-supply theory that its own data already ruled out (2026-08-14 for real, 2026-08-18 by my error). Encoding the inference in the tool is how that stops happening.
- OPEN, ASKED, UNANSWERED: whether the 4th run (149 msgs, ch1+ch2 still dead) was taken BEFORE or AFTER swapping ch1's sensor onto ch2's mux channel. If after, the fault followed the sensor => ch1's VL53L0X is bad and TWO replacements are needed. If before, the swap test is still outstanding. Do not record a verdict on ch1 until this is answered.

### 2026-08-18: the ch1 swap test was RUN but its result is AMBIGUOUS -- bad control, my error
- WHAT HAPPENED: user moved ch1's sensor onto ch2's mux channel and re-ran. ch1 (now empty) DEAD as expected; ch2's channel, now carrying ch1's sensor, ALSO DEAD.
- WHY THAT PROVES NOTHING: **ch2's mux channel is not a known-good control.** It has only ever been tested with a fried sensor on it, so it has never once been shown to pass data. Moving a suspect sensor onto an unverified channel makes "both dead" consistent with (a) ch1's sensor bad, (b) ch2's mux channel bad, or (c) both. MY INSTRUCTION NAMED THE WRONG SLOT: I picked ch2's because it was free and convenient, when the test requires a channel PROVEN to work. The tool's own text says "a mux channel known to work"; the chat advice contradicted it.
- **CORRECT TEST, fully decisive in one move: two-way swap ch1's sensor with ch0's.** ch0 is the only channel proven to track the world (39 -> clear -> 125 -> 11 cm across four runs). Then: ch1's sensor reports on ch0's channel => sensor good, ch1's CHANNEL is bad. ch0's sensor goes dead on ch1's channel => confirms ch1's channel is bad. ch1's sensor dead on ch0's channel WHILE ch0's sensor still works on ch1's channel => ch1's SENSOR is bad. Reading both halves is what makes it decisive rather than suggestive.
- NOTE FOR PART ORDERING: ch2's sensor is confirmed fried (user). Whether a SECOND replacement is needed is exactly what the corrected test answers; do not order on the ambiguous result.
- LESSON, general: a swap test is only as good as its control. Swapping onto an untested channel is not a bisection, it just adds an unknown.

### 2026-08-18 ~17:30 IST: git grant recorded; the merge just collided today's two threads and they CONTRADICT on the ring
- GIT (user, emphatic, second time): the assistant runs ALL git itself ON THIS LAPTOP ONLY, including pull. CLAUDE.md rewritten with the full ban -> clarify -> lift history; board git stays user-run (the no-commands-at-the-board rule is untouched). The behind-8 pull was merged with both appended tails kept.
- THE COLLISION, stated plainly: this laptop's 16:55/17:15 entries (AVOID_ENABLE 7, WP_SPD 2) were decided on "reflashed and fixed the wiring". The drone-side session's same-day hardware runs (ring_channels.py) found the ring is 1/6 USABLE: ch0 proven, ch1 dead (two-way swap with ch0 still outstanding), ch2 fried and disconnected (replacement needed), ch3/4/5 pegged at 5-8 cm (airframe-vs-ground lift test outstanding), ch6 up working. Neither thread knew of the other; the merge is where they met.
- WHY THIS BLOCKS TOMORROW AS CONFIGURED: (a) the drone side already logged the prearm blocker "PreArm: Proximity 180 deg, 0.07m (want > 0.6m)" from ch3's pegged reading, observed with the BOARD still on AVOID_ENABLE 0, so arming is blocked by PRX1_TYPE alone while ch3/4/5 read phantoms; (b) pushing AVOID_ENABLE 7 on top of phantom 5-8 cm objects means GUIDED avoidance actively steers away from ghosts all flight. The 7 + WP_SPD 2 decision is SOUND FOR A HEALTHY RING and unsafe for this one.
- PARAM PUSH PUT ON HOLD in chat until the user picks for tomorrow: (A) lift test tonight clears ch3/4/5 as ground-seeing AND prearm passes assembled -> push as-is (7 stays); (B) anything else -> tomorrow flies without the ring steering: either AVOID_ENABLE back to 0 for the day, or esp32_mute off (kills the prearm blocker too, PRX1_TYPE 0). The file still carries 7; NOT reverted unilaterally, the user decides with the new evidence.
- Salt flow, fence-from-home, hotspot profile, coat: unchanged by any of this and still today's list.

### 2026-08-18 ~17:45 IST: MY ERROR - "the ring lidars might be seeing the ground" is geometrically wrong; and a standing ask-questions rule
- USER, correctly and bluntly: the ring is HORIZONTAL, so ground return cannot explain ch3/4/5. RETRACTED. The arithmetic I should have done before repeating the theory: the ring sits maybe 0.2-0.3 m off the floor with a ~25 deg cone, so the cone's lower edge would not meet the ground until roughly 1 m out, and a ground return would read about a metre, NOT the 5-8 cm observed. 5 cm is also exactly RANGE_MIN_CM, the value classifyCm() CLAMPS UP TO, so those channels are reporting "something at or below the sensor floor", which is a blocked, smudged, mis-seated or faulty sensor, or an object touching the lens. The lift test I proposed tests the wrong hypothesis; the right check is to LOOK at those three lenses and see what is within 8 cm of them.
- WHERE IT CAME FROM, since it must not recur: the drone-side session's own 2026-08-18 entry listed "airframe-vs-ground" as undisambiguated and cited PRX_IGN_GND/PRX_ALT_MIN. I inherited it through the merge and repeated it without checking the geometry against the mount. A parameter existing for a failure mode is not evidence that this aircraft has that failure mode.
- NEW STANDING RULE IN CLAUDE.md, user's explicit instruction: ASK CLARIFYING QUESTIONS IN EVERY REPLY about anything not current, no matter what was asked. PROJECT_STATE is a record written by two machines and it lags the physical build; the user is the primary source and the file gets corrected in the same reply.
- ALREADY WRONG IN MY LAST REPLY, per the user: the fence is CREATED and he had said so; the file still lists "draw + push the fence" as pending (last fence entries here are 2026-08-16 tooling notes, no creation record). Asked whether it is drawn only, saved, or pushed into the FC and read back green.

### 2026-08-18 ~18:00 IST: user answers - ring clutter explained, fence read-back now 0, board params are ANCIENT
- RING, USER CORRECTION AND IT LIKELY VOIDS THE "ALIVE BUT BLIND" FINDING: nothing is in front of ch3/4/5 lenses. The 5-8 cm readings were REAL OBJECTS on a cluttered bench (soldering iron, wall, etc.). The aircraft now sits clear. So the 2026-08-18 drone-side conclusion "ch3/4/5 alive but blind, pegged at the sensor floor" was measuring the bench, not the ring, and the prearm blocker "Proximity 180 deg 0.07 m" was a real object at 7 cm. A clean-bench re-run is the baseline; the user's order stands: BASELINE ALL CHANNELS FIRST, THEN the ch1/ch0 swap, so there is something to compare against.
- FENCE: pushed successfully through the dashboard EARLIER (read back green), and now the same push says "sent 7 corners but the Pixhawk holds 0". Read the message precisely: fence.push() RAISES on rejection or timeout, so reaching that text means the upload was ACCEPTED (MISSION_ACK ACCEPTED) and read_back then returned COUNT 0. Accepted-then-empty is storage or serving, not the upload path.
- LEADING CANDIDATE, and it is testable tonight: NO PARAM PUSH HAS RUN IN A LONG TIME (user). The board's fence params are therefore the 2026-08-15 farm set, when the file still carried FENCE_TYPE 3 (alt + circle, NO polygon bit; 7 was written into the file on 2026-08-16 with the polygon work). fence.py's own header records that the polygon bit governs the polygon prearm path; whether a cleared bit also makes the loader serve 0 stored items is NOT VERIFIED and is exactly what the param push settles. ORDER: params first, power-cycle, then fence push, then read back.
- OTHER CANDIDATES, kept because the above is unproven: a second GCS mid-mission-exchange on the same link (QGC over the SiK, or a self-test) crossing the read-back; an FC power cut between write and read (the user has been cold power-cycling, which is what corrupted the board's git store).
- ESP32: user will NOT reopen it unless REALLY needed. Verdict given: NOT needed. RING_SENSOR_FITTED[2]=false is cosmetic (it stops the firmware probing a channel with no sensor and stops it counting as a failure); the dead channel already streams 65535 = no-data, which ArduPilot ignores. No reflash for the shoot.
- WIRES: D0/D1 and SERIAL5 are OUT (user), so SERIAL5_PROTOCOL,-1 in the pending push is correct and safe.
- SILICONE: in hand tonight.

### 2026-08-18 ~18:20 IST: FENCE MYSTERY SOLVED - the polygon bit gates the READ-BACK, and 73/73 params are now on the board
- EVIDENCE, in this order: dashboard fence push said "sent 7 corners but the Pixhawk holds 0"; `parameters.py push` then wrote 73/73 with 0 refused and 0 no-echo, taking FENCE_TYPE from the stale 3 to 7; `fence.py read` immediately afterwards listed ALL SEVEN corners (12.9946128,77.7262153 ... 12.9942641,77.7265873). Same read_back code, same link, same fence: the only thing that changed was the parameter.
- FINDING, OBSERVED NOT SOURCE-VERIFIED: with FENCE_TYPE's polygon bit (4) CLEAR, ArduPilot 4.7 serves item count 0 for MAV_MISSION_TYPE_FENCE even though the polygon is in storage, and it still ACCEPTS an upload. So a fence can be uploaded, acked, stored, and read back as empty, purely because a parameter bit is off. That is exactly the "sent N but holds 0" text. It also means the fence pushed 2 DAYS AGO was never lost: it survived every power cycle since, and the read-back was lying, not the storage.
- CONSEQUENCE FOR THE CHECKLIST: parameters BEFORE fence, always. A red fence row on a board with stale params says nothing about the fence.
- BOARD STATE NOW (from the push output, primary source): AVOID_ENABLE 7, WP_SPD 2, FENCE_TYPE 7, FENCE_ENABLE 1, PRX1_TYPE 2, SERIAL5_PROTOCOL -1, SERVO9 500/1800/560, BATT calibration 24 / 10.8025, mAh failsafes 1600/800, INS_HNTCH 1. REBOOT STILL OWED before SERIAL1/2/4/5, RNGFND1/2, PRX1_TYPE and BATT_MONITOR mean anything.
- REBOOT PATH IS A GAP: nothing in this repo reboots the flight controller on its own (esp32_mute does it only as part of a param change), and cold-cutting power is what corrupted the board's git store. Until a clean path exists, the FC reboot must be done with the UNO Q shut down cleanly first, then a pack power cycle.
- MY QUESTION 2 WAS STUPID and the user said so: the board is powered from the pack and the Pixhawk is on its USB, which is how they talk at all. Do not ask what the wiring already answers.

### 2026-08-18 ~18:40 IST: fence survives reboot; RING WENT SILENT after the push+reboot; ring tool upgraded
- SUDO PASSWORD IS KNOWN (user, emphatic): the board was reflashed FOR THAT REASON. The "sudo password lost" line in the 2026-08-18 board-corruption entry is STALE and withdrawn; clean shutdown is available, so power-off is a normal operation again.
- FENCE PERSISTS: after the reboot `fence.py read` returned all 7 corners. NOTE FOR THE NEXT PERSON, from the user's own paste: the FIRST read straight after the reboot returned NOTHING and the second returned all 7. A fence read taken immediately after boot can come back empty before the loader has the polygon in hand. Read twice before believing an empty fence.
- **RING IS SILENT SINCE THE PUSH + REBOOT**: two 20 s runs of ring_channels.py saw ZERO OBSTACLE_DISTANCE, where before the push it worked. NOT DIAGNOSED, and the honest position is that nothing in the pushed set should have this effect: SERIAL1_PROTOCOL 2 / SERIAL1_BAUD 115 are what the ESP32 needs, PRX1_TYPE 2 only instantiates the FC's proximity driver, and forwarding of a broadcast message to the USB link does not depend on either. The two changes that coincide are the parameter push and a full power cycle, and a power cycle is exactly what has silenced this ESP32 before.
- DECISIVE NEXT STEP (given to the user): `tools/bench.py nodes --seconds 20`. comp 195 present = the ESP32 is alive and the fault is downstream of it; comp 195 absent = the ESP32 is unpowered, not booted, or its TELEM1 wiring moved. Do not theorise further until that one line is known.
- USER CAUGHT A TOOL BUG: ring_channels.py's silence message said "its TELEM2 link is down". TELEM2 is the SiK radio; the ESP32 is on TELEM1. Wrong port in the one message a silent ring makes you read. Fixed, and the message now carries the bench-nodes bisection above.
- TOOL UPGRADE (user's request): the readout showed only the CLOSEST value, which cannot separate a sensor pinned at a fixed distance from one tracking the world. It now prints the full MIN-MAX RANGE per channel with the SPAN, and says NEVER CHANGED explicitly when min == max (which is what ch3/4/5 would have shown on the cluttered bench). "Clear" sentinel readings are counted separately so a real object cannot hide inside them. Verified on a synthetic stream: 39-115 cm SPAN 76 (tracking), 5-5 NEVER CHANGED (stuck), clear-throughout, DEAD, FLAKY 50%, plus the up sensor.
- USER SUSPECTS THE CHANNEL-TO-BEARING MAP MAY BE WRONG. config.h has SECTOR_FOR_CHANNEL = identity {0..5} and SENSOR_ANGLE_OFFSET_DEG 0, so every bearing this tool prints is a FIRMWARE CLAIM, not a measurement. The tool now says so and gives the one-object test: put a single object ~50 cm from ONE sensor, re-run, see which channel moves. If the wrong channel moves, SECTOR_FOR_CHANNEL is the fix (a firmware edit, so it needs the ESP32 the user does not want to reopen; a remap is also possible on our side if it ever becomes necessary).
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
