doggylover314/monsoonready-drone/PRIVATE.sample.md

# PRIVATE.md (gitignored; real machine/account details. Never commit.)
# New machine: copy PRIVATE.sample.md to PRIVATE.md and fill in.
UNO_Q_SSH=<user>@<tailnet-ip>
UNO_Q_SUDO=password required (user types it; never ask for it)
GIT_IDENTITY=<name> <email>
GH_ACCOUNT=<github-account>
GH_REPO=<repo-url>
SSH_KEY=<path-to-key>
LAPTOP=<machine, OS, GPU>
QGC_PATH=<path>
PIXHAWK_USB=<serial-device>
