doggylover314/monsoonready-drone/runs/detect/runs/spotcheck/mosquito.v1i.yolov8_frame_000251_jpg.rf.32ca1894a81d535b0154b767c17d7e5e.jpg

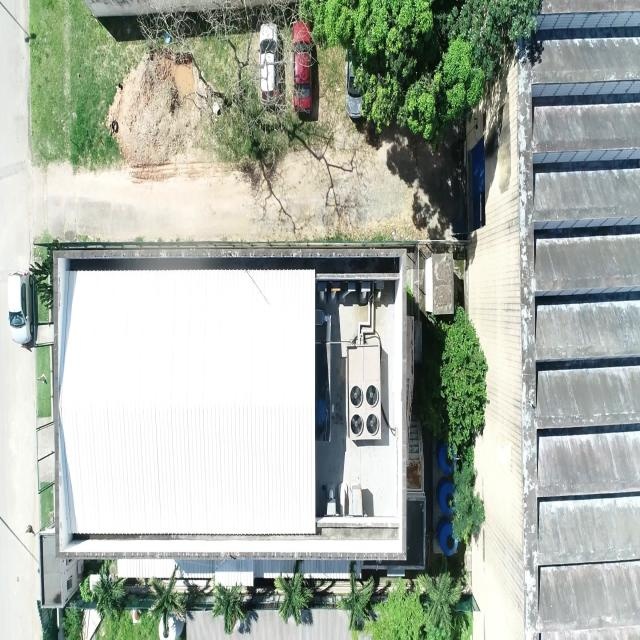
runs/detect/runs/spotcheck/mosquito.v1i.yolov8_frame_000251_jpg.rf.32ca1894a81d535b0154b767c17d7e5e.jpg
