doggylover314/monsoonready-drone/runs/detect/runs/spotcheck/mosquito.v1i.yolov8_frame_000296_jpg.rf.8fa290d8a8c6d4ec6abc635af994a857.jpg

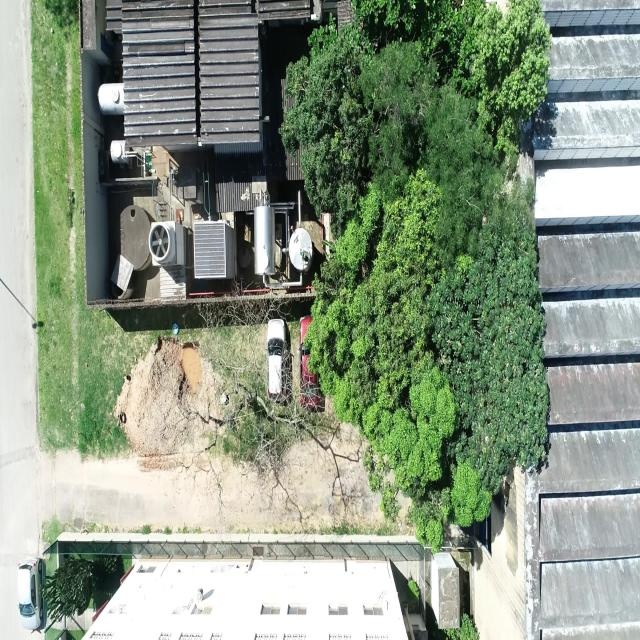
runs/detect/runs/spotcheck/mosquito.v1i.yolov8_frame_000296_jpg.rf.8fa290d8a8c6d4ec6abc635af994a857.jpg
