doggylover314/monsoonready-drone/runs/detect/runs/spotcheck/mosquito.v1i.yolov8_frame_002978_jpg.rf.96917f1c8b3c55c732d0f8aef5107884.jpg

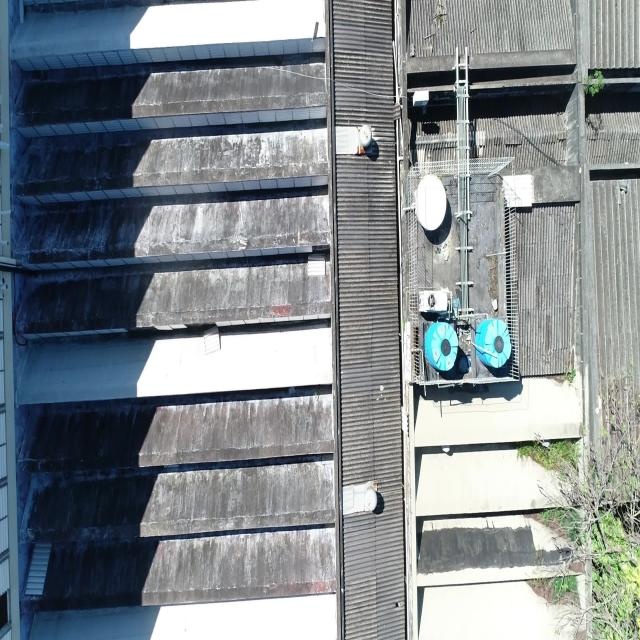
runs/detect/runs/spotcheck/mosquito.v1i.yolov8_frame_002978_jpg.rf.96917f1c8b3c55c732d0f8aef5107884.jpg
