doggylover314/monsoonready-drone/runs/detect/runs/spotcheck/puddle detection.v32-640pure.yolov8_image292_jpeg.rf.ed9637e99633d2d54e175b31537158d6.jpg

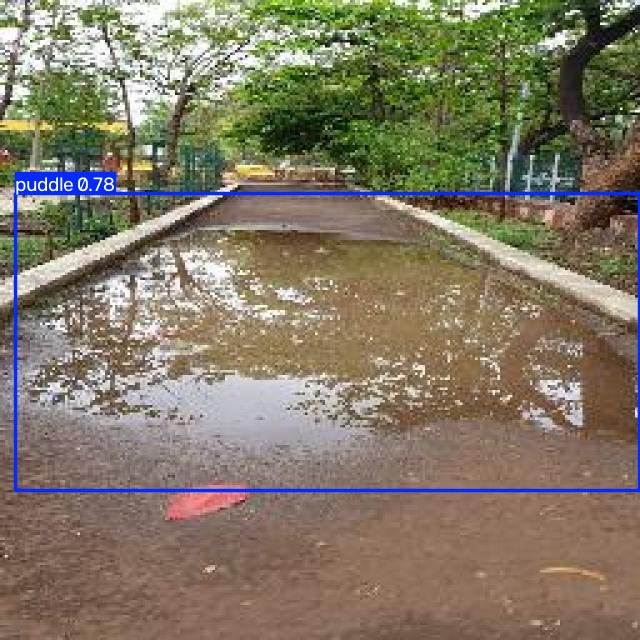
runs/detect/runs/spotcheck/puddle detection.v32-640pure.yolov8_image292_jpeg.rf.ed9637e99633d2d54e175b31537158d6.jpg
