doggylover314/monsoonready-drone/runs/detect/runs/spotcheck/puddle detection.v32-640pure.yolov8_image312_jpeg.rf.f7cf6e5ac4afafdfc7d258b34f9a2225.jpg

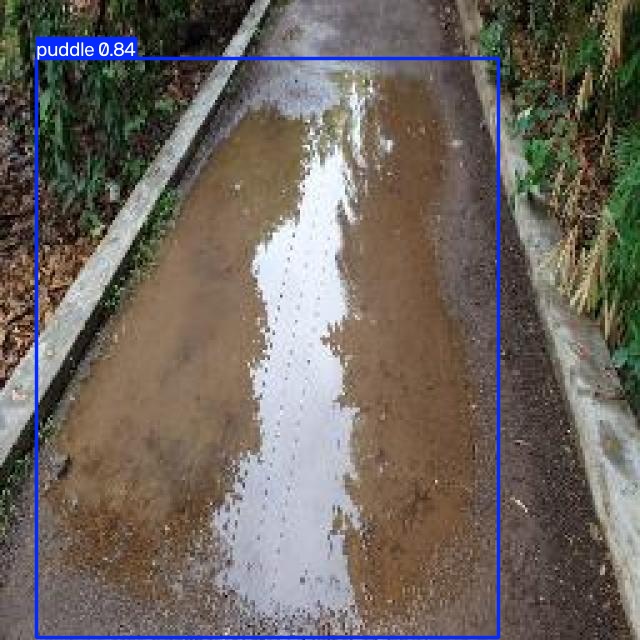
runs/detect/runs/spotcheck/puddle detection.v32-640pure.yolov8_image312_jpeg.rf.f7cf6e5ac4afafdfc7d258b34f9a2225.jpg
