doggylover314/monsoonready-drone/runs/detect/runs/spotcheck/puddle.v2i.yolov8_image348_jpeg_jpg.rf.74dcd01cf21862e084ab5d58e30e6c04.jpg

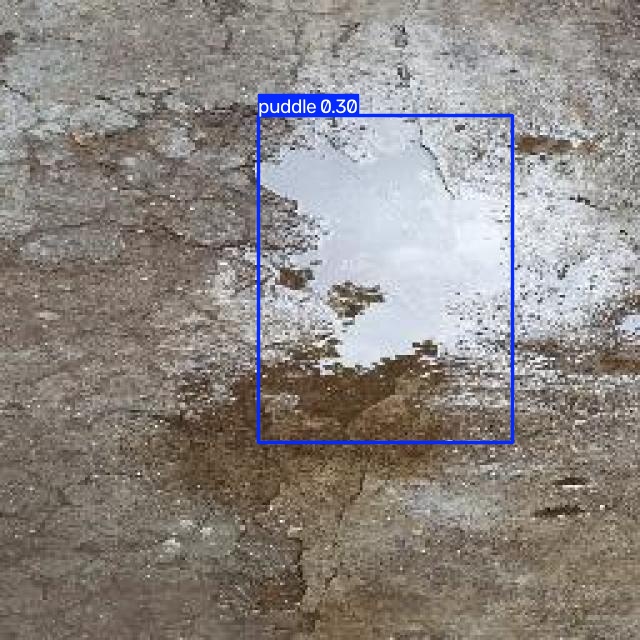
runs/detect/runs/spotcheck/puddle.v2i.yolov8_image348_jpeg_jpg.rf.74dcd01cf21862e084ab5d58e30e6c04.jpg
