doggylover314/monsoonready-drone/runs/detect/runs/spotcheck/puddle.v2i.yolov8_image356_jpeg_jpg.rf.b9af71da8197bf9e66c5f3c53296b9eb.jpg

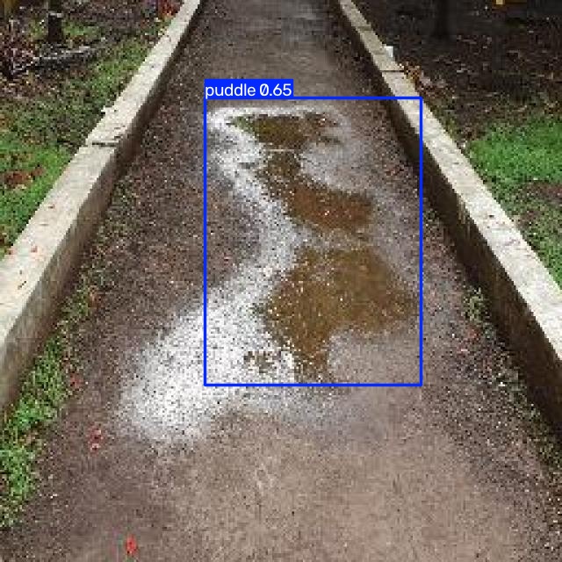
runs/detect/runs/spotcheck/puddle.v2i.yolov8_image356_jpeg_jpg.rf.b9af71da8197bf9e66c5f3c53296b9eb.jpg
