doggylover314/monsoonready-drone/runs/detect/runs/spotcheck/puddle.v2i.yolov8_image1718_jpeg_jpg.rf.48b7d9b7e5f6b37878556adb0918703f.jpg

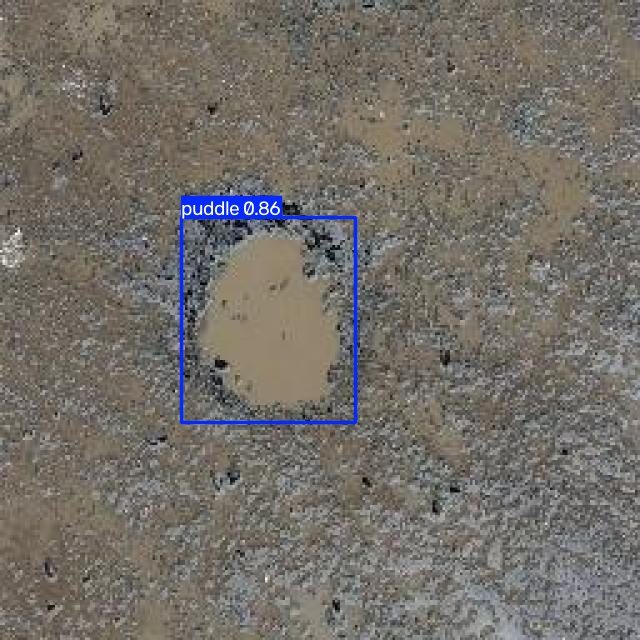
runs/detect/runs/spotcheck/puddle.v2i.yolov8_image1718_jpeg_jpg.rf.48b7d9b7e5f6b37878556adb0918703f.jpg
