doggylover314/monsoonready-drone/runs/detect/runs/spotcheck/puddle_Detect.v2i.yolov8_image647_jpeg_jpg.rf.79c89c5a83d19b426511290d1dea5b66.jpg

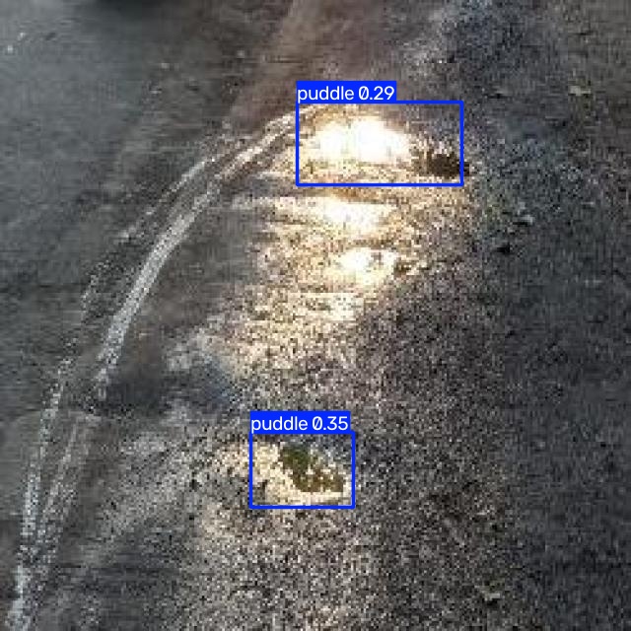
runs/detect/runs/spotcheck/puddle_Detect.v2i.yolov8_image647_jpeg_jpg.rf.79c89c5a83d19b426511290d1dea5b66.jpg
