doggylover314/monsoonready-drone/runs/detect/runs/spotcheck/puddle_Detect.v2i.yolov8_image793_jpeg_jpg.rf.16738420c2954dba8d13bbff0a0881ae.jpg

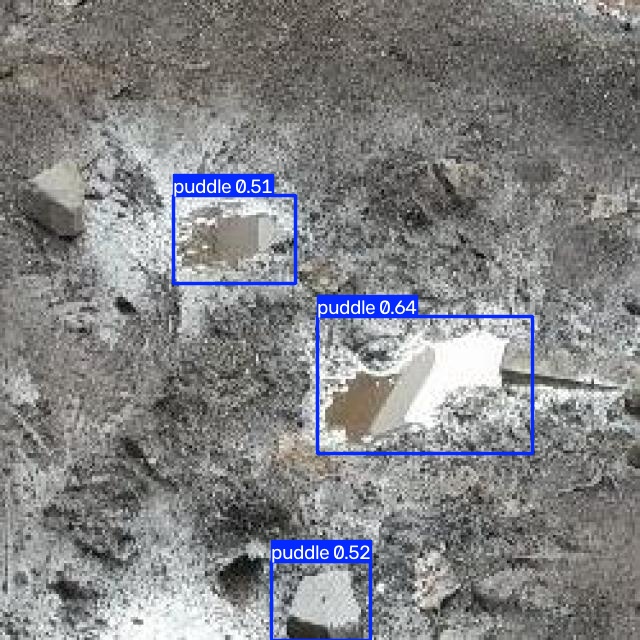
runs/detect/runs/spotcheck/puddle_Detect.v2i.yolov8_image793_jpeg_jpg.rf.16738420c2954dba8d13bbff0a0881ae.jpg
