doggylover314/monsoonready-drone/runs/detect/runs/spotcheck/puddle_Detect.v2i.yolov8_image1723_jpeg_jpg.rf.ba9a997f125f7d7da912b6ed6226cfc5.jpg

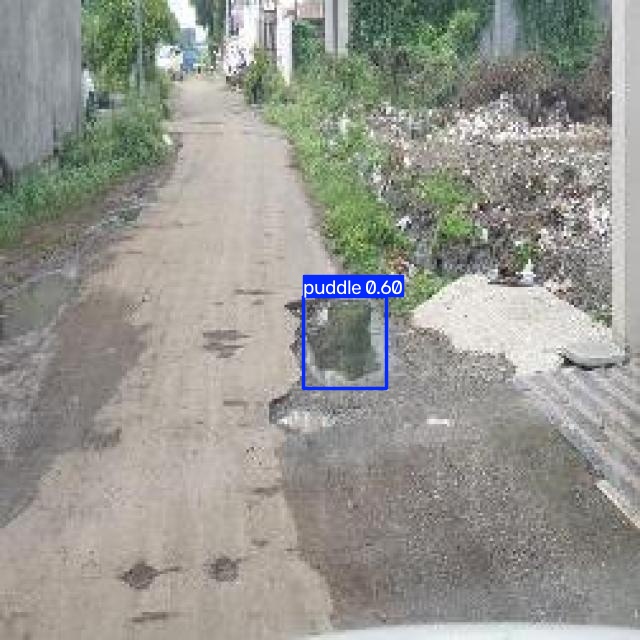
runs/detect/runs/spotcheck/puddle_Detect.v2i.yolov8_image1723_jpeg_jpg.rf.ba9a997f125f7d7da912b6ed6226cfc5.jpg
