doggylover314/monsoonready-drone/runs/detect/runs/spotcheck/water.v2i.yolov8_image26_jpg.rf.1a963e59da925b56f4f5799c0f50f8f1.jpg

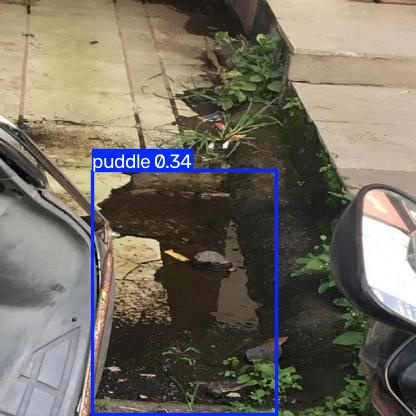
runs/detect/runs/spotcheck/water.v2i.yolov8_image26_jpg.rf.1a963e59da925b56f4f5799c0f50f8f1.jpg
