doggylover314/monsoonready-drone/runs/detect/runs/spotcheck/water.v2i.yolov8_image363_jpg.rf.d7e45e6deb32ffbc4bfb396d12eacdc1.jpg

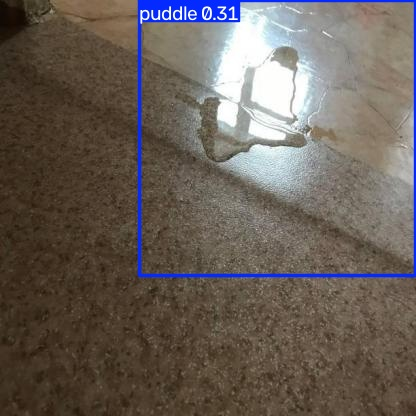
runs/detect/runs/spotcheck/water.v2i.yolov8_image363_jpg.rf.d7e45e6deb32ffbc4bfb396d12eacdc1.jpg
