doggylover314/monsoonready-drone/runs/detect/runs/spotcheck/yinjia-huang-water-part2.yolov8_image71_jpg.rf.ctGRL34PJkfa1rxJONEn.jpg

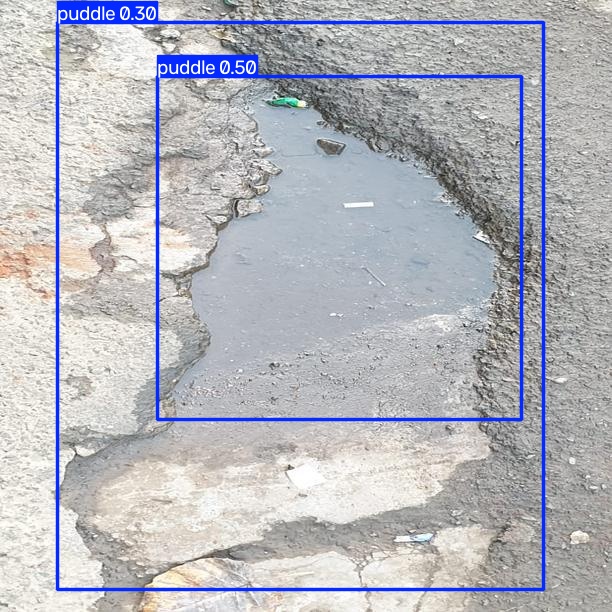
runs/detect/runs/spotcheck/yinjia-huang-water-part2.yolov8_image71_jpg.rf.ctGRL34PJkfa1rxJONEn.jpg
