doggylover314/monsoonready-drone/runs/detect/runs/spotcheck/yinjia-huang-water-part2.yolov8_image416_jpg.rf.08criqFWLm9kyx3jLEdk.jpg

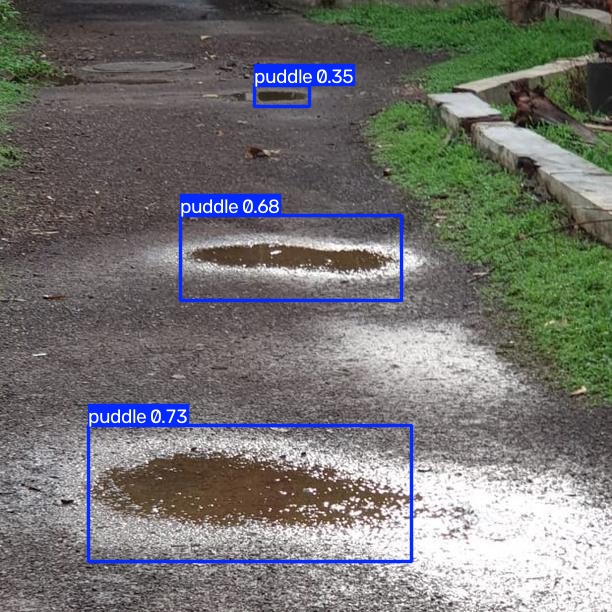
runs/detect/runs/spotcheck/yinjia-huang-water-part2.yolov8_image416_jpg.rf.08criqFWLm9kyx3jLEdk.jpg
