doggylover314/monsoonready-drone/runs/detect/runs/spotcheck/yinjia-huang-water-part2.yolov8_image417_jpg.rf.kJbD8xBzf3koM1QFCEaP.jpg

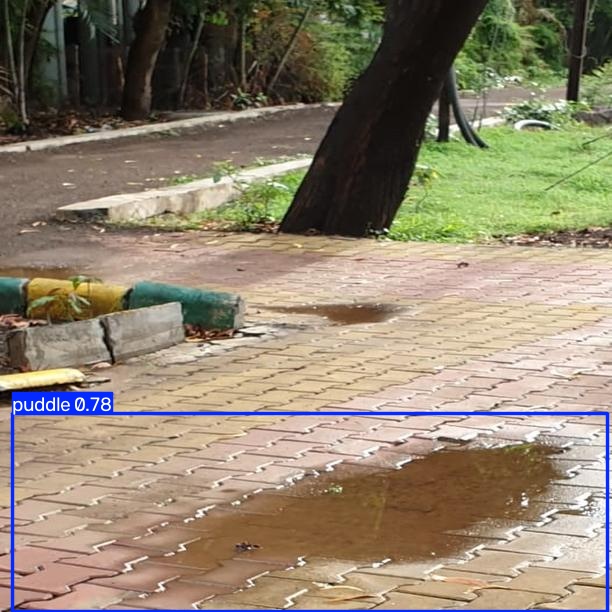
runs/detect/runs/spotcheck/yinjia-huang-water-part2.yolov8_image417_jpg.rf.kJbD8xBzf3koM1QFCEaP.jpg
