doggylover314/monsoonready-drone/runs/detect/runs/spotcheck_aerial/mosquito.v1i.yolov8_frame_000096_jpg.rf.531d26656e1c8d7e8e44e7ab0c181b2a.jpg

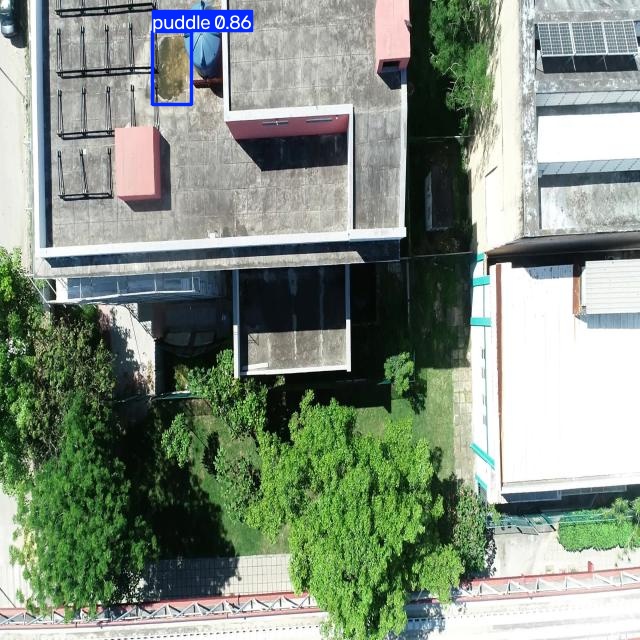
runs/detect/runs/spotcheck_aerial/mosquito.v1i.yolov8_frame_000096_jpg.rf.531d26656e1c8d7e8e44e7ab0c181b2a.jpg
