doggylover314/monsoonready-drone/runs/detect/runs/spotcheck_aerial/mosquito.v1i.yolov8_frame_000102_jpg.rf.acd3cb1451f9a65bb2adceb82d3405bd.jpg

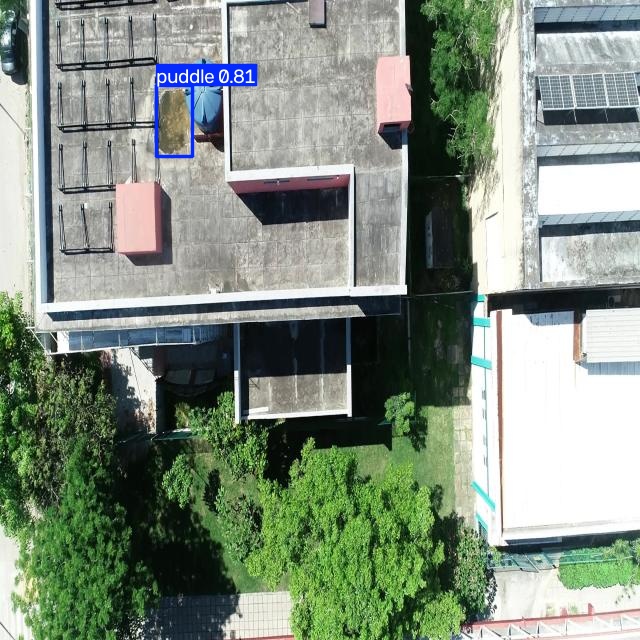
runs/detect/runs/spotcheck_aerial/mosquito.v1i.yolov8_frame_000102_jpg.rf.acd3cb1451f9a65bb2adceb82d3405bd.jpg
