doggylover314/monsoonready-drone/runs/detect/runs/spotcheck_aerial/mosquito.v1i.yolov8_frame_000114_jpg.rf.19c8d49a5c5848875fa31b3762d3b48a.jpg

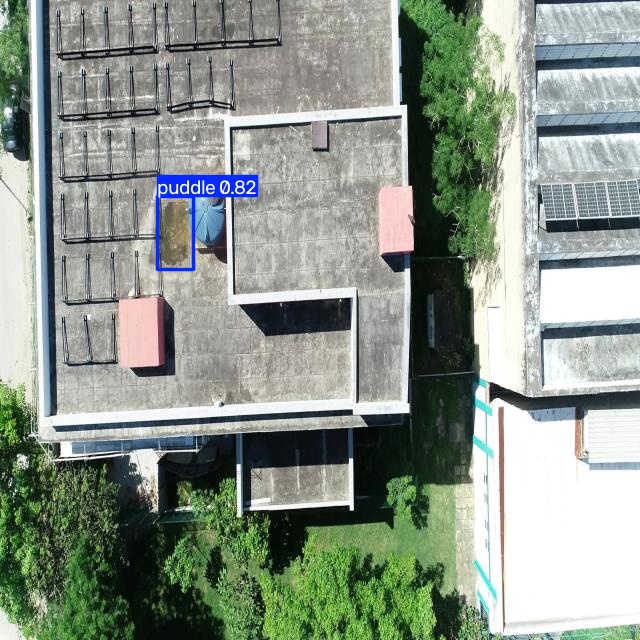
runs/detect/runs/spotcheck_aerial/mosquito.v1i.yolov8_frame_000114_jpg.rf.19c8d49a5c5848875fa31b3762d3b48a.jpg
