doggylover314/monsoonready-drone/runs/detect/runs/spotcheck_aerial/mosquito.v1i.yolov8_frame_000127_jpg.rf.207baa8a756589ce20fa86e64104a00e.jpg

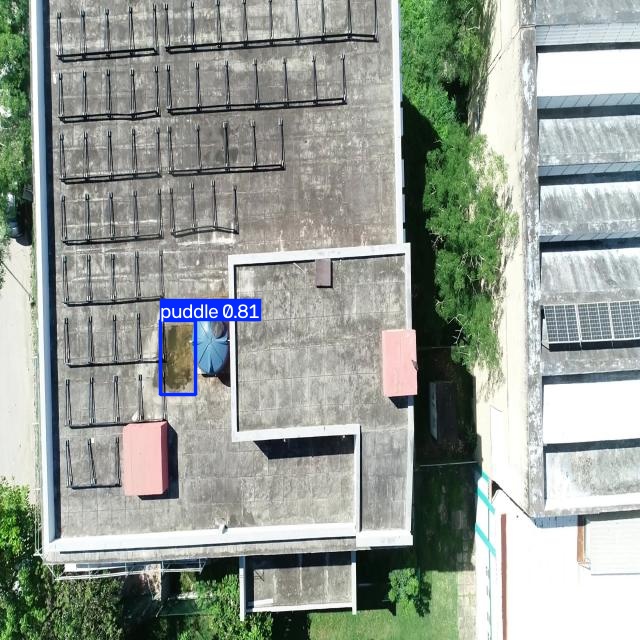
runs/detect/runs/spotcheck_aerial/mosquito.v1i.yolov8_frame_000127_jpg.rf.207baa8a756589ce20fa86e64104a00e.jpg
