doggylover314/monsoonready-drone/runs/detect/runs/spotcheck_aerial/mosquito.v1i.yolov8_frame_000134_jpg.rf.f64dc558abdc0e48d983b1c6be6ceb3e.jpg

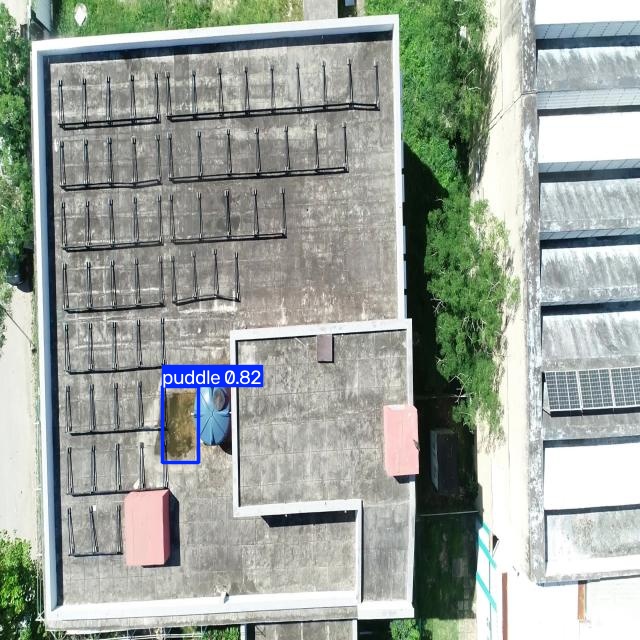
runs/detect/runs/spotcheck_aerial/mosquito.v1i.yolov8_frame_000134_jpg.rf.f64dc558abdc0e48d983b1c6be6ceb3e.jpg
