doggylover314/monsoonready-drone/runs/detect/runs/spotcheck_aerial/mosquito.v1i.yolov8_frame_000139_jpg.rf.61a14a8c0d71613bc6144e5650879679.jpg

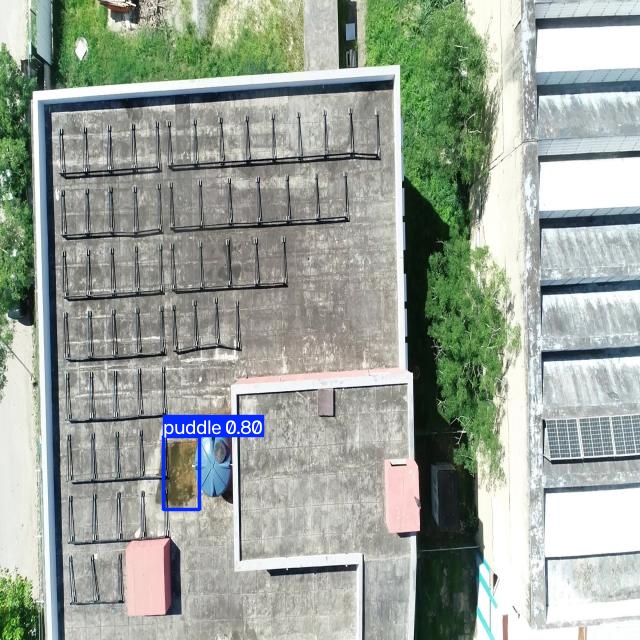
runs/detect/runs/spotcheck_aerial/mosquito.v1i.yolov8_frame_000139_jpg.rf.61a14a8c0d71613bc6144e5650879679.jpg
