doggylover314/monsoonready-drone/runs/detect/runs/spotcheck_aerial/mosquito.v1i.yolov8_frame_000147_jpg.rf.ce13f1d96be2857d9941d6dfe03fb628.jpg

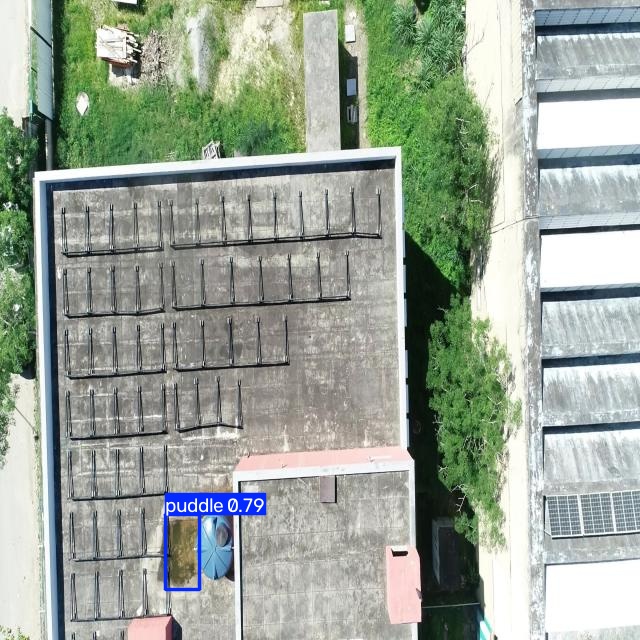
runs/detect/runs/spotcheck_aerial/mosquito.v1i.yolov8_frame_000147_jpg.rf.ce13f1d96be2857d9941d6dfe03fb628.jpg
