doggylover314/monsoonready-drone/runs/detect/runs/spotcheck_aerial/mosquito.v1i.yolov8_frame_003103_jpg.rf.eaeb1c6c82a6466bcd66a59de2fa3a99.jpg

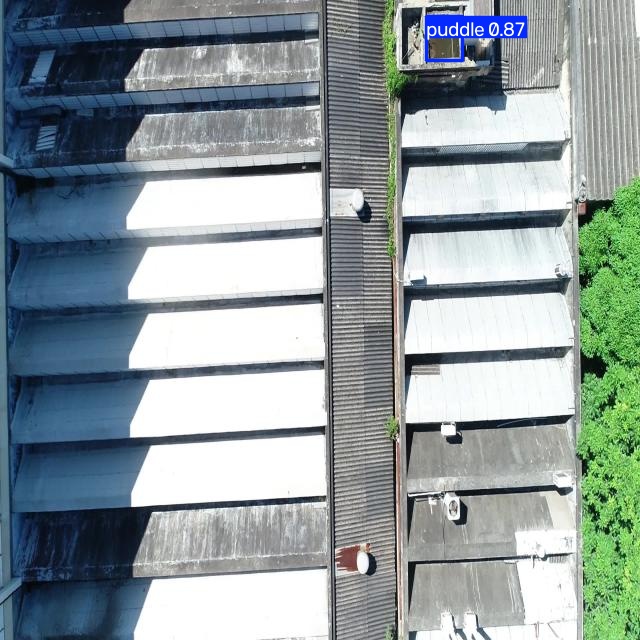
runs/detect/runs/spotcheck_aerial/mosquito.v1i.yolov8_frame_003103_jpg.rf.eaeb1c6c82a6466bcd66a59de2fa3a99.jpg
