doggylover314/monsoonready-drone/runs/detect/runs/spotcheck_aerial/mosquito.v1i.yolov8_frame_003137_jpg.rf.28101135bde505812aba7064f8be1de4.jpg

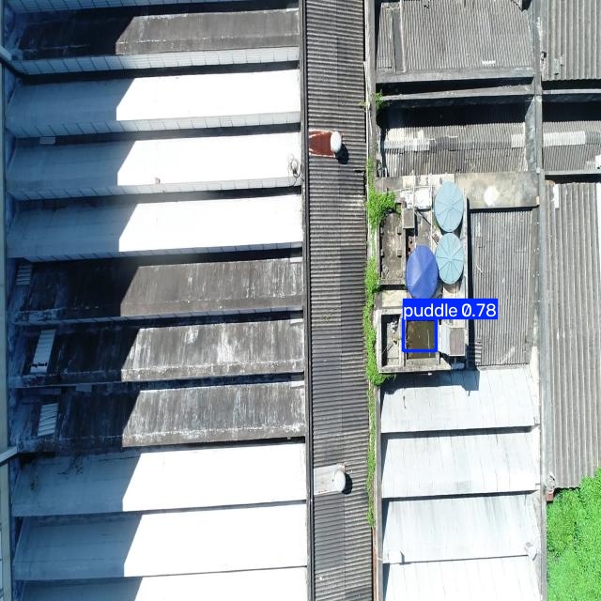
runs/detect/runs/spotcheck_aerial/mosquito.v1i.yolov8_frame_003137_jpg.rf.28101135bde505812aba7064f8be1de4.jpg
