doggylover314/monsoonready-drone/training/spotcheck/puddle_Detect.v2i.yolov8_image793_jpeg_jpg.rf.16738420c2954dba8d13bbff0a0881ae.jpg

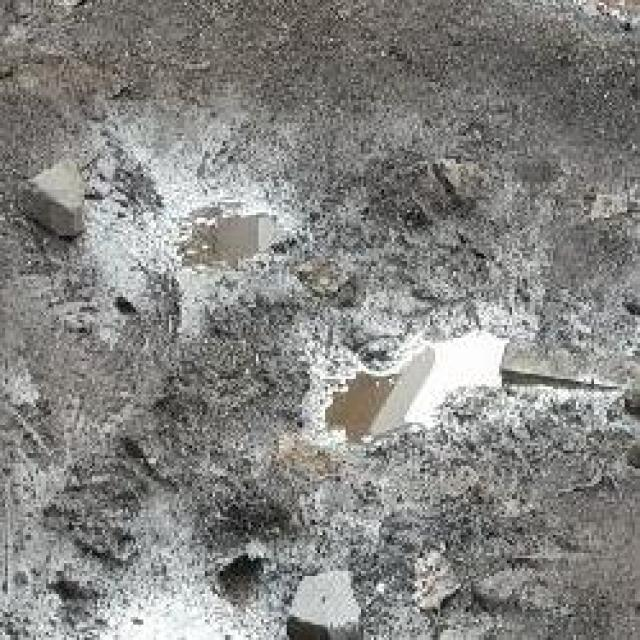
training/spotcheck/puddle_Detect.v2i.yolov8_image793_jpeg_jpg.rf.16738420c2954dba8d13bbff0a0881ae.jpg
