doggylover314/monsoonready-drone/training/spotcheck/yinjia-huang-water-part2.yolov8_image71_jpg.rf.ctGRL34PJkfa1rxJONEn.jpg

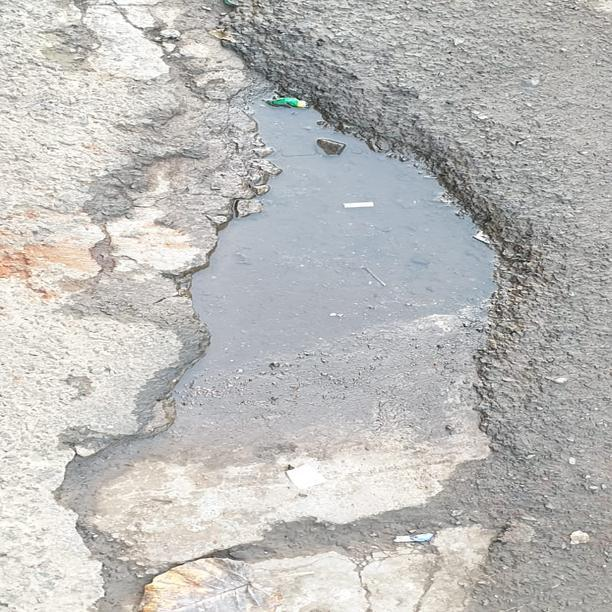
training/spotcheck/yinjia-huang-water-part2.yolov8_image71_jpg.rf.ctGRL34PJkfa1rxJONEn.jpg
