doggylover314/monsoonready-drone/training/spotcheck_aerial/mosquito.v1i.yolov8_frame_000120_jpg.rf.a3cd255a7884ad23fbe54d3179cc2966.jpg

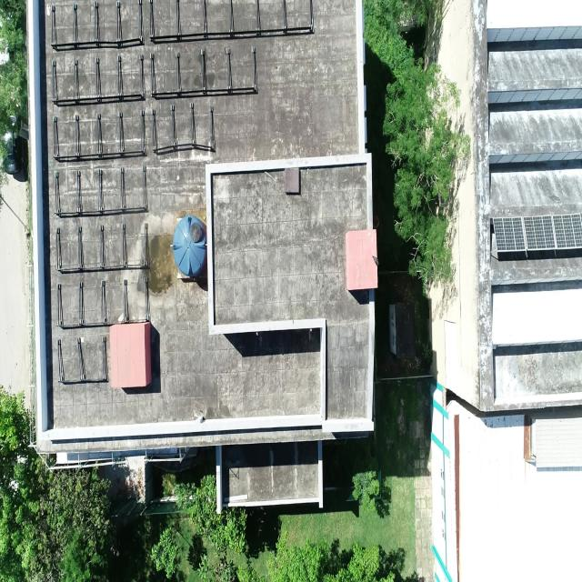
training/spotcheck_aerial/mosquito.v1i.yolov8_frame_000120_jpg.rf.a3cd255a7884ad23fbe54d3179cc2966.jpg
