doggylover314/monsoonready-drone/param_dumps/pixhawk_full_setup.param

FRAME_CLASS,2             # 2 = Hexa
FRAME_TYPE,1              # 1 = X
FLTMODE_CH,7              # mode switch on ch7 (3-pos -> hits modes 1/4/6)
FLTMODE1,0                # Stabilize
FLTMODE2,0                # Stabilize
FLTMODE3,2                # AltHold
FLTMODE4,2                # AltHold
FLTMODE5,5                # Loiter
FLTMODE6,5                # Loiter
SERIAL1_PROTOCOL,2        # TELEM1 = ESP32 obstacle module, MAVLink2
SERIAL1_BAUD,115          # must equal ESP32 PIXHAWK_BAUD (115200)
SERIAL2_PROTOCOL,2        # TELEM2 = SiK telemetry radio, MAVLink2
SERIAL2_BAUD,57           # SiK default 57600
SERIAL4_PROTOCOL,9        # SERIAL4 = TF-Luna, Rangefinder protocol (ports swapped at build 2026-07-27: user wired Luna to #4 lines). VERIFY 9=Rangefinder
SERIAL4_BAUD,115          # TF-Luna default 115200
SERIAL5_PROTOCOL,-1       # was 2 (UNO Q MAVLink2 via STM32 shovel, retired)
SERIAL5_BAUD,115
SERVO9_FUNCTION,0
SERVO9_MIN,500
SERVO9_MAX,1800
SERVO9_TRIM,500
INS_HNTCH_ENABLE,1        # reboot to expose sub-params
INS_HNTCH_MODE,1          # 1 = throttle-based (3 = ESC telemetry if BLHeli path adopted)
INS_HNTCH_REF,0.30        # PLACEHOLDER: set to learned MOT_THST_HOVER from a LOADED hover log
INS_HNTCH_FREQ,80         # PLACEHOLDER: set from FFT of hover log
INS_HNTCH_BW,40           # PLACEHOLDER: ~half of FREQ
MOT_HOVER_LEARN,2         # 2 = learn and save
BATT_MONITOR,4            # 4 = analog voltage+current. Reboot, then calibrate
BATT_CAPACITY,8000
BATT_FS_VOLTSRC,1         # 1 = sag-compensated (was 0 = raw terminal volts)
BATT_LOW_VOLT,10.5        # was 10.8; 3.5 V/cell under load
BATT_CRT_VOLT,10.0        # was 10.2; 3.33 V/cell under load
BATT_FS_LOW_ACT,2         # 2 = RTL (user-confirmed policy)
BATT_FS_CRT_ACT,1         # 1 = Land
BATT_LOW_MAH,1600
BATT_CRT_MAH,800
BATT_AMP_PERVLT,24
BATT_VOLT_MULT,10.802477
