doggylover314/monsoonready-drone/esp32_obstacle_avoidance/proximity_sensors.cpp

// =============================================================================
//  proximity_sensors.cpp  --  Implementation of the sensor-reading layer.
// =============================================================================

#include "proximity_sensors.h"

// Is a sensor physically present on this mux channel? Ring channels come from
// RING_SENSOR_FITTED, the up channel from UP_SENSOR_FITTED (both in config.h).
// Outside the USE_FAKE_SENSORS guard on purpose: the health counters need it
// in both modes.
static bool isFitted(uint8_t ch) {
  if (ch == UP_SENSOR_CHANNEL) return UP_SENSOR_FITTED;
  return (ch < NUM_RING_SENSORS) ? RING_SENSOR_FITTED[ch] : false;
}

#if !USE_FAKE_SENSORS
// ---- Real hardware path ----------------------------------------------------
#include <Wire.h>
#include <VL53L0X.h> // Pololu VL53L0X library (Library Manager / lib_deps = pololu/VL53L0X)

// One driver object per mux channel. Pololu staff note: use a SEPARATE object
// per sensor, otherwise every channel reports the same value.
static VL53L0X g_sensor[NUM_SENSORS];

// Select a single downstream channel on the TCA9548A. The control register is a
// bitmask, so writing (1 << ch) enables exactly that one channel and disables
// the rest. Call this before every transaction with the sensor on that channel.
static void tcaselect(uint8_t ch) {
  if (ch > 7) return;
  Wire.beginTransmission(TCA9548A_ADDR);
  Wire.write(1 << ch);
  Wire.endTransmission();
#if TCA_SETTLE_US > 0
  delayMicroseconds(TCA_SETTLE_US);
#endif
}
#endif // !USE_FAKE_SENSORS

// -----------------------------------------------------------------------------
// Full bring-up of one channel: select, init, timing budget, continuous mode.
// Shared by begin() (boot) and maintain() (self-healing re-init), so the two
// paths can never configure a sensor differently.
bool ProximitySensors::initChannel(uint8_t ch) {
#if USE_FAKE_SENSORS
  (void)ch;
  return true;
#else
  tcaselect(ch);
  g_sensor[ch].setTimeout(SENSOR_TIMEOUT_MS);
  if (!g_sensor[ch].init()) return false;

  // Timing budget MUST be set before startContinuous() or it has no effect.
  g_sensor[ch].setMeasurementTimingBudget(SENSOR_TIMING_BUDGET_US);

#if VL53L0X_LONG_RANGE
  // Longer reach (~2 m) at the cost of speed / low-IR requirement.
  g_sensor[ch].setSignalRateLimit(0.1);
  g_sensor[ch].setVcselPulsePeriod(VL53L0X::VcselPeriodPreRange, 18);
  g_sensor[ch].setVcselPulsePeriod(VL53L0X::VcselPeriodFinalRange, 14);
#endif

  // Back-to-back continuous ranging. All sensors integrate in parallel; the
  // mux only time-shares who we can *read*, not who is *measuring*.
  g_sensor[ch].startContinuous();
  return true;
#endif
}

// -----------------------------------------------------------------------------
bool ProximitySensors::begin() {
#if USE_FAKE_SENSORS
  for (uint8_t ch = 0; ch < NUM_SENSORS; ch++) _ok[ch] = isFitted(ch);
  DEBUG_SERIAL.println(F("[sensors] FAKE mode: no hardware in use."));
  return true;
#else
  Wire.begin(I2C_SDA_PIN, I2C_SCL_PIN);
  Wire.setClock(I2C_CLOCK_HZ);

  bool all_ok = true;
  for (uint8_t ch = 0; ch < NUM_SENSORS; ch++) {
    // Channels declared empty in config.h are skipped entirely: probing one
    // costs about a second of boot time waiting for a timeout, and reports a
    // "FAILED" that hides the failures that matter. _ok stays false, so
    // readAll() keeps returning SENSOR_MM_ERROR for it and the sector goes
    // out as "unknown", which is the correct thing to tell an autopilot
    // about a direction we cannot see.
    if (!isFitted(ch)) {
      _ok[ch] = false;
      DEBUG_SERIAL.printf("[sensors] ch%u: not fitted (config.h), sector "
                          "reported as unknown\n", ch);
      continue;
    }
    _ok[ch] = initChannel(ch);
    if (_ok[ch]) {
      DEBUG_SERIAL.printf("[sensors] ch%u: VL53L0X OK\n", ch);
    } else {
      all_ok = false;
      DEBUG_SERIAL.printf("[sensors] ch%u: VL53L0X init FAILED (check "
                          "wiring/mux); will keep retrying every %u ms\n",
                          ch, (unsigned)SENSOR_RETRY_PERIOD_MS);
    }
  }
  return all_ok;
#endif
}

// -----------------------------------------------------------------------------
void ProximitySensors::readAll(uint16_t out_mm[NUM_SENSORS]) {
#if USE_FAKE_SENSORS
  // Unfitted channels report ERROR here exactly as they do on real
  // hardware. Reporting them clear told the autopilot that a sector with no
  // sensor in it was proven empty, which is the one thing config.h warns
  // against.
  for (uint8_t ch = 0; ch < NUM_SENSORS; ch++) {
    out_mm[ch] = isFitted(ch) ? FAKE_CLEAR_MM : SENSOR_MM_ERROR;
  }
  if (FAKE_VARY_CHANNEL < NUM_SENSORS && isFitted(FAKE_VARY_CHANNEL)) {
    out_mm[FAKE_VARY_CHANNEL] = FAKE_VARY_MM;
  }
#else
  for (uint8_t ch = 0; ch < NUM_SENSORS; ch++) {
    if (!_ok[ch]) {
      out_mm[ch] = SENSOR_MM_ERROR;
      continue;
    }
    tcaselect(ch);
    uint16_t mm = g_sensor[ch].readRangeContinuousMillimeters();
    // A read timeout means the transaction failed (dead sensor / bus glitch);
    // distinguish it from a valid "no target" reading (large mm value).
    if (g_sensor[ch].timeoutOccurred()) {
      out_mm[ch] = SENSOR_MM_ERROR;
      // Enough consecutive timeouts = the sensor's continuous mode is gone
      // (brown-out or contact bounce); flag it for maintain() to re-init.
      if (_err[ch] < 255) _err[ch]++;
    } else {
      out_mm[ch] = mm;
      _err[ch] = 0;
    }
  }
#endif
}

// -----------------------------------------------------------------------------
#if !USE_FAKE_SENSORS
// Free a stuck I2C bus. A slave abandoned mid-transaction (brown-out, contact
// bounce) can hold SDA low forever, which kills every channel at once and no
// per-channel re-init can fix, because re-init needs the bus. The standard
// cure: with SDA released on our side, clock SCL up to 9 times so the slave
// shifts out the rest of its byte and lets go, then issue a STOP and bring
// the Wire peripheral back up.
static void busClear() {
  Wire.end();
  pinMode(I2C_SDA_PIN, INPUT_PULLUP);
  pinMode(I2C_SCL_PIN, OUTPUT);
  for (uint8_t i = 0; i < 9 && digitalRead(I2C_SDA_PIN) == LOW; i++) {
    digitalWrite(I2C_SCL_PIN, LOW);
    delayMicroseconds(5);
    digitalWrite(I2C_SCL_PIN, HIGH);
    delayMicroseconds(5);
  }
  pinMode(I2C_SDA_PIN, OUTPUT);          // STOP: SDA low->high while SCL high
  digitalWrite(I2C_SDA_PIN, LOW);
  delayMicroseconds(5);
  digitalWrite(I2C_SCL_PIN, HIGH);
  delayMicroseconds(5);
  digitalWrite(I2C_SDA_PIN, HIGH);
  delayMicroseconds(5);
  Wire.begin(I2C_SDA_PIN, I2C_SCL_PIN);
  Wire.setClock(I2C_CLOCK_HZ);
}
#endif

uint8_t ProximitySensors::ringFitted() const {
  uint8_t n = 0;
  for (uint8_t ch = 0; ch < NUM_RING_SENSORS; ch++)
    if (isFitted(ch)) n++;
  return n;
}

uint8_t ProximitySensors::ringHealthy() const {
  uint8_t n = 0;
  for (uint8_t ch = 0; ch < NUM_RING_SENSORS; ch++)
    if (isFitted(ch) && channelHealthy(ch)) n++;
  return n;
}

// -----------------------------------------------------------------------------
void ProximitySensors::maintain() {
#if !USE_FAKE_SENSORS
  uint32_t now = millis();

  // Whole-bus death first: if NOTHING fitted is healthy (ring or up), the
  // shared bus is the suspect, and re-initing channels one at a time through
  // a stuck bus can never work.
  uint8_t fitted_all = 0, healthy_all = 0;
  for (uint8_t ch = 0; ch < NUM_SENSORS; ch++) {
    if (!isFitted(ch)) continue;
    fitted_all++;
    if (channelHealthy(ch)) healthy_all++;
  }
  const bool all_down = (fitted_all > 0 && healthy_all == 0);
  if (all_down && now - _last_bus_clear_ms < BUS_CLEAR_PERIOD_MS) {
    // Bus clear already tried recently and everything is still down. Falling
    // through to the per-channel round-robin here is what produced the
    // ~1.07 s stalls measured in config.h: each blocking init is longer than
    // ArduPilot's 500 ms proximity timeout, so the autopilot declared the
    // sensor dead and refused to arm. Wait for the next bus-clear instead.
    return;
  }
  if (all_down) {
    _last_bus_clear_ms = now;
    DEBUG_SERIAL.println(F("[sensors] every fitted channel is down: "
                           "clearing the I2C bus and re-initing all"));
    busClear();
    for (uint8_t ch = 0; ch < NUM_SENSORS; ch++) {
      if (!isFitted(ch)) continue;
      _ok[ch] = initChannel(ch);
      _err[ch] = 0;
      DEBUG_SERIAL.printf("[sensors] ch%u: %s after bus clear\n", ch,
                          _ok[ch] ? "OK" : "still dead");
    }
    return;
  }

  if (now - _last_retry_ms < SENSOR_RETRY_PERIOD_MS) return;

  // One attempt per period, round-robin, so a permanently dead chip (ch2)
  // costs one bounded init attempt every few periods, never a tight loop.
  for (uint8_t i = 0; i < NUM_SENSORS; i++) {
    uint8_t ch = _retry_ch;
    _retry_ch = (uint8_t)((_retry_ch + 1) % NUM_SENSORS);
    if (!isFitted(ch)) continue;
    bool needs = !_ok[ch] || _err[ch] >= SENSOR_RETRY_ERR_READS;
    if (!needs) continue;

    _last_retry_ms = now;      // only a real attempt consumes the period
    bool was_ok = _ok[ch];
    if (initChannel(ch)) {
      _ok[ch] = true;
      _err[ch] = 0;
      DEBUG_SERIAL.printf("[sensors] ch%u: re-init OK%s\n", ch,
                          was_ok ? " (was timing out)" : " (was dead)");
    } else {
      _ok[ch] = false;
      DEBUG_SERIAL.printf("[sensors] ch%u: re-init failed, next try in "
                          "%u ms\n", ch, (unsigned)SENSOR_RETRY_PERIOD_MS);
    }
    return;
  }
#endif
}
