doggylover314/monsoonready-drone/(commit log)

2026-07-25 MonsoonReady: ESP32 obstacle firmware, param system, training pipeline, project state
    - esp32_obstacle_avoidance: compile-verified firmware with fake-mode TX guard
    - pixhawk_full_setup.param: hand-maintained config (55 params, board-verified)
    - tools/: pull/push/merge param utilities (pymavlink + QGC formats)
    - training/: YOLO pipeline (merge, train with resume, ONNX export)
    - PROJECT_STATE.md: single source of truth
    [ardupilot_proximity.param, pixhawk_full_setup.param]
2026-07-25 State: params board-verified, git conventions, GNDCLR rename
2026-07-25 param_dumps/ folder: tool paths, gitignore; record explain-dont-just-do preference
    [pixhawk_full_setup.param]
2026-07-26 Split private machine/account details into gitignored PRIVATE.md with tracked sample
2026-07-26 uno_q mission package: SITL-tested state machine (TODO 10 done, 11 core done)
    [sitl_rangefinder.parm]
2026-07-26 docs: rewrite in esp32 README house style (reference prose, not a task list); uno_q README same
2026-07-26 Base station (TODO 13): JSONL mission log + Flask heatmap dashboard
    - uno_q/missionlog.py: per-mission JSONL event log, schema single-source,
    crash-tolerant (flush per event), injectable clock
    - mission.py: optional recorder= hook (null-object default, SITL tests
    unchanged), logs start/fix/state/detection/latch/drop/abort/end,
    auto-launches base station via MissionConfig.basestation_cmd
    - uno_q/basestation/: read-only Flask app (:8080) + self-contained
    vanilla-JS dashboard (canvas heatmap, layer toggles, persistent-site
    rings across flights, per-flight filter, stats, tooltips, event table,
    optional georeferenced site image, light+dark)
    - gen_fake_mission.py: 2 fake flights for la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
    [mission.py, missionlog.py]
2026-07-27 power map: record WHY UNO Q feeds from 5V pin not VIN (VIN disables USB VBUS out, camera would be unpowered)
2026-07-27 truth rules 8+9: decisions keep their why, hardware specs verified before wiring; VERIFY-BEFORE-WIRING sweep of power map
2026-07-27 plate layout proposal: below/bottom/top placement + battery CG decision by measurement, VERIFY items marked
2026-07-27 UBEC 5.3V ruling: in-spec for UNO Q 5V pin (4.5-5.5 window, docs-verified) but re-meter under load; camera VBUS margin flagged
2026-07-27 wiring rule: UNO Q 5V feed in UBEC-gauge wire not dupont, multiple GND returns; >=3A = peak budget not continuous
2026-07-27 correct record: UBEC has no output leads (assumed form factor retracted); user-supplied 18-20 AWG feed, soldered, short
2026-07-27 5V feed termination ruling: no bare wire in headers; screw-terminal shield preferred, pinned+strain-relieved fallback
2026-07-27 camera connected: user running TODO-2 bench test sequence
2026-07-27 micro-fact: UNO Q status LED map (red:panic/green:wlan/blue:bt); blue+cyan = normal radio status
2026-07-27 TODO-2 blocked: UNO Q USB host mode diagnosis (sink-only typec, 5V pin = VBUS net schematic-verified, buildinfo/flash lead)
2026-07-28 VBUS meter-confirmed 5.20V at connector (UBEC loaded test PASS); USB blocker narrowed to data path/PHY on image 20251210-442
2026-07-28 USB host theory: 5V-pin powering = VBUS-present trap holding PHY in device role; VIN power test is the decider
2026-07-28 VIN test: VBUS self-sourced 5.2V (old VIN rule falsified) but enumeration still dead; root cause PMIC-typec data path; adopted PD-hub flight plan
2026-07-28 board reflashed to May-2026 image: native host mode on VIN confirmed; usb_vbus disable = cosmetic; re-setup checklist; new board IP (PRIVATE)
2026-07-28 USB case closed: sink-only port + passive adapter = no Type-C attach by spec; PD hub required and adopted as flight config
2026-07-28 hub cart researched: Mport 52 primary + ETZIN backup + 12V car PD adapter as flight-power insurance; 3-stage bench sequence
2026-07-29 run2 COMPLETE: plateau stop e322, best e272 P .801 R .705 mAP50 .766 mAP50-95 .467 on v2 val
2026-07-29 SERIAL4/5 swap: Luna on 4, UNO Q on 5 (matches as-built wiring); params edited, push pending
    [pixhawk_full_setup.param]
2026-07-29 3V3 rail budget verified from datasheets: mux uA-class, VL53L0X ~19mA ranging; remaining VERIFY = dev-board regulator under load
2026-07-29 assembly: 3V3 distribution hub design for mux + 7 sensors (perfboard rails, per-sensor bundles)
2026-07-29 ETZIN splitter arrived early: B525 enumerates on UNO Q, camera USB blocker cleared; UBEC-power flight test still open
2026-07-29 standing rule: no board access/SSH-key use without permission; UBEC-power camera gate PASS; camera device/fmt facts corrected
2026-07-29 camera TODO 2 done: 720p MJPG capture + focus lock verified; run2 ONNX exported, board re-setup commands issued
2026-07-29 spotcheck_onnx.py: batch folder spot-check with results.jsonl + grid montage for board/laptop parity diff
2026-07-29 board benchmark recorded: 2.05 fps A53; spotcheck parity set + laptop baseline ready; UNO Q 32GB correction
2026-07-29 TODO 1 closed: board benchmark 2.05fps + exact laptop/board spotcheck parity; grids saved as docs evidence
2026-07-29 OnnxDetector implemented: proven preprocessing, poll throttle, fired-site dedup, injectable frame source; 6/6 laptop checks
2026-07-29 dashboard: wheel zoom + drag pan + dblclick reset; abort tile red; gen_fake_mission --flights/--seed random mode
2026-07-29 state: dashboard v2 tested (zoom/pan, red aborts, random generator), board deploy confirmed, bg-run recipe
2026-07-31 TODO 11/14 done, 13 runner, 12 blocked on UNO Q Serial1 conflict; servo moves to Pixhawk PWM
2026-08-01 peer review of da64b13: 1 critical + 4 major confirmed as TODO 10; POWER MAP servo-signal contradiction fixed; TODO 11/12/14 updated to reality
2026-08-01 TODO 10 fixes: mission containment + settle-before-drop + MG90 rename
    Critical: run_mission.py called Mission.run() bare, so any exception or a
    SIGHUP from a dropped ssh session killed the loop wherever it stood. Now
    signals wind the state machine up through the normal path (new STOPPED
    terminal state, which still commands RTL), and any raise triggers a
    best-effort emergency RTL plus a CRASHED mission_end.
    Major: the zero-velocity setpoint before a drop was silently eaten by the
    0.2s setpoint rate limiter, so the gate opened while still descending.
    velocity_ned gains force= for setpoint CHANGES, and DROP now holds until
    |vd| has actually arrested before the gate opens. Aborts force their cl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
    [camera_geom.py, detector.py, dropper.py, mavlink_io.py, mission.py, missionlog.py, predict.py, run_mission.py]
2026-08-01 model-size question reopened (user is right): bench scripts + area-dosing conflict recorded
    SITL happy path PASSED with the settle-before-drop change, same release
    height (rng 2.98m). Dropout drill still unrun.
    The "no" on yolo26s/m assumed the detection is only ever a centroid. The
    user's plan estimates puddle area from the box to size the Bti dose, which
    makes box quality load-bearing, so the question is now measured rather than
    argued: training/export_variants.py exports stock pretrained variants for
    timing only, uno_q/bench_models.py times them on the board with the same
    letterbox the flight code uses and reports what the mission loop blocks for.
    Also recorded: area-based dosing has si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
2026-08-01 model-size bench: gitignore variants + root .pt; state notes for board run
2026-08-01 model-size bench results: s=1921ms, m=4378ms on board; m out, s marginal
2026-08-01 state: board ONNX path + single-thread blocking Q&A + off-thread mitigation
2026-08-01 detector off-thread: detect_worker.py + FileDetector w/ frame-time telemetry pairing; ort warning silenced; summarize drops fix
    [bench_models.py, detect_worker.py, detector.py, run_mission.py]
2026-08-01 rule: one command block per machine; state: camera not at video1, board uno_q stale
2026-08-01 state: video1 chosen, board dry-run over tcp was wrong; worker-only smoke test until TODO 12
2026-08-01 state: FOV attempt 2 unreadable, switch to marker-alignment method
2026-08-01 state: 1080p/autofocus for FOV calibration rejected, must match flight config
2026-08-01 high-res model question: export --imgsz + bench auto input size; 1080p calibration via crop-equivalence
2026-08-01 state: FOV attempt 3 (66cm defocus); AF allowed only with focus-breathing paired-capture check
2026-08-01 state: FOV rig = table-edge mount at low height + AF (no 2m mount available)
2026-08-01 state: AF paired check inconclusive (identical frames); manual-focus probe + coin-marker fallback
2026-08-03 POWER MAP: mark 5V-pin feed superseded by splitter path (was stale vs 2026-07-29 gate pass)
2026-08-03 POWER MAP resolved: two fixed 5V USB-out bucks, no adjustable XY-3606 exists; rails reassigned; Pixhawk wire checklist recorded (I2C splitter = new part)
2026-08-03 TELEM1/2 swap follows wires: params + config.h comments; SERVO14 staged (AUX6); tools/wiring_check.py; state updated
    [pixhawk_full_setup.param]
2026-08-03 state: ESP32 flash order revised to real-mode-first (ring fully wired), fake mode demoted to bisect fallback
2026-08-03 state: ESP32 flashed fake (fallback path) despite real-first revision; both paths offered
2026-08-03 state: ESP32 reflash blocked on missing serial port node; CP210x visible in lsusb; diagnosis sent
2026-08-03 ESP32: no-prior-flash correction (state was wrong); port+perms verified fine; suspect VSCode workspace root; pin upload_port
2026-08-03 state: OLED dark, ranked diagnosis ladder (power/param/chip/addr/splice)
2026-08-03 state: params pushed+verified, wiring check all PASS; up-facing sensor silent (new finding); OLED narrowed to power/reboot/chip/addr
2026-08-03 state: OLED is a regression (powered 5.25V, both types, rebooted); suspects = 4.7 feature trim, GND leg, stub joints
2026-08-03 OLED SOLVED: loose GND on the OLED stub; feature-trim theory dead; lesson recorded
2026-08-05 servo on AUX1=ch9 (supersedes ch14); wiring_check: up-sensor line, --motor-test, --wiggle default 9
    [pixhawk_full_setup.param]
2026-08-05 state: battery monitor calibration guidance; module model unrecorded (TODO)
2026-08-05 state: correct QGC analog pin preset for 2.4.8 recorded (PM1)
2026-08-05 state: no ammeter pin pair exists; series-in-pack-lead or DC clamp, with safety notes
2026-08-05 wiring_check: lock onto autopilot heartbeat (ESP32 was stealing wait_heartbeat -> broadcast targeting), ack drain+match; motor test requires live RC
2026-08-06 tools work over the SiK radio: push_params baud arg, wiring_check rate halving + RADIO_STATUS proves the SiK link
2026-08-06 wiring_check: exit as soon as every check reports (max 12s, was a fixed 25s)
    [wiring_check.py]
2026-08-06 state: ch6 hot-plug theory dead (aircraft power-cycled for days); remaining candidates listed
2026-08-06 retract unfounded ch6 failure claim: untested since the sensor was connected
2026-08-06 SiK verdict keys on the link not RADIO_STATUS (framing mode may be off); ch6 failure now measured, empty-ceiling explanation ruled out in source
    [wiring_check.py]
2026-08-06 ch1 AND ch6 fail I2C init (err 263 timeout); wiring_check now scores ring sectors, a dead sensor no longer hides behind a streaming message
    [wiring_check.py]
2026-08-06 ring is between the arms, not on them: angle_offset 30 -> 0 (config.h, README, state, wiring_check); ch6 was an unconnected 3V3 leg
2026-08-07 state: powering the up sensor from the Pixhawk is not verified safe (no 3.3V rail, 5V-on-mux hazard); use the 3V3 hub
2026-08-07 retract unverified 'servo rail is 5V logic' claim; record what actually determines AUX output level and how to test it
2026-08-07 correct GND claim: all grounds are one net (user right); real concern is I2C return path, not a floating reference
2026-08-07 ESP32 I2C diagnostic mode: per-channel scan, mux readback, stuck-line check, bus-speed sweep (RUN_I2C_DIAG in config.h)
    [config.h, esp32_obstacle_avoidance.ino, i2c_diag.cpp, i2c_diag.h]
2026-08-07 SESSION CONTINUITY: Raghav flashing the I2C diag at Reyansh's bench; ttyUSB collision gotcha
2026-08-07 diag results: ch6 absent from bus, ch1/ch3 intermittent (not speed-dependent); 3V3 rail now prime suspect; add 20x repeat test
2026-08-07 diagnosis change: failures move between channels/runs = systemic bus instability, not per-sensor wiring; bisect-by-load is the decisive test
2026-08-07 ESP32: declare which ring channels are fitted (rear 3 removed); skip probing them, distinguish empty from broken; absent sectors stay UNKNOWN not clear
    [config.h, esp32_obstacle_avoidance.ino, proximity_sensors.cpp]
2026-08-08 field test plan + tools/check_log.py (vibration gate analysis, throttle-filtered so ground samples cannot flatter the median)
    [check_log.py]
2026-08-08 field work over SiK: tools/bench.py (radio defaults, shared autopilot lock), longer ack timeout on slow links; log download must stay on USB/SD
    [pixhawk_full_setup.param]
2026-08-08 fix: push_params was re-enabling PRX1_TYPE=2 (arming dependency); comment it out in the param file, make ring checks opt-in, auto-resolve serial port+baud
    [pixhawk_full_setup.param]
2026-08-08 detect_worker --save-dir writes annotated detection frames (docs/07 evidence); field networking + phone-only limits recorded
2026-08-08 param file must assert PRX1_TYPE,0: commenting it out could not clear the 2 already on the board
    [pixhawk_full_setup.param]
2026-08-08 wiring_check false passes: RC keyed on receiver health bit (failsafe emits in-range values), GPS on driver-present bit, rangefinder on in-bounds reading
    [wiring_check.py]
2026-08-08 tools work on macOS: /dev/cu.* device detection (Linux-only globs found nothing on a Mac); Mac field-setup requirements recorded
2026-08-08 BLOCKER: all 6 motors spin the same direction; phase-wire fix, not software
2026-08-08 first flight logs analysed: Loiter climb was battery-failsafe RTL not EKF; vibration passes (7.5); ~105A hover draw is the real blocker
2026-08-08 only log 37 is a real flight; pre-37 numbers are the bad-prop era (thrust loss names motor 3)
2026-08-08 fix confirmed audit findings: check_log rewritten (per-IMU vibe, real Clip field, learned hover, exit codes), wiring_check/bench/push_params safety fixes
    [bench.py, check_log.py, wiring_check.py]
2026-08-09 user corrections: TF-Luna over water is a permanent no (descend-beside only), ring was disconnected for log 37, 3 motors reversed, stage-1 demo gate
    [pyvenv.cfg]
2026-08-10 field checklist + weekend video plan; fix TF-Luna false FAIL below min range; check_log reports burn rate and motor-running time
    [check_log.py, wiring_check.py]
2026-08-10 dropper: per-drop dose duration from estimated puddle area, gate travel reversed to 60deg CCW; dashboard shows dose; ./python + ./pip symlinks
    [camera_geom.py, detector.py, dropper.py, mission.py, missionlog.py]
2026-08-10 single venv at .venv (moved from training/.venv, 52 shebangs repaired); ./python and ./pip must be wrappers not symlinks; rng probe no longer claims the closed over-water bench
    [bench.py, check_log.py, wiring_check.py]
2026-08-10 untrack .venv-tools: a virtualenv must never be in git (1215 files, 74 MB)
    [pyvenv.cfg]
2026-08-10 wiggle reads gate pulses from dropper.py (was hard-coded 1900/1000, so the reversal did nothing); checklist updated
    [wiring_check.py]
2026-08-10 tools/flow_test.py: measure granule g/s across dwells, report gate opening lag
2026-08-10 check_log: read battery calibration from the log's own PARM, flag currents above the 3.3V input's saturation ceiling
    Log 37's 105 A hover / 167 A peak cannot come from BATT_AMP_PERVLT=17:
    (3.3 V - offset) * 17 = 56 A is the most the board can report. So the
    amps, consumed mAh and burn rate in that log are not physical.
    [check_log.py]
2026-08-10 log 37 flew with BATT_AMP_PERVLT=90.69, not 17: the amps were readable, my impossibility claim was wrong
    Rescaled by the documented 17.0 the flight becomes 20 A hover / 21 min
    endurance, which matches the independent momentum-theory estimate.
    Failsafes are voltage-driven (LOW_MAH=CRT_MAH=0) so PERVLT is safe to
    leave alone until the charger cross-check pins it down.
2026-08-10 field list rebuilt for the MacBook-only session; prop material decision recorded
2026-08-10 cut the tray and water: endurance-only session, detection is not set up
2026-08-10 the 4.5 min flight was cut short by the phantom mAh counter hitting BATT_CAPACITY, not by the pack
2026-08-10 pliers are a permanent field-kit line: motor nuts cannot be done by hand
2026-08-10 log 39: airframe PASSES with zero clipping; the current reading does not respond to BATT_AMP_PERVLT at all, so it is a sense-path fault not a calibration error
    Also removes the 3.3 V saturation check I added earlier today: it called
    log 39's 143 A impossible while the aircraft was flying. Guessed hardware
    constant, false alarm, gone.
    [check_log.py]
2026-08-10 current sensor solved: PERVLT should be ~24 not 90.69, and endurance is really 16.7 min at 28.8 A hover
    Retracts this afternoon's 'current does not respond to PERVLT' claim,
    which came from check_log taking the last PARM record instead of the one
    in force at motor start. Both flights flew at 90.6866. check_log now
    resolves parameters at motor-start time and flags later changes.
    Also surfaces that BATT_MONITOR was set to 0 after landing: no battery
    failsafe on the board at all until that is restored.
    [check_log.py]
2026-08-10 tools: one tool per area of expertise
    mavlink_link.py (new, library): port/baud, autopilot targeting, acks.
    Extracted from wiring_check.py, which four tools were importing just to
    open a serial port. wiring_check is 623 -> 490 lines and is a verdict only.
    parameters.py (new): get/set/push/pull/merge. Replaces push_params.py,
    pull_params.py, make_complete_params.py and bench.py's getparam/setparam.
    Three copies of write-and-verify became one; only one had checked for a
    silently clamped value.
    bench.py: probes only.
    Closes two audit items: pull no longer overwrites its own backup
    (timestamped dumps), and merge no longer truncates a fractional override
    to 0 when the dump types the param as a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
    [bench.py, dropper.py, flow_test.py, mavlink_link.py, parameters.py, wiring_check.py]
2026-08-10 parameters.py: BATT_MONITOR reboot note read as 'you set it to no sensing'; get now retries instead of blaming a typo for a dropped packet
    [parameters.py]
2026-08-10 HANDOVER: current-sensor thread closed, live thread is now the video and the unmeasured hardware
2026-08-10 battery monitor verified: 12.62 V, 0.14 A idle, no offset error; bench.py exits cleanly on Ctrl-C
    [bench.py]
2026-08-11 TODO 7: Serial1 loopback probe sketch, LED verdict, no extra parts needed
2026-08-11 D0/D1 already wired: probe is listen-only, loopback jumper retracted as a TX contention hazard
2026-08-11 TODO 7: probe answers from the Pixhawk end (heartbeat as comp 191) since the board is sealed in the airframe; bench.py nodes reads the verdict
    Also corrects the single-attempt framing: the user has 2-3 attempts on
    Saturday, a failure costs a pack recharge not the day.
    [bench.py, sketch_serial1_probe.ino]
2026-08-11 TODO-2 closed: camera confirmed working on the board (stale blocker for two weeks); find_pixhawk_uart.py may delete the whole sketch route
2026-08-11 board auto-sync service: ff-only, self-updating, never executes what it pulls
    Tested against a real bare repo: pulls cleanly, refuses to clobber a
    board-local commit, and exits 0 for systemd restart when it updates its
    own script.
2026-08-11 board sync installs without root: user-scope service + crontab fallback, since the board's sudo password is lost
2026-08-12 servo_jog.py: jog the gate by a chosen amount and direction, mark closed/open; the angle is derived from pulse width, never measured
2026-08-12 servo_jog: refuse nothing, warn instead; read SERVO9_MIN/MAX because a clamp would silently corrupt the calibration
2026-08-12 servo_jog: no limits, no warnings; drop the SERVO_MIN/MAX read and the sane-band check
2026-08-13 run_mission.py: gate pulses from dropper.py, not hard-coded 1000/1900
    Its 'closed' 1000us was the OPEN position after the reversal, so a mission
    would have emptied the hopper on the ground at servo init.
    [run_mission.py]
2026-08-13 board_setup.sh: root-free post-reflash rebuild with verification of every dependency
2026-08-13 track models/best.onnx: it is the deployed model, not a regenerable artifact
    It existed only on the laptop and a just-reflashed board, so it was one
    disk failure from unrecoverable, and it was the one file the board's
    auto-sync could never deliver.
2026-08-13 board_setup: a venv can exist with no pip (Debian strips ensurepip); bootstrap it instead of dying
2026-08-13 board_setup: use python -m pip (bin/pip console script may not exist) and resolve the repo path from the script's own location
2026-08-13 record: single battery means grounds are common by construction; stop raising it
2026-08-13 all five link params verified correct; board rebuild complete; GPS and RC are off and must return before flight
2026-08-13 find_pixhawk_uart: an unopenable port is not evidence of silence; report INCONCLUSIVE
    All four ttyS failed to configure, and the tool wrongly reported that as
    confirming the STM32 claim.
    [find_pixhawk_uart.py]
2026-08-13 record UNO Q toolchain: arduino:zephyr:unoq, network upload port, and why the compile is itself a test
2026-08-13 probe compiles: Serial1 exists on the Zephyr core; RouterBridge singletons link in automatically, so the runtime collision is still open
2026-08-13 esp32: diagnostic build on, to find which mux channels actually hold a live VL53L0X
2026-08-14 esp32: unpin upload port (it collided with the SiK radio) and drop to 115200 after 'chip stopped responding'
2026-08-14 gate pulses measured: 560us closed / 1760us open; esp32 --no-stub for the marginal cable
2026-08-14 esp32: 57600, bulk write still failing on this cable at 115200
2026-08-14 esp32: diag says all 6 ring channels hold a sensor (old map was wrong); up sensor not on the bus, flying build restored
    [config.h]
2026-08-14 esp32: up sensor power reconnected fixes ch6 AND ch1; ch2 is a dead chip (0/20 init at all four bus speeds)
    [config.h]
2026-08-14 state: ESP32 comp195 confirmed (TX/RX were swapped); Linux->Pixhawk is the last blocker, USB route identified
2026-08-14 farm venue + both laptops; route B: arduino-router daemon found, singleton fallback Serial1, core define check pending
2026-08-14 dropper: fix committed placeholder syntax error (560/1760), widen PWM guard 500-1800, SERVO9 MIN/MAX/TRIM + PRX1_TYPE=2 in param file
    [pixhawk_full_setup.param]
2026-08-14 shoot-day corrections: upload is ~a week out; batt mah failsafes + calibration pinned; pack list tickable; video script written; route B cleared
    [pixhawk_full_setup.param]
2026-08-14 byte-shovel: MCU sketch + router client + e2e test + UDP pump; protocol from arduino-router upstream; app_utils absent on reflash
2026-08-14 ring degrading sealed: AVOID_ENABLE 0 for the shoot (PRX stays for data); SiK saturation explains heartbeat counts; board repo path corrected
    [pixhawk_full_setup.param]
2026-08-14 LINK PROVEN: shovel e2e pass 36KB/0 dropped; test_mission_link written (ACK = TX proof); farm runbook + AVOID push moved to farm-first actions
    [test_mission_link.py]
2026-08-14 mission stack live both directions; make_waypoints.py (on-site serpentine, geometry verified); runbook 6b-6d; pump dropped-counter decoded
2026-08-15 full review outside tools/: fix GUIDED->AUTOTUNE mode-map bug, mission standdown race, dead board sync path, missing flask/msgpack, predict scoring, plus FOV calibration tool
    [benchmark_onnx.py, calibrate_camera.py, make_waypoints.py, mavlink_io.py, mission.py, predict.py, run_mission.py]
2026-08-15 docs: correct two stale references (link no longer blocked; conn is the pump)
    [dropper.py, run_mission.py]
2026-08-15 network v2: MR3020 is the field LAN (20dBm 2.4GHz, researched); WISP-repeat of iPhone preferred, standalone fallback with one off-camera laptop switch
2026-08-15 HFOV 56.2 measured: baked in as the default everywhere (no args needed); MavIO now heartbeats as comp 191 so bench nodes is honest; pump explains a port clash
2026-08-15 dashboard: flight control panel with two-step launch, pump/stop endpoints, /proc-based state; camera 0 default; fix arm-ignores-preconditions bug
    [detect_worker.py, detector.py, run_mission.py]
2026-08-15 fence: cylinder geofence enabled in the param file, with the audit showing no board process can touch it
    FENCE_ENABLE/TYPE 3 (alt+circle, deliberately not 7)/ACTION 1 RTL/ALT_MAX 30/
    RADIUS 100/MARGIN 2. Type 3 avoids the polygon bit, which needs an uploaded
    polygon or the prearm fails.
    Answering 'can the arduino override it': grepped every *_send( in uno_q/. The
    flight path can emit heartbeat, command_long (DO_SET_MODE, ARM_DISARM,
    NAV_TAKEOFF, DO_SET_SERVO, SET_MESSAGE_INTERVAL) and the two
    SET_POSITION_TARGET messages. No PARAM_SET, no DO_FENCE_ENABLE anywhere.
    On breach ArduPilot changes mode, mission.py sees mode != GUIDED and goes
    STANDDOWN, which is excluded from the end_mode branch,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
    [pixhawk_full_setup.param]
2026-08-15 state: farm run root cause was the camera preflight, not arming; logs 42-45 analysed (deliberate EStop drop in 42, repeatable compass mag-field failure in 43/45)
2026-08-15 state: camera failed at open() despite correct index and healthy enumeration; holder-process vs permissions are the live suspects
2026-08-15 state: board rebooted post-farm, camera healthy again but wedge cause unproven; logging design questions out
2026-08-15 automation deleted per new rule (sync units, board_sync, git-pull cron); farm camera root cause pinned to V4L2 index shuffle; USB pixhawk proven; night decisions recorded
2026-08-15 USB migration batch: shovel deleted, conn+camera auto-resolve, boardlog everywhere, photo pipeline, test_everything, dashboard rename with light mode + server layouts + test/photo panels, checklist r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
    [pixhawk_full_setup.param]
2026-08-16 luna on-ground rule restored in test_everything (my regression); ring self-heal firmware (maintain() re-init, compiled); dashboard photo browser panel + endpoints; werkzeug request spam silenced
2026-08-16 ESP32 final-flash batch: bus-wide I2C recovery, 30s health STATUSTEXT, RX drain, fake-mode build fixed; start_dashboard.sh one-command bring-up
    [config.h, esp32_obstacle_avoidance.ino, proximity_sensors.cpp, proximity_sensors.h]
2026-08-16 ESP32 15s+event health for final flash; voltage battery %; dashboard sat tiles + draggable route + selftest progress + photo panel merged into gallery
2026-08-16 Polygon geofence (drawn on the dashboard, pushed over the mission protocol), prearm visibility + Check arming, live self-test rendering, board-proxied satellite tiles, Wi-Fi settings panel, dashboard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
    [pixhawk_full_setup.param]
2026-08-16 Sat imagery: fix silent 64-tile skip (zoom-clamp) + live failure readout; one-line control rows; PROJECT_STATE: esptool facts + ESP32 enumeration diagnosis
2026-08-16 state: USB restored by cold boot; xhci never registered on the bad boot; ESP32-not-in-hub-at-boot rule
2026-08-16 state: third ESP32 silence on healthy bus with same cable; discriminator tests
2026-08-16 state: ESP32 flashed from the board; crystal warning explained as timing-measurement artifact, verification path
2026-08-16 Stale-tab detector (ui_mtime + RELOAD banner) after site-map false alarm; ring self-test reads ESP32 health broadcast; stop_dashboard.sh; Arm button rename
2026-08-16 ARM caps to match sibling buttons; diag_dashboard.sh (user-run board diagnostics); board-probe ban in CLAUDE.md
2026-08-16 Manual site anchor: empty board can now show imagery and draw a fence (root cause of the grey site map); ARM caps
2026-08-16 Pan at any zoom: typed-anchor views extend past the fitted frame, so base zoom must pan; zoom-out keeps the pan
2026-08-16 Fence drawing: 5 px click-vs-drag dead zone, frame frozen while editing; zoomed plain click adds corners
2026-08-16 Map: zoom out to 1/64 of the fit (was clamped at the fit itself)
2026-08-17 CLAUDE.md: give the user pull commands as bare one-liners; the ban is on chaining, not on mentioning
2026-08-17 State: board-side ground station proposal, three shapes and the serial-ownership constraint
2026-08-17 tools/esp32_mute.py: temporarily silence the obstacle ring so the SiK link is QGC's alone
2026-08-17 WP_SPD 3 m/s (4.7 name; board was at 10) and a compass field check in check_log.py
    [pixhawk_full_setup.param]
2026-08-17 State: i6X cells are NiMH, correct the reading of the voltages and the suspect list
2026-08-18 AVOID_ENABLE back to 7 (user: ring re-enabled after reflash + rewiring); state corrected
    [pixhawk_full_setup.param]
2026-08-18 motor/prop blocker closed by flight; retract the invented 'airframe has been apart' claim
2026-08-18 ring_channels.py: name dead/flaky ring channels from OBSTACLE_DISTANCE, no ESP32 USB needed
2026-08-18 board git store corrupted by power-cut; re-clone recipe and the stop-cutting-power rule
2026-08-18 ring_channels: report ch6 (up); ch2 is a fried disconnected sensor and the likely cause of ch1
2026-08-18 correction: ch2 is off the rail so it cannot cause ch1; shared 3V3 exonerated, ch1 is a local fault
2026-08-18 ring_channels: advice follows from the run's own evidence, not from a disproven shared-rail story
2026-08-19 WP_SPD 2: cruise capped at the ring's reaction ceiling (user decision, coupling rule honoured)
    [pixhawk_full_setup.param]
2026-08-19 Retract the ground-return theory (ring is horizontal); standing rule: ask clarifying questions every reply
2026-08-19 State: bench clutter explains the blind-sensor finding; fence accepted-then-empty; board params stale since 08-15
2026-08-19 Fence read-back of 0 was the cleared FENCE_TYPE polygon bit; 73/73 params on the board, reboot owed
2026-08-19 ring_channels: min-max range per channel, TELEM1 not TELEM2, bearings flagged as a firmware claim
2026-08-19 bench.py node labels current; state: ring healthy 4/6, blind-sensor finding withdrawn, routing hypothesis for the silence
2026-08-19 ch1 was never wired: ring is complete as built, blind arc 60-120 deg recorded
2026-08-19 State: dry run is board-side (dashboard backend has dry_run, no button); 0 g salt result triaged; coat ordering
2026-08-19 Dashboard: DRY RUN button (never arms, gate disabled), verified in the replica
2026-08-19 Fence read-back retries an empty answer; DRY RUN button always clickable and explains refusals
2026-08-20 Fence read-back: re-ask for MISSION_COUNT instead of hanging on the download budget; log the stage
2026-08-20 Dashboard fence push verifies on a fresh link, names its stage, and shows progress
2026-08-20 Per-sensor lidar check; survey routes now fill the geofence from a chosen start point
2026-08-20 Up sensor: 201 is the clear sentinel, not a distance (my bug); count clear runs
    [ring_channels.py]
2026-08-20 State: measured the board's saved route; rows 2-4 transits are anomalous
2026-08-20 Coverage: fly every piece of a concave fence, with each connecting leg checked
2026-08-20 State: board command wrappers; the arming half of the 50 cm test is still undone
2026-08-20 Arming: the No Data pair is a >500ms stream stall, not the clear sentinel (source-verified)
    [ring_channels.py]
2026-08-20 State: stream test needs no targets; board ~/python wrapper
2026-08-20 Survey now prints the message rate: 26% of ring packets are being lost
2026-08-20 Stall confirmed at 1.10s; heartbeat control separates ESP32/TELEM1 from the USB path
    [ring_channels.py]
2026-08-20 Root cause: dead-channel re-init blocks the ESP32 ~1s every 5s and stalls the ring stream
2026-08-21 ESP32: mark ch1 and ch2 unfitted so the dead-channel retry stops stalling the stream
    [config.h]
2026-08-21 ESP32 flashed from the Mac; why two channels had to be unfitted; ESP32 is on TELEM1 not TELEM2
2026-08-21 post-flash stall is ch6, not a failed fix: dead up sensor is still fitted so it inherits the retry
2026-08-21 ch1 is the fried one not ch2; arm-colour map with ch0 verified; ring went fully silent after the ch6 reseat
2026-08-21 ESP32 alive, no obstacle data: send has no health gate, so the bus-clear re-init is starving the loop
2026-08-21 ch6 root cause: high-resistance power joint (slow-rising 3.04V vs 3.22-3.24V), not a loose plug
2026-08-21 RNGFND2_TYPE 0 in the param file; ring_channels no longer blames the ESP32 when the ring is fine
    [pixhawk_full_setup.param]
2026-08-21 tilt was roll-I windup on the ground, not a bad motor; fence polygon is 62x55m and both spots parked near an edge
2026-08-22 gate travel 500/1600 after hole enlargement; SERVO9_TRIM follows closed
    [pixhawk_full_setup.param]
2026-08-22 note: repeated the board wrapper-path error the 08-20 entry exists to prevent
2026-08-22 flow_test: --cycles accumulation and --grain-mg counting; Bti dose table from label rates
2026-08-22 hopper flows at 3.13 g/s + 0.57 g slug; dose table was ignoring the intercept
2026-08-22 withdraw the slug finding: hopper was starving; flow_test now detects supply-limited runs
2026-08-22 level_cal.py: AHRS-trim level cal over USB, sidestepping the SiK bulk-param failure
    [level_cal.py]
2026-08-22 dry run passed at home: camera preflight ok, all prearm failures are home conditions
2026-08-22 Fix the six fundamental findings: NOARM, arrival timeouts, fence-gated detections, fix gate, tight cross, blind detector
    [detector.py, make_waypoints.py, mavlink_io.py, mission.py, run_mission.py]
2026-08-22 docs: rewrite the whole set shorter and fix nine stale facts
    Vibration is no longer the open blocker (VibeZ 7.4-9.0 vs the 15 gate), the
    v2 model numbers and the 489 ms board benchmark replace TBDs, the demo payload
    is mustard seed not salt, the ESP32 is on TELEM1 and the UNO Q on USB, the
    over-water descent question is decided, docs/04 now matches the one-take video
    rule, HANDOVER was months stale, and the submission date is 2026-08-23.
2026-08-22 docs: fix the block diagram, and the TF-Luna is on SERIAL4 not SERIAL5
    The diagram had the SiK and ESP32 on each other's telemetry ports, still showed
    the D0/D1 companion link as blocked, and still said salt. All corrected against
    the param file. Also corrects the wiring block in docs/01.
2026-08-22 Fix gate 1.4 HDOP / 10 sats (user-approved, tested 7/7); record the ring answer and the OA finding
    [mission.py]
2026-08-22 ring covers the survey now, plus a dose estimate and shorter docs
    GUID_OPTIONS bit 6 and OA_TYPE 1: guided position targets go through wp_nav so
    BendyRuler can bend the path around what the ring sees. Without both, only the
    descent was protected, because ArduCopter applies simple avoidance to velocity
    targets only. Untested, revert is OA_TYPE 0.
    Dose table added from the measured mustard-seed flow, flagged as a placeholder.
    Doc set cut from 8.9k to 7.7k words.
    [pixhawk_full_setup.param]
2026-08-22 SITL: both scenarios pass with the ring routed onto the survey rows
    Params confirmed at boot (OA_TYPE 1, GUID_OPTIONS 64), happy path drops once
    and completes, dropout drill aborts upward twice and still completes. SITL has
    no simulated obstacles, so this proves the routing change does not break
    navigation, not that avoidance fires. WP_SPD stays at 2.
2026-08-22 Diagnose the tilt from log 51: a left-side motor makes no thrust
    Outputs saturated at both rails in the correct direction and the aircraft still
    rolled left to inverted in 1.2s. Motor 3 (front-left) pinned first, motor 2
    second. Rules out tuning, levelling, CG and vibration.
2026-08-22 Root cause: one prop on the wrong-handed motor, not a motor or ESC fault
2026-08-22 State: SiK ground radio undetected after flash, and the level-cal double-count hazard
2026-08-22 tools/sik.py: SiK radio probe, factory reset and AIR_SPEED sweep
    The ground radio's CP2102 bridge still enumerates, so it is not bricked. A SiK
    firmware upgrade resets the radio's parameters to the new firmware's defaults,
    which is enough on its own to stop a healthy pair linking.
    Also record in CLAUDE.md that Pixhawk CLI work is a BOARD command.
    [sik.py]
2026-08-22 sik.py: leave the radio in data mode, and never hide a busy port
    Both bugs made a healthy radio look dead: probe left it in command mode so the
    next run's +++ got nothing, and quiet mode swallowed 'device busy'.
    Also: ARMING_CHECK does not exist on 4.7, it is ARMING_SKIPCHK with inverted
    meaning and default 0. That settles the QGC arming-checks screen.
    [sik.py]
2026-08-22 Found it: ECC 1 on the air radio, ECC 0 on the ground radio after the flash
    Passthrough read worked first try, so the air radio's parameters are reachable
    from the board with no adapter. NETID and frequencies matched all along.
2026-08-22 State: ECC is a match-not-a-value question, and flash the ground radio if anything
2026-08-22 sik.py: RTI5 needs time over an ECC link, and silence is not proof of a dead link
    The ground radio went solid green when ECC matched, while probe still claimed
    no link. Three attempts at 4s, and the verdict now defers to the LED.
2026-08-22 State: correct the invented timestamps, and read the LED asymmetry properly
    Solid one end and blinking the other means a one-way link, which rules out a
    settings mismatch and points at SiK 1.9 versus RFD SiK 2.0.
2026-08-22 State: the SiK link is up, and the 2.0 flash was the only thing that ever broke it
    Downgrade to 1.9 succeeded and RTI5 answered through the air link. 1.9
    factory defaults matched the air radio byte for byte, so the air end was
    never misconfigured. Version theory from the LED asymmetry confirmed.
2026-08-23 State: the fall was motor stop in flight, and why epoxy will never hold that mast
    Joint is loaded in bending, which puts a glued butt joint in peel, and the
    plastic is likely PP/PE which epoxy does not bond to. Fix is a screw through
    both walls. Flagged the cable-inside-the-tube and compass-orientation traps.
2026-08-23 State: mast break is a snapped moulding; strap the hinge body, skip the break
    Corrects the drill-and-pin advice, which assumed the wrong geometry. Records
    the rotation hazard a strapped compass mount introduces and why the ties must
    cross.
2026-08-23 State: bracket is metal and ties foul the props; the peel argument survives, the rest does not
    Grants the user's premise that epoxy bonds metal. Keeps the real cause: a butt
    joint loaded in bending. Records the sanded-back-to-bare-metal trap and the
    bound-wrap fix. Also records that three fixes in a row rested on unasked
    geometry questions.
2026-08-23 State: mastless GPS mount is viable; you need the standoff, not the stand
    The mast is for the compass, not the antenna. Field falls off steepest close
    in, so a few cm of foam or spacers recovers most of it. Mandatory compass
    recal, and the Loiter hover is the test. Records toilet bowling and the
    required reaction.
2026-08-23 State: GPS arrow need not match the Pixhawk arrow, verified from 4.7 source
    COMPASS_AUTO_ROT defaults to 2 (CheckAndFix) and corrects COMPASS_ORIENT for
    external compasses on a successful cal. Source shows 45 degree rotations need
    AUTO_ROT 3, so mount square. Fix is gated on the cal succeeding.
2026-08-23 State: why 30 degrees cannot auto-correct, read from CompassCalibrator
    Detection is a best-match search over a fixed rotation list, not an angle fit.
    Corrects my mechanism for the 45 degree case: a confidence threshold, not an
    exclusion. Records the silent 15-degree-error outcome and that COMPASS_ORIENT's
    doc string names the custom rotation params wrongly.
2026-08-23 State: accel cal already sets AHRS_TRIM; SiK thread closed; calibration round done
2026-08-23 Revert OA and simple avoidance: the ring reports phantom obstacles in daylight
    Log 55: BendyRuler active for the whole RTL with the commanded bearing jumping
    around the full circle every two seconds, because PRX reports 0.3-0.8 m returns
    at 8.6 m over an open field. Same phantoms behind the proximity prearm failures.
    [pixhawk_full_setup.param]
2026-08-23 tools/sik_config.py: read and set SiK radio params over AT, no memorised registers
    Also records the corrupt board repo and that the ground radio is failing at the
    USB layer rather than being misconfigured.
    [sik_config.py]
2026-08-23 State: the uncommanded climb is battery failsafe RTL; the pack is being flown flat
2026-08-23 State: 1781 mAh back in means the failsafes were sag, not depletion
2026-08-23 Battery failsafes: sag-compensated source, thresholds 10.5/10.0
    Log 59 shows the sag starts in level hover at 36 A, not in the RTL climb.
    Charger cross-check closes at 1630 logged vs 1781 returned, confirming
    BATT_AMP_PERVLT 24, so the mAh failsafe is now the trustworthy protection.
    [pixhawk_full_setup.param]
2026-08-23 Log 59: the RTL was Rsn=4 BATTERY_FAILSAFE, and the OA revert was in effect
2026-08-23 Servo chain: comments cut to short, impersonal one-liners
    [dropper.py, flow_test.py, servo_jog.py]
2026-08-23 docs/06: the ring reports but does not steer; params confirmed on the board
2026-08-23 VIDEO_SCRIPT: battery-failsafe recovery line
2026-08-23 VIDEO_SCRIPT: third camera operator, both builders in frame, no UNO Q explainer
2026-08-23 State: autonomous loop untested, battery is the binding constraint
2026-08-23 VIDEO_SCRIPT: dashboard launch path and the 8-second arm window
2026-08-23 VIDEO_SCRIPT: cut the pre-flight demo, detections shown live at 6:30
2026-08-23 State: board git corruption again; dry run is the pre-flight detection test
2026-08-23 Spacing derived from altitude for a stated frame overlap
2026-08-23 Survey at 5 m by default; stops on new ground, continuous imaging between
2026-08-23 Button defaults for the night attempt: conf 0.25, 2 s hold, 5 m
2026-08-23 Restore a mission log string a second agent pass had shortened
    [mission.py]
2026-08-23 Docs state 5 m; rangefinder passages reframed on the sensor's 8 m limit
2026-08-23 Circuit schematic, generated with an overflow and overlap self-check
2026-08-23 Schematic: names only, parallel power rail, labels beside the wires
2026-08-23 Drop the hand-generated circuit schematic; diagram moves to Claude design
2026-08-23 Record that both USB devices hang off the hub, the UNO Q has one USB-A port
2026-08-23 Name the product MonsoonReady Dragonfly, leaving board paths untouched
2026-08-24 Preflight audit: rotated camera geometry, 5 m survey, 12 verified fixes
    [camera_geom.py, detect_worker.py, detector.py, make_waypoints.py, mission.py, run_mission.py]
2026-08-24 Nine docs become one, and the field papers leave the repo
    The judged set was eight numbered files plus an index, cross-referencing each
    other and drifting apart. It is one docs/README.md now. The judge-Q&A format
    did not survive: its distinct answers moved into the sections they belong to
    and its duplication of the writeup went.
    Records that the first demo video surveyed at 15 m, where a half-metre puddle
    is 44 pixels and the model hits about one frame in ten, and that every flight
    since surveys at 5 m.
    FIELD_CHECKLIST and VIDEO_SCRIPT move to a gitignored field_ops/. They are
    rewritten the morning of every field day and were churning the judged set.
    Three stale claims found while checkin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
2026-08-24 Comments across uno_q and tools, rewritten for a reader
    37 files, comment and docstring text only. Telegraph notation becomes prose,
    ALL-CAPS emphasis and decorative rules go, voice is consistent within each
    subsystem. Only two comments were deleted outright; the rest of this codebase's
    comments already carried real history and that was kept and tightened.
    Proof it touched no code, rather than a promise: each file was parsed before
    and after, docstring nodes deleted from both trees, and the dumps compared.
    37 of 37 identical. Comments never enter the AST, so an identical dump means
    the same executable program. All 37 compile and test_camera_geom passes.
    Three stale comments fixed on the wa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
    [bench.py, bench_models.py, boardlog.py, calibrate_camera.py, camera.py, camera_geom.py, check_log.py]
2026-08-24 Full code-only audit of the whole repo: 73 verified findings
    Second audit today. The 12:20 pass covered the flight path; this one adds
    tools/, the ESP32 firmware, the frontend, training/ and the shell scripts.
    9 finder agents over 14,659 lines, then 4 adversarial verifiers told to
    default to refuted. 78 raw findings, 73 confirmed, 5 refuted.
    The worst one: MavIO.arm() cannot return False. command_ack() only returns
    True or raises, so mission.py's NOARM branch is dead code and a real arming
    refusal never reaches prearm_messages(), which is the one thing that would
    say why. Arming refusals are this project's most common field failure.
    Commit 25b0cb0 landed mid-audit and shifted line numbers;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
2026-08-24 Dose conflict: 0.4 predates every flow measurement
2026-08-24 Work through the 95-finding audit: ~70 fixed, each verified before and after
    [boardlog.py, calibrate_camera.py, camera_geom.py, check_log.py, detect_worker.py, detector.py, dropper.py]
2026-08-24 Speed is not the lever: the survey legs are acceleration-bound
2026-08-24 The photo hold is a wall clock; higher WP_ACC makes the waypoint frame worse
2026-08-24 Mission settings in the dashboard: alt, photo hold and conf on both launch buttons
2026-08-24 Raise the 50-waypoint cap; add photo-every spacing so rows can be flown without stopping
2026-08-24 Cap fix confirmed live on the board; note where the photo-every box lives
2026-08-24 Review the 74-waypoint route: right size, wrong place; traceback is pre-pull
2026-08-24 Align satellite imagery to the aircraft's GPS; move the drone dot at 1 Hz
2026-08-25 Log 78: it fell out of a stable hover on a pack with ~1800 mAh in it; 11 descents, 1 drop
2026-08-25 Correction: not terrain but a baro altitude reading 0.68m low on the ground; 7 descents not 11
2026-08-25 Gate fired twice today, both doses on a clamp; the pin is dead until arm
