doggylover314/monsoonready-drone/(notices)

Notices in the files:
PROJECT_STATE.md:
pesticide application under law this project holds no licence for
